Berkeley-AI-Risk/inference-only/formal/current-seeded-sampling/README.md

# Current scoped formal replay

This capsule is configured for the selected current image and retained source
scopes. Fresh scientific replay and its separate named completion registration
have completed with the scoped outcomes below.
`CURRENT-BINDING.json` records the source and image association at construction;
its replay and qualification flags remain false as construction provenance.

This lane preserves the original 35/57/63/94 component assertions, 196 connected
assertions with the same 37 private-output cuts, 15 Lean theorems, sensitivity
controls, model hashes, parameters, query constructors and runtime bounds.
Counts overlap. Verifying the 87 distributed files and selected image bytes
establishes provenance; it does not prove all 87 files, the mapped image or the
numerical backend. Production SHA compression arithmetic and private-bank/SHA
composition remain unproved.

## Closed current scientific results

The new primary run closed all 196 connected assertions. Its independent
secondary run passed the base and attempted all 196 conclusions, proving 194;
only CRC conclusions 38 and 73 remain unresolved. Both component solvers closed the 35/57/63/94 scopes.
The separate current page-bank run closed 42 assertions with both solvers,
real 32,768-bit RAM and arbitrary 258-bit SHA replies, plus ten directed
scenarios and five faulty controls. Fifteen abstract Lean theorems and the
original finite sensitivity controls also passed. These overlapping counts
are not a whole-machine total. No SHA compression arithmetic or private-bank
composition theorem follows.

The registered [CURRENT-REPLAY.json](CURRENT-REPLAY.json) has SHA-256
`c89177b13518209f0c8fb3ccde7db8c1d31dd39b875e1ba084650ed666806fcd`.
The completion and its status entry are separate from `CURRENT-BINDING.json`;
registration preserves that construction record and the source provider. It
records checked raw outcomes without rerunning solvers. The command examples
below reproduce the same-scope campaign, not a stronger theorem.

`recorded/RESULTS.json` and `recorded/PUBLIC-REPLAY.json` retain exact old0e6
bytes as historical model expectations. They are never current PASS records.
`historical/seeded-sampling/` preserves the exact original 31-file capsule source
census; runnable full historical context remains in the authenticated release
archive. The current replay does not require the old0e6 FS bytes.

Freeze the configured recipient's README, formal source inventory and package
manifest before the runs. Use a separate disposable copy of that exact clean
recipient, with new run directories. From its root:

    python3.12 -I -S -B formal/current-seeded-sampling/check_recorded.py
    python3.12 -I -S -B formal/current-seeded-sampling/test_replay.py
    python3.12 -I -S -B formal/current-seeded-sampling/replay.py --run formal/current-seeded-sampling/runs/NEW-combined --secondary --require-recorded-model
    python3.12 -I -S -B tools/check_current_seeded_page_bank.py --package . --work ../NEW-current-seeded-page-bank

The single combined replay includes the primary checks, both component solvers,
source/observer re-elaboration, Lean, negative controls and all 196 connected
secondary attempts with their existing bounded supplements. Do not add a separate
primary replay to this combined run. Original per-query timeouts, induction
depths and worker counts remain unchanged; there is no new overall campaign
wall timeout. `check_replay.py` independently validates the actual raw run.
Completion requires the secondary base check and all 196 attempts; only the
existing CRC conclusions 38 and 73 may remain unresolved. Unknowns remain
unresolved and are never counted as proofs.

The separate current-seeded page-bank wrapper runs its 42-property proof,
scenarios and audit; do not duplicate its child commands. It proves bank safety
with arbitrary 258-bit SHA replies. Production SHA is not elaborated in that
proof, and SHA arithmetic or private-bank/SHA composition is not established.
The original greedy page-bank replay remains unchanged. Keep the original clean
recipient and work-copy manifest unchanged through both runs and registration;
the page-bank evidence binds that exact input manifest.

The independently checked fresh outcomes are now registered in the clean
recipient: `CURRENT-REPLAY.json` records the same-scope results,
`CURRENT-STATUS.json` identifies that completion, and the package manifest's
separate `current_control_formal_replay` entry refers to it. These records do
not relabel historical PASS receipts or change the construction binding's false
flags. This command checks the registered completion without a solver replay:

    python3.12 -I -S -B formal/current-seeded-sampling/check_recorded.py --require-complete

These scoped replays do not establish whole-machine refinement, mapped-image
equivalence or hardware/browser qualification.
