Berkeley-AI-Risk/inference-only/demos/simplestories-v2-5m/formal/README.md

# SimpleStories RTL verification

The [formal-status guide](../FORMAL-STATUS.md) states the properties established
for the selected designs and their implementation boundaries.

The verification directories contain source-bound proof bundles and their
recorded queries, results and supporting sources. These recorded bundles retain
their original bytes, including path text in their source READMEs and receipts.
They do not supply additional runnable hardware designs.

Run the model-specific commands from `demos/simplestories-v2-5m/` in the
repository. For example, the registered seeded proof completion is checked with:

```sh
python3.12 -I -S -B formal/current-seeded-sampling/check_recorded.py --require-complete
```

The whole-repository integrity and common benchmark checks remain at the
repository root. New solver runs and hardware qualification are distinct from
replaying these recorded results.

The current [implementation-assurance checks](implementation-assurance/README.md) cover the boot/runtime handoff, fixed-length boot controller, QSPI reader, real FIFOs and transport, and the greedy public controllers. Their source-bound component results and remaining composition limits are stated together.

The [authentication/access package](authentication-access/README.md) verifies the
actual SHA engines, model checked-copy consumption, fixed private schedule and
operand/address paths, and separate protected K/V guard/cache and attention
capture/pin properties. The legitimate-record-to-consumption join remains open.
Recorded checks and fresh selected-query replay are separate commands.

The [protected-K/V CLEAR epoch package](kv-clear-epoch/README.md) proves the
native 64-bit epoch/reference relation and CLEAR sampling by unbounded induction,
including exhausted-counter fault behavior. Recorded validation and fresh
native/solver replay are separate modes. This closes one scalar dependency;
full tag/RAM/cache preservation and the joined attention consumer remain open.

The [working-memory/session package](session-isolation/README.md) adds native RAM
histories, current-writer ownership and connected model/K/V cancellation
barriers. It states the remaining device entry, numerical and token-publication
composition obligations; it does not claim complete device session isolation.

The [native component-value package](native-component-values/README.md) verifies
baseline RMSNorm invocation confinement and the production cache's component
value contract. The [composed model-read package](upstream-model-values/README.md)
discharges that cache contract's raw-reply premise through the actual custom
DDR transport, runtime wrappers, shared routing and model CDC. It includes a
readable theorem, explicit external boundaries and complete source/solver and
operating reproduction. The whole-device theorem remains open.

The [Q operand-provenance package](q-operand-provenance/README.md) connects the
baseline model words and current accepted activations to all 64 actual Q MAC
input pins, and current row metadata through tile storage to postscale
coefficient pins. Its [main SMT-LIB statement](q-operand-provenance/THEOREM.smt2)
and [readable theorem](q-operand-provenance/THEOREM.md) identify the precise scope.
The [complete Q operator package](q-operator/README.md) adds exact numerical Q
projection/normalization and actual Q write, exponent and completion behavior,
with checked common-trace composition. Its [readable theorem](q-operator/THEOREM.md)
states the interruption and implementation boundaries. Remaining consumers and
the whole-device theorem remain open.

The [baseline RMSNorm-to-Q segment](rms-q-segment/README.md) adds independent RMS
arithmetic, actual RMS workspace/Q capture, and retained query-RAM/readback
certificates to the complete Q result. Its [theorem and diagram](rms-q-segment/THEOREM.md)
state the stage-entry input boundary, constructive admission histories and
remaining whole-graph/implementation limits. The qualified source-bound package
has 554 new selected checks and clean portable reproduction.

The [recorded output-head row-12 replay](output-head-row12-recorded/README.md)
establishes that the 256 input words saved for output-head row 12 and the exponent
used by that row come from the same final normalization on the same STEP.
It assumes the machine follows the saved controller and connected hardware
design, with the same clocks, resets and fixed settings; the package states all
six assumptions. The exact frozen native profile is
`c07076ec5f5f4f27ca8208e502a0274b047552e5c356dc9bddaf03cd5b648b54`.
After provisioning its two pinned archives at `/proof` on Linux with CPython
3.12.12, run:

```sh
python3.12 -I -S -B /proof/replay.py
```

It checks 16 recorded native results and reconstructs 513 deductions. This is
recorded-result replay on that profile, not a proof of the public board image.

The [baseline selector WINNER proof](selector-winner/README.md) starts at an
actual accepted selector START and proves that a healthy WINNER is the least-ID
maximum of its 4,019 admitted rows, with exact row membership and output hold.
Row 0 seeds the incumbent, followed by 4,018 comparisons. Its one repository-root
command freshly recompiles the native theorem and a reached wrong-tie control.
The model-logit producer and parent STEP/start/WINNER/reply join remain open in
this replay.
