Berkeley-AI-Risk/inference-only/demos/simplestories-v2-5m/formal/seeded-sampling/README.md

# Seeded-sampling verification

Use the [RTL replay guide](../current-seeded-sampling/README.md) and the
[formal-status guide](../../FORMAL-STATUS.md) for the
supported source scopes, recorded results and limitations.
