Berkeley-AI-Risk/inference-only/ARCHITECTURE.md

# SimpleStories hardware

Read the [current simplestories hardware guide](demos/simplestories-v2-5m/HARDWARE.md).
