Berkeley-AI-Risk/inference-only/demos/simplestories-v2-5m/variants/home-authorization/HARDWARE.md

# Hardware and authorization boundary

The exact physical source is in [hardware/project](hardware/project), top `board1_home_auth_product_top`. The shared boot-root SHA engine handles model admission, LMS verification and nonce conditioning under private controller ownership. Update admission uses the existing 2-of-3 demonstration authority policy. Home permission uses a separate fixed public key. Neither threshold nor periodic authorization is part of the S-AWIC definition.

A request contains a domain tag, fixed device ID, fresh 256-bit nonce, admitted model commitment and fixed architecture geometry (128 bytes total). Home base returns that request plus a 1,292-byte LMS signature. The chip verifies the signature and exact device/nonce/model/geometry bindings before granting temporary permission. The host relays the messages and supplies no trusted permission or nonce signal.

The hardware period is 250,000,000 core cycles (nominally 10 seconds), with renewal 125,000,000 cycles before expiry and a 100,000,000-cycle response deadline. The deadline is anchored to challenge issue, rather than reply arrival. Valid renewal preserves the token context. Expiry or a fatal transport/signature/model fault closes runtime access, resets token inference and suppresses pending publication; a new session is required. A denied renewal can stop the session before the lease deadline.

Weight memory and model-authentication logic are distinct. Authentication admits the signed model and validates the weights. Current home permission enables inference and runtime memory access. Storing/admitting a package alone does not authorize running it. Replacement weights use the same [signed-update flash layout](../signed-update/tang/HARDWARE.md); the inference UART cannot rewrite them.

The inference clock is 25 MHz; board, DDR, application and trusted-reset logic use separate clock domains. The physical nonce candidate uses three neoTRNG inverter/latch rings, a 512-byte sample buffer, simple repeat/bias screens and SHA256 conditioning. Host bytes do not seed it. These checks do not establish a cryptographic entropy bound, robust freshness under physical attack, a trusted wall clock or a clone-resistant device identity.

## Nonce freshness

The [gate](hardware/project/home/home_boot_gate.sv) rejects a zero nonce and an immediate repeat within one hard-reset epoch. It remembers only the preceding nonce: a different nonce replaces that value, and the common core reset clears both `seen_nonce_q` and `previous_nonce_q`.

Forcing the same accepted 512-byte entropy sample through the [conditioner](hardware/project/home/nonce_frontend.sv) produces the same nonce. With the same device, admitted model and geometry, the complete request then repeats. An old valid signature can be accepted for that identical request after reset, or after a different nonce intervenes. The [digital unit comparison](VALIDATION.md#forced-sample-repetition) checks these cases with real LMS/SHA verification and a corrupted-signature control. It does not demonstrate physical sample repetition or a board bypass.

The repeat check and sample health screens do not supply persistent freshness state. Fresh unpredictable nonces remain an assumption needed for remote revocation; physical entropy qualification is outstanding.

## Timing qualification

The routed design reports a maximum of 25.002 MHz for the 25 MHz inference clock. Its whole-design summary reports 121 setup and 55 hold violating endpoints. The reset review traces one hold path through the entropy control logic and explains the remaining clock and DDR timing questions. Metastability MTBF, entropy qualification and physical tamper resistance remain open. [Startup reset and timing review](RESET-REVIEW.md)
