Berkeley-AI-Risk/inference-only/CURRENT-QUALIFICATION.md

# Seeded-sampling qualification

Read the [current seeded-sampling qualification guide](demos/simplestories-v2-5m/CURRENT-QUALIFICATION.md).
