Berkeley-AI-Risk/inference-only/ENCRYPTED-MEMORY.md

# K/V protection and encrypted external memory

`encrypted-memory` runs the same fixed SimpleStories-V2-5M approximation,
greedy decoding and three commands as the baseline and K/V-protected configurations.
It adds encryption for weights in external flash/DDR and for the external
attention cache (K/V). It retains before-use integrity checks and the model's
2,048-input-position limit. The inference clock is still 25 MHz.

The plaintext-memory versions check that the circuit uses allowed weights, but do
not hide external-memory contents. This version explores keeping weights
and intermediate cache contents confidential in external memory; a production
implementation would also need protected secret-key provisioning. The fixed-model
restriction still comes from the controller and immutable integrity checks,
not encryption. Published demonstration keys make this experiment reproducible
and recoverable without irreversible key programming.

**The supplied keys are public demonstration values, also embedded in the
RTL and FPGA configuration. This package does not keep its model or K/V
secret from someone who has those keys.** It demonstrates the implemented
encrypted-memory data path; it is not a production secret-provisioning scheme
or evidence of resistance to invasive attacks or side-channel analysis.
No irreversible key, OTP, fuse or security-lock programming is required.

## What changes, and what does not

| Configuration | External weights | External K/V | Before-use K/V integrity |
| --- | --- | --- | --- |
| Baseline | Plaintext; fixed-model digest check | Plaintext | No content check |
| K/V-protected | Plaintext; fixed-model digest check | Plaintext | Private expected SHA-256 digests |
| Encrypted-memory | AES-256-CTR ciphertext; fixed plaintext digests remain | AES-SIV ciphertext and tags | SIV check **and** private expected SHA-256 digests |

The plaintext model asset is unchanged. This third image
requires a **different flash image**; switching to it is not an SRAM-only
configuration change. The tokenizer and underlying integer model are unchanged.

The encrypted-memory circuit privately decrypts and verifies weights and cache data before the fixed model can use them. External memory carries ciphertext, while the host still sees only three token commands.

*The FPGA boundary is a circuit-ownership boundary, not a claim of physical
invulnerability. The two DDR regions share one physical memory. Keys in this
demonstration are public.*

### Weights

At startup, the circuit copies the fixed ciphertext image from flash into
DDR and verifies its full-image digest before allowing inference. During
inference, a four-bank private cache decrypts requested weight pages with
AES-256-CTR. SHA-256 checks the **same on-chip plaintext copy** against an
independent immutable digest; the arithmetic cannot use it until the full
page check succeeds. Decryption and hashing overlap, without another
whole-page buffer or an early permission to use unverified data.
AES and CTR follow [FIPS 197](https://csrc.nist.gov/pubs/fips/197/final)
and [SP 800-38A](https://csrc.nist.gov/pubs/sp/800/38/a/final).
The [design references](docs/REFERENCES.md#arithmetic-implementations-and-cryptographic-specifications)
also credit the directly adapted AES S-box circuit.

The private AES circuit retains all 14 AES-256 rounds and processes them in
five round-processing clocks per block (3 + 3 + 3 + 3 + 2 rounds). This does
not include request/response overhead. The four banks share two AES engines
and two SHA-256 engines, with private arbitration and explicit ownership of
each result. These are not reduced-round encryption or host-accessible
cryptographic accelerators. All 64 SHA-256 rounds are retained.

Four projection multiplier lanes time-share groups of up to 64 fixed output
rows, with 16 rows per lane and a separate accumulator for each row. The
per-row arithmetic order is unchanged. Packed fixed-metadata ROMs and private
block-RAM queues help fit the cache and checking circuits on this FPGA. These
are internal scheduling and storage choices, not additional user operations.

The fixed model image is 7,265,984 bytes. Each plaintext page is 4,096 bytes;
the last page contains 3,776 image bytes and 320 zero-padding bytes for the
digest. Those padding bytes are not additional ciphertext bytes in flash.
Small fixed coefficient/scale metadata also remain in on-chip ROM. Thus
“encrypted weights” does not mean every model-related constant is hidden.

The ciphertext digest and plaintext page digests serve different purposes.
Even knowing the published demonstration key does not provide a supported
way to change the permitted model: changing plaintext changes the immutable
page digest. This assumes the checking circuit and its trusted state remain
intact. There is no public key-upload, model-update or cryptography command.

### Attention cache

Internally produced K/V data are sealed before external writes. A read is
decrypted into private storage, its complete SIV tag is checked, and the
existing plaintext SHA-256 guard checks it against the current privately
recorded expected contents before attention receives it. A genuine old
record can have a valid SIV tag: the separate expected-digest mechanism is
still needed to reject stale contents, including after a repeated epoch.

The fixed record format uses AES-SIV as specified in
[RFC 5297](https://www.rfc-editor.org/rfc/rfc5297). It has separate 256-bit MAC
and counter-mode keys. Each K or V role has 130 plaintext bytes: 128 coordinate
bytes plus the two shared exponent bytes. Its external record is 160 bytes:
130 ciphertext bytes, a 16-byte tag, then 14 zero-padding bytes. Three
associated-data fields bind the domain, model identity and private
`epoch/layer/head/role/position/length` descriptor. This is a fixed inference
format, not a host-accessible encryption service. Two roles occupy ten
256-bit words per head, so the encrypted K/V region is larger than the
plaintext nine-word layout.

The SHA-256 guard groups 16 positions for verification. Its final group may
read the newest stored row even when attention obtains that row from the
private pending-row buffer. That read is expected; it does not bypass the
buffer or permit an unverified attention operand.

The guard pipelines its private RAM reads while assembling words for hashing
or returning already verified data. It reads the eight 32-bit chunks of a
256-bit word in nine clocks. This overlap does not release unverified data or
remove any digest check.

## Evidence and limits

The selected image measured **6.04 tokens/s** on the common one-token prompt
and two 128-output greedy trials, with all 256 IDs matching the fixed numerical
reference. The pooled 254-output rate uses validated-reply timestamps and
includes host control and inter-command gaps. Prompt processing and the first
output have separate recorded timings. See the
[common benchmark](docs/benchmarks/FPGA-SPEED-BENCHMARK.md).

The selected source/model/native/mapped records, ten-case CLI campaign and
seven-case browser campaign are described in
[greedy qualification](demos/simplestories-v2-5m/GREEDY-QUALIFICATION.md).
The campaigns include full-context operation, boundary rejection, CLEAR races,
Stop while a long STEP is pending and resumed generation. Full-array ciphertext
readback and plaintext restoration have separate guarded records.

The current image has 100 build inputs, including four separately acquired
vendor inputs. It completed native placement/routing, but its BUILD.json
retains `timing_qualified: false`. Functional qualification does not establish
complete vendor-DDR or external-I/O timing signoff.

Its attention source bridge rechecks 34 assertions through six byte-identical
isolated sources. It adds no assertions and does not prove the encrypted guard,
AES-SIV, numerical attention, concrete private-memory composition or the whole
machine. The AES component records apply only to the two byte-identical primitive
sources and retain their separate scope. [Formal status](demos/simplestories-v2-5m/FORMAL-STATUS.md) distinguishes
these results from universal arithmetic or cryptographic theorems.
The [capacity assessment](demos/simplestories-v2-5m/TRAINING-CAPACITY.md)
is explicitly bound to the plaintext baseline; encryption does not establish
a smaller residual training factor.

For a deployed confidential design, keys and configuration would need a
protected provisioning/storage path, with debug/configuration access and
physical/side-channel threats assessed separately. Authentication also
depends on intact private state. No such resistance is certified here.

## Reproduce and inspect the package

This variant ships its exact 96 redistributable inputs, the four pinned
vendor dependency identities, and the selected prebuilt image. No vendor
primitive simulation-library sources are bundled. The existing vendor
download/build instructions and license boundaries still apply.

From the root of a clean checkout or release archive:

The first command uses `--strict` to check all listed files and reject any
extras, including local Python environments and generated build files.
If you have already used this checkout, omit `--strict` to verify the listed
files while allowing those extras; do not delete your local files just to
run the check. See [release checks](demos/simplestories-v2-5m/REPRODUCE.md).

```sh
python3.12 -I -S -B tools/verify_release.py --strict
python3.12 -I -B tools/check_current_three_greedy_v15_v4.py --package . --stage current --index evidence/current-greedy/INDEX.json
python3.12 -I -S -B tools/check_encrypted_inherited_components_v1.py
python3.12 -I -S -B tools/encrypt_model_image.py --openssl /absolute/path/to/openssl
```

The final command independently reproduces every ciphertext byte with
OpenSSL and decrypts it back to the exact supplied plaintext model. It is
offline, uses only public test constants, and never accesses a board. Add
`--output /fresh/path/model.bin` to save the reproduced ciphertext; existing
files are refused. The unchanged [model reconstruction](demos/simplestories-v2-5m/REPRODUCE.md)
produces the plaintext starting point.

Source locations:

- `variants/encrypted-memory/hardware/`: exact build inputs, including the
  original project, ROM data and constraints.
- `host-app/hardware-inputs-encrypted-memory.json`: all 100 input hashes.
- `variants/encrypted-memory/PUBLIC-TEST-KEYS.json`: published demonstration keys and nonce.
- `prebuilt/encrypted-memory/BUILD.json`: source/image build association,
  with `timing_qualified: false`.
- `prebuilt/encrypted-memory/project/impl/pnr/shared_product.fs`: selected SRAM configuration.
- `assets/board1-encrypted-model2048.bin`: exact ciphertext flash payload.

For a local rebuild, follow [the existing vendor setup](VENDOR-SETUP.md#check-then-build)
with `--variant encrypted-memory`. The same pinned macOS GOWIN executable and
four separately obtained IP files are required. Preflight checks the exact
100 inputs; it does not run the vendor tool or access hardware. A fresh build
must be assessed on its own results, not assumed to reproduce the selected
placement or to improve the remaining timing violations.

## Install or restore

Use only the exact supported board, flash and programmer versions in
[PROGRAMMING.md](PROGRAMMING.md). Read that entire guide first, including
restoration. **These instructions erase flash.** Preserve two separately
read, equal, complete 16-MiB backups and their receipts before writing; keep
them outside the repository. Stop the app and other UART/JTAG users.
Do not proceed on any ID mismatch, tool error or protection warning.

Follow sections 1 and 2 of that guide unchanged. With its checked shell
variables, replace section 3's plaintext installation with:

```sh
"$FPGA_PROGRAMMER" --device GW5AST-138C --cable-index 4 --location "$FPGA_USB_LOCATION" --frequency 0.9MHz --operation_index 52
"$FPGA_PROGRAMMER" --device GW5AST-138C --cable-index 4 --location "$FPGA_USB_LOCATION" --frequency 0.9MHz --operation_index 56 --mcuFile "$FPGA_PACKAGE/assets/board1-encrypted-model2048.bin" --spiaddr 0x801000
```

The example cable index must be replaced if your checked scan reports a
different one. Require the exact success/target/operation checks in the
original guide, one command at a time. Then reload its read-only maintenance
image and capture a **fresh full-array read** as in section 4. Use a new
output filename and this ciphertext-specific file checker:

```sh
python3.12 -I -S -B tools/check_encrypted_flash.py --readback "$FPGA_RECOVERY/encrypted-readback.bin"
```

Require full-array hash
`779fc1a8a0158ce66e7dc52ac4662259f5618f01303d3299eb990b2f361d2ef1`.
Only `[0x801000, 0xEEEEC0)` contains the ciphertext image; all other bytes
must be `FF`. A programmer's own verification alone does not replace this
independent read. The checker verifies a file, not its physical provenance.

After a successful readback, use section 5's SRAM operation with
`--fsFile "$FPGA_PACKAGE/prebuilt/encrypted-memory/project/impl/pnr/shared_product.fs"`.
Keep power on, allow at least 120 seconds for boot, and run the host guide's
known-answer qualification with `prebuilt/encrypted-memory/BUILD.json`.
Use its explicit exploratory-timing acknowledgement. Requalify after every
power cycle/reload. The browser does not install, select or switch hardware.

The browser supports 2,048 prompt tokens, 128 generated tokens and 2,049
combined tokens, within 32,768 input characters. A full-context first STEP can
take many minutes. Stop drains an already active STEP before clearing the tape;
it cannot interrupt that hardware command. A timeout does not prove a command
was not accepted: investigate rather than repeating it blindly. See the
[host guide](host-app/README.md) for command deadlines and connection ownership.

To return to a plaintext-memory configuration, **restore the matching plaintext
flash image as well as its SRAM image**. Section 6 restores your own verified
full backup and independently compares every byte. If that backup predates
model installation, it restores the factory contents instead: use the
original model-install/readback workflow before loading its matching
inference image. Never use another person's flash backup. Keep all recovery
files private; do not use OTP, fuse, key-lock or unrelated flash-mode options.
