Berkeley-AI-Risk/inference-only/FORMAL-STATUS.md

# Scoped RTL verification

Read the [current scoped rtl verification guide](demos/simplestories-v2-5m/FORMAL-STATUS.md).
