Berkeley-AI-Risk/inference-only/KV-PROTECTION.md

# K/V integrity protection

Read the [current k/v integrity protection guide](demos/simplestories-v2-5m/KV-PROTECTION.md).
