Berkeley-AI-Risk/inference-only/REPRODUCE.md

# Reproduce SimpleStories assets and evidence

Read the [current reproduce simplestories assets and evidence guide](demos/simplestories-v2-5m/REPRODUCE.md).
