Berkeley-AI-Risk/inference-only/STOCHASTIC-GENERATION.md

# Seeded SimpleStories generation

Read the [current seeded simplestories generation guide](demos/simplestories-v2-5m/STOCHASTIC-GENERATION.md).
