Berkeley-AI-Risk/inference-only/variants/seeded-sampling/QUALIFICATION.md

# Seeded-sampling qualification

The supplied image is `d271626a7fb9ce1debdf7a9cd847125ec7eb4c907fa9d06af9d5f8146cecc725`.
[Current qualification](../../demos/simplestories-v2-5m/CURRENT-QUALIFICATION.md) identifies its model, seven-suite board campaign, context matrix, readback/registration and browser results.

[Formal status](../../demos/simplestories-v2-5m/FORMAL-STATUS.md) describes the scoped RTL results and unresolved secondary conclusions. [Seeded generation](../../demos/simplestories-v2-5m/STOCHASTIC-GENERATION.md) gives settings, loading and web-interface instructions. These records do not establish complete timing, whole-machine numerical refinement or physical-security certification.
