Berkeley-AI-Risk/inference-only/demos/simplestories-v2-5m/demos/simplestories-v2-5m/FORMAL-STATUS.md

# SimpleStories formal status

See the [formal-status guide](../../FORMAL-STATUS.md) for the current scope and results.
