Berkeley-AI-Risk/inference-only/demos/simplestories-v2-5m/formal/q-operator/F1-COMMON-TRACE-REVIEW.md

# Independent common-trace review

Reviewed 2026-11-05 by `fresh_q_main_audit`, a reviewer originally started
without conversation history. This follow-up was read-only: no edits, engines
or compilers were run by the reviewer.

The reviewer finds F1 addressed within the stated source/frontend boundary and
finds no concrete remaining soundness gap in this scoped construction.

The reviewed checker connects common-reset bases, the first-step empty-capture
bootstrap, the regular joint induction with a retained predecessor, raw
value/order/DONE, normalized writes/exponent/completion/CLEAR, and the first
fault/numeric-rejection consequences. Every endpoint premise is closed. The
seven strong old trace interfaces and all four model/memory boundaries remain.

The source lift requires full actual parent transitions, exact source bodies,
ports, parameters and getter sorts; no local native conclusion is strengthened
into a parent transition. Declared-constant substitutions refuse binders, and
one rigid watched-row/lane family is retained along the trace. The reviewer
found no unjustified numerical addition, ordinary-step invariant cycle, extra
reset, or use of pre-reset arithmetic invariants in the bootstrap.

The final saved review inspected `TRACE-CLOSURE.json`: its reset, bootstrap,
regular and endpoint applications have no unclosed premises; all six logical
controls reject. The original native-theory typecheck is correctly marked
`no_check_sat` and is not counted as an engine proof. The concrete stronger
nonzero compatibility query has a SAT receipt and makes no reachability claim.

This review addresses the common-trace argument. Full operator qualification,
portable reproduction and publication remain separate decisions.
