Berkeley-AI-Risk/inference-only/demos/simplestories-v2-5m/formal/q-operator/FINAL-PACKAGING-REVIEW.md

# Independent release review

A separate agent, originally given no conversation history, performed a read-only
review of the source-bound Q argument and its portable release. No engines,
compilers or edits were run by this reviewer.

The final review found no remaining soundness or packaging blocker. It checked
candidate r4's archive/evidence links, all 329 new and 449 operand canonical and
actual engine-query hashes and raw replies, all 17 fresh receipts, seven identical
native recompilations, and saved original-theory type evidence. The recorded-only
replay also passed, with zero fresh solver queries and complete trace closure.

The public replay must distinguish 326 UNSAT implications and three SAT controls
from the 17 selected fresh engine runs and the reconstructed existing dependency
receipts. Portable default execution validates saved simulation records; it does
not rerun simulations. Thirteen connected finite cases regenerate source, bench
and independent mathematical expected data during local qualification. The two
normalizer aggregate records validate native source, bench/log hashes and their
case/edge scope. The normalizer also has its separate symbolic proof.

The theorem's exclusions—whole device, timing/fault authorization, retained query
RAM and physical DSP/bitstream equivalence—remain explicit. The reviewer accepted
the common-reset, bootstrap, regular induction and all raw, normalized and
rejection endpoint applications. The detailed common-trace review is in
F1-COMMON-TRACE-REVIEW.md.
