Berkeley-AI-Risk/inference-only/demos/qwen3-1.7b/hardware/implementation/parallel-reset-chains.tsv

stem | stages | constant_one_reset_shift_structure | reasons | clock | clear_net
fixed_hbm_reset/axi_release | 3 | 1 |  | clk_out1_clk_mmcm_hbm | fixed_hbm_reset/axi_release[2]_i_1_n_0
fixed_hbm_reset/axi_reset_state_sync | 3 | 0 | stage0_not_FDCE,stage1_not_FDCE,stage2_not_FDCE
fixed_hbm_reset/axi_settle_sync | 3 | 0 | first_D_not_constant_one | clk_main_a0 | fixed_hbm_reset/axi_release[2]_i_1_n_0
fixed_hbm_reset/configuration_release | 3 | 1 |  | clk_main_a0 | fixed_hbm_reset/configuration_release[2]_i_1_n_0
fixed_hbm_reset/flr_memory_start | 3 | 1 |  | clk_out1_clk_mmcm_hbm | fixed_hbm_reset/flr_memory_start[2]_i_1_n_0
fixed_hbm_reset/flr_memory_sync | 3 | 0 | first_D_not_constant_one | clk_main_a0 | fixed_hbm_reset/flr_reset_done_i_2_n_0
fixed_hbm_reset/flr_reference_start | 3 | 1 |  | clk_hbm_ref | fixed_hbm_reset/flr_memory_start[2]_i_1_n_0
fixed_hbm_reset/flr_reference_sync | 3 | 0 | first_D_not_constant_one | clk_main_a0 | fixed_hbm_reset/flr_reset_done_i_2_n_0
fixed_hbm_reset/memory_done_sync | 3 | 0 | first_D_not_constant_one | clk_main_a0 | fixed_hbm_reset/controller_released_i_2_n_0
fixed_hbm_reset/memory_start | 3 | 1 |  | clk_out1_clk_mmcm_hbm | fixed_hbm_reset/reference_start[2]_i_1_n_0
fixed_hbm_reset/reference_done_sync | 3 | 0 | first_D_not_constant_one | clk_main_a0 | fixed_hbm_reset/controller_released_i_2_n_0
fixed_hbm_reset/reference_start | 3 | 1 |  | clk_hbm_ref | fixed_hbm_reset/reference_start[2]_i_1_n_0
fixed_machine/lifecycle/core_ack_sync | 3 | 0 | first_D_not_constant_one | clk_main_a0 | fixed_machine/lifecycle/flr_done_i_2_n_0
fixed_machine/lifecycle/core_reset_edges | 8 | 1 |  | clk_out1_clk_mmcm_a | fixed_machine/lifecycle/flr_shell_release[2]_i_1_n_0
fixed_machine/lifecycle/core_reset_sync | 3 | 0 | first_D_not_constant_one | clk_main_a0 | fixed_machine/lifecycle/failed_i_2_n_0
fixed_machine/lifecycle/flr_shell_release | 3 | 1 |  | clk_main_a0 | fixed_machine/lifecycle/flr_shell_release[2]_i_1_n_0
fixed_machine/lifecycle/hbm_memory_release | 3 | 1 |  | clk_out1_clk_mmcm_hbm | fixed_machine/lifecycle/hbm_memory_release[2]_i_1_n_0
fixed_machine/lifecycle/host_release | 3 | 1 |  | clk_main_a0 | fixed_machine/lifecycle/host_release[2]_i_1_n_0
fixed_machine/lifecycle/memory_ack_sync | 3 | 0 | first_D_not_constant_one | clk_main_a0 | fixed_machine/lifecycle/flr_done_i_2_n_0
fixed_machine/lifecycle/memory_release_sync | 3 | 0 | first_D_not_constant_one | clk_main_a0 | fixed_machine/lifecycle/failed_i_2_n_0
fixed_machine/lifecycle/memory_reset_edges | 8 | 1 |  | clk_out1_clk_mmcm_hbm | fixed_machine/lifecycle/flr_shell_release[2]_i_1_n_0
fixed_machine/lifecycle/memory_reset_sync | 3 | 0 | first_D_not_constant_one | clk_main_a0 | fixed_machine/lifecycle/failed_i_2_n_0
fixed_machine/lifecycle/monitor0_sync | 3 | 0 | first_D_not_constant_one | clk_main_a0 | fixed_machine/lifecycle/failed_i_2_n_0
fixed_machine/lifecycle/monitor1_sync | 3 | 0 | first_D_not_constant_one | clk_main_a0 | fixed_machine/lifecycle/failed_i_2_n_0
fixed_machine/lifecycle/reference_reset_sync | 3 | 0 | first_D_not_constant_one | clk_main_a0 | fixed_machine/lifecycle/failed_i_2_n_0
fixed_machine/machine/application/host_control/error_sync | 3 | 0 | first_D_not_constant_one | clk_main_a0 | fixed_machine/machine/application/host_control/ready_sync[2]_i_1_n_0
fixed_machine/machine/application/host_control/loading_sync | 3 | 0 | first_D_not_constant_one | clk_main_a0 | fixed_machine/machine/application/host_control/ready_sync[2]_i_1_n_0
fixed_machine/machine/application/host_control/ready_sync | 3 | 0 | first_D_not_constant_one | clk_main_a0 | fixed_machine/machine/application/host_control/ready_sync[2]_i_1_n_0
fixed_machine/machine/application/host_control/shell_reset_release | 3 | 1 |  | clk_main_a0 | fixed_machine/machine/application/host_control/shell_reset_release[2]_i_1_n_0
fixed_machine/machine/application/host_control/status_core_reset_release | 3 | 1 |  | clk_out1_clk_mmcm_a | fixed_machine/machine/application/host_control/shell_reset_release[2]_i_1_n_0
fixed_machine/machine/application/host_control/crossing/core_reset_release | 3 | 1 |  | clk_out1_clk_mmcm_a | fixed_machine/machine/application/host_control/crossing/core_reset_release[2]_i_1_n_0
fixed_machine/machine/application/host_control/crossing/commands/destination_reset_release | 3 | 1 |  | clk_out1_clk_mmcm_a | fixed_machine/machine/application/host_control/crossing/commands/source_reset_release[2]_i_1_n_0
fixed_machine/machine/application/host_control/crossing/commands/read_gray_source_1 | 3 | 0 | first_D_not_constant_one,stage0_early_fanout,stage1_early_fanout,stage1_not_direct_shift,stage2_not_direct_shift | clk_main_a0 | fixed_machine/machine/application/host_control/crossing/commands/write_gray[2]_i_2_n_0
fixed_machine/machine/application/host_control/crossing/commands/read_gray_source_2 | 3 | 0 | first_D_not_constant_one,stage0_early_fanout,stage1_early_fanout,stage1_not_direct_shift,stage2_not_direct_shift | clk_main_a0 | fixed_machine/machine/application/host_control/crossing/commands/write_gray[2]_i_2_n_0
fixed_machine/machine/application/host_control/crossing/commands/read_gray_source_3 | 3 | 0 | first_D_not_constant_one,stage0_early_fanout,stage1_early_fanout,stage1_not_direct_shift,stage2_not_direct_shift | clk_main_a0 | fixed_machine/machine/application/host_control/crossing/commands/write_gray[2]_i_2_n_0
fixed_machine/machine/application/host_control/crossing/commands/source_reset_release | 3 | 1 |  | clk_main_a0 | fixed_machine/machine/application/host_control/crossing/commands/source_reset_release[2]_i_1_n_0
fixed_machine/machine/application/host_control/crossing/commands/write_gray_destination_1 | 3 | 0 | first_D_not_constant_one,stage0_early_fanout,stage1_early_fanout,stage1_not_direct_shift,stage2_not_direct_shift | clk_out1_clk_mmcm_a | fixed_machine/machine/application/host_control/crossing/commands/write_gray_destination_1[2]_i_1_n_0
fixed_machine/machine/application/host_control/crossing/commands/write_gray_destination_2 | 3 | 0 | first_D_not_constant_one,stage0_early_fanout,stage1_early_fanout,stage1_not_direct_shift,stage2_not_direct_shift | clk_out1_clk_mmcm_a | fixed_machine/machine/application/host_control/crossing/commands/write_gray_destination_1[2]_i_1_n_0
fixed_machine/machine/application/host_control/crossing/commands/write_gray_destination_3 | 3 | 0 | first_D_not_constant_one,stage0_early_fanout,stage1_early_fanout,stage1_not_direct_shift,stage2_not_direct_shift | clk_out1_clk_mmcm_a | fixed_machine/machine/application/host_control/crossing/commands/write_gray_destination_1[2]_i_1_n_0
fixed_machine/machine/application/host_control/crossing/results/destination_reset_release | 3 | 1 |  | clk_main_a0 | fixed_machine/machine/application/host_control/crossing/results/source_reset_release[2]_i_1_n_0
fixed_machine/machine/application/host_control/crossing/results/read_gray_source_1 | 3 | 0 | first_D_not_constant_one,stage0_early_fanout,stage1_early_fanout,stage1_not_direct_shift,stage2_not_direct_shift | clk_out1_clk_mmcm_a | fixed_machine/machine/application/host_control/crossing/results/write_gray[2]_i_2_n_0
fixed_machine/machine/application/host_control/crossing/results/read_gray_source_2 | 3 | 0 | first_D_not_constant_one,stage0_early_fanout,stage1_early_fanout,stage1_not_direct_shift,stage2_not_direct_shift | clk_out1_clk_mmcm_a | fixed_machine/machine/application/host_control/crossing/results/write_gray[2]_i_2_n_0
fixed_machine/machine/application/host_control/crossing/results/read_gray_source_3 | 3 | 0 | first_D_not_constant_one,stage0_early_fanout,stage1_early_fanout,stage1_not_direct_shift,stage2_not_direct_shift | clk_out1_clk_mmcm_a | fixed_machine/machine/application/host_control/crossing/results/write_gray[2]_i_2_n_0
fixed_machine/machine/application/host_control/crossing/results/source_reset_release | 3 | 1 |  | clk_out1_clk_mmcm_a | fixed_machine/machine/application/host_control/crossing/results/source_reset_release[2]_i_1_n_0
fixed_machine/machine/application/host_control/crossing/results/write_gray_destination_1 | 3 | 0 | first_D_not_constant_one,stage0_early_fanout,stage1_early_fanout,stage1_not_direct_shift,stage2_not_direct_shift | clk_main_a0 | fixed_machine/machine/application/host_control/crossing/results/write_gray_destination_1[2]_i_1_n_0
fixed_machine/machine/application/host_control/crossing/results/write_gray_destination_2 | 3 | 0 | first_D_not_constant_one,stage0_early_fanout,stage1_early_fanout,stage1_not_direct_shift,stage2_not_direct_shift | clk_main_a0 | fixed_machine/machine/application/host_control/crossing/results/write_gray_destination_1[2]_i_1_n_0
fixed_machine/machine/application/host_control/crossing/results/write_gray_destination_3 | 3 | 0 | first_D_not_constant_one,stage0_early_fanout,stage1_early_fanout,stage1_not_direct_shift,stage2_not_direct_shift | clk_main_a0 | fixed_machine/machine/application/host_control/crossing/results/write_gray_destination_1[2]_i_1_n_0
fixed_machine/machine/application/inference/core_reset_release | 3 | 1 |  | clk_out1_clk_mmcm_a | fixed_machine/machine/application/inference/core_reset_release[2]_i_1_n_0
fixed_machine/machine/application/inference/kv_transport/read_crossing/core_reset_release | 3 | 1 |  | clk_out1_clk_mmcm_a | fixed_machine/machine/application/inference/kv_transport/read_crossing/core_reset_release[2]_i_1_n_0
fixed_machine/machine/application/inference/kv_transport/read_crossing/memory_error_core | 3 | 0 | first_D_not_constant_one | clk_out1_clk_mmcm_a | fixed_machine/machine/application/inference/kv_transport/read_crossing/memory_error_core[2]_i_1_n_0
fixed_machine/machine/application/inference/kv_transport/read_crossing/memory_reset_release | 3 | 1 |  | clk_out1_clk_mmcm_hbm | fixed_machine/machine/application/inference/kv_transport/read_crossing/core_reset_release[2]_i_1_n_0
fixed_machine/machine/application/inference/kv_transport/read_crossing/forward_stream/destination_reset_release | 3 | 1 |  | clk_out1_clk_mmcm_hbm | fixed_machine/machine/application/inference/kv_transport/read_crossing/forward_stream/source_reset_release[2]_i_1_n_0
fixed_machine/machine/application/inference/kv_transport/read_crossing/forward_stream/read_gray_source_1 | 7 | 0 | first_D_not_constant_one,stage0_early_fanout,stage1_early_fanout,stage1_not_direct_shift,stage2_early_fanout,stage2_not_direct_shift,stage3_early_fanout,stage3_not_direct_shift,stage4_early_fanout,stage4_not_direct_shift,stage5_early_fanout,stage5_not_direct_shift,stage6_not_direct_shift | clk_out1_clk_mmcm_a | fixed_machine/machine/application/inference/kv_transport/read_crossing/forward_stream/write_gray[6]_i_2_n_0
fixed_machine/machine/application/inference/kv_transport/read_crossing/forward_stream/read_gray_source_2 | 7 | 0 | first_D_not_constant_one,stage0_early_fanout,stage1_early_fanout,stage1_not_direct_shift,stage2_early_fanout,stage2_not_direct_shift,stage3_early_fanout,stage3_not_direct_shift,stage4_early_fanout,stage4_not_direct_shift,stage5_early_fanout,stage5_not_direct_shift,stage6_not_direct_shift | clk_out1_clk_mmcm_a | fixed_machine/machine/application/inference/kv_transport/read_crossing/forward_stream/write_gray[6]_i_2_n_0
fixed_machine/machine/application/inference/kv_transport/read_crossing/forward_stream/read_gray_source_3 | 7 | 0 | first_D_not_constant_one,stage0_early_fanout,stage1_early_fanout,stage1_not_direct_shift,stage2_early_fanout,stage2_not_direct_shift,stage3_early_fanout,stage3_not_direct_shift,stage4_early_fanout,stage4_not_direct_shift,stage5_early_fanout,stage5_not_direct_shift,stage6_not_direct_shift | clk_out1_clk_mmcm_a | fixed_machine/machine/application/inference/kv_transport/read_crossing/forward_stream/write_gray[6]_i_2_n_0
fixed_machine/machine/application/inference/kv_transport/read_crossing/forward_stream/source_reset_release | 3 | 1 |  | clk_out1_clk_mmcm_a | fixed_machine/machine/application/inference/kv_transport/read_crossing/forward_stream/source_reset_release[2]_i_1_n_0
fixed_machine/machine/application/inference/kv_transport/read_crossing/forward_stream/write_gray_destination_1 | 7 | 0 | first_D_not_constant_one,stage0_early_fanout,stage1_early_fanout,stage1_not_direct_shift,stage2_early_fanout,stage2_not_direct_shift,stage3_early_fanout,stage3_not_direct_shift,stage4_early_fanout,stage4_not_direct_shift,stage5_early_fanout,stage5_not_direct_shift,stage6_not_direct_shift | clk_out1_clk_mmcm_hbm | fixed_machine/machine/application/inference/kv_transport/read_crossing/forward_stream/read_binary_rep[5]_i_2_n_0
fixed_machine/machine/application/inference/kv_transport/read_crossing/forward_stream/write_gray_destination_2 | 7 | 0 | first_D_not_constant_one,stage0_early_fanout,stage1_early_fanout,stage1_not_direct_shift,stage2_early_fanout,stage2_not_direct_shift,stage3_early_fanout,stage3_not_direct_shift,stage4_early_fanout,stage4_not_direct_shift,stage5_early_fanout,stage5_not_direct_shift,stage6_not_direct_shift | clk_out1_clk_mmcm_hbm | fixed_machine/machine/application/inference/kv_transport/read_crossing/forward_stream/read_binary_rep[5]_i_2_n_0
fixed_machine/machine/application/inference/kv_transport/read_crossing/forward_stream/write_gray_destination_3 | 7 | 0 | first_D_not_constant_one,stage0_early_fanout,stage1_early_fanout,stage1_not_direct_shift,stage2_early_fanout,stage2_not_direct_shift,stage3_early_fanout,stage3_not_direct_shift,stage4_early_fanout,stage4_not_direct_shift,stage5_early_fanout,stage5_not_direct_shift,stage6_not_direct_shift | clk_out1_clk_mmcm_hbm | fixed_machine/machine/application/inference/kv_transport/read_crossing/forward_stream/read_binary_rep[5]_i_2_n_0
fixed_machine/machine/application/inference/kv_transport/read_crossing/return_stream/destination_reset_release | 3 | 1 |  | clk_out1_clk_mmcm_a | fixed_machine/machine/application/inference/kv_transport/read_crossing/return_stream/source_reset_release[2]_i_1_n_0
fixed_machine/machine/application/inference/kv_transport/read_crossing/return_stream/read_gray_source_1 | 7 | 0 | first_D_not_constant_one,stage0_early_fanout,stage1_early_fanout,stage1_not_direct_shift,stage2_early_fanout,stage2_not_direct_shift,stage3_early_fanout,stage3_not_direct_shift,stage4_early_fanout,stage4_not_direct_shift,stage5_early_fanout,stage5_not_direct_shift,stage6_not_direct_shift | clk_out1_clk_mmcm_hbm | fixed_machine/machine/application/inference/kv_transport/read_crossing/return_stream/write_gray[6]_i_2_n_0
fixed_machine/machine/application/inference/kv_transport/read_crossing/return_stream/read_gray_source_2 | 7 | 0 | first_D_not_constant_one,stage0_early_fanout,stage1_early_fanout,stage1_not_direct_shift,stage2_early_fanout,stage2_not_direct_shift,stage3_early_fanout,stage3_not_direct_shift,stage4_early_fanout,stage4_not_direct_shift,stage5_early_fanout,stage5_not_direct_shift,stage6_not_direct_shift | clk_out1_clk_mmcm_hbm | fixed_machine/machine/application/inference/kv_transport/read_crossing/return_stream/write_gray[6]_i_2_n_0
fixed_machine/machine/application/inference/kv_transport/read_crossing/return_stream/read_gray_source_3 | 7 | 0 | first_D_not_constant_one,stage0_early_fanout,stage1_early_fanout,stage1_not_direct_shift,stage2_early_fanout,stage2_not_direct_shift,stage3_early_fanout,stage3_not_direct_shift,stage4_early_fanout,stage4_not_direct_shift,stage5_early_fanout,stage5_not_direct_shift,stage6_not_direct_shift | clk_out1_clk_mmcm_hbm | fixed_machine/machine/application/inference/kv_transport/read_crossing/return_stream/write_gray[6]_i_2_n_0
fixed_machine/machine/application/inference/kv_transport/read_crossing/return_stream/source_reset_release | 3 | 1 |  | clk_out1_clk_mmcm_hbm | fixed_machine/machine/application/inference/kv_transport/read_crossing/return_stream/source_reset_release[2]_i_1_n_0
fixed_machine/machine/application/inference/kv_transport/read_crossing/return_stream/write_gray_destination_1 | 7 | 0 | first_D_not_constant_one,stage0_early_fanout,stage1_early_fanout,stage1_not_direct_shift,stage2_early_fanout,stage2_not_direct_shift,stage3_early_fanout,stage3_not_direct_shift,stage4_early_fanout,stage4_not_direct_shift,stage5_early_fanout,stage5_not_direct_shift,stage6_not_direct_shift | clk_out1_clk_mmcm_a | fixed_machine/machine/application/inference/kv_transport/read_crossing/return_stream/read_binary_rep[5]_i_2_n_0
fixed_machine/machine/application/inference/kv_transport/read_crossing/return_stream/write_gray_destination_2 | 7 | 0 | first_D_not_constant_one,stage0_early_fanout,stage1_early_fanout,stage1_not_direct_shift,stage2_early_fanout,stage2_not_direct_shift,stage3_early_fanout,stage3_not_direct_shift,stage4_early_fanout,stage4_not_direct_shift,stage5_early_fanout,stage5_not_direct_shift,stage6_not_direct_shift | clk_out1_clk_mmcm_a | fixed_machine/machine/application/inference/kv_transport/read_crossing/return_stream/read_binary_rep[5]_i_2_n_0
fixed_machine/machine/application/inference/kv_transport/read_crossing/return_stream/write_gray_destination_3 | 7 | 0 | first_D_not_constant_one,stage0_early_fanout,stage1_early_fanout,stage1_not_direct_shift,stage2_early_fanout,stage2_not_direct_shift,stage3_early_fanout,stage3_not_direct_shift,stage4_early_fanout,stage4_not_direct_shift,stage5_early_fanout,stage5_not_direct_shift,stage6_not_direct_shift | clk_out1_clk_mmcm_a | fixed_machine/machine/application/inference/kv_transport/read_crossing/return_stream/read_binary_rep[5]_i_2_n_0
fixed_machine/machine/application/inference/kv_transport/update_crossing/core_reset_release | 3 | 1 |  | clk_out1_clk_mmcm_a | fixed_machine/machine/application/inference/kv_transport/update_crossing/core_reset_release[2]_i_1_n_0
fixed_machine/machine/application/inference/kv_transport/update_crossing/memory_error_core | 3 | 0 | first_D_not_constant_one | clk_out1_clk_mmcm_a | fixed_machine/machine/application/inference/kv_transport/update_crossing/memory_error_core[2]_i_1_n_0
fixed_machine/machine/application/inference/kv_transport/update_crossing/memory_reset_release | 3 | 1 |  | clk_out1_clk_mmcm_hbm | fixed_machine/machine/application/inference/kv_transport/update_crossing/core_reset_release[2]_i_1_n_0
fixed_machine/machine/application/inference/kv_transport/update_crossing/forward_stream/destination_reset_release | 3 | 1 |  | clk_out1_clk_mmcm_hbm | fixed_machine/machine/application/inference/kv_transport/update_crossing/forward_stream/source_reset_release[2]_i_1_n_0
fixed_machine/machine/application/inference/kv_transport/update_crossing/forward_stream/read_gray_source_1 | 7 | 0 | first_D_not_constant_one,stage0_early_fanout,stage1_early_fanout,stage1_not_direct_shift,stage2_early_fanout,stage2_not_direct_shift,stage3_early_fanout,stage3_not_direct_shift,stage4_early_fanout,stage4_not_direct_shift,stage5_early_fanout,stage5_not_direct_shift,stage6_not_direct_shift | clk_out1_clk_mmcm_a | fixed_machine/machine/application/inference/kv_transport/update_crossing/forward_stream/write_gray[6]_i_2_n_0
fixed_machine/machine/application/inference/kv_transport/update_crossing/forward_stream/read_gray_source_2 | 7 | 0 | first_D_not_constant_one,stage0_early_fanout,stage1_early_fanout,stage1_not_direct_shift,stage2_early_fanout,stage2_not_direct_shift,stage3_early_fanout,stage3_not_direct_shift,stage4_early_fanout,stage4_not_direct_shift,stage5_early_fanout,stage5_not_direct_shift,stage6_not_direct_shift | clk_out1_clk_mmcm_a | fixed_machine/machine/application/inference/kv_transport/update_crossing/forward_stream/write_gray[6]_i_2_n_0
fixed_machine/machine/application/inference/kv_transport/update_crossing/forward_stream/read_gray_source_3 | 7 | 0 | first_D_not_constant_one,stage0_early_fanout,stage1_early_fanout,stage1_not_direct_shift,stage2_early_fanout,stage2_not_direct_shift,stage3_early_fanout,stage3_not_direct_shift,stage4_early_fanout,stage4_not_direct_shift,stage5_early_fanout,stage5_not_direct_shift,stage6_not_direct_shift | clk_out1_clk_mmcm_a | fixed_machine/machine/application/inference/kv_transport/update_crossing/forward_stream/write_gray[6]_i_2_n_0
fixed_machine/machine/application/inference/kv_transport/update_crossing/forward_stream/source_reset_release | 3 | 1 |  | clk_out1_clk_mmcm_a | fixed_machine/machine/application/inference/kv_transport/update_crossing/forward_stream/source_reset_release[2]_i_1_n_0
fixed_machine/machine/application/inference/kv_transport/update_crossing/forward_stream/write_gray_destination_1 | 7 | 0 | first_D_not_constant_one,stage0_early_fanout,stage1_early_fanout,stage1_not_direct_shift,stage2_early_fanout,stage2_not_direct_shift,stage3_early_fanout,stage3_not_direct_shift,stage4_early_fanout,stage4_not_direct_shift,stage5_early_fanout,stage5_not_direct_shift,stage6_not_direct_shift | clk_out1_clk_mmcm_hbm | fixed_machine/machine/application/inference/kv_transport/update_crossing/forward_stream/read_binary_rep[5]_i_2_n_0
fixed_machine/machine/application/inference/kv_transport/update_crossing/forward_stream/write_gray_destination_2 | 7 | 0 | first_D_not_constant_one,stage0_early_fanout,stage1_early_fanout,stage1_not_direct_shift,stage2_early_fanout,stage2_not_direct_shift,stage3_early_fanout,stage3_not_direct_shift,stage4_early_fanout,stage4_not_direct_shift,stage5_early_fanout,stage5_not_direct_shift,stage6_not_direct_shift | clk_out1_clk_mmcm_hbm | fixed_machine/machine/application/inference/kv_transport/update_crossing/forward_stream/read_binary_rep[5]_i_2_n_0
fixed_machine/machine/application/inference/kv_transport/update_crossing/forward_stream/write_gray_destination_3 | 7 | 0 | first_D_not_constant_one,stage0_early_fanout,stage1_early_fanout,stage1_not_direct_shift,stage2_early_fanout,stage2_not_direct_shift,stage3_early_fanout,stage3_not_direct_shift,stage4_early_fanout,stage4_not_direct_shift,stage5_early_fanout,stage5_not_direct_shift,stage6_not_direct_shift | clk_out1_clk_mmcm_hbm | fixed_machine/machine/application/inference/kv_transport/update_crossing/forward_stream/read_binary_rep[5]_i_2_n_0
fixed_machine/machine/application/inference/kv_transport/update_crossing/return_stream/destination_reset_release | 3 | 1 |  | clk_out1_clk_mmcm_a | fixed_machine/machine/application/inference/kv_transport/update_crossing/return_stream/source_reset_release[2]_i_1_n_0
fixed_machine/machine/application/inference/kv_transport/update_crossing/return_stream/read_gray_source_1 | 7 | 0 | first_D_not_constant_one,stage0_early_fanout,stage1_early_fanout,stage1_not_direct_shift,stage2_early_fanout,stage2_not_direct_shift,stage3_early_fanout,stage3_not_direct_shift,stage4_early_fanout,stage4_not_direct_shift,stage5_early_fanout,stage5_not_direct_shift,stage6_not_direct_shift | clk_out1_clk_mmcm_hbm | fixed_machine/machine/application/inference/kv_transport/update_crossing/return_stream/write_gray[6]_i_2_n_0
fixed_machine/machine/application/inference/kv_transport/update_crossing/return_stream/read_gray_source_2 | 7 | 0 | first_D_not_constant_one,stage0_early_fanout,stage1_early_fanout,stage1_not_direct_shift,stage2_early_fanout,stage2_not_direct_shift,stage3_early_fanout,stage3_not_direct_shift,stage4_early_fanout,stage4_not_direct_shift,stage5_early_fanout,stage5_not_direct_shift,stage6_not_direct_shift | clk_out1_clk_mmcm_hbm | fixed_machine/machine/application/inference/kv_transport/update_crossing/return_stream/write_gray[6]_i_2_n_0
fixed_machine/machine/application/inference/kv_transport/update_crossing/return_stream/read_gray_source_3 | 7 | 0 | first_D_not_constant_one,stage0_early_fanout,stage1_early_fanout,stage1_not_direct_shift,stage2_early_fanout,stage2_not_direct_shift,stage3_early_fanout,stage3_not_direct_shift,stage4_early_fanout,stage4_not_direct_shift,stage5_early_fanout,stage5_not_direct_shift,stage6_not_direct_shift | clk_out1_clk_mmcm_hbm | fixed_machine/machine/application/inference/kv_transport/update_crossing/return_stream/write_gray[6]_i_2_n_0
fixed_machine/machine/application/inference/kv_transport/update_crossing/return_stream/source_reset_release | 3 | 1 |  | clk_out1_clk_mmcm_hbm | fixed_machine/machine/application/inference/kv_transport/update_crossing/return_stream/source_reset_release[2]_i_1_n_0
fixed_machine/machine/application/inference/kv_transport/update_crossing/return_stream/write_gray_destination_1 | 7 | 0 | first_D_not_constant_one,stage0_early_fanout,stage1_early_fanout,stage1_not_direct_shift,stage2_early_fanout,stage2_not_direct_shift,stage3_early_fanout,stage3_not_direct_shift,stage4_early_fanout,stage4_not_direct_shift,stage5_early_fanout,stage5_not_direct_shift,stage6_not_direct_shift | clk_out1_clk_mmcm_a | fixed_machine/machine/application/inference/kv_transport/update_crossing/return_stream/read_binary_rep[5]_i_2_n_0
fixed_machine/machine/application/inference/kv_transport/update_crossing/return_stream/write_gray_destination_2 | 7 | 0 | first_D_not_constant_one,stage0_early_fanout,stage1_early_fanout,stage1_not_direct_shift,stage2_early_fanout,stage2_not_direct_shift,stage3_early_fanout,stage3_not_direct_shift,stage4_early_fanout,stage4_not_direct_shift,stage5_early_fanout,stage5_not_direct_shift,stage6_not_direct_shift | clk_out1_clk_mmcm_a | fixed_machine/machine/application/inference/kv_transport/update_crossing/return_stream/read_binary_rep[5]_i_2_n_0
fixed_machine/machine/application/inference/kv_transport/update_crossing/return_stream/write_gray_destination_3 | 7 | 0 | first_D_not_constant_one,stage0_early_fanout,stage1_early_fanout,stage1_not_direct_shift,stage2_early_fanout,stage2_not_direct_shift,stage3_early_fanout,stage3_not_direct_shift,stage4_early_fanout,stage4_not_direct_shift,stage5_early_fanout,stage5_not_direct_shift,stage6_not_direct_shift | clk_out1_clk_mmcm_a | fixed_machine/machine/application/inference/kv_transport/update_crossing/return_stream/read_binary_rep[5]_i_2_n_0
fixed_machine/machine/application/inference/model_transport/crossing/core_reset_release | 3 | 1 |  | clk_out1_clk_mmcm_a | fixed_machine/machine/application/inference/model_transport/crossing/core_reset_release[2]_i_1_n_0
fixed_machine/machine/application/inference/model_transport/crossing/memory_error_core | 3 | 0 | first_D_not_constant_one | clk_out1_clk_mmcm_a | fixed_machine/machine/application/inference/model_transport/crossing/memory_error_core[2]_i_1_n_0
fixed_machine/machine/application/inference/model_transport/crossing/memory_reset_release | 3 | 1 |  | clk_out1_clk_mmcm_hbm | fixed_machine/machine/application/inference/model_transport/crossing/core_reset_release[2]_i_1_n_0
fixed_machine/machine/application/inference/model_transport/crossing/requests/destination_reset_release | 3 | 1 |  | clk_out1_clk_mmcm_hbm | fixed_machine/machine/application/inference/model_transport/crossing/requests/source_reset_release[2]_i_1_n_0
fixed_machine/machine/application/inference/model_transport/crossing/requests/read_gray_source_1 | 4 | 0 | first_D_not_constant_one,stage0_early_fanout,stage1_early_fanout,stage1_not_direct_shift,stage2_early_fanout,stage2_not_direct_shift,stage3_not_direct_shift | clk_out1_clk_mmcm_a | fixed_machine/machine/application/inference/model_transport/crossing/requests/write_gray[3]_i_2_n_0
fixed_machine/machine/application/inference/model_transport/crossing/requests/read_gray_source_2 | 4 | 0 | first_D_not_constant_one,stage0_early_fanout,stage1_early_fanout,stage1_not_direct_shift,stage2_early_fanout,stage2_not_direct_shift,stage3_not_direct_shift | clk_out1_clk_mmcm_a | fixed_machine/machine/application/inference/model_transport/crossing/requests/write_gray[3]_i_2_n_0
fixed_machine/machine/application/inference/model_transport/crossing/requests/read_gray_source_3 | 4 | 0 | first_D_not_constant_one,stage0_early_fanout,stage1_early_fanout,stage1_not_direct_shift,stage2_early_fanout,stage2_not_direct_shift,stage3_not_direct_shift | clk_out1_clk_mmcm_a | fixed_machine/machine/application/inference/model_transport/crossing/requests/write_gray[3]_i_2_n_0
fixed_machine/machine/application/inference/model_transport/crossing/requests/source_reset_release | 3 | 1 |  | clk_out1_clk_mmcm_a | fixed_machine/machine/application/inference/model_transport/crossing/requests/source_reset_release[2]_i_1_n_0
fixed_machine/machine/application/inference/model_transport/crossing/requests/write_gray_destination_1 | 4 | 0 | first_D_not_constant_one,stage0_early_fanout,stage1_early_fanout,stage1_not_direct_shift,stage2_early_fanout,stage2_not_direct_shift,stage3_not_direct_shift | clk_out1_clk_mmcm_hbm | fixed_machine/machine/application/inference/model_transport/crossing/requests/write_gray_destination_1[3]_i_1_n_0
fixed_machine/machine/application/inference/model_transport/crossing/requests/write_gray_destination_2 | 4 | 0 | first_D_not_constant_one,stage0_early_fanout,stage1_early_fanout,stage1_not_direct_shift,stage2_early_fanout,stage2_not_direct_shift,stage3_not_direct_shift | clk_out1_clk_mmcm_hbm | fixed_machine/machine/application/inference/model_transport/crossing/requests/write_gray_destination_1[3]_i_1_n_0
fixed_machine/machine/application/inference/model_transport/crossing/requests/write_gray_destination_3 | 4 | 0 | first_D_not_constant_one,stage0_early_fanout,stage1_early_fanout,stage1_not_direct_shift,stage2_early_fanout,stage2_not_direct_shift,stage3_not_direct_shift | clk_out1_clk_mmcm_hbm | fixed_machine/machine/application/inference/model_transport/crossing/requests/write_gray_destination_1[3]_i_1_n_0
fixed_machine/machine/application/inference/model_transport/crossing/responses/destination_reset_release | 3 | 1 |  | clk_out1_clk_mmcm_a | fixed_machine/machine/application/inference/model_transport/crossing/responses/source_reset_release[2]_i_1_n_0
fixed_machine/machine/application/inference/model_transport/crossing/responses/read_gray_source_1 | 7 | 0 | first_D_not_constant_one,stage0_early_fanout,stage1_early_fanout,stage1_not_direct_shift,stage2_early_fanout,stage2_not_direct_shift,stage3_early_fanout,stage3_not_direct_shift,stage4_early_fanout,stage4_not_direct_shift,stage5_early_fanout,stage5_not_direct_shift,stage6_not_direct_shift | clk_out1_clk_mmcm_hbm | fixed_machine/machine/application/inference/model_transport/crossing/responses/write_gray[6]_i_2_n_0
fixed_machine/machine/application/inference/model_transport/crossing/responses/read_gray_source_2 | 7 | 0 | first_D_not_constant_one,stage0_early_fanout,stage1_early_fanout,stage1_not_direct_shift,stage2_early_fanout,stage2_not_direct_shift,stage3_early_fanout,stage3_not_direct_shift,stage4_early_fanout,stage4_not_direct_shift,stage5_early_fanout,stage5_not_direct_shift,stage6_not_direct_shift | clk_out1_clk_mmcm_hbm | fixed_machine/machine/application/inference/model_transport/crossing/responses/write_gray[6]_i_2_n_0
fixed_machine/machine/application/inference/model_transport/crossing/responses/read_gray_source_3 | 7 | 0 | first_D_not_constant_one,stage0_early_fanout,stage1_early_fanout,stage1_not_direct_shift,stage2_early_fanout,stage2_not_direct_shift,stage3_early_fanout,stage3_not_direct_shift,stage4_early_fanout,stage4_not_direct_shift,stage5_early_fanout,stage5_not_direct_shift,stage6_not_direct_shift | clk_out1_clk_mmcm_hbm | fixed_machine/machine/application/inference/model_transport/crossing/responses/write_gray[6]_i_2_n_0
fixed_machine/machine/application/inference/model_transport/crossing/responses/source_reset_release | 3 | 1 |  | clk_out1_clk_mmcm_hbm | fixed_machine/machine/application/inference/model_transport/crossing/responses/source_reset_release[2]_i_1_n_0
fixed_machine/machine/application/inference/model_transport/crossing/responses/write_gray_destination_1 | 7 | 0 | first_D_not_constant_one,stage0_early_fanout,stage1_early_fanout,stage1_not_direct_shift,stage2_early_fanout,stage2_not_direct_shift,stage3_early_fanout,stage3_not_direct_shift,stage4_early_fanout,stage4_not_direct_shift,stage5_early_fanout,stage5_not_direct_shift,stage6_not_direct_shift | clk_out1_clk_mmcm_a | fixed_machine/machine/application/inference/model_transport/crossing/responses/read_binary_rep[5]_i_2_n_0
fixed_machine/machine/application/inference/model_transport/crossing/responses/write_gray_destination_2 | 7 | 0 | first_D_not_constant_one,stage0_early_fanout,stage1_early_fanout,stage1_not_direct_shift,stage2_early_fanout,stage2_not_direct_shift,stage3_early_fanout,stage3_not_direct_shift,stage4_early_fanout,stage4_not_direct_shift,stage5_early_fanout,stage5_not_direct_shift,stage6_not_direct_shift | clk_out1_clk_mmcm_a | fixed_machine/machine/application/inference/model_transport/crossing/responses/read_binary_rep[5]_i_2_n_0
fixed_machine/machine/application/inference/model_transport/crossing/responses/write_gray_destination_3 | 7 | 0 | first_D_not_constant_one,stage0_early_fanout,stage1_early_fanout,stage1_not_direct_shift,stage2_early_fanout,stage2_not_direct_shift,stage3_early_fanout,stage3_not_direct_shift,stage4_early_fanout,stage4_not_direct_shift,stage5_early_fanout,stage5_not_direct_shift,stage6_not_direct_shift | clk_out1_clk_mmcm_a | fixed_machine/machine/application/inference/model_transport/crossing/responses/read_binary_rep[5]_i_2_n_0
fixed_machine/machine/startup/core_reset_release | 3 | 1 |  | clk_out1_clk_mmcm_a | fixed_machine/machine/startup/core_reset_release[2]_i_1_n_0
fixed_machine/machine/startup/error_to_shell | 3 | 0 | first_D_not_constant_one | clk_main_a0 | fixed_machine/machine/startup/ready_to_shell[2]_i_1_n_0
fixed_machine/machine/startup/ingress_error_to_core | 3 | 0 | first_D_not_constant_one | clk_out1_clk_mmcm_a | fixed_machine/machine/startup/ingress_error_to_core[2]_i_1_n_0
fixed_machine/machine/startup/ready_to_shell | 3 | 0 | first_D_not_constant_one | clk_main_a0 | fixed_machine/machine/startup/ready_to_shell[2]_i_1_n_0
fixed_machine/machine/startup/shell_reset_release | 3 | 1 |  | clk_main_a0 | fixed_machine/machine/startup/core_reset_release[2]_i_1_n_0
fixed_machine/machine/startup/boot/core_reset_release | 3 | 1 |  | clk_out1_clk_mmcm_a | fixed_machine/machine/startup/boot/core_reset_release[2]_i_1_n_0
fixed_machine/machine/startup/boot/crossing/core_reset_release | 3 | 1 |  | clk_out1_clk_mmcm_a | fixed_machine/machine/startup/boot/crossing/core_reset_release[2]_i_1_n_0
fixed_machine/machine/startup/boot/crossing/memory_error_core | 3 | 0 | first_D_not_constant_one | clk_out1_clk_mmcm_a | fixed_machine/machine/startup/boot/crossing/memory_error_core[2]_i_1_n_0
fixed_machine/machine/startup/boot/crossing/memory_reset_release | 3 | 1 |  | clk_out1_clk_mmcm_hbm | fixed_machine/machine/startup/boot/crossing/core_reset_release[2]_i_1_n_0
fixed_machine/machine/startup/boot/crossing/forward_stream/destination_reset_release | 3 | 1 |  | clk_out1_clk_mmcm_hbm | fixed_machine/machine/startup/boot/crossing/forward_stream/source_reset_release[2]_i_1_n_0
fixed_machine/machine/startup/boot/crossing/forward_stream/read_gray_source_1 | 7 | 0 | first_D_not_constant_one,stage0_early_fanout,stage1_early_fanout,stage1_not_direct_shift,stage2_early_fanout,stage2_not_direct_shift,stage3_early_fanout,stage3_not_direct_shift,stage4_early_fanout,stage4_not_direct_shift,stage5_early_fanout,stage5_not_direct_shift,stage6_not_direct_shift | clk_out1_clk_mmcm_a | fixed_machine/machine/startup/boot/crossing/forward_stream/write_gray[6]_i_2_n_0
fixed_machine/machine/startup/boot/crossing/forward_stream/read_gray_source_2 | 7 | 0 | first_D_not_constant_one,stage0_early_fanout,stage1_early_fanout,stage1_not_direct_shift,stage2_early_fanout,stage2_not_direct_shift,stage3_early_fanout,stage3_not_direct_shift,stage4_early_fanout,stage4_not_direct_shift,stage5_early_fanout,stage5_not_direct_shift,stage6_not_direct_shift | clk_out1_clk_mmcm_a | fixed_machine/machine/startup/boot/crossing/forward_stream/write_gray[6]_i_2_n_0
fixed_machine/machine/startup/boot/crossing/forward_stream/read_gray_source_3 | 7 | 0 | first_D_not_constant_one,stage0_early_fanout,stage1_early_fanout,stage1_not_direct_shift,stage2_early_fanout,stage2_not_direct_shift,stage3_early_fanout,stage3_not_direct_shift,stage4_early_fanout,stage4_not_direct_shift,stage5_early_fanout,stage5_not_direct_shift,stage6_not_direct_shift | clk_out1_clk_mmcm_a | fixed_machine/machine/startup/boot/crossing/forward_stream/write_gray[6]_i_2_n_0
fixed_machine/machine/startup/boot/crossing/forward_stream/source_reset_release | 3 | 1 |  | clk_out1_clk_mmcm_a | fixed_machine/machine/startup/boot/crossing/forward_stream/source_reset_release[2]_i_1_n_0
fixed_machine/machine/startup/boot/crossing/forward_stream/write_gray_destination_1 | 7 | 0 | first_D_not_constant_one,stage0_early_fanout,stage1_early_fanout,stage1_not_direct_shift,stage2_early_fanout,stage2_not_direct_shift,stage3_early_fanout,stage3_not_direct_shift,stage4_early_fanout,stage4_not_direct_shift,stage5_early_fanout,stage5_not_direct_shift,stage6_not_direct_shift | clk_out1_clk_mmcm_hbm | fixed_machine/machine/startup/boot/crossing/forward_stream/read_binary_rep[5]_i_2_n_0
fixed_machine/machine/startup/boot/crossing/forward_stream/write_gray_destination_2 | 7 | 0 | first_D_not_constant_one,stage0_early_fanout,stage1_early_fanout,stage1_not_direct_shift,stage2_early_fanout,stage2_not_direct_shift,stage3_early_fanout,stage3_not_direct_shift,stage4_early_fanout,stage4_not_direct_shift,stage5_early_fanout,stage5_not_direct_shift,stage6_not_direct_shift | clk_out1_clk_mmcm_hbm | fixed_machine/machine/startup/boot/crossing/forward_stream/read_binary_rep[5]_i_2_n_0
fixed_machine/machine/startup/boot/crossing/forward_stream/write_gray_destination_3 | 7 | 0 | first_D_not_constant_one,stage0_early_fanout,stage1_early_fanout,stage1_not_direct_shift,stage2_early_fanout,stage2_not_direct_shift,stage3_early_fanout,stage3_not_direct_shift,stage4_early_fanout,stage4_not_direct_shift,stage5_early_fanout,stage5_not_direct_shift,stage6_not_direct_shift | clk_out1_clk_mmcm_hbm | fixed_machine/machine/startup/boot/crossing/forward_stream/read_binary_rep[5]_i_2_n_0
fixed_machine/machine/startup/boot/crossing/return_stream/destination_reset_release | 3 | 1 |  | clk_out1_clk_mmcm_a | fixed_machine/machine/startup/boot/crossing/return_stream/source_reset_release[2]_i_1_n_0
fixed_machine/machine/startup/boot/crossing/return_stream/read_gray_source_1 | 7 | 0 | first_D_not_constant_one,stage0_early_fanout,stage1_early_fanout,stage1_not_direct_shift,stage2_early_fanout,stage2_not_direct_shift,stage3_early_fanout,stage3_not_direct_shift,stage4_early_fanout,stage4_not_direct_shift,stage5_early_fanout,stage5_not_direct_shift,stage6_not_direct_shift | clk_out1_clk_mmcm_hbm | fixed_machine/machine/startup/boot/crossing/return_stream/write_gray[6]_i_2_n_0
fixed_machine/machine/startup/boot/crossing/return_stream/read_gray_source_2 | 7 | 0 | first_D_not_constant_one,stage0_early_fanout,stage1_early_fanout,stage1_not_direct_shift,stage2_early_fanout,stage2_not_direct_shift,stage3_early_fanout,stage3_not_direct_shift,stage4_early_fanout,stage4_not_direct_shift,stage5_early_fanout,stage5_not_direct_shift,stage6_not_direct_shift | clk_out1_clk_mmcm_hbm | fixed_machine/machine/startup/boot/crossing/return_stream/write_gray[6]_i_2_n_0
fixed_machine/machine/startup/boot/crossing/return_stream/read_gray_source_3 | 7 | 0 | first_D_not_constant_one,stage0_early_fanout,stage1_early_fanout,stage1_not_direct_shift,stage2_early_fanout,stage2_not_direct_shift,stage3_early_fanout,stage3_not_direct_shift,stage4_early_fanout,stage4_not_direct_shift,stage5_early_fanout,stage5_not_direct_shift,stage6_not_direct_shift | clk_out1_clk_mmcm_hbm | fixed_machine/machine/startup/boot/crossing/return_stream/write_gray[6]_i_2_n_0
fixed_machine/machine/startup/boot/crossing/return_stream/source_reset_release | 3 | 1 |  | clk_out1_clk_mmcm_hbm | fixed_machine/machine/startup/boot/crossing/return_stream/source_reset_release[2]_i_1_n_0
fixed_machine/machine/startup/boot/crossing/return_stream/write_gray_destination_1 | 7 | 0 | first_D_not_constant_one,stage0_early_fanout,stage1_early_fanout,stage1_not_direct_shift,stage2_early_fanout,stage2_not_direct_shift,stage3_early_fanout,stage3_not_direct_shift,stage4_early_fanout,stage4_not_direct_shift,stage5_early_fanout,stage5_not_direct_shift,stage6_not_direct_shift | clk_out1_clk_mmcm_a | fixed_machine/machine/startup/boot/crossing/return_stream/read_binary_rep[5]_i_2_n_0
fixed_machine/machine/startup/boot/crossing/return_stream/write_gray_destination_2 | 7 | 0 | first_D_not_constant_one,stage0_early_fanout,stage1_early_fanout,stage1_not_direct_shift,stage2_early_fanout,stage2_not_direct_shift,stage3_early_fanout,stage3_not_direct_shift,stage4_early_fanout,stage4_not_direct_shift,stage5_early_fanout,stage5_not_direct_shift,stage6_not_direct_shift | clk_out1_clk_mmcm_a | fixed_machine/machine/startup/boot/crossing/return_stream/read_binary_rep[5]_i_2_n_0
fixed_machine/machine/startup/boot/crossing/return_stream/write_gray_destination_3 | 7 | 0 | first_D_not_constant_one,stage0_early_fanout,stage1_early_fanout,stage1_not_direct_shift,stage2_early_fanout,stage2_not_direct_shift,stage3_early_fanout,stage3_not_direct_shift,stage4_early_fanout,stage4_not_direct_shift,stage5_early_fanout,stage5_not_direct_shift,stage6_not_direct_shift | clk_out1_clk_mmcm_a | fixed_machine/machine/startup/boot/crossing/return_stream/read_binary_rep[5]_i_2_n_0
fixed_machine/machine/startup/ingress_crossing/destination_reset_release | 3 | 1 |  | clk_out1_clk_mmcm_a | fixed_machine/machine/startup/ingress_crossing/source_reset_release[2]_i_1_n_0
fixed_machine/machine/startup/ingress_crossing/read_gray_source_1 | 7 | 0 | first_D_not_constant_one,stage0_early_fanout,stage1_early_fanout,stage1_not_direct_shift,stage2_early_fanout,stage2_not_direct_shift,stage3_early_fanout,stage3_not_direct_shift,stage4_early_fanout,stage4_not_direct_shift,stage5_early_fanout,stage5_not_direct_shift,stage6_not_direct_shift | clk_main_a0 | fixed_machine/machine/startup/ingress_crossing/write_gray[6]_i_2_n_0
fixed_machine/machine/startup/ingress_crossing/read_gray_source_2 | 7 | 0 | first_D_not_constant_one,stage0_early_fanout,stage1_early_fanout,stage1_not_direct_shift,stage2_early_fanout,stage2_not_direct_shift,stage3_early_fanout,stage3_not_direct_shift,stage4_early_fanout,stage4_not_direct_shift,stage5_early_fanout,stage5_not_direct_shift,stage6_not_direct_shift | clk_main_a0 | fixed_machine/machine/startup/ingress_crossing/write_gray[6]_i_2_n_0
fixed_machine/machine/startup/ingress_crossing/read_gray_source_3 | 7 | 0 | first_D_not_constant_one,stage0_early_fanout,stage1_early_fanout,stage1_not_direct_shift,stage2_early_fanout,stage2_not_direct_shift,stage3_early_fanout,stage3_not_direct_shift,stage4_early_fanout,stage4_not_direct_shift,stage5_early_fanout,stage5_not_direct_shift,stage6_not_direct_shift | clk_main_a0 | fixed_machine/machine/startup/ingress_crossing/write_gray[6]_i_2_n_0
fixed_machine/machine/startup/ingress_crossing/source_reset_release | 3 | 1 |  | clk_main_a0 | fixed_machine/machine/startup/ingress_crossing/source_reset_release[2]_i_1_n_0
fixed_machine/machine/startup/ingress_crossing/write_gray_destination_1 | 7 | 0 | first_D_not_constant_one,stage0_early_fanout,stage1_early_fanout,stage1_not_direct_shift,stage2_early_fanout,stage2_not_direct_shift,stage3_early_fanout,stage3_not_direct_shift,stage4_early_fanout,stage4_not_direct_shift,stage5_early_fanout,stage5_not_direct_shift,stage6_not_direct_shift | clk_out1_clk_mmcm_a | fixed_machine/machine/startup/ingress_crossing/read_binary_rep[5]_i_2_n_0
fixed_machine/machine/startup/ingress_crossing/write_gray_destination_2 | 7 | 0 | first_D_not_constant_one,stage0_early_fanout,stage1_early_fanout,stage1_not_direct_shift,stage2_early_fanout,stage2_not_direct_shift,stage3_early_fanout,stage3_not_direct_shift,stage4_early_fanout,stage4_not_direct_shift,stage5_early_fanout,stage5_not_direct_shift,stage6_not_direct_shift | clk_out1_clk_mmcm_a | fixed_machine/machine/startup/ingress_crossing/read_binary_rep[5]_i_2_n_0
fixed_machine/machine/startup/ingress_crossing/write_gray_destination_3 | 7 | 0 | first_D_not_constant_one,stage0_early_fanout,stage1_early_fanout,stage1_not_direct_shift,stage2_early_fanout,stage2_not_direct_shift,stage3_early_fanout,stage3_not_direct_shift,stage4_early_fanout,stage4_not_direct_shift,stage5_early_fanout,stage5_not_direct_shift,stage6_not_direct_shift | clk_out1_clk_mmcm_a | fixed_machine/machine/startup/ingress_crossing/read_binary_rep[5]_i_2_n_0
