Berkeley-AI-Risk/inference-only/demos/qwen3-8b/README.md

# Qwen3-8B on AWS F2

[Installation](INSTALL.md) · [Hardware and source build](HARDWARE.md) · [Recorded evidence](measurements.json)

[Validation](VALIDATION.md) · [Reproduction](REPRODUCE.md) · [Formal scope](FORMAL-STATUS.md)

A fixed numerical version of **Qwen3-8B runs on one physical AWS F2 FPGA at
about 1.1 sustained cached tokens/s** under the common one-token benchmark.
The FPGA performs inference; the host loads the fixed model and exchanges
token commands. Work on a faster implementation is ongoing. No projected
speedup is included in the measurements below.

**Package status: runnable prototype; speed optimization in progress.** The
tested AWS FPGA image is publicly loadable. The package includes its exact
hardware sources, host client, fixed-model preparation tools, numerical
reference and implementation reports. Follow [INSTALL.md](INSTALL.md) to run
it on an F2 instance in your own AWS account. This package uses a token-ID
command-line client; an 8B browser interface is not yet included.

## What is fixed

The source model is `Qwen/Qwen3-8B`, checkpoint revision
`b968826d9c46dd6066d109eabc6255188de91218`: 36 transformer layers, hidden width
4,096, 32 query heads, eight K/V heads and head dimension 128. Embedding and
output matrices are not tied. The numerical implementation uses signed 8-bit
projection weights with per-row FP32 scales, BF16 embeddings, specified
integer/FP32/BF16 arithmetic and rounding, and greedy token selection.
It is not bit-for-bit identical to the upstream floating-point model.

The inference circuit runs at 100 MHz and its HBM interface at 125 MHz.
Weights and K/V are stored in HBM. Hardware owns the inference schedule and
intermediate addresses. Startup checks the complete fixed model image;
runtime page authentication checks weights before using their private on-chip
copies. Authentication is not bypassed to obtain these measurements.
The [checked-copy path](HARDWARE.md#organization) is supported by source
inspection, not a formal proof that every actual operand admission and use
has the intended authenticated provenance.

The accepted model image is 8,828,026,880 bytes, with SHA-256:

```text
a1e8a91912dfa79fb602601e256a4a07da64c57dda146529c08886532d42f833
```

There is no secret authentication key or manufacturer model-update command.
This version does not authenticate K/V or encrypt weights.
Modification of K/V and observation of later writes under physical possession
have not been assessed for this 8B implementation. A restricted host command
interface is not evidence that this external-memory path is harmless.

## Inference-only scope

The application operations are `APPEND(token)`, `STEP` and `CLEAR`.
The application does not submit matrix operands, operator programs, tensor
addresses or replacement model weights. A restricted startup loader, status
registers and the source-level management display below are separate
engineering facilities, not additional inference operations.

The assessment assumes a frozen FPGA configuration or an eventual fixed ASIC.
It does not call the AWS host or reprogrammable management platform
inference-only. External-memory access, diagnostic/test interfaces and physical
tampering need their own assessment. No whole-machine formal refinement proof,
physical-tampering certification or measured residual training fraction is
claimed for this 8B implementation.

<!-- BEGIN GENERATED QWEN MANAGEMENT DISPLAY -->
### Management display

The [packaged top-level RTL](hardware/design/cl_qwen.sv) drives
`cl_sh_status_vled` from this 16-bit management display, sampled on
`clk_main_a0` with synchronous reset to zero:

| Bits | Source |
| --- | --- |
| `15:12` | `lifecycle_error_code` |
| `11:8` | `clock_error_code` |
| `7:6` | `2'b0` |
| `5` | `clock_failed` |
| `4` | `pcis_guard_error` |
| `3` | `hbm_ready` |
| `2` | `clock_ready` |
| `1` | `lifecycle_failed` |
| `0` | `online` |

This expression contains lifecycle, clock, HBM and error status, not
attention-control state or arithmetic results. It is observable status
beyond returned tokens. This is a source-wiring statement: correspondence
of this display to the published routed checkpoint remains unverified.
It is not a complete test/debug or physical-access assessment.
<!-- END GENERATED QWEN MANAGEMENT DISPLAY -->

## Measured performance

The [common FPGA benchmark](../../docs/benchmarks/FPGA-SPEED-BENCHMARK.md) uses
one input token `[9707]`, 128 greedy feedback-dependent outputs and two complete
trials, each preceded by CLEAR. All **256 outputs match the independent CPU
reference for the released fixed numerical model**, including outputs after EOS.

The pooled cached rate is **1.12178 tokens/s**: 254 outputs divided by
**226.426331573 seconds** across the two first-to-last reply intervals. Reply
timestamps are taken after validated returns to the generation loop, including
host work and gaps between replies. First-STEP request/reply times are
**0.885921 s** and **0.885698 s**; prompt upload is separate.

The [capture](evidence/common-speed-2026-10-26/capture.json),
[raw replies and source bindings](evidence/common-speed-2026-10-26/source-review.json)
and [CPU reference record](evidence/common-speed-2026-10-26/reference.json)
identify the image, model, host binary and source. The CPU reference is a
preserved independent 128-output run, reconciled with the released model and
numerical source; it is not a new reference execution. Its completion record
is retained, with the absence of an outer process-exit record stated explicitly.
The configured recipe uses a 100 MHz core, 125 MHz memory AXI and 250 MHz shell.
The runtime clock probe is unsupported, so these are configuration identities
rather than independent frequency measurements.

### Additional validation workloads

| Prompt tokens | Generated tokens | Time to first token | Cached tokens/s |
| ---: | ---: | ---: | ---: |
| 1 | 128 | 0.89 s | 1.1 |
| 23, chat-formatted | 53 | 18.84 s | 1.1 |
| 512 | 16 | 428.16 s | 1.1 |

Cached speed uses the intervals after the first returned token, including
host command and inter-reply overhead. The 16-output case contains only 15
cached intervals; it is not a sustained long-context benchmark. First-token
latency includes prompt APPENDs and the first STEP, but excludes configuration,
model upload, the preceding CLEAR and tokenization. Upload and authentication
of the complete model is a separate startup operation, taking about eight to
nine minutes in the recorded runs.

The [measurement record](measurements.json) includes all prompt IDs, expected
outputs and captured timing rows. Recompute the results without an FPGA:

```sh
python3.12 tools/check_measurements.py
```

The hardware tests contain 212 matching output checks: 197 outputs in the main
cases and 15 smoke/replay checks. These include repeated prefixes, not 212
independent prompts. The longest tested tape has 528 tokens. The circuit's
32,768-token tape capacity is not a hardware-qualified full-context claim.
These tests are not a broad language-quality benchmark.

The [installation rehearsal](evidence/installation.json) separately records
22 matching outputs from a freshly compiled client and a complete model
upload, including the built-in self-test and CLEAR/replay. It used the image
owner's account with the vendor SDK already installed. Public load permission
was checked through AWS; a second-account installation was not tested.

## Prepare the fixed model

The model is reconstructed locally rather than stored as an 8.8 GB Git file.
From this directory, with enough space for the upstream checkpoint, exported
image and dependencies (at least 35 GB is advisable):

```sh
python3.12 -m venv .venv-model
.venv-model/bin/python -m pip install -r model/requirements.txt
.venv-model/bin/python tools/prepare_model.py \
  --source local/upstream --download --output local/model --threads 8
```

Omit `--download` when the pinned upstream files are already present. The
exporter verifies them and rejects a result whose hash differs from the
fixed model accepted by the measured FPGA. This is an offline preparation
tool, not a programmable model loader on the chip.

To check the included software reference, run:

```sh
.venv-model/bin/python reference/run_reference.py --model local/model --threads 8
```

This regenerates a three-token continuation and repeats it after CLEAR. The
[recorded reference check](evidence/reference.json) identifies its sources;
it is a CPU numerical check. To inspect all packaged source/report and
installation bindings without AWS or a model download, run:

```sh
python3.12 tools/check_package.py
```
## Protected K/V component simulation

The opt-in [protected K/V component](variants/protected-kv-simulation/README.md)
contains source-bound Linux simulation records and a portable replay harness.
At position zero, it checks the first attention grouped-query pair in each of
36 layers, including separate K and V corruption cases, plain consumption
controls and transport-boundary refusals. An independent Python checker
reconstructs the roots and checks the consumed BF16 values.

This is a separate, frozen component source selection. The deployed F2 image
uses plain K/V; its image, model and speed measurements are unchanged. The
component does not run a complete model or establish physical HBM, CDC/reset,
timing or board qualification. See [validation](VALIDATION.md#protected-kv-component-simulation)
and [recorded replay](REPRODUCE.md#protected-kv-component-simulation).

## Analysis

The [shared residual-training assessment](../../TRAINING-CAPACITY.md#model-assessments)
groups the model assessments and [methodology](../../docs/analysis/RESIDUAL-TRAINING-METHODOLOGY.md).
The [conditional arithmetic accounting](TRAINING-CAPACITY.md) provides a reproducible
inventory and workload calculator. An 8B H100 reference, achieved useful access
and a certified residual-training factor remain unestablished.
