Berkeley-AI-Risk/inference-only/demos/qwen3-1.7b/README.md

# Qwen3-1.7B on AWS F2

[Project overview](../../README.md) · [SimpleStories-V2-5M on Tang Mega](../simplestories-v2-5m/README.md)

[Validation](VALIDATION.md) · [Reproduction](REPRODUCE.md) · [Formal scope](FORMAL-STATUS.md)

**A fixed numerical version of Qwen3-1.7B runs on one physical AWS F2 FPGA
at about 9.0 sustained cached tokens/s under the common one-token benchmark.**
The FPGA performs inference; the host uploads the fixed model, sends token
commands and records the replies. This is a billion-parameter demonstration
of the same authenticated-weight, fixed-inference approach as Tang Mega.

**Run it yourself:** the [installation guide](INSTALL.md) uses the tested,
publicly loadable AWS FPGA image. This package includes the frozen hardware
source, model reconstruction tools, numerical reference, host client, browser
app and implementation reports. You supply an AWS F2 rental; no FPGA source
rebuild is needed to use the prebuilt image.

## The fixed model and circuit

The model is **Qwen/Qwen3-1.7B**, pinned at checkpoint revision
`70d244cc86ccca08cf5af4e1e306ecf908b1ad5e`. It has 1,720,574,976 unique
parameters, 28 transformer layers, hidden size 2,048, 16 query heads,
eight K/V heads and head dimension 128. Input embeddings and the output
weight matrix are tied.

The implemented numerical model uses quantized weights and fixed arithmetic
and rounding rules, with deterministic greedy token selection. It is not a
claim of bit-for-bit agreement with the upstream floating-point implementation.
Hardware outputs below were compared with the project's matching numerical
reference, not a generic Qwen GPU run.

The tested inference core runs at **100 MHz**. Weights and the attention
cache are stored in HBM; private on-chip buffers serve the arithmetic.
A fixed hardware schedule runs all 28 layers. The host does not supply
operator programs, matrix dimensions or intermediate tensor addresses.

Startup accepts the fixed 2,354,380,800-byte model image. The host checks its
size and hash, and hardware independently checks the received image.
Runtime hardware also authenticates weight pages before consuming the checked
on-chip copies, so acceptance does not depend solely on a startup check.
The fixed model-image SHA-256 is:

```text
90d82ed9b90c58607f924190be0c15f18b70d849c536a2ccbddd259858979cd1
```

There is no secret authentication key or manufacturer model-update command.
The published FPGA circuit **does not authenticate K/V or encrypt weights**.
A separate [protected K/V simulation target](variants/protected-kv-simulation/README.md)
adds authenticated retained K/V and self-contained operand/fault controls. Its
recorded model cost and simulation limits are documented with that target; the
published board build and the measurements here use plain K/V storage.
With physical access to external memory, modification of K/V and observation
of later writes remain unresolved under the physical-possession assessment;
the restricted application interface does not close that path.

## Interface and inference-only scope

The inference operations are `APPEND(token)`, `STEP` and `CLEAR`.
An ordinary generation request clears the tape, appends the prompt and performs
the requested number of STEPs. No application command submits arbitrary
matrix operands, reads intermediate tensors or replaces the accepted weights.

The platform has other facilities that must not be confused with those three
inference operations:

- A restricted startup upload path loads the fixed model; it is not a
  general-purpose HBM read/write interface.
- Status registers report readiness, received-byte count and errors.
- The packaged top-level source exposes a 16-bit lifecycle/clock/HBM
  management display, detailed below. Its correspondence to the published
  routed image has not been independently checked.
- AWS manages FPGA configuration, clocks and resets. The general-purpose
  cloud host and AWS management plane are not claimed to be inference-only.

We assess the configured inference circuit under the **frozen-configuration
or eventual-ASIC assumption**, not the whole reprogrammable cloud platform.
A production design would need its own evaluation of external-memory,
diagnostic, test/debug and physical-tampering paths. Unaudited physical
access to HBM is not ruled out by a restricted host command interface.

The [shared conceptual overview](../../README.md#in-what-sense-is-it-inference-only)
and [Tang Mega assessment](../simplestories-v2-5m/INFERENCE-ONLY.md) explain the distinction
between an architectural demonstration and a certified residual training
fraction. Tang Mega's scoped proofs and capacity estimates **do not transfer
automatically to Qwen**. No whole-machine refinement proof, physical-attack
resistance certification or measured training-capacity bound is claimed here.

Qwen-specific [formal work](FORMAL-STATUS.md) has qualified named authentication,
reader, response-queue and physical storage scopes. Actual fixed-core operand
use, whole-machine refinement and image equivalence remain open.

<!-- BEGIN GENERATED QWEN MANAGEMENT DISPLAY -->
### Management display

The [packaged top-level RTL](hardware/design/cl_qwen.sv) drives
`cl_sh_status_vled` from this 16-bit management display, sampled on
`clk_main_a0` with synchronous reset to zero:

| Bits | Source |
| --- | --- |
| `15:12` | `lifecycle_error_code` |
| `11:8` | `clock_error_code` |
| `7:6` | `2'b0` |
| `5` | `clock_failed` |
| `4` | `pcis_guard_error` |
| `3` | `hbm_ready` |
| `2` | `clock_ready` |
| `1` | `lifecycle_failed` |
| `0` | `online` |

This expression contains lifecycle, clock, HBM and error status, not
attention-control state or arithmetic results. It is observable status
beyond returned tokens. This is a source-wiring statement: correspondence
of this display to the published routed checkpoint remains unverified.
It is not a complete test/debug or physical-access assessment.
<!-- END GENERATED QWEN MANAGEMENT DISPLAY -->

## Analysis

The [Qwen residual training analysis](TRAINING-CAPACITY.md) supplies the
arithmetic inventory, conditional ratios, workload distinctions and H100
measurement plan. The [shared methodology](../../docs/analysis/RESIDUAL-TRAINING-METHODOLOGY.md)
sets out the evidence needed for a reliable factor assessment.

## Measured generation speed

The [common FPGA benchmark](../../docs/benchmarks/FPGA-SPEED-BENCHMARK.md) uses
one input token `[9707]`, 128 greedy feedback-dependent outputs and two complete
trials, each preceded by CLEAR. All **256 outputs match the independent CPU
reference for the released fixed numerical model**, including outputs after EOS.

The pooled cached rate is **9.00995 tokens/s**: 254 outputs divided by
**28.191061176 seconds** across the two first-to-last reply intervals. Each
reply is timestamped immediately after its validated return to the generation
loop, so the rate includes host work and gaps between replies. First-STEP
request/reply times are **0.108921 s** and **0.108772 s**; prompt upload is separate.

The [capture](evidence/common-speed-2026-10-26/capture.json),
[raw replies and source bindings](evidence/common-speed-2026-10-26/source-review.json)
and [CPU reference record](evidence/common-speed-2026-10-26/reference.json)
identify the published FPGA image, model, host binary, source and SDK revision.
The configured recipe uses a 100 MHz core, 125 MHz memory AXI and 250 MHz shell.
The runtime clock probe is unsupported on this image, so these are configuration
identities rather than independent frequency measurements.

### Additional validation workloads

The following are two runs of the same three 128-output workloads on the
same loaded image. Each cached rate uses the **127 intervals after the first
returned token**, not the first STEP. The first-token column is from the
second run. Generation rates are rounded to one decimal place; the
[measurement record](measurements.json) retains the full timing data.

| Workload | Prompt tokens | Run 1, cached tokens/s | Run 2, cached tokens/s | Time to first token |
| --- | ---: | ---: | ---: | ---: |
| Story continuation | 4 | 9.0 | 9.0 | 0.389 s |
| Geography completion | 5 | 9.0 | 9.0 | 0.483 s |
| Chat-formatted greeting | 15 | 9.0 | 9.0 | 1.420 s |

The story prompt is “Once upon a time”; the geography prompt is “The capital
of France is”. The greeting uses “Say hello.” with the pinned single-user,
non-thinking chat template. All prompt and expected output token IDs are
included in [the measurement record](measurements.json).

Longer prompts were tested separately, with **16 outputs per case**:

| Prompt tokens | Generated tokens | Time to first token | Cached tokens/s |
| ---: | ---: | ---: | ---: |
| 64 | 16 | 6.058 s | 9.0 |
| 256 | 16 | 24.960 s | 8.5 |
| 512 | 16 | 51.964 s | 8.0 |

The 16-output cases contain only 15 cached intervals each. They characterize
these longer-prompt workloads, not a sustained 128-output run at those
contexts. Growing context increases attention work, so neither 9 tokens/s
nor the short-prompt latency should be assumed for arbitrary prompts.

Timing is observed by the host. Time to first token includes prompt APPENDs
and the first STEP, but excludes FPGA configuration, model upload, the preceding
CLEAR and text tokenization. Cached speed is
`(outputs - 1) / (last reply time - first reply time)`, using the client's
generation clock. It includes command/communication and intervening output
overhead, not just arithmetic cycles. Model loading is a separate startup cost.

## Validation and evidence boundaries

Five completed hardware campaigns contain **852 matching output-token
comparisons**: 3 in the initial smoke test, 15 in the expanded smoke suite,
390 in each repeated sustained suite, and 54 in the longer-prompt suite.
This count includes repeated workloads and CLEAR/replay checks; it is not
852 independent prompts. Every campaign ended with a successful CLEAR.

The longest measured prompt here has **512 tokens followed by 16 outputs**.
The design's 32,768-token tape budget is not a hardware-qualified context
claim: full-context numerical execution has not been demonstrated by these
tests. Output agreement on selected cases is also not a model-quality
benchmark or a proof of correctness for every prompt.

The routed implementation's saved report shows setup slack +0.011 ns,
hold slack +0.007 ns and no failing timing endpoints or routing errors under
its declared constraints. That does not resolve every CDC/reset assumption,
establish production signoff or certify the AWS platform against physical
attacks. The [hardware guide](HARDWARE.md) links the complete implementation
reports, source identities, build instructions and retained warnings.

[measurements.json](measurements.json) preserves the original token/timing
stdout for all 21 tested cases, expected token IDs and hashes binding the
records to the tested image package, model and client. Private account,
instance and image identifiers, local paths and management logs are excluded.
Hashes of those omitted envelopes identify provenance; they do not make
omitted records publicly inspectable. The public deployment identifier is
documented separately in [deployment.json](deployment.json).

To verify the packaged replies and recompute the tables, run from the
repository root:

```sh
python3 -I -S -B tools/check_qwen_measurements.py
python3 -I -S -B tools/check_qwen_package.py
python3 -I -S -B -m unittest discover -s tools -p 'test_qwen_measurements.py' -v
```

These commands need Python 3.11 or later and only the standard library. They do not rent
hardware, contact AWS or run inference. They check the saved replies against
the packaged expected IDs. The separately runnable
[numerical reference](reference/README.md) regenerates those IDs from the
accepted model image; its CPU and full distinct-prompt checks are also included.

## Availability and reproduction

**Do not use the Tang Mega programming instructions or bitstreams for this
experiment.** Use the separate [installation guide](INSTALL.md),
[browser instructions](BROWSER.md), [source-build guide](HARDWARE.md),
[numerical reference](reference/README.md) and [dependency notices](NOTICES.md).
The [detailed hardware diagram](HARDWARE.md#detailed-hardware-diagram) shows the
controllers, memory paths and arithmetic units alongside the SimpleStories design.
The [installation receipt](evidence/installation.json) records a fresh slot
reload, upload of the model rebuilt from this package, the three-token self-test
and a separate 390-token check using the recipient-built host client. These
checks used the image owner's existing F2 environment; they are not a second
account's installation test or a fresh operating-system setup.

The run sequence is: provision an appropriate F2 environment, load the matching
FPGA configuration, upload the checked model, pass a known-answer test, then
generate tokens. The tools do not silently provision paid resources or
substitute a host model. AWS access and any rental remain the operator's
responsibility. A source rebuild is a separate engineering workflow from
running the tested prebuilt image.

Further optimization targets faster generation without weakening consumed-weight
authentication or adding general arithmetic commands. **Ten tokens/s remains
a target, not a measured result.** The [protected K/V target](variants/protected-kv-simulation/README.md) exercises
K/V integrity in RTL simulation. The measured F2 image uses plain K/V.
Board validation of protected K/V and implementation of weight encryption
remain future work for Qwen3-1.7B.
