Berkeley-AI-Risk/inference-only/docs/ARCHITECTURE.md

# Architecture and evidence

The hardware accepts token commands and runs a fixed language-model datapath.
It owns layer sequencing, tensor addresses, intermediate state and token
publication. Authenticated-weight designs (AWICs) check model weights against a
hardware approval policy; hardwired-weight designs (HWICs) encode the weights
in the circuit.

SimpleStories runs on Tang Mega, and the two Qwen models run on AWS F2. The
HWIC work is RTL and physical-design research. This guide starts with their
common architecture, then maps each configuration to its implementation,
evidence and reproduction instructions.

## Computation and trust boundaries

The application supplies tokens to APPEND, requests a token with STEP, and
invalidates logical context with CLEAR. Hardware owns the model schedule,
tensor addresses, intermediate operands and publication of results. Each
demonstrated FPGA design operates on one logical tape; prompt evaluation
processes positions through the fixed model.

```mermaid
flowchart LR
    H["Token commands and allowed settings"] --> T["Tape and command controller"]
    T --> S["Fixed model schedule"]
    S --> D["Numerical datapath"]
    D --> O["Owned token publication"]
    O --> T
    A["AWIC commitment or signed admission"] --> V["Verify model pages"]
    M["External model memory"] --> V
    V --> B["Retained checked copies"]
    B --> D
    R["HWIC fixed weights alternative"] --> D
    D --> K["Owned K/V and workspace"]
    K --> D
    P["Optional current home permission"] -. gates operation .-> S
    P -. gates publication .-> O
```

The diagram shows how commands, weights and working state meet in the
datapath. The [evidence map](#evidence-and-open-joins) identifies which of these
connections have proofs and which still need to be composed.

The public surface also includes configuration-specific provisioning and
observations. Seeded sampling accepts settings only on an empty, idle tape.
Plain Tang S-AWIC reads a signed admission package from its private flash boot
path, installed through a separate programming workflow. Periodic
reauthorization adds UART challenge/grant traffic. Qwen includes a
restricted startup loader, status registers and a management display.
These surfaces belong in the security contract alongside token commands.

CLEAR revokes logical state authority and coordinates cancellation or draining
of accepted work. It is not RAM zeroization, a hard reset, or permission to
forget an outstanding memory transaction. External memory trust is
configuration-specific: the unprotected K/V variants do not establish correct
inference under arbitrary hostile K/V changes.

| Platform | Arithmetic contract | Clock and memory organization |
| --- | --- | --- |
| SimpleStories on Tang Mega | Fixed W10/A16/KV16 BFP-v5 operators; greedy selection or the specified seeded sampler | 25 MHz core, 100 MHz DDR application, 400 MHz memory PLL and 12.5 MHz trusted domain; boot/admission clocking is configuration-specific; external model and K/V regions |
| Qwen on AWS F2 | Fixed int8-weight, integer/FP32/BF16 operations and rounding; model-specific geometry | 100 MHz core, 125 MHz memory interface and 250 MHz host domain; HBM plus private verified-page storage |
| HWIC research | Named checkpoint preserves its selected fixed numerical contract | RTL memory services and block implementation studies; no qualified whole-chip memory, clock or token rate |

The [SimpleStories hardware guide](../demos/simplestories-v2-5m/HARDWARE.md)
and [Qwen hardware guide](../demos/qwen3-1.7b/HARDWARE.md) contain detailed
datapath diagrams and implementation boundaries. Their numerical references
specify the implemented function; agreement with that function is distinct
from measuring model-quality loss relative to the original floating-point model.

On Tang, the trusted divider supplies reset and flash-side transport. The
signed-update admission/readback hashing and LMS verifier, and the home
permission logic and timers, run in the 25 MHz core domain. The selected top
connections and constraints determine each variant's actual clock boundaries.

## Configurations

**F-AWIC** fixes the accepted model commitment in hardware. **S-AWIC** admits
compatible weights under a fixed signature policy. **HWIC** fixes the weights
in the circuit. The FPGA implementations are assessed under a frozen
configuration assumption: their bitstream or AWS FPGA image, fixed constants
and trusted on-chip state form part of the root of trust.

| Configuration | Model admission | Mutable inference memory | Implementation and evidence |
| --- | --- | --- | --- |
| SimpleStories baseline | Fixed weight commitment | External DDR K/V without integrity protection | [Hardware](../demos/simplestories-v2-5m/HARDWARE.md), [greedy qualification](../demos/simplestories-v2-5m/GREEDY-QUALIFICATION.md) |
| SimpleStories K/V protected | Fixed weight commitment | Typed K/V with trusted tags and CLEAR epoch | [K/V design](../demos/simplestories-v2-5m/KV-PROTECTION.md), [greedy qualification](../demos/simplestories-v2-5m/GREEDY-QUALIFICATION.md) |
| SimpleStories encrypted memory | Fixed plaintext commitment after decryption | K/V integrity and encrypted weight/K/V transport | [Encryption design](../demos/simplestories-v2-5m/ENCRYPTED-MEMORY.md), [greedy qualification](../demos/simplestories-v2-5m/GREEDY-QUALIFICATION.md); supplied keys are public demonstration keys |
| SimpleStories seeded sampling | Fixed weight commitment; bounded temperature and public seed settings | External DDR K/V without integrity protection | [Numerical and protocol contract](../demos/simplestories-v2-5m/STOCHASTIC-GENERATION.md), [selected qualification](../demos/simplestories-v2-5m/CURRENT-QUALIFICATION.md) |
| SimpleStories signed updates | Signed model commitment and boot-to-runtime page binding | External DDR K/V without integrity protection | [S-AWIC hardware](../demos/simplestories-v2-5m/variants/signed-update/tang/HARDWARE.md), [validation](../demos/simplestories-v2-5m/variants/signed-update/tang/VALIDATION.md) |
| SimpleStories periodic reauthorization | Signed updates plus current model-specific permission | External DDR K/V without integrity protection | [Permission mechanism](../demos/simplestories-v2-5m/variants/home-authorization/HARDWARE.md), [validation](../demos/simplestories-v2-5m/variants/home-authorization/VALIDATION.md), [routed timing review](../demos/simplestories-v2-5m/variants/home-authorization/RESET-REVIEW.md) |
| Qwen3-1.7B | Fixed weight commitment; private authenticated HBM page copies | External HBM K/V without integrity protection | [Hardware and source identity](../demos/qwen3-1.7b/HARDWARE.md), [validation](../demos/qwen3-1.7b/VALIDATION.md), [formal scope](../demos/qwen3-1.7b/FORMAL-STATUS.md) |
| Qwen3-8B | Fixed weight commitment; private checked HBM page copies | External HBM K/V without integrity protection | [Hardware and source identity](../demos/qwen3-8b/HARDWARE.md), [validation](../demos/qwen3-8b/VALIDATION.md), [formal scope](../demos/qwen3-8b/FORMAL-STATUS.md) |
| TLM26 MoE | Fixed architecture and private SHA-256 page-digest ROM; boot-only sequential DDR weight loading | Dynamic K/V without an integrity claim | [Hardware and timing](../demos/tlm26-moe/README.md#tang-build-and-provisioning), [validation](../demos/tlm26-moe/VALIDATION.md), [formal scope](../demos/tlm26-moe/FORMAL-STATUS.md) |
| SimpleStories HWIC research | Fixed ROM baseline and separately identified spatial implementations | Private dynamic K/V requiring a physical memory implementation | [Runnable RTL checkpoint](../research/hwic/simplestories-2026-10-27/README.md), [integrated regression](../research/hwic/PROGRESS-2026-11-04.md), [memory and performance assessment](../research/hwic/PROGRESS-2026-11-05-FEASIBILITY.md) |

The separate [Qwen3-1.7B protected K/V simulation](../demos/qwen3-1.7b/variants/protected-kv-simulation/README.md)
compares the plain and authenticated stores at the attention input and checks how
each handles a corrupted K or V value. The measured F2 image uses the plain store.

The separate [Qwen3-8B protected K/V component](../demos/qwen3-8b/variants/protected-kv-simulation/README.md)
checks the first attention grouped-query pair at position zero across all 36
layer identities, with separate K/V corruption controls and transport bounds.
It has recorded same-clock simulation evidence; the measured 8B F2 image uses
plain K/V. Full-model and physical implementation qualification remain open.

The [combined SimpleStories target](../demos/simplestories-v2-5m/variants/combined-security-simulation/README.md) supplies full-datapath RTL simulation evidence, with an [eleven-case validation record](../demos/simplestories-v2-5m/variants/combined-security-simulation/VALIDATION.json).

The [Qwen3-8B board measurements](../demos/qwen3-8b/measurements.json) provide a measured baseline for the [proposed reusable-die architecture](PROPOSED-REUSABLE-AWIC.md), whose Llama 8B and 405B deployments are proposals.

The runnable HWIC ROM checkpoint and the later spatial regression are different
RTL selections. Matching test-corpus counts do not transfer qualification
between them.

The six Tang configurations are distinct built images. Signed model admission
and permission to continue running are separate mechanisms. In the
reauthorization design, withholding renewal or losing access to home base
expires permission; offline rollback prevention independent of home policy is
not supplied. Its public test keys and entropy qualification limits are stated
in the [variant guide](../demos/simplestories-v2-5m/variants/home-authorization/README.md).
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
