Berkeley-AI-Risk/inference-only/demos/qwen3-1.7b/HARDWARE.md

# Qwen3-1.7B hardware and source build

[Qwen guide](README.md) · [Run the prebuilt design](INSTALL.md) · [Licenses](NOTICES.md)

Use [INSTALL.md](INSTALL.md) to run the measured image without compiling it.
This guide explains the circuit, the source/build selection and the rebuild
procedure. A rebuilt image needs its own implementation and board validation.

## Circuit organization

The custom SystemVerilog circuit implements a fixed 28-layer Qwen3-1.7B
schedule. It uses signed 8-bit weights, per-vector signed 16-bit projection
inputs, integer dot-product accumulation, and specified FP32/BF16 operations
and tables elsewhere. The parallel projection datapath processes 32 rows of
eight weights per accepted beat. Attention remains an internal operation;
the host cannot supply its tensor addresses, shapes or operands.

The design uses AWS F2's UltraScale+ VU47P FPGA and HBM. The measured image
uses AWS clock recipes A0/B0/C2/H1: **100 MHz inference**, **125 MHz memory**,
and the **250 MHz host clock**. Weights and K/V are in HBM, not host DRAM or
DDR4. Four private weight-verification workers authenticate pages before
the inference engine can consume their checked on-chip copies. The mapped
payload storage occupies 128 UltraRAM blocks across 16 private banks.

The startup path accepts only the selected model image. The C++ host serializes
APPEND, STEP and CLEAR, with an exclusive slot lock; it performs tokenization
and presentation, not inference. Host-side end-marker stopping changes the
number of STEPs issued, not the circuit's greedy numerical rule.
The [interface assessment](README.md#interface-and-inference-only-scope)
also discloses status registers and the source-level
[management display](README.md#management-display). A routed-image check of
that display remains open; the top-level source does not expose the previously
described attention-state readout through this output.
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
