Berkeley-AI-Risk/inference-only/demos/qwen3-8b/HARDWARE.md

# Qwen3-8B hardware and source build

Use [INSTALL.md](INSTALL.md) to run the measured image without compiling it.
This guide explains the circuit, the source/build selection and the rebuild
procedure. A rebuilt image needs its own implementation and board validation;
new vendor-tool runs need not produce byte-identical output.

## Organization
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
