Berkeley-AI-Risk/inference-only/demos/qwen3-1.7b/media/qwen-demo.png

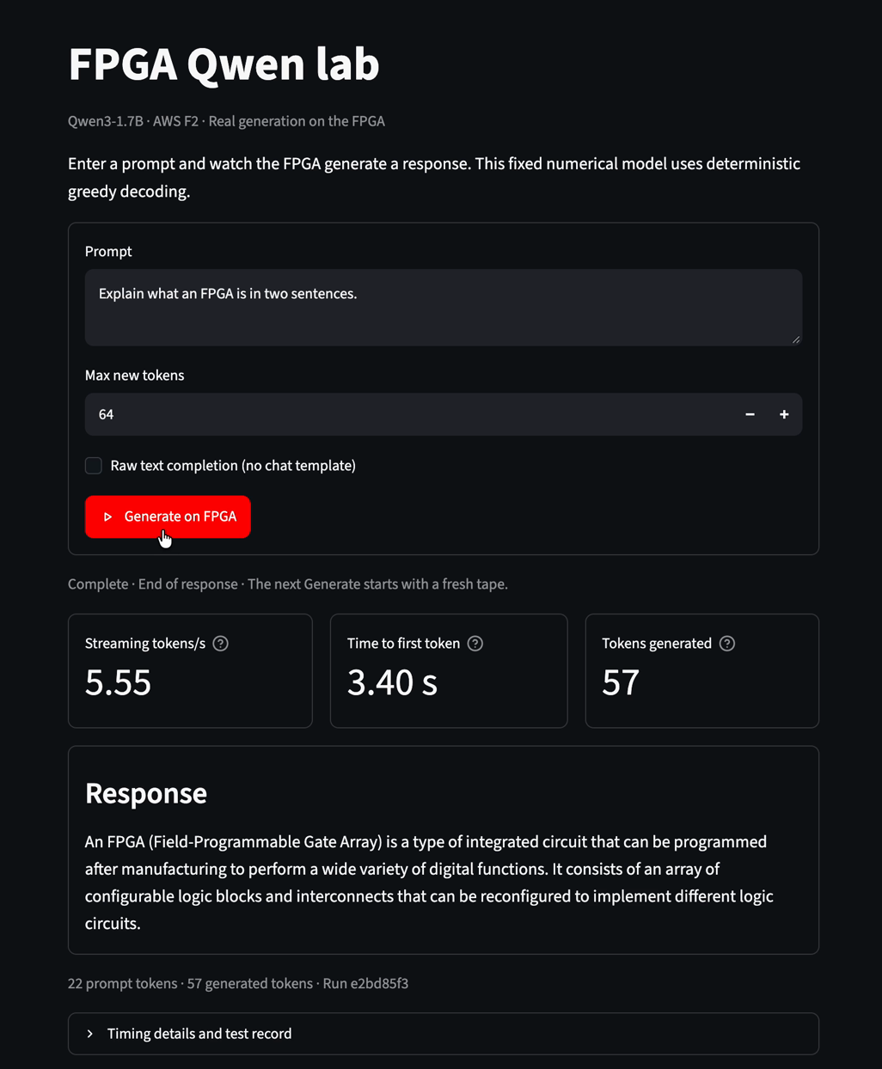
demos/qwen3-1.7b/media/qwen-demo.png
