Berkeley-AI-Risk/inference-only/demos/simplestories-v2-5m/media/simplestories-demo.png

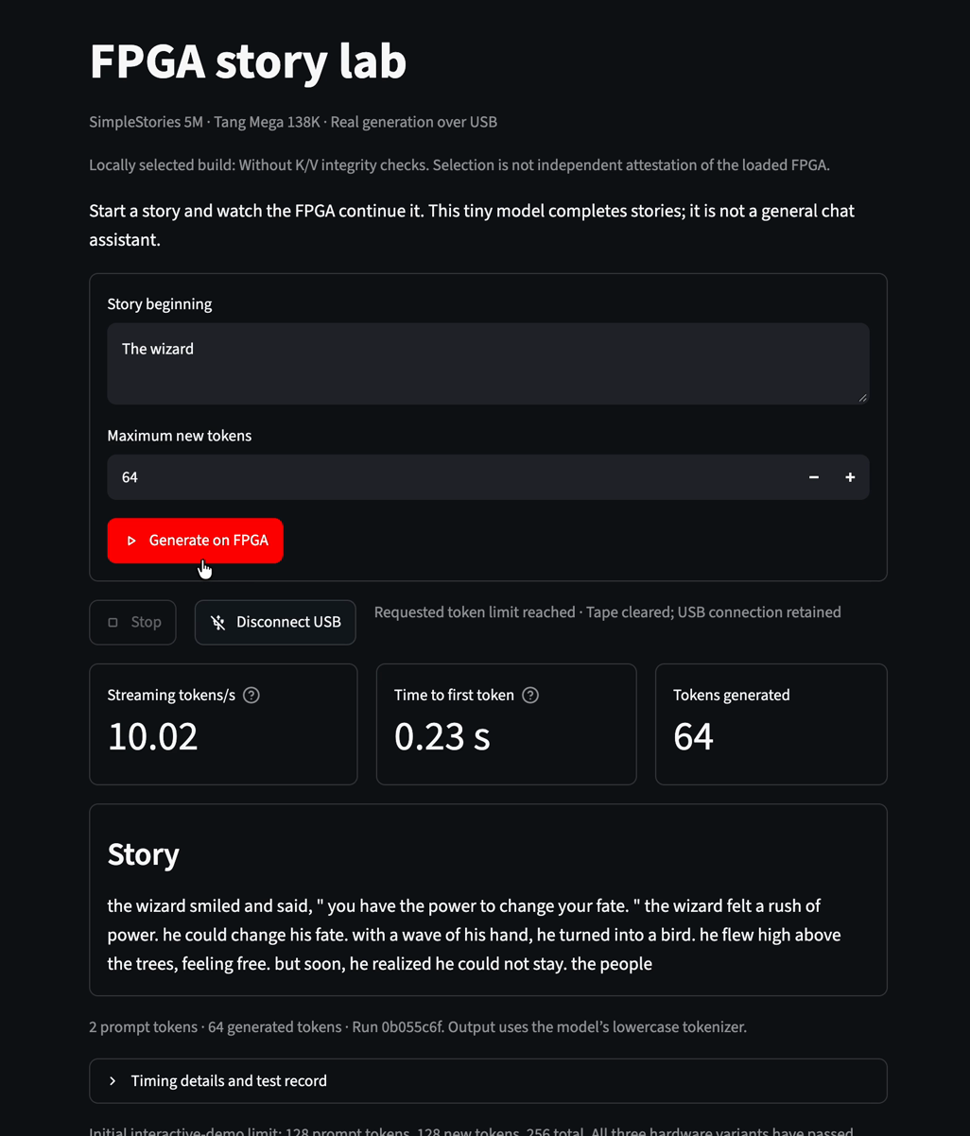
demos/simplestories-v2-5m/media/simplestories-demo.png
