Berkeley-AI-Risk/inference-only/diagrams/qwen-hardware-architecture.png

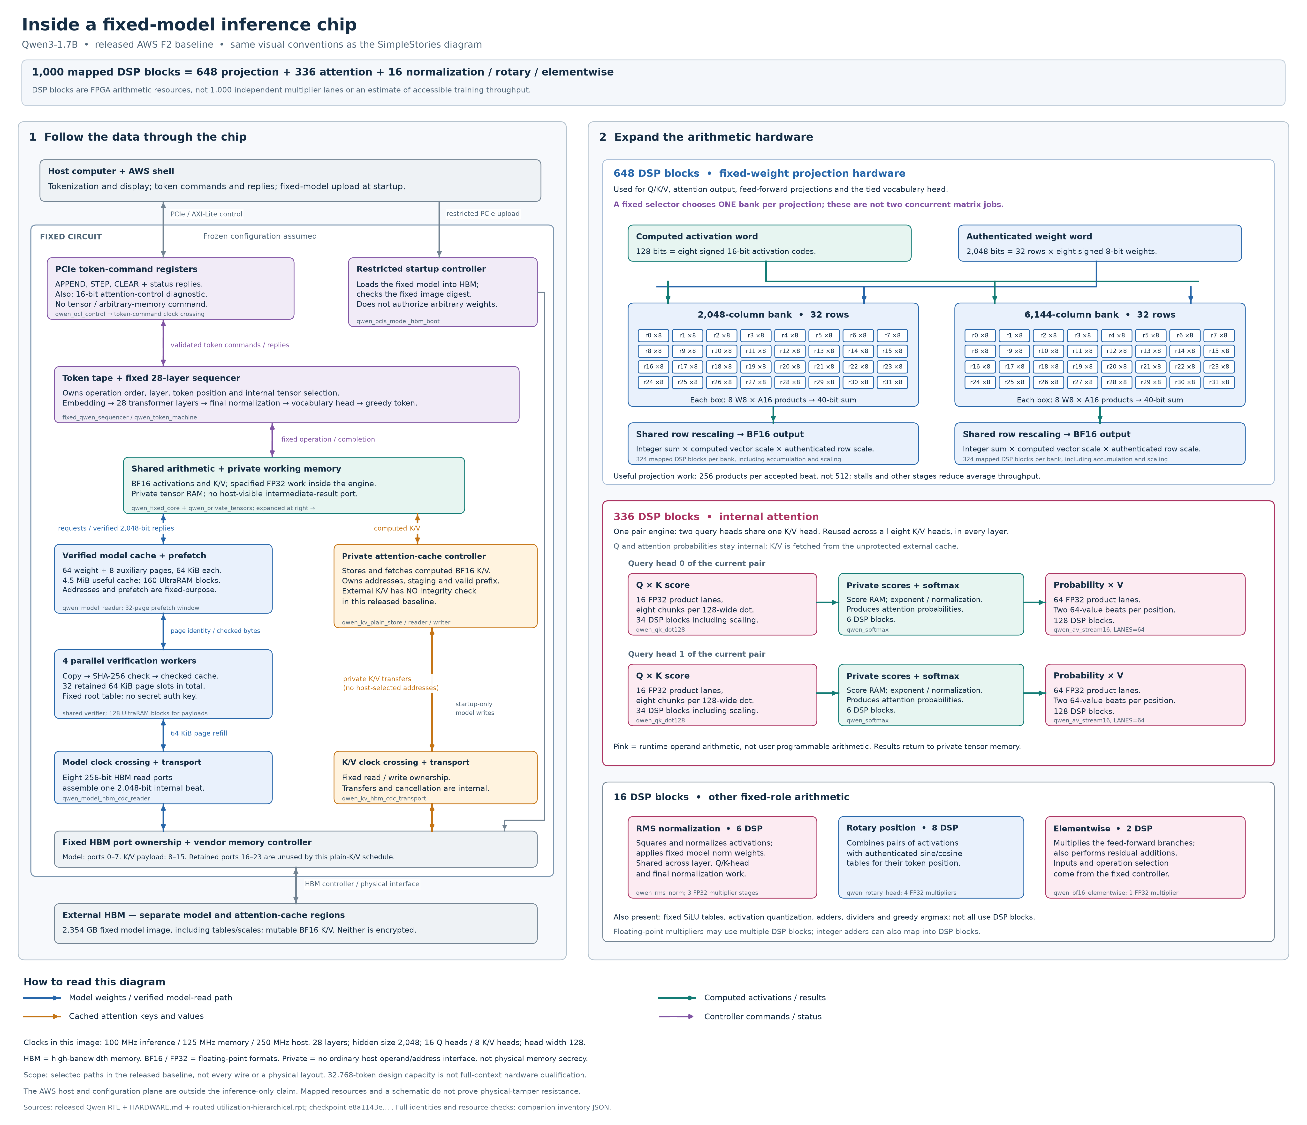
diagrams/qwen-hardware-architecture.png
