Berkeley-AI-Risk/inference-only/diagrams/simplestories-hardware-architecture.png

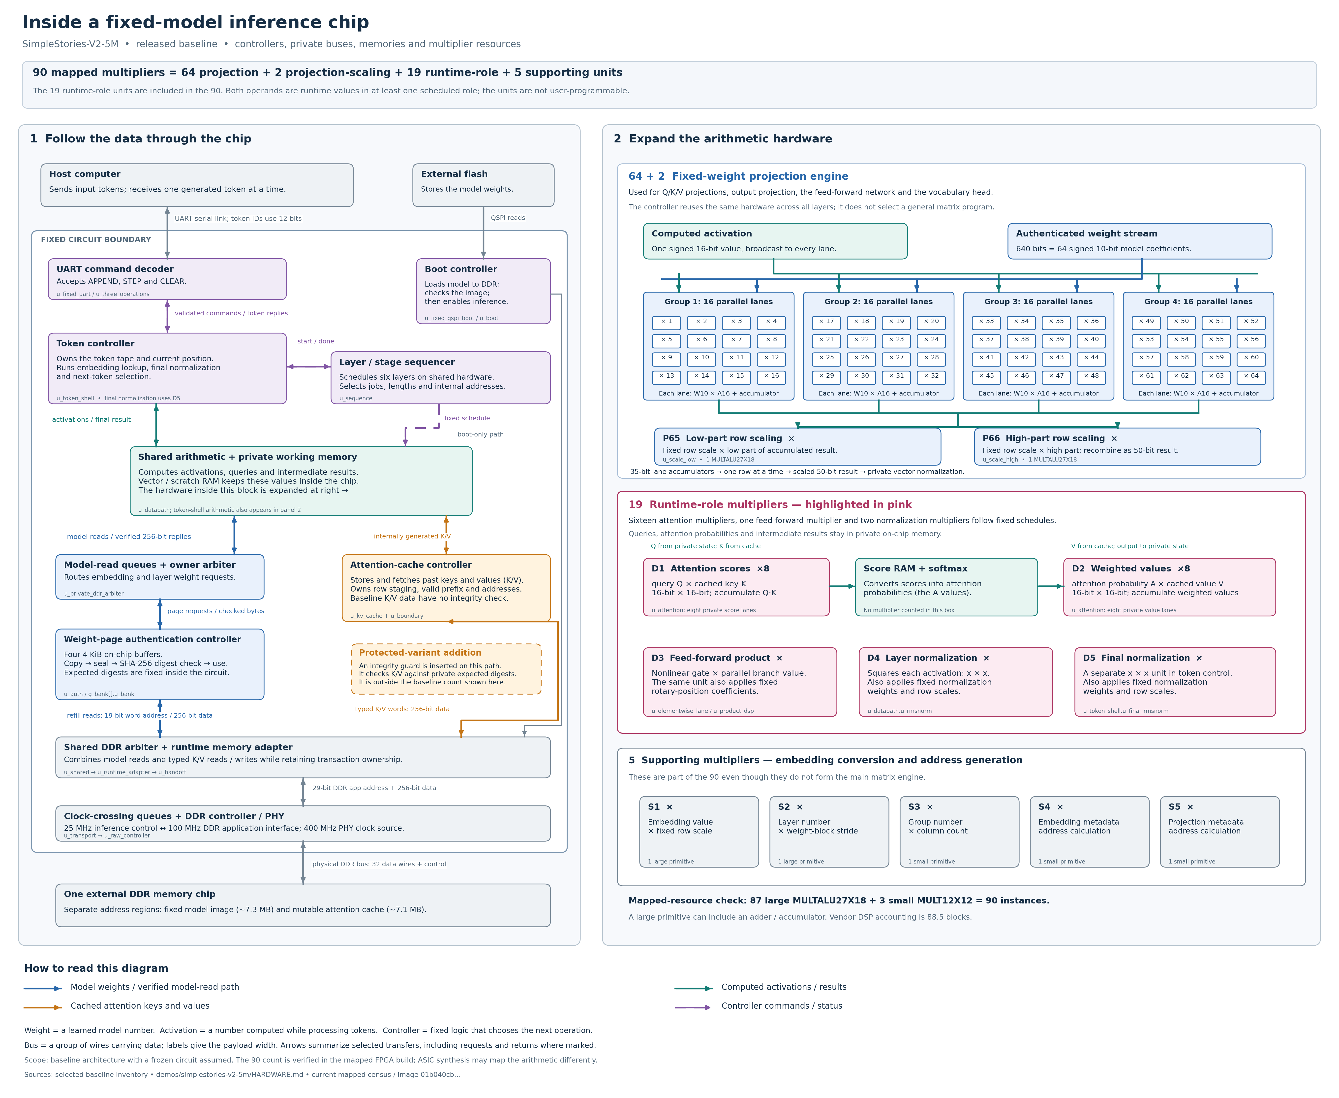
diagrams/simplestories-hardware-architecture.png
