Berkeley-AI-Risk/inference-only/docs/figures/awic-dark.png

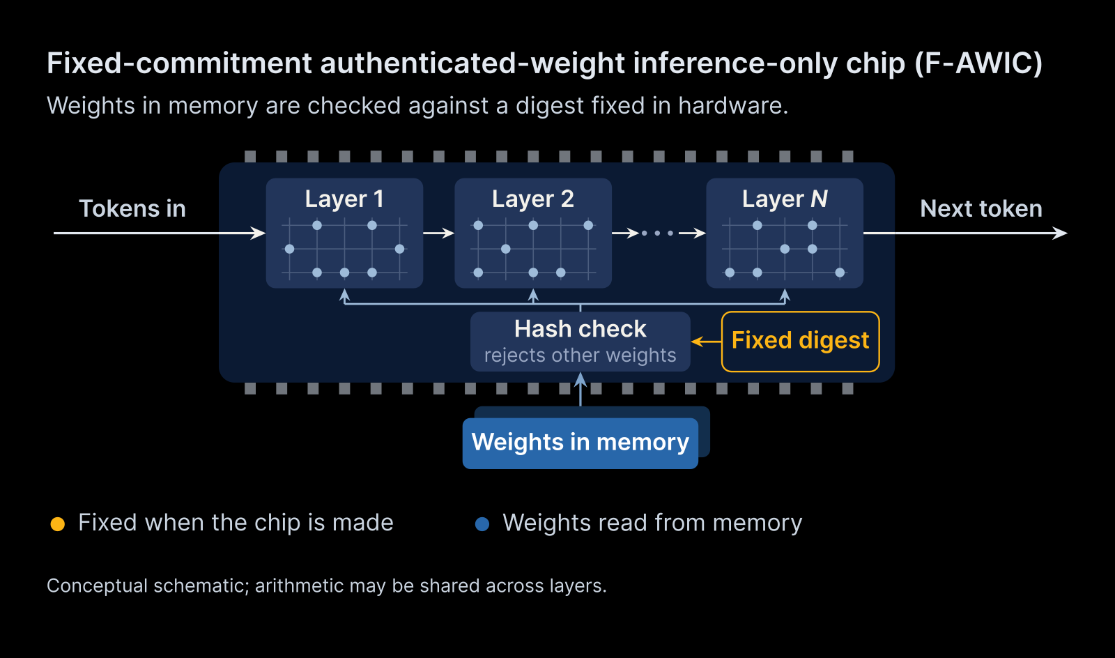
docs/figures/awic-dark.png
