Berkeley-AI-Risk/inference-only/docs/figures/awic.png

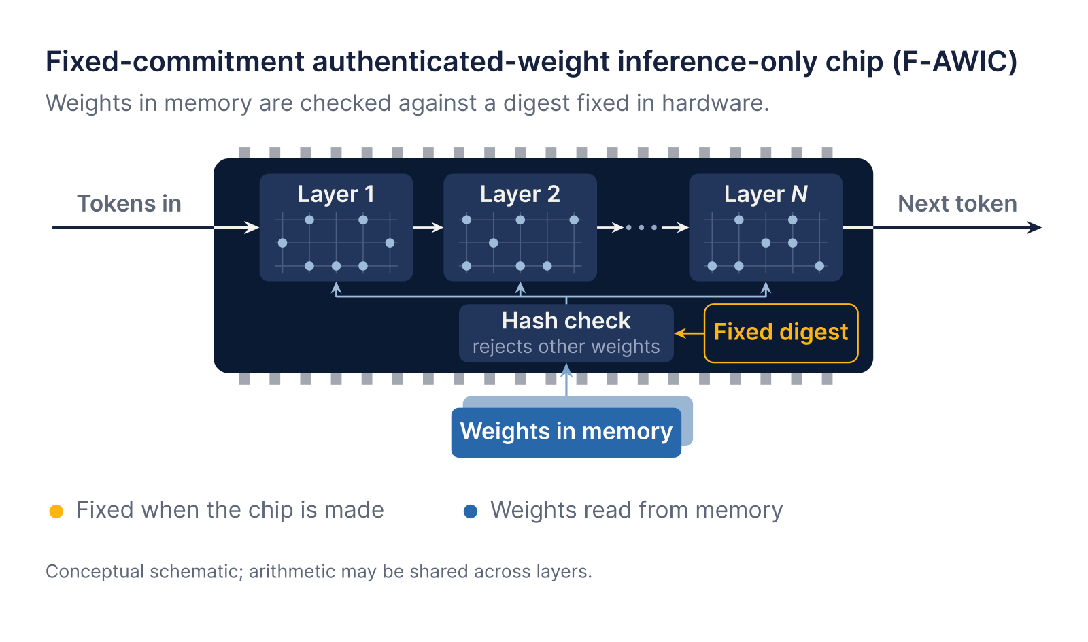
docs/figures/awic.png
