Berkeley-AI-Risk/inference-only/docs/figures/hwic-awic-dark.png

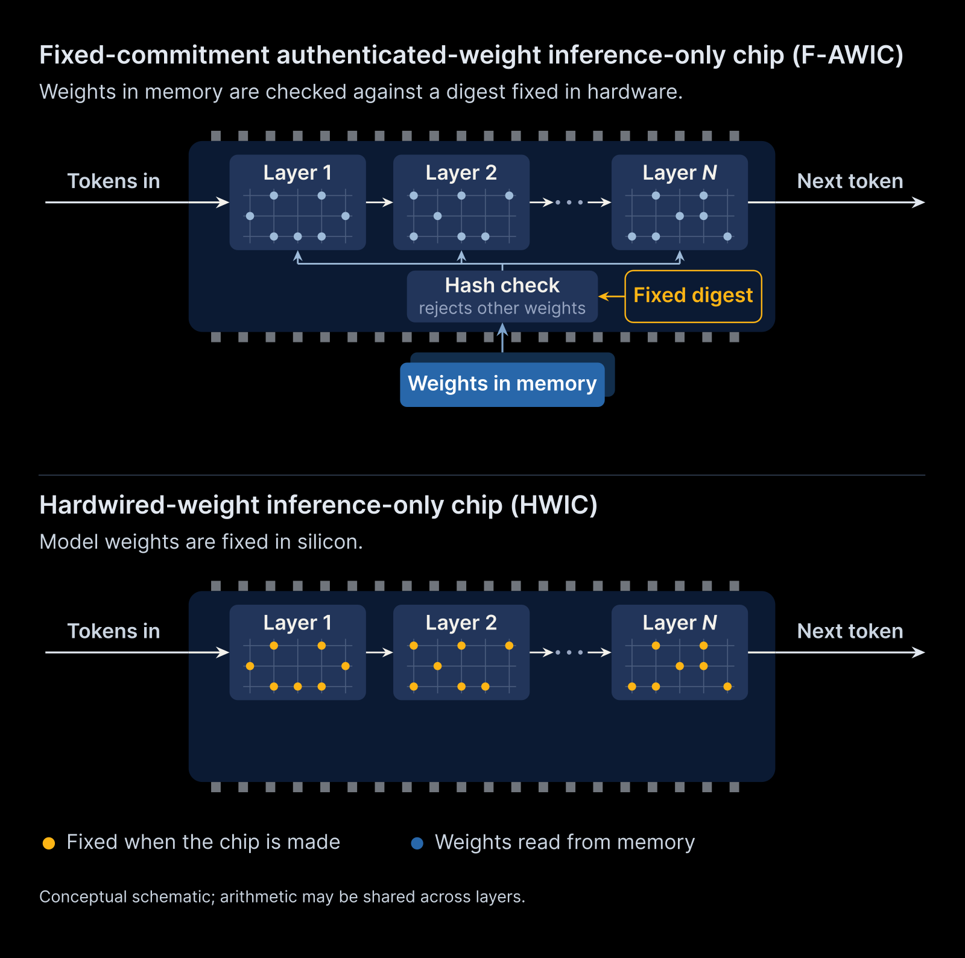
docs/figures/hwic-awic-dark.png
