Berkeley-AI-Risk/inference-only/docs/figures/hwic-awic.png

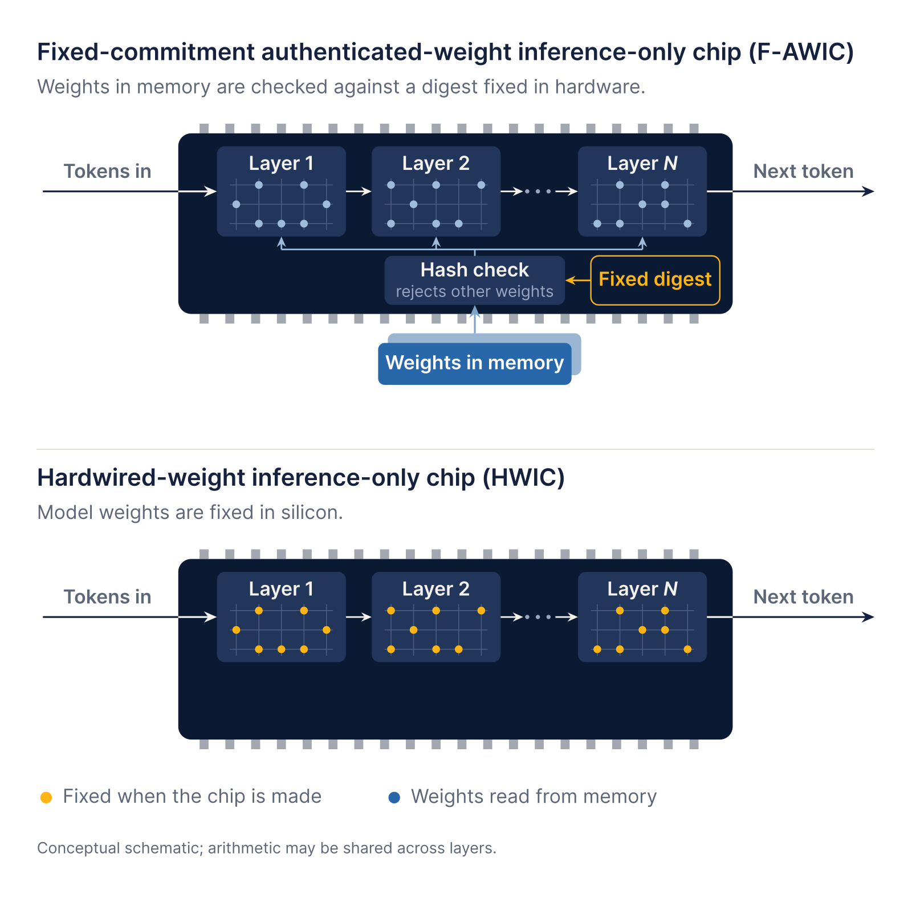
docs/figures/hwic-awic.png
