Berkeley-AI-Risk/inference-only/docs/figures/hwic-dark.png

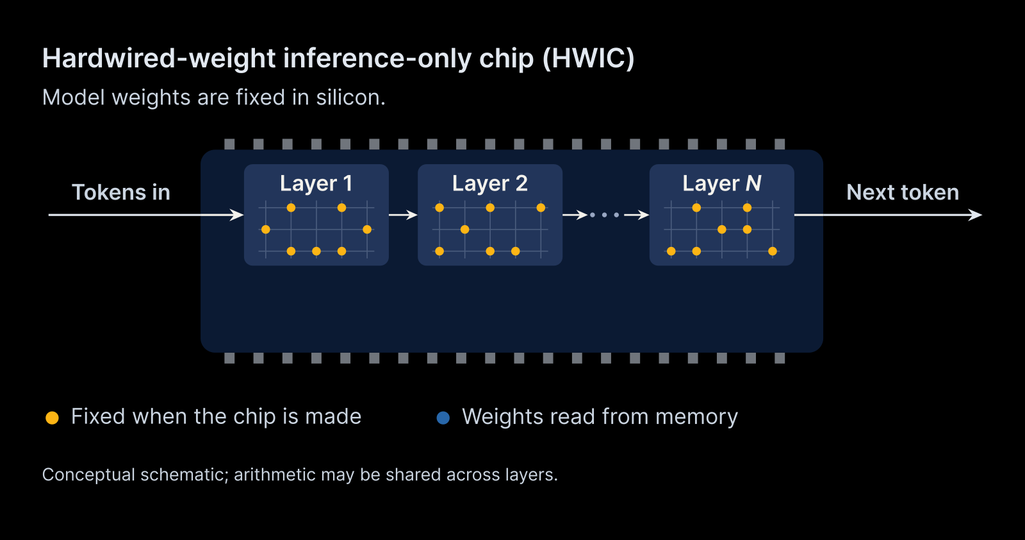
docs/figures/hwic-dark.png
