Berkeley-AI-Risk/inference-only/docs/figures/hwic.png

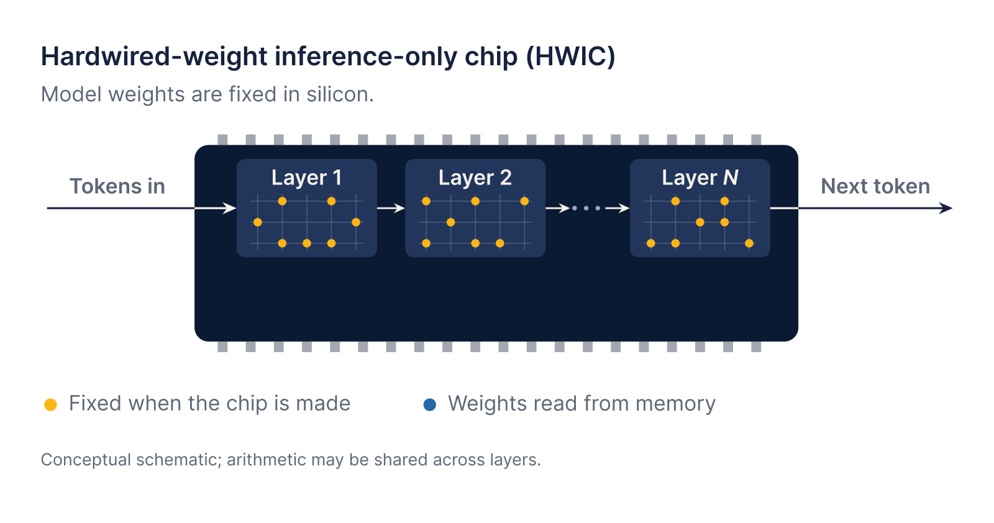
docs/figures/hwic.png
