Berkeley-AI-Risk/inference-only/docs/figures/inference-only-chips-dark.png

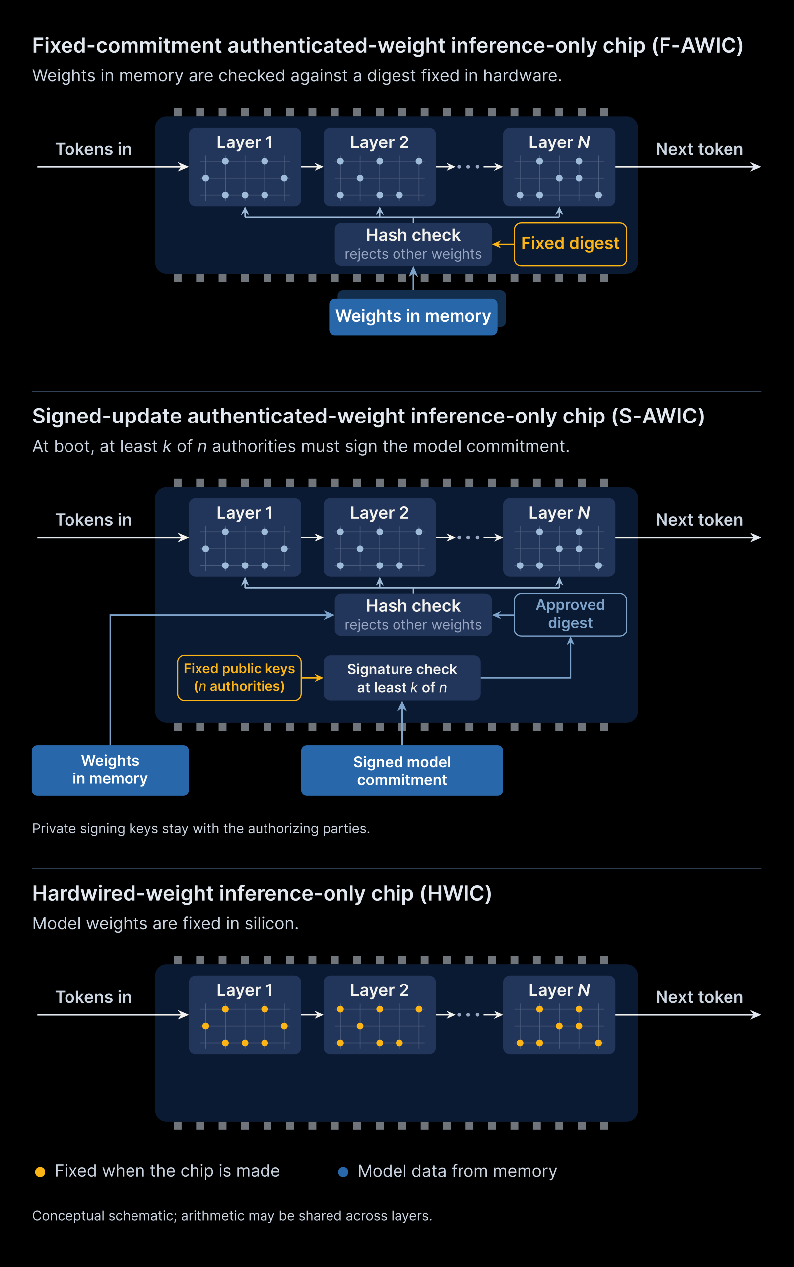
docs/figures/inference-only-chips-dark.png
