Berkeley-AI-Risk/inference-only/docs/figures/inference-only-chips.png

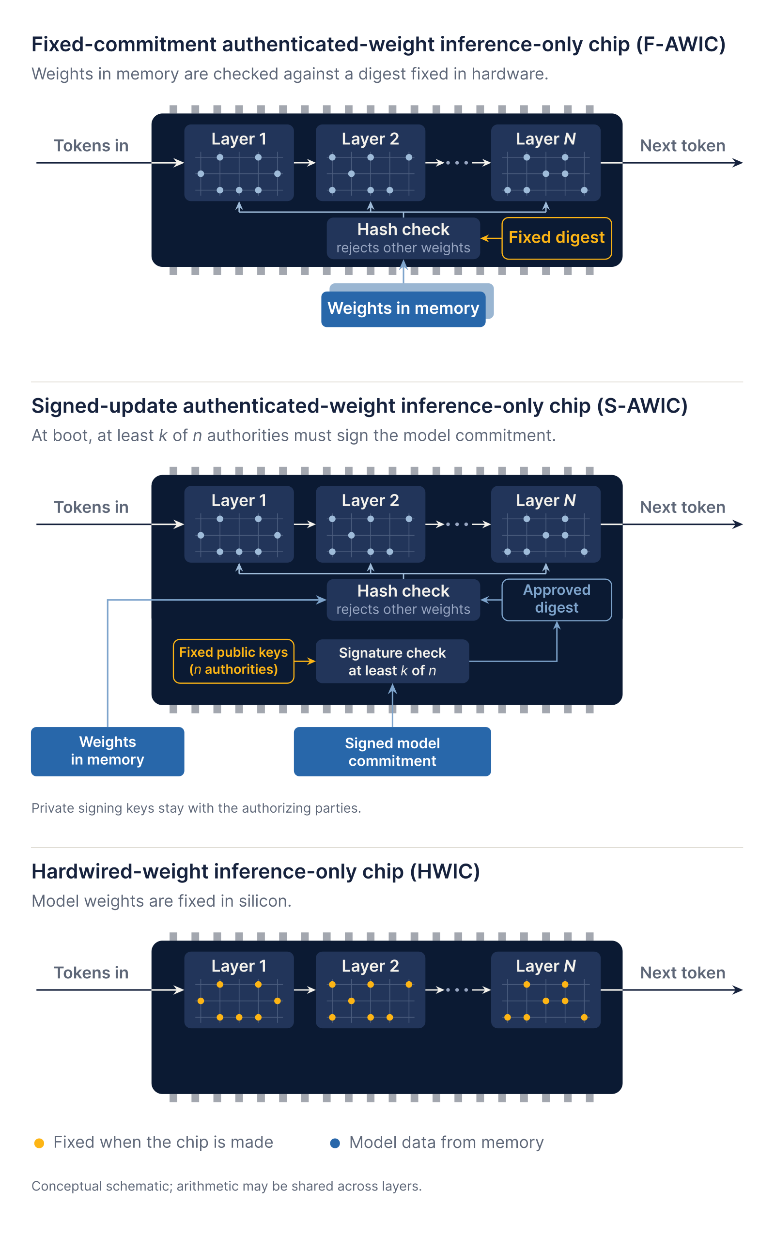
docs/figures/inference-only-chips.png
