Berkeley-AI-Risk/inference-only/docs/figures/s-awic-dark.png

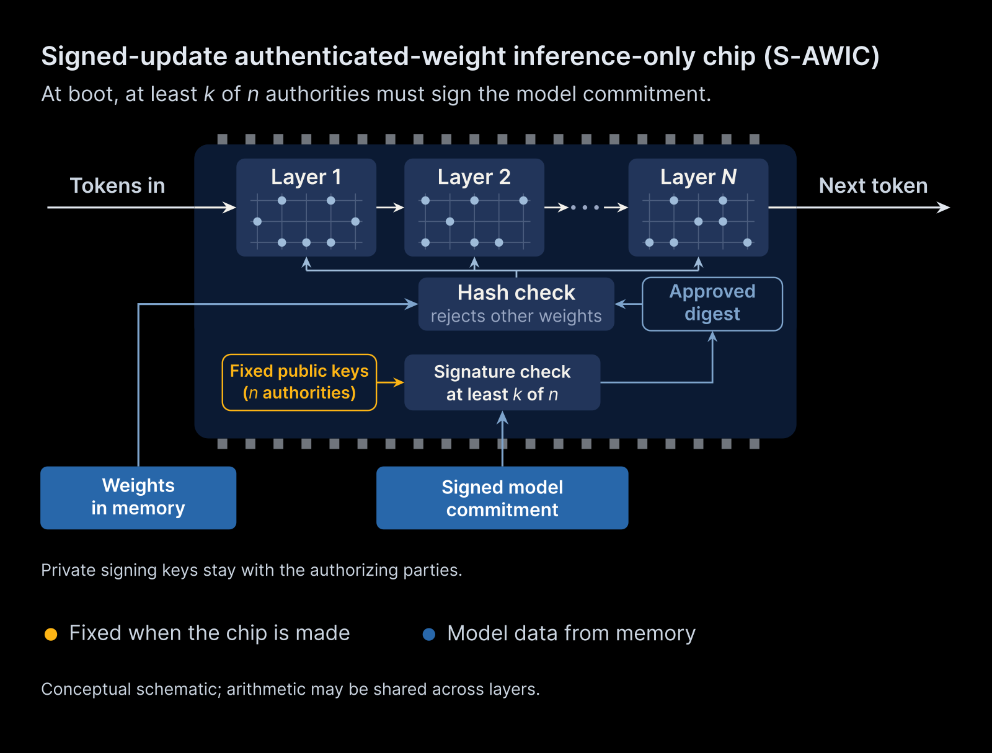
docs/figures/s-awic-dark.png
