Berkeley-AI-Risk/inference-only/docs/figures/s-awic.png

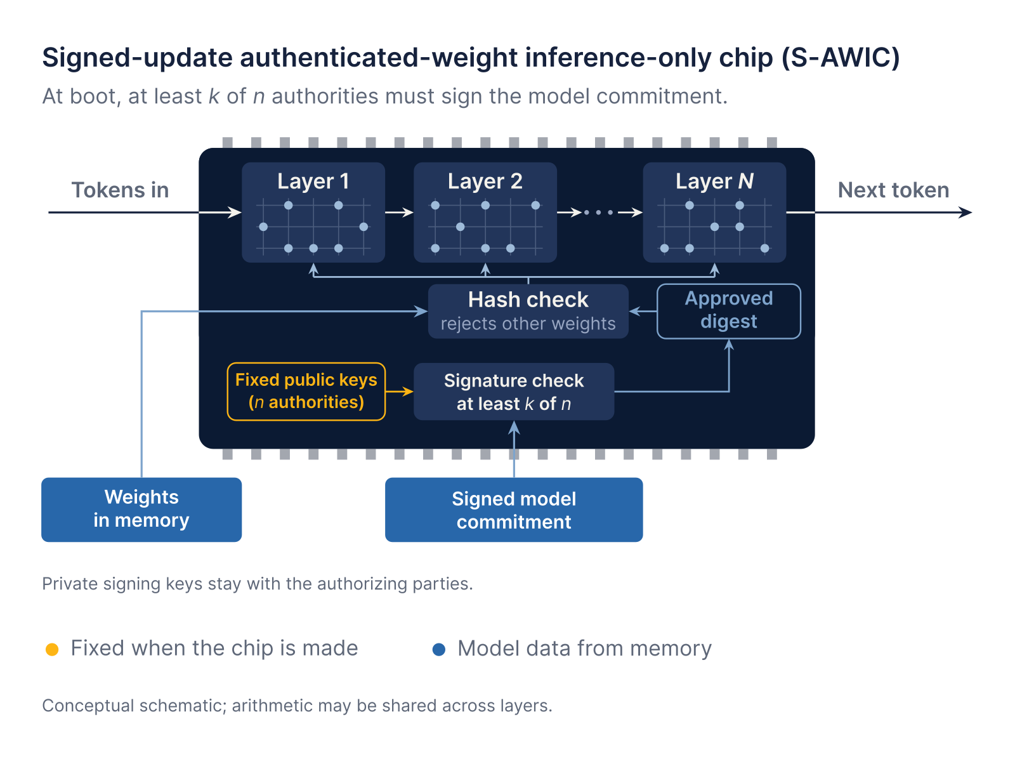
docs/figures/s-awic.png
