Berkeley-AI-Risk/inference-only/demos/simplestories-v2-5m/variants/signed-update/tang/evidence/native-build/swic_product.rpt.html

- PnR Messages
- PnR Details
- Resource
  - Resource Usage Summary
  - I/O Bank Usage Summary
  - Clock Resource Usage Summary
  - Global Clock Signals
  - Pinout by Port Name
  - All Package Pins

# PnR Messages

Report Title | PnR Report
Design File | LOCAL_BUILD/swic-tang-native-z6b9e5us/project/impl/gwsynthesis/swic_product.vg
Physical Constraints File | LOCAL_BUILD/swic-tang-native-z6b9e5us/project/constraints/board1_fixed_product.cst
Timing Constraints File | LOCAL_BUILD/swic-tang-native-z6b9e5us/project/constraints/product.sdc
Tool Version | V1.9.11.03 Education
Part Number | GW5AST-LV138PG484AC1/I0
Device | GW5AST-138
Device Version | C
Created Time | Tue Nov 3 19:47:00 2026
Legal Announcement | Copyright (C)2014-2025 Gowin Semiconductor Corporation. All rights reserved.

# PnR Details

Place & Route Process

Running placement: Placement Phase 0: CPU time = 0h 1m 33s, Elapsed time = 0h 1m 44s Placement Phase 1: CPU time = 0h 0m 40s, Elapsed time = 0h 0m 41s Placement Phase 2: CPU time = 0h 11m 31s, Elapsed time = 0h 11m 59s Placement Phase 3: CPU time = 0h 8m 20s, Elapsed time = 0h 9m 34s Total Placement: CPU time = 0h 22m 3s, Elapsed time = 0h 23m 59s Running routing: Routing Phase 0: CPU time = 0h 0m 1s, Elapsed time = 0h 0m 1s Routing Phase 1: CPU time = 0h 14m 19s, Elapsed time = 0h 15m 56s Routing Phase 2: CPU time = 0h 0m 3s, Elapsed time = 0h 0m 3s Routing Phase 3: CPU time = 0h 0m 0s, Elapsed time = 0h 0m 0s Total Routing: CPU time = 0h 14m 23s, Elapsed time = 0h 16m 0s Generate output files: CPU time = 0h 0m 27s, Elapsed time = 0h 0m 29s
Total Time and Memory Usage | CPU time = 0h 36m 53s, Elapsed time = 0h 40m 28s, Peak memory usage = 2870MB

# Resource

## Resource Usage Summary:

Resource | Usage | Utilization
Logic | 98848/138240 | 72%
--LUT,ALU,ROM16 | 92050(78600 LUT, 13450 ALU, 0 ROM16) | -
--SSRAM(RAM16) | 1133 | -
Register | 55877/139095 | 41%
--Logic Register as Latch | 0/138240 | 0%
--Logic Register as FF | 55877/138240 | 41%
--I/O Register as Latch | 0/855 | 0%
--I/O Register as FF | 0/855 | 0%
CLS | 59415/69120 | 86%
I/O Port | 81/297 | 28%
I/O Buf | 76 | -
--Input Buf | 3 | -
--Output Buf | 36 | -
--Inout Buf | 37 | -
IOLOGIC | 32 IDES8_MEM 25 OSER8 40 OSER8_MEM 32 IODELAY | 35%
BSRAM | 219 SDPB 19 SDPX9B 8 pROM | 73%
DSP | 4 MULT12X12 89 MULTALU27X18 | 31%

## I/O Bank Usage Summary:

I/O Bank | Usage | Utilization
bank 2 | 0/50 | 0%
bank 3 | 0/50 | 0%
bank 4 | 6/50 | 12%
bank 5 | 2/35 | 6%
bank 6 | 44/50 | 88%
bank 7 | 28/50 | 56%
bank 10 | 1/12 | 9%

## Clock Resource Usage Summary:

Clock Resource | Usage | Utilization
PRIMARY | 8/8 | 100%
LW | 8/8 | 100%
GCLK_PIN | 8/24 | 34%
CLKDIV | 3/24 | 13%
DDRDLL | 1/4 | 25%
DQS | 4/23 | 18%
PLL | 1/12 | 9%

## Global Clock Signals:

Signal | Global Clock | Location
clk_50mhz_d | PRIMARY | PTR0 PBR0
trusted_clk | PRIMARY | PTR1 PBR0
core_clk | PRIMARY | PTR0 PTR1 PTR2 PTR3 PBR0 PBR1 PBR2 PBR3
app_clk | PRIMARY | PTR0 PBR0
u_signed_boot/u_admission/u_lms/n3559_7 | PRIMARY | PTR1 PTR2
u_uart_core/clear | PRIMARY | PTR1 PTR2 PTR3 PBR2 PBR3
u_uart_core/machine_release_q[1] | PRIMARY | PTR1 PTR2 PTR3 PBR1 PBR2 PBR3
u_uart_core/u_machine/u_machine_0/u_six_layers/u_datapath/u_projection/u_shared_engine/u_engine/issue_count_q[0] | PRIMARY | PTR3
core_release_q[2] | LW | -
app_release_q[2] | LW | -
core_release_q_301[2] | LW | -
u_raw_controller/u_ddr3/gw3_top/controller_ddr_reset | LW | -
u_uart_core/u_machine/app_runtime_release_q[2] | LW | -
u_uart_core/u_machine/u_machine_0/n1227_5 | LW | -
u_uart_core/u_machine/u_boundary/core_release_q_0[2] | LW | -
u_uart_core/u_machine/u_boundary/app_boundary_i/issue_q[2] | LW | -
u_raw_controller/pll_clkout1_50mhz | HCLK | BANK7_HCLK0 BANK7_HCLK1
u_raw_controller/memory_clk_400mhz | HCLK | BANK6_HCLK0 BANK7_HCLK3

## Pinout by Port Name:

Port Name | Diff Pair | Loc./Bank | Constraint | Dir. | Site | CFG | IO Type | Drive | Pull Mode | PCI Clamp | Hysteresis | Open Drain | Vref | Single Resistor | Diff Resistor | BankVccio | Pull Strength | Ctle
clk_50mhz | - | V22/4 | Y | in | IOB104[B] | EMCCLK | LVCMOS33 | OFF | NONE | OFF | ON | OFF | OFF | OFF | OFF | 3.3 | MEDIUM | NONE
reset_button | - | F4/7 | Y | in | IOL1[A] | - | LVCMOS15 | OFF | DOWN | OFF | ON | OFF | OFF | OFF | OFF | 1.5 | MEDIUM | NONE
uart_rx | - | V14/5 | Y | in | IOB66[B] | MGCLKC_7/BPLL0_C_FB0/BPLL1_C_FB0 | LVCMOS33 | OFF | UP | OFF | ON | OFF | OFF | OFF | OFF | 3.3 | MEDIUM | NONE
uart_tx | - | U15/5 | Y | out | IOB68[A] | SGCLKT_7/BPLL0_T_FB1/BPLL1_T_FB1 | LVCMOS33 | 8 | UP | OFF | OFF | OFF | OFF | OFF | OFF | 3.3 | MEDIUM | NONE
flash_csn | - | T19/4 | Y | out | IOB102[A] | MCS_N | LVCMOS33 | 8 | UP | OFF | OFF | OFF | OFF | OFF | OFF | 3.3 | MEDIUM | NONE
flash_sclk | - | L12/10 | Y | out | IOB175[B] | CCLK | LVCMOS33 | 8 | NONE | OFF | OFF | OFF | OFF | OFF | OFF | 3.3 | MEDIUM | NONE
ddr_addr[0] | - | M1/7 | Y | out | IOL35[A] | - | SSTL15 | 8 | NONE | OFF | OFF | OFF | OFF | OFF | OFF | 1.5 | MEDIUM | NONE
ddr_addr[1] | - | K2/7 | Y | out | IOL22[A] | - | SSTL15 | 8 | NONE | OFF | OFF | OFF | OFF | OFF | OFF | 1.5 | MEDIUM | NONE
ddr_addr[2] | - | G2/7 | Y | out | IOL17[B] | - | SSTL15 | 8 | NONE | OFF | OFF | OFF | OFF | OFF | OFF | 1.5 | MEDIUM | NONE
ddr_addr[3] | - | J4/7 | Y | out | IOL29[B] | MGCLKC_10/LPLL0_C_FB1/LPLL1_C_FB1 | SSTL15 | 8 | NONE | OFF | OFF | OFF | OFF | OFF | OFF | 1.5 | MEDIUM | NONE
ddr_addr[4] | - | J2/7 | Y | out | IOL22[B] | - | SSTL15 | 8 | NONE | OFF | OFF | OFF | OFF | OFF | OFF | 1.5 | MEDIUM | NONE
ddr_addr[5] | - | H2/7 | Y | out | IOL17[A] | - | SSTL15 | 8 | NONE | OFF | OFF | OFF | OFF | OFF | OFF | 1.5 | MEDIUM | NONE
ddr_addr[6] | - | G3/7 | Y | out | IOL26[B] | SGCLKC_11/LPLL0_C_IN0/LPLL1_C_IN0 | SSTL15 | 8 | NONE | OFF | OFF | OFF | OFF | OFF | OFF | 1.5 | MEDIUM | NONE
ddr_addr[7] | - | J1/7 | Y | out | IOL15[B] | - | SSTL15 | 8 | NONE | OFF | OFF | OFF | OFF | OFF | OFF | 1.5 | MEDIUM | NONE
ddr_addr[8] | - | J5/7 | Y | out | IOL20[A] | - | SSTL15 | 8 | NONE | OFF | OFF | OFF | OFF | OFF | OFF | 1.5 | MEDIUM | NONE
ddr_addr[9] | - | H5/7 | Y | out | IOL20[B] | - | SSTL15 | 8 | NONE | OFF | OFF | OFF | OFF | OFF | OFF | 1.5 | MEDIUM | NONE
ddr_addr[10] | - | L1/7 | Y | out | IOL35[B] | - | SSTL15 | 8 | NONE | OFF | OFF | OFF | OFF | OFF | OFF | 1.5 | MEDIUM | NONE
ddr_addr[11] | - | H3/7 | Y | out | IOL26[A] | SGCLKT_11/LPLL0_T_IN0/LPLL1_T_IN0 | SSTL15 | 8 | NONE | OFF | OFF | OFF | OFF | OFF | OFF | 1.5 | MEDIUM | NONE
ddr_addr[12] | - | K4/7 | Y | out | IOL29[A] | MGCLKT_10/LPLL0_T_FB1/LPLL1_T_FB1 | SSTL15 | 8 | NONE | OFF | OFF | OFF | OFF | OFF | OFF | 1.5 | MEDIUM | NONE
ddr_addr[13] | - | K1/7 | Y | out | IOL15[A] | - | SSTL15 | 8 | NONE | OFF | OFF | OFF | OFF | OFF | OFF | 1.5 | MEDIUM | NONE
ddr_addr[14] | - | D1/7 | Y | out | IOL4[B] | - | SSTL15 | 8 | NONE | OFF | OFF | OFF | OFF | OFF | OFF | 1.5 | MEDIUM | NONE
ddr_bank[0] | - | P5/7 | Y | out | IOL49[A] | - | SSTL15 | 8 | NONE | OFF | OFF | OFF | OFF | OFF | OFF | 1.5 | MEDIUM | NONE
ddr_bank[1] | - | P2/7 | Y | out | IOL47[A] | - | SSTL15 | 8 | NONE | OFF | OFF | OFF | OFF | OFF | OFF | 1.5 | MEDIUM | NONE
ddr_bank[2] | - | M6/7 | Y | out | IOL51[A] | - | SSTL15 | 8 | NONE | OFF | OFF | OFF | OFF | OFF | OFF | 1.5 | MEDIUM | NONE
ddr_cs | - | P4/7 | Y | out | IOL49[B] | - | SSTL15 | 8 | NONE | OFF | OFF | OFF | OFF | OFF | OFF | 1.5 | MEDIUM | NONE
ddr_ras | - | L5/7 | Y | out | IOL40[A] | - | SSTL15 | 8 | NONE | OFF | OFF | OFF | OFF | OFF | OFF | 1.5 | MEDIUM | NONE
ddr_cas | - | L4/7 | Y | out | IOL40[B] | - | SSTL15 | 8 | NONE | OFF | OFF | OFF | OFF | OFF | OFF | 1.5 | MEDIUM | NONE
ddr_we | - | M5/7 | Y | out | IOL51[B] | - | SSTL15 | 8 | NONE | OFF | OFF | OFF | OFF | OFF | OFF | 1.5 | MEDIUM | NONE
ddr_ck | ddr_ck_n | L3,K3/7 | Y | out | IOL31 | SGCLKT_10/LPLL0_T_FB0/LPLL1_T_FB0 | SSTL15D | 8 | NONE | OFF | OFF | OFF | OFF | OFF | OFF | 1.5 | MEDIUM | NONE
ddr_cke | - | K6/7 | Y | out | IOL38[A] | - | SSTL15 | 8 | NONE | OFF | OFF | OFF | OFF | OFF | OFF | 1.5 | MEDIUM | NONE
ddr_odt | - | M2/7 | Y | out | IOL33[B] | CLKTEST_L0 | SSTL15 | 8 | NONE | OFF | OFF | OFF | OFF | OFF | OFF | 1.5 | MEDIUM | NONE
ddr_reset_n | - | L6/7 | Y | out | IOL55[A] | - | SSTL15 | 8 | NONE | OFF | OFF | OFF | OFF | OFF | OFF | 1.5 | MEDIUM | NONE
ddr_dm[0] | - | AA4/6 | Y | out | IOL78[B] | SGCLKC_8/LPLL2_C_IN0/LPLL3_C_IN0 | SSTL15 | 8 | NONE | OFF | OFF | OFF | OFF | OFF | OFF | 1.5 | MEDIUM | NONE
ddr_dm[1] | - | V7/6 | Y | out | IOL107[A] | MCKTEST | SSTL15 | 8 | NONE | OFF | OFF | OFF | OFF | OFF | OFF | 1.5 | MEDIUM | NONE
ddr_dm[2] | - | T6/6 | Y | out | IOL89[B] | - | SSTL15 | 8 | NONE | OFF | OFF | OFF | OFF | OFF | OFF | 1.5 | MEDIUM | NONE
ddr_dm[3] | - | W1/6 | Y | out | IOL67[A] | - | SSTL15 | 8 | NONE | OFF | OFF | OFF | OFF | OFF | OFF | 1.5 | MEDIUM | NONE
flash_dq[0] | - | P22/4 | Y | io | IOB93[A] | D00/MOSI | LVCMOS33 | 8 | UP | OFF | OFF | OFF | OFF | OFF | OFF | 3.3 | MEDIUM | NONE
flash_dq[1] | - | R22/4 | Y | io | IOB93[B] | D01/DIN | LVCMOS33 | 8 | UP | OFF | OFF | OFF | OFF | OFF | OFF | 3.3 | MEDIUM | NONE
flash_dq[2] | - | P21/4 | Y | io | IOB95[A] | D02 | LVCMOS33 | 8 | UP | OFF | OFF | OFF | OFF | OFF | OFF | 3.3 | MEDIUM | NONE
flash_dq[3] | - | R21/4 | Y | io | IOB95[B] | D03 | LVCMOS33 | 8 | UP | OFF | OFF | OFF | OFF | OFF | OFF | 3.3 | MEDIUM | NONE
ddr_dq[0] | - | Y4/6 | Y | io | IOL78[A] | SGCLKT_8/LPLL2_T_IN0/LPLL3_T_IN0 | SSTL15 | 8 | NONE | OFF | NONE | OFF | INTERNAL | OFF | OFF | 1.5 | MEDIUM | OFF
ddr_dq[1] | - | AB3/6 | Y | io | IOL74[A] | - | SSTL15 | 8 | NONE | OFF | NONE | OFF | INTERNAL | OFF | OFF | 1.5 | MEDIUM | OFF
ddr_dq[2] | - | AA5/6 | Y | io | IOL76[A] | - | SSTL15 | 8 | NONE | OFF | NONE | OFF | INTERNAL | OFF | OFF | 1.5 | MEDIUM | OFF
ddr_dq[3] | - | V4/6 | Y | io | IOL80[A] | MGCLKT_8/LPLL2_T_IN1/LPLL3_T_IN1 | SSTL15 | 8 | NONE | OFF | NONE | OFF | INTERNAL | OFF | OFF | 1.5 | MEDIUM | OFF
ddr_dq[4] | - | AA1/6 | Y | io | IOL71[A] | - | SSTL15 | 8 | NONE | OFF | NONE | OFF | INTERNAL | OFF | OFF | 1.5 | MEDIUM | OFF
ddr_dq[5] | - | AB2/6 | Y | io | IOL74[B] | - | SSTL15 | 8 | NONE | OFF | NONE | OFF | INTERNAL | OFF | OFF | 1.5 | MEDIUM | OFF
ddr_dq[6] | - | AB5/6 | Y | io | IOL76[B] | - | SSTL15 | 8 | NONE | OFF | NONE | OFF | INTERNAL | OFF | OFF | 1.5 | MEDIUM | OFF
ddr_dq[7] | - | AB1/6 | Y | io | IOL71[B] | - | SSTL15 | 8 | NONE | OFF | NONE | OFF | INTERNAL | OFF | OFF | 1.5 | MEDIUM | OFF
ddr_dq[8] | - | AA8/6 | Y | io | IOL101[A] | - | SSTL15 | 8 | NONE | OFF | NONE | OFF | INTERNAL | OFF | OFF | 1.5 | MEDIUM | OFF
ddr_dq[9] | - | Y8/6 | Y | io | IOL103[A] | - | SSTL15 | 8 | NONE | OFF | NONE | OFF | INTERNAL | OFF | OFF | 1.5 | MEDIUM | OFF
ddr_dq[10] | - | AB7/6 | Y | io | IOL98[A] | - | SSTL15 | 8 | NONE | OFF | NONE | OFF | INTERNAL | OFF | OFF | 1.5 | MEDIUM | OFF
ddr_dq[11] | - | Y7/6 | Y | io | IOL103[B] | - | SSTL15 | 8 | NONE | OFF | NONE | OFF | INTERNAL | OFF | OFF | 1.5 | MEDIUM | OFF
ddr_dq[12] | - | AB8/6 | Y | io | IOL101[B] | - | SSTL15 | 8 | NONE | OFF | NONE | OFF | INTERNAL | OFF | OFF | 1.5 | MEDIUM | OFF
ddr_dq[13] | - | W9/6 | Y | io | IOL105[A] | - | SSTL15 | 8 | NONE | OFF | NONE | OFF | INTERNAL | OFF | OFF | 1.5 | MEDIUM | OFF
ddr_dq[14] | - | AB6/6 | Y | io | IOL98[B] | - | SSTL15 | 8 | NONE | OFF | NONE | OFF | INTERNAL | OFF | OFF | 1.5 | MEDIUM | OFF
ddr_dq[15] | - | Y9/6 | Y | io | IOL105[B] | - | SSTL15 | 8 | NONE | OFF | NONE | OFF | INTERNAL | OFF | OFF | 1.5 | MEDIUM | OFF
ddr_dq[16] | - | U5/6 | Y | io | IOL85[B] | SGCLKC_9/LPLL2_C_FB0/LPLL3_C_FB0 | SSTL15 | 8 | NONE | OFF | NONE | OFF | INTERNAL | OFF | OFF | 1.5 | MEDIUM | OFF
ddr_dq[17] | - | R6/6 | Y | io | IOL89[A] | - | SSTL15 | 8 | NONE | OFF | NONE | OFF | INTERNAL | OFF | OFF | 1.5 | MEDIUM | OFF
ddr_dq[18] | - | U6/6 | Y | io | IOL87[A] | - | SSTL15 | 8 | NONE | OFF | NONE | OFF | INTERNAL | OFF | OFF | 1.5 | MEDIUM | OFF
ddr_dq[19] | - | R4/6 | Y | io | IOL83[A] | MGCLKT_9/LPLL2_T_FB1/LPLL3_T_FB1 | SSTL15 | 8 | NONE | OFF | NONE | OFF | INTERNAL | OFF | OFF | 1.5 | MEDIUM | OFF
ddr_dq[20] | - | Y6/6 | Y | io | IOL92[A] | - | SSTL15 | 8 | NONE | OFF | NONE | OFF | INTERNAL | OFF | OFF | 1.5 | MEDIUM | OFF
ddr_dq[21] | - | T4/6 | Y | io | IOL83[B] | MGCLKC_9/LPLL2_C_FB1/LPLL3_C_FB1 | SSTL15 | 8 | NONE | OFF | NONE | OFF | INTERNAL | OFF | OFF | 1.5 | MEDIUM | OFF
ddr_dq[22] | - | V5/6 | Y | io | IOL87[B] | - | SSTL15 | 8 | NONE | OFF | NONE | OFF | INTERNAL | OFF | OFF | 1.5 | MEDIUM | OFF
ddr_dq[23] | - | T5/6 | Y | io | IOL85[A] | SGCLKT_9/LPLL2_T_FB0/LPLL3_T_FB0 | SSTL15 | 8 | NONE | OFF | NONE | OFF | INTERNAL | OFF | OFF | 1.5 | MEDIUM | OFF
ddr_dq[24] | - | W2/6 | Y | io | IOL62[A] | - | SSTL15 | 8 | NONE | OFF | NONE | OFF | INTERNAL | OFF | OFF | 1.5 | MEDIUM | OFF
ddr_dq[25] | - | Y1/6 | Y | io | IOL67[B] | - | SSTL15 | 8 | NONE | OFF | NONE | OFF | INTERNAL | OFF | OFF | 1.5 | MEDIUM | OFF
ddr_dq[26] | - | T1/6 | Y | io | IOL56[A] | - | SSTL15 | 8 | NONE | OFF | NONE | OFF | INTERNAL | OFF | OFF | 1.5 | MEDIUM | OFF
ddr_dq[27] | - | U3/6 | Y | io | IOL60[A] | - | SSTL15 | 8 | NONE | OFF | NONE | OFF | INTERNAL | OFF | OFF | 1.5 | MEDIUM | OFF
ddr_dq[28] | - | U2/6 | Y | io | IOL58[A] | - | SSTL15 | 8 | NONE | OFF | NONE | OFF | INTERNAL | OFF | OFF | 1.5 | MEDIUM | OFF
ddr_dq[29] | - | V2/6 | Y | io | IOL58[B] | - | SSTL15 | 8 | NONE | OFF | NONE | OFF | INTERNAL | OFF | OFF | 1.5 | MEDIUM | OFF
ddr_dq[30] | - | U1/6 | Y | io | IOL56[B] | - | SSTL15 | 8 | NONE | OFF | NONE | OFF | INTERNAL | OFF | OFF | 1.5 | MEDIUM | OFF
ddr_dq[31] | - | Y2/6 | Y | io | IOL62[B] | - | SSTL15 | 8 | NONE | OFF | NONE | OFF | INTERNAL | OFF | OFF | 1.5 | MEDIUM | OFF
ddr_dqs[0] | ddr_dqs_n[0] | Y3,AA3/6 | Y | io | IOL69 | - | SSTL15D | 8 | NONE | OFF | NONE | OFF | OFF | OFF | OFF | 1.5 | MEDIUM | OFF
ddr_dqs[1] | ddr_dqs_n[1] | V9,V8/6 | Y | io | IOL96 | - | SSTL15D | 8 | NONE | OFF | NONE | OFF | OFF | OFF | OFF | 1.5 | MEDIUM | OFF
ddr_dqs[2] | ddr_dqs_n[2] | W6,W5/6 | Y | io | IOL94 | - | SSTL15D | 8 | NONE | OFF | NONE | OFF | OFF | OFF | OFF | 1.5 | MEDIUM | OFF
ddr_dqs[3] | ddr_dqs_n[3] | R3,R2/6 | Y | io | IOL65 | - | SSTL15D | 8 | NONE | OFF | NONE | OFF | OFF | OFF | OFF | 1.5 | MEDIUM | OFF

## All Package Pins:

Loc./Bank | Signal | Dir. | Site | CFG | IO Type | Drive | Pull Mode | PCI Clamp | Hysteresis | Open Drain | Vref | Single Resistor | Diff Resistor | Bank Vccio | Pull Strength | Ctle
AB11/5 | - | in | IOB51[A] | - | LVCMOS33 | 8 | UP | OFF | ON | OFF | OFF | OFF | OFF | 3.3 | MEDIUM | NONE
AB12/5 | - | in | IOB51[B] | - | LVCMOS33 | 8 | UP | OFF | ON | OFF | OFF | OFF | OFF | 3.3 | MEDIUM | NONE
AA9/5 | - | in | IOB53[A] | - | LVCMOS33 | 8 | UP | OFF | ON | OFF | OFF | OFF | OFF | 3.3 | MEDIUM | NONE
AB10/5 | - | in | IOB53[B] | - | LVCMOS33 | 8 | UP | OFF | ON | OFF | OFF | OFF | OFF | 3.3 | MEDIUM | NONE
AA10/5 | - | in | IOB56[A] | - | LVCMOS33 | 8 | UP | OFF | ON | OFF | OFF | OFF | OFF | 3.3 | MEDIUM | NONE
AA11/5 | - | in | IOB56[B] | - | LVCMOS33 | 8 | UP | OFF | ON | OFF | OFF | OFF | OFF | 3.3 | MEDIUM | NONE
V10/5 | - | in | IOB58[A] | - | LVCMOS33 | 8 | UP | OFF | ON | OFF | OFF | OFF | OFF | 3.3 | MEDIUM | NONE
W10/5 | - | in | IOB58[B] | - | LVCMOS33 | 8 | UP | OFF | ON | OFF | OFF | OFF | OFF | 3.3 | MEDIUM | NONE
Y11/5 | - | in | IOB60[A] | SGCLKT_6/BPLL0_T_IN0/BPLL1_T_IN0 | LVCMOS33 | 8 | UP | OFF | ON | OFF | OFF | OFF | OFF | 3.3 | MEDIUM | NONE
Y12/5 | - | in | IOB60[B] | SGCLKC_6/BPLL0_C_IN0/BPLL1_C_IN0 | LVCMOS33 | 8 | UP | OFF | ON | OFF | OFF | OFF | OFF | 3.3 | MEDIUM | NONE
W11/5 | - | in | IOB62[A] | MGCLKT_6/BPLL0_T_IN1/BPLL1_T_IN1 | LVCMOS33 | 8 | UP | OFF | ON | OFF | OFF | OFF | OFF | 3.3 | MEDIUM | NONE
W12/5 | - | in | IOB62[B] | MGCLKC_6/BPLL0_C_IN1/BPLL1_C_IN1 | LVCMOS33 | 8 | UP | OFF | ON | OFF | OFF | OFF | OFF | 3.3 | MEDIUM | NONE
V13/5 | - | in | IOB66[A] | MGCLKT_7/BPLL0_T_FB0/BPLL1_T_FB0 | LVCMOS33 | 8 | UP | OFF | ON | OFF | OFF | OFF | OFF | 3.3 | MEDIUM | NONE
V14/5 | uart_rx | in | IOB66[B] | MGCLKC_7/BPLL0_C_FB0/BPLL1_C_FB0 | LVCMOS33 | OFF | UP | OFF | ON | OFF | OFF | OFF | OFF | 3.3 | MEDIUM | NONE
U15/5 | uart_tx | out | IOB68[A] | SGCLKT_7/BPLL0_T_FB1/BPLL1_T_FB1 | LVCMOS33 | 8 | UP | OFF | OFF | OFF | OFF | OFF | OFF | 3.3 | MEDIUM | NONE
V15/5 | - | in | IOB68[B] | SGCLKC_7/BPLL0_C_FB1/BPLL1_C_FB1 | LVCMOS33 | 8 | UP | OFF | ON | OFF | OFF | OFF | OFF | 3.3 | MEDIUM | NONE
T14/5 | - | in | IOB70[A] | - | LVCMOS33 | 8 | UP | OFF | ON | OFF | OFF | OFF | OFF | 3.3 | MEDIUM | NONE
T15/5 | - | in | IOB70[B] | - | LVCMOS33 | 8 | UP | OFF | ON | OFF | OFF | OFF | OFF | 3.3 | MEDIUM | NONE
W15/5 | - | in | IOB72[A] | - | LVCMOS33 | 8 | UP | OFF | ON | OFF | OFF | OFF | OFF | 3.3 | MEDIUM | NONE
W16/5 | - | in | IOB72[B] | - | LVCMOS33 | 8 | UP | OFF | ON | OFF | OFF | OFF | OFF | 3.3 | MEDIUM | NONE
T16/5 | - | in | IOB76[A] | - | LVCMOS33 | 8 | UP | OFF | ON | OFF | OFF | OFF | OFF | 3.3 | MEDIUM | NONE
U16/5 | - | in | IOB76[B] | - | LVCMOS33 | 8 | UP | OFF | ON | OFF | OFF | OFF | OFF | 3.3 | MEDIUM | NONE
Y16/5 | - | in | IOB78[A] | - | LVCMOS33 | 8 | UP | OFF | ON | OFF | OFF | OFF | OFF | 3.3 | MEDIUM | NONE
AA16/5 | - | in | IOB78[B] | - | LVCMOS33 | 8 | UP | OFF | ON | OFF | OFF | OFF | OFF | 3.3 | MEDIUM | NONE
AB16/5 | - | in | IOB80[A] | - | LVCMOS33 | 8 | UP | OFF | ON | OFF | OFF | OFF | OFF | 3.3 | MEDIUM | NONE
AB17/5 | - | in | IOB80[B] | - | LVCMOS33 | 8 | UP | OFF | ON | OFF | OFF | OFF | OFF | 3.3 | MEDIUM | NONE
AA15/5 | - | in | IOB83[A] | - | LVCMOS33 | 8 | UP | OFF | ON | OFF | OFF | OFF | OFF | 3.3 | MEDIUM | NONE
AB15/5 | - | in | IOB83[B] | - | LVCMOS33 | 8 | UP | OFF | ON | OFF | OFF | OFF | OFF | 3.3 | MEDIUM | NONE
W14/5 | - | in | IOB85[A] | - | LVCMOS33 | 8 | UP | OFF | ON | OFF | OFF | OFF | OFF | 3.3 | MEDIUM | NONE
Y14/5 | - | in | IOB85[B] | - | LVCMOS33 | 8 | UP | OFF | ON | OFF | OFF | OFF | OFF | 3.3 | MEDIUM | NONE
Y13/5 | - | in | IOB87[A] | - | LVCMOS33 | 8 | UP | OFF | ON | OFF | OFF | OFF | OFF | 3.3 | MEDIUM | NONE
AA14/5 | - | in | IOB87[B] | - | LVCMOS33 | 8 | UP | OFF | ON | OFF | OFF | OFF | OFF | 3.3 | MEDIUM | NONE
AA13/5 | - | in | IOB89[A] | - | LVCMOS33 | 8 | UP | OFF | ON | OFF | OFF | OFF | OFF | 3.3 | MEDIUM | NONE
AB13/5 | - | in | IOB89[B] | - | LVCMOS33 | 8 | UP | OFF | ON | OFF | OFF | OFF | OFF | 3.3 | MEDIUM | NONE
Y17/5 | - | in | IOB91[A] | - | LVCMOS33 | 8 | UP | OFF | ON | OFF | OFF | OFF | OFF | 3.3 | MEDIUM | NONE
P20/4 | - | in | IOB92[A] | - | LVCMOS33 | 8 | UP | OFF | ON | OFF | OFF | OFF | OFF | 3.3 | MEDIUM | NONE
P22/4 | flash_dq[0] | out | IOB93[A] | D00/MOSI | LVCMOS33 | 8 | UP | OFF | OFF | OFF | OFF | OFF | OFF | 3.3 | MEDIUM | NONE
R22/4 | flash_dq[1] | io | IOB93[B] | D01/DIN | LVCMOS33 | 8 | UP | OFF | OFF | OFF | OFF | OFF | OFF | 3.3 | MEDIUM | NONE
P21/4 | flash_dq[2] | out | IOB95[A] | D02 | LVCMOS33 | 8 | UP | OFF | OFF | OFF | OFF | OFF | OFF | 3.3 | MEDIUM | NONE
R21/4 | flash_dq[3] | out | IOB95[B] | D03 | LVCMOS33 | 8 | UP | OFF | OFF | OFF | OFF | OFF | OFF | 3.3 | MEDIUM | NONE
T21/4 | - | in | IOB97[A] | D04 | LVCMOS33 | 8 | UP | OFF | ON | OFF | OFF | OFF | OFF | 3.3 | MEDIUM | NONE
U21/4 | - | in | IOB97[B] | D05/SI | LVCMOS33 | 8 | UP | OFF | ON | OFF | OFF | OFF | OFF | 3.3 | MEDIUM | NONE
P19/4 | - | in | IOB99[A] | D06/SSPI_CLK | LVCMOS33 | 8 | UP | OFF | ON | OFF | OFF | OFF | OFF | 3.3 | MEDIUM | NONE
R19/4 | - | in | IOB99[B] | D07/SSPI_WPN | LVCMOS33 | 8 | UP | OFF | ON | OFF | OFF | OFF | OFF | 3.3 | MEDIUM | NONE
T19/4 | flash_csn | out | IOB102[A] | MCS_N | LVCMOS33 | 8 | UP | OFF | OFF | OFF | OFF | OFF | OFF | 3.3 | MEDIUM | NONE
T20/4 | - | in | IOB102[B] | D08/SO | LVCMOS33 | 8 | UP | OFF | ON | OFF | OFF | OFF | OFF | 3.3 | MEDIUM | NONE
U22/4 | - | in | IOB104[A] | PUDC_B | LVCMOS33 | 8 | DOWN | OFF | ON | OFF | OFF | OFF | OFF | 3.3 | MEDIUM | NONE
V22/4 | clk_50mhz | in | IOB104[B] | EMCCLK | LVCMOS33 | OFF | NONE | OFF | ON | OFF | OFF | OFF | OFF | 3.3 | MEDIUM | NONE
V17/4 | - | in | IOB106[A] | CSI_B | LVCMOS33 | 8 | UP | OFF | ON | OFF | OFF | OFF | OFF | 3.3 | MEDIUM | NONE
W17/4 | - | in | IOB106[B] | D31 | LVCMOS33 | 8 | NONE | OFF | ON | OFF | OFF | OFF | OFF | 3.3 | MEDIUM | NONE
AA18/4 | - | in | IOB108[A] | D30 | LVCMOS33 | 8 | NONE | OFF | ON | OFF | OFF | OFF | OFF | 3.3 | MEDIUM | NONE
AB18/4 | - | in | IOB108[B] | D29 | LVCMOS33 | 8 | NONE | OFF | ON | OFF | OFF | OFF | OFF | 3.3 | MEDIUM | NONE
AA19/4 | - | in | IOB110[A] | RDWR | LVCMOS33 | 8 | DOWN | OFF | ON | OFF | OFF | OFF | OFF | 3.3 | MEDIUM | NONE
AB20/4 | - | out | IOB110[B] | DOUT_CSO_B | LVCMOS33 | 8 | UP | OFF | OFF | OFF | OFF | OFF | OFF | 3.3 | MEDIUM | NONE
U17/4 | - | in | IOB112[A] | D28 | LVCMOS33 | 8 | NONE | OFF | ON | OFF | OFF | OFF | OFF | 3.3 | MEDIUM | NONE
U18/4 | - | in | IOB112[B] | D27 | LVCMOS33 | 8 | NONE | OFF | ON | OFF | OFF | OFF | OFF | 3.3 | MEDIUM | NONE
V18/4 | - | in | IOB114[A] | SGCLKT_4/BPLL2_T_FB1/BPLL3_T_FB1 | LVCMOS33 | 8 | UP | OFF | ON | OFF | OFF | OFF | OFF | 3.3 | MEDIUM | NONE
V19/4 | - | in | IOB114[B] | SGCLKC_4/BPLL2_C_FB1/BPLL3_C_FB1 | LVCMOS33 | 8 | UP | OFF | ON | OFF | OFF | OFF | OFF | 3.3 | MEDIUM | NONE
Y18/4 | - | in | IOB116[A] | MGCLKT_4/BPLL2_T_FB0/BPLL3_T_FB0 | LVCMOS33 | 8 | UP | OFF | ON | OFF | OFF | OFF | OFF | 3.3 | MEDIUM | NONE
Y19/4 | - | in | IOB116[B] | MGCLKC_4/BPLL2_C_FB0/BPLL3_C_FB0 | LVCMOS33 | 8 | UP | OFF | ON | OFF | OFF | OFF | OFF | 3.3 | MEDIUM | NONE
U20/4 | - | in | IOB120[A] | SGCLKT_5/BPLL2_T_IN0/BPLL3_T_IN0 | LVCMOS33 | 8 | UP | OFF | ON | OFF | OFF | OFF | OFF | 3.3 | MEDIUM | NONE
V20/4 | - | in | IOB120[B] | SGCLKC_5/BPLL2_C_IN0/BPLL3_C_IN0 | LVCMOS33 | 8 | UP | OFF | ON | OFF | OFF | OFF | OFF | 3.3 | MEDIUM | NONE
W19/4 | - | in | IOB122[A] | MGCLKT_5/BPLL2_T_IN1/BPLL3_T_IN1 | LVCMOS33 | 8 | UP | OFF | ON | OFF | OFF | OFF | OFF | 3.3 | MEDIUM | NONE
W20/4 | - | in | IOB122[B] | MGCLKC_5/BPLL2_C_IN1/BPLL3_C_IN1 | LVCMOS33 | 8 | UP | OFF | ON | OFF | OFF | OFF | OFF | 3.3 | MEDIUM | NONE
W21/4 | - | in | IOB124[A] | D09 | LVCMOS33 | 8 | NONE | OFF | ON | OFF | OFF | OFF | OFF | 3.3 | MEDIUM | NONE
W22/4 | - | in | IOB124[B] | D10 | LVCMOS33 | 8 | NONE | OFF | ON | OFF | OFF | OFF | OFF | 3.3 | MEDIUM | NONE
AA20/4 | - | in | IOB126[A] | D11 | LVCMOS33 | 8 | NONE | OFF | ON | OFF | OFF | OFF | OFF | 3.3 | MEDIUM | NONE
AA21/4 | - | in | IOB126[B] | D12 | LVCMOS33 | 8 | NONE | OFF | ON | OFF | OFF | OFF | OFF | 3.3 | MEDIUM | NONE
AB21/4 | - | in | IOB129[A] | D14 | LVCMOS33 | 8 | NONE | OFF | ON | OFF | OFF | OFF | OFF | 3.3 | MEDIUM | NONE
AB22/4 | - | in | IOB129[B] | D15 | LVCMOS33 | 8 | NONE | OFF | ON | OFF | OFF | OFF | OFF | 3.3 | MEDIUM | NONE
Y21/4 | - | in | IOB131[A] | SSPI_CS_N | LVCMOS33 | 8 | UP | OFF | ON | OFF | OFF | OFF | OFF | 3.3 | MEDIUM | NONE
Y22/4 | - | in | IOB131[B] | D13 | LVCMOS33 | 8 | NONE | OFF | ON | OFF | OFF | OFF | OFF | 3.3 | MEDIUM | NONE
P14/4 | - | in | IOB133[A] | D26 | LVCMOS33 | 8 | NONE | OFF | ON | OFF | OFF | OFF | OFF | 3.3 | MEDIUM | NONE
R14/4 | - | in | IOB133[B] | D25 | LVCMOS33 | 8 | NONE | OFF | ON | OFF | OFF | OFF | OFF | 3.3 | MEDIUM | NONE
N17/4 | - | in | IOB135[A] | CLKHOLD_N | LVCMOS33 | 8 | UP | OFF | ON | OFF | OFF | OFF | OFF | 3.3 | MEDIUM | NONE
P17/4 | - | in | IOB135[B] | D22 | LVCMOS33 | 8 | NONE | OFF | ON | OFF | OFF | OFF | OFF | 3.3 | MEDIUM | NONE
R18/4 | - | in | IOB138[A] | D24 | LVCMOS33 | 8 | NONE | OFF | ON | OFF | OFF | OFF | OFF | 3.3 | MEDIUM | NONE
T18/4 | - | in | IOB138[B] | D23 | LVCMOS33 | 8 | NONE | OFF | ON | OFF | OFF | OFF | OFF | 3.3 | MEDIUM | NONE
P15/4 | - | in | IOB140[A] | D21 | LVCMOS33 | 8 | NONE | OFF | ON | OFF | OFF | OFF | OFF | 3.3 | MEDIUM | NONE
R16/4 | - | in | IOB140[B] | D20 | LVCMOS33 | 8 | NONE | OFF | ON | OFF | OFF | OFF | OFF | 3.3 | MEDIUM | NONE
N13/4 | - | in | IOB142[A] | D19 | LVCMOS33 | 8 | NONE | OFF | ON | OFF | OFF | OFF | OFF | 3.3 | MEDIUM | NONE
N14/4 | - | in | IOB142[B] | D18 | LVCMOS33 | 8 | NONE | OFF | ON | OFF | OFF | OFF | OFF | 3.3 | MEDIUM | NONE
P16/4 | - | in | IOB144[A] | D17 | LVCMOS33 | 8 | NONE | OFF | ON | OFF | OFF | OFF | OFF | 3.3 | MEDIUM | NONE
R17/4 | - | in | IOB144[B] | D16 | LVCMOS33 | 8 | NONE | OFF | ON | OFF | OFF | OFF | OFF | 3.3 | MEDIUM | NONE
N15/4 | - | in | IOB146[A] | - | LVCMOS33 | 8 | UP | OFF | ON | OFF | OFF | OFF | OFF | 3.3 | MEDIUM | NONE
U13/10 | - | out | IOB169[A] | TDO | LVCMOS33 | 8 | UP | OFF | OFF | OFF | OFF | OFF | OFF | 3.3 | MEDIUM | NONE
T13/10 | - | in | IOB169[B] | TMS | LVCMOS33 | 8 | UP | OFF | ON | OFF | OFF | OFF | OFF | 3.3 | MEDIUM | NONE
U12/10 | - | in | IOB171[A] | READY | LVCMOS33 | 8 | UP | OFF | ON | OFF | OFF | OFF | OFF | 3.3 | MEDIUM | NONE
G11/10 | - | in | IOB171[B] | DONE | LVCMOS33 | 8 | UP | OFF | ON | OFF | OFF | OFF | OFF | 3.3 | MEDIUM | NONE
V12/10 | - | in | IOB173[A] | TCK | LVCMOS33 | 8 | UP | OFF | ON | OFF | OFF | OFF | OFF | 3.3 | MEDIUM | NONE
R13/10 | - | in | IOB173[B] | TDI | LVCMOS33 | 8 | UP | OFF | ON | OFF | OFF | OFF | OFF | 3.3 | MEDIUM | NONE
U11/10 | - | in | IOB175[A] | MODE0 | LVCMOS33 | 8 | UP | OFF | ON | OFF | OFF | OFF | OFF | 3.3 | MEDIUM | NONE
L12/10 | flash_sclk | out | IOB175[B] | CCLK | LVCMOS33 | 8 | NONE | OFF | OFF | OFF | OFF | OFF | OFF | 3.3 | MEDIUM | NONE
U10/10 | - | in | IOB177[A] | MODE1 | LVCMOS33 | 8 | UP | OFF | ON | OFF | OFF | OFF | OFF | 3.3 | MEDIUM | NONE
U9/10 | - | in | IOB177[B] | MODE2 | LVCMOS33 | 8 | UP | OFF | ON | OFF | OFF | OFF | OFF | 3.3 | MEDIUM | NONE
U8/10 | - | in | IOB179[A] | CFGBVS | LVCMOS33 | 8 | UP | OFF | ON | OFF | OFF | OFF | OFF | 3.3 | MEDIUM | NONE
N12/10 | - | in | IOB179[B] | RECONFIG_N | LVCMOS33 | 8 | UP | OFF | ON | OFF | OFF | OFF | OFF | 3.3 | MEDIUM | NONE
F4/7 | reset_button | in | IOL1[A] | - | LVCMOS15 | OFF | DOWN | OFF | ON | OFF | OFF | OFF | OFF | 1.5 | MEDIUM | NONE
B1/7 | - | in | IOL2[A] | ADCINCK0 | LVCMOS15 | 8 | UP | OFF | ON | OFF | OFF | OFF | OFF | 1.5 | MEDIUM | NONE
A1/7 | - | in | IOL2[B] | - | LVCMOS15 | 8 | UP | OFF | ON | OFF | OFF | OFF | OFF | 1.5 | MEDIUM | NONE
E1/7 | - | in | IOL4[A] | - | LVCMOS15 | 8 | UP | OFF | ON | OFF | OFF | OFF | OFF | 1.5 | MEDIUM | NONE
D1/7 | ddr_addr[14] | out | IOL4[B] | - | SSTL15 | 8 | NONE | OFF | OFF | OFF | OFF | OFF | OFF | 1.5 | MEDIUM | NONE
C2/7 | - | in | IOL6[A] | - | LVCMOS15 | 8 | UP | OFF | ON | OFF | OFF | OFF | OFF | 1.5 | MEDIUM | NONE
B2/7 | - | in | IOL6[B] | - | LVCMOS15 | 8 | UP | OFF | ON | OFF | OFF | OFF | OFF | 1.5 | MEDIUM | NONE
E2/7 | - | in | IOL8[A] | - | LVCMOS15 | 8 | UP | OFF | ON | OFF | OFF | OFF | OFF | 1.5 | MEDIUM | NONE
D2/7 | - | in | IOL8[B] | - | LVCMOS15 | 8 | UP | OFF | ON | OFF | OFF | OFF | OFF | 1.5 | MEDIUM | NONE
G1/7 | - | in | IOL11[A] | - | LVCMOS15 | 8 | UP | OFF | ON | OFF | OFF | OFF | OFF | 1.5 | MEDIUM | NONE
F1/7 | - | in | IOL11[B] | - | LVCMOS15 | 8 | UP | OFF | ON | OFF | OFF | OFF | OFF | 1.5 | MEDIUM | NONE
F3/7 | - | in | IOL13[A] | - | LVCMOS15 | 8 | UP | OFF | ON | OFF | OFF | OFF | OFF | 1.5 | MEDIUM | NONE
E3/7 | - | in | IOL13[B] | - | LVCMOS15 | 8 | UP | OFF | ON | OFF | OFF | OFF | OFF | 1.5 | MEDIUM | NONE
K1/7 | ddr_addr[13] | out | IOL15[A] | - | SSTL15 | 8 | NONE | OFF | OFF | OFF | OFF | OFF | OFF | 1.5 | MEDIUM | NONE
J1/7 | ddr_addr[7] | out | IOL15[B] | - | SSTL15 | 8 | NONE | OFF | OFF | OFF | OFF | OFF | OFF | 1.5 | MEDIUM | NONE
H2/7 | ddr_addr[5] | out | IOL17[A] | - | SSTL15 | 8 | NONE | OFF | OFF | OFF | OFF | OFF | OFF | 1.5 | MEDIUM | NONE
G2/7 | ddr_addr[2] | out | IOL17[B] | - | SSTL15 | 8 | NONE | OFF | OFF | OFF | OFF | OFF | OFF | 1.5 | MEDIUM | NONE
J5/7 | ddr_addr[8] | out | IOL20[A] | - | SSTL15 | 8 | NONE | OFF | OFF | OFF | OFF | OFF | OFF | 1.5 | MEDIUM | NONE
H5/7 | ddr_addr[9] | out | IOL20[B] | - | SSTL15 | 8 | NONE | OFF | OFF | OFF | OFF | OFF | OFF | 1.5 | MEDIUM | NONE
K2/7 | ddr_addr[1] | out | IOL22[A] | - | SSTL15 | 8 | NONE | OFF | OFF | OFF | OFF | OFF | OFF | 1.5 | MEDIUM | NONE
J2/7 | ddr_addr[4] | out | IOL22[B] | - | SSTL15 | 8 | NONE | OFF | OFF | OFF | OFF | OFF | OFF | 1.5 | MEDIUM | NONE
H4/7 | - | in | IOL24[A] | MGCLKT_11/LPLL0_T_IN1/LPLL1_T_IN1 | LVCMOS15 | 8 | UP | OFF | ON | OFF | OFF | OFF | OFF | 1.5 | MEDIUM | NONE
G4/7 | - | in | IOL24[B] | MGCLKC_11/LPLL0_C_IN1/LPLL1_C_IN1 | LVCMOS15 | 8 | UP | OFF | ON | OFF | OFF | OFF | OFF | 1.5 | MEDIUM | NONE
H3/7 | ddr_addr[11] | out | IOL26[A] | SGCLKT_11/LPLL0_T_IN0/LPLL1_T_IN0 | SSTL15 | 8 | NONE | OFF | OFF | OFF | OFF | OFF | OFF | 1.5 | MEDIUM | NONE
G3/7 | ddr_addr[6] | out | IOL26[B] | SGCLKC_11/LPLL0_C_IN0/LPLL1_C_IN0 | SSTL15 | 8 | NONE | OFF | OFF | OFF | OFF | OFF | OFF | 1.5 | MEDIUM | NONE
K4/7 | ddr_addr[12] | out | IOL29[A] | MGCLKT_10/LPLL0_T_FB1/LPLL1_T_FB1 | SSTL15 | 8 | NONE | OFF | OFF | OFF | OFF | OFF | OFF | 1.5 | MEDIUM | NONE
J4/7 | ddr_addr[3] | out | IOL29[B] | MGCLKC_10/LPLL0_C_FB1/LPLL1_C_FB1 | SSTL15 | 8 | NONE | OFF | OFF | OFF | OFF | OFF | OFF | 1.5 | MEDIUM | NONE
L3/7 | ddr_ck | out | IOL31[A] | SGCLKT_10/LPLL0_T_FB0/LPLL1_T_FB0 | SSTL15D | 8 | NONE | OFF | OFF | OFF | OFF | OFF | OFF | 1.5 | MEDIUM | NONE
K3/7 | ddr_ck_n | out | IOL31[B] | SGCLKC_10/LPLL0_C_FB0/LPLL1_C_FB0 | SSTL15D | 8 | NONE | OFF | OFF | OFF | OFF | OFF | OFF | 1.5 | MEDIUM | NONE
M3/7 | - | in | IOL33[A] | FBTEST_L0 | LVCMOS15 | 8 | UP | OFF | ON | OFF | OFF | OFF | OFF | 1.5 | MEDIUM | NONE
M2/7 | ddr_odt | out | IOL33[B] | CLKTEST_L0 | SSTL15 | 8 | NONE | OFF | OFF | OFF | OFF | OFF | OFF | 1.5 | MEDIUM | NONE
M1/7 | ddr_addr[0] | out | IOL35[A] | - | SSTL15 | 8 | NONE | OFF | OFF | OFF | OFF | OFF | OFF | 1.5 | MEDIUM | NONE
L1/7 | ddr_addr[10] | out | IOL35[B] | - | SSTL15 | 8 | NONE | OFF | OFF | OFF | OFF | OFF | OFF | 1.5 | MEDIUM | NONE
K6/7 | ddr_cke | out | IOL38[A] | - | SSTL15 | 8 | NONE | OFF | OFF | OFF | OFF | OFF | OFF | 1.5 | MEDIUM | NONE
J6/7 | - | in | IOL38[B] | - | LVCMOS15 | 8 | UP | OFF | ON | OFF | OFF | OFF | OFF | 1.5 | MEDIUM | NONE
L5/7 | ddr_ras | out | IOL40[A] | - | SSTL15 | 8 | NONE | OFF | OFF | OFF | OFF | OFF | OFF | 1.5 | MEDIUM | NONE
L4/7 | ddr_cas | out | IOL40[B] | - | SSTL15 | 8 | NONE | OFF | OFF | OFF | OFF | OFF | OFF | 1.5 | MEDIUM | NONE
N4/7 | - | in | IOL42[A] | - | LVCMOS15 | 8 | UP | OFF | ON | OFF | OFF | OFF | OFF | 1.5 | MEDIUM | NONE
N3/7 | - | in | IOL42[B] | - | LVCMOS15 | 8 | UP | OFF | ON | OFF | OFF | OFF | OFF | 1.5 | MEDIUM | NONE
R1/7 | - | in | IOL44[A] | - | LVCMOS15 | 8 | UP | OFF | ON | OFF | OFF | OFF | OFF | 1.5 | MEDIUM | NONE
P1/7 | - | in | IOL44[B] | - | LVCMOS15 | 8 | UP | OFF | ON | OFF | OFF | OFF | OFF | 1.5 | MEDIUM | NONE
P2/7 | ddr_bank[1] | out | IOL47[A] | - | SSTL15 | 8 | NONE | OFF | OFF | OFF | OFF | OFF | OFF | 1.5 | MEDIUM | NONE
N2/7 | - | in | IOL47[B] | - | LVCMOS15 | 8 | UP | OFF | ON | OFF | OFF | OFF | OFF | 1.5 | MEDIUM | NONE
P5/7 | ddr_bank[0] | out | IOL49[A] | - | SSTL15 | 8 | NONE | OFF | OFF | OFF | OFF | OFF | OFF | 1.5 | MEDIUM | NONE
P4/7 | ddr_cs | out | IOL49[B] | - | SSTL15 | 8 | NONE | OFF | OFF | OFF | OFF | OFF | OFF | 1.5 | MEDIUM | NONE
M6/7 | ddr_bank[2] | out | IOL51[A] | - | SSTL15 | 8 | NONE | OFF | OFF | OFF | OFF | OFF | OFF | 1.5 | MEDIUM | NONE
M5/7 | ddr_we | out | IOL51[B] | - | SSTL15 | 8 | NONE | OFF | OFF | OFF | OFF | OFF | OFF | 1.5 | MEDIUM | NONE
P6/7 | - | in | IOL53[A] | - | LVCMOS15 | 8 | UP | OFF | ON | OFF | OFF | OFF | OFF | 1.5 | MEDIUM | NONE
N5/7 | - | in | IOL53[B] | - | LVCMOS15 | 8 | UP | OFF | ON | OFF | OFF | OFF | OFF | 1.5 | MEDIUM | NONE
L6/7 | ddr_reset_n | out | IOL55[A] | - | SSTL15 | 8 | NONE | OFF | OFF | OFF | OFF | OFF | OFF | 1.5 | MEDIUM | NONE
T1/6 | ddr_dq[26] | io | IOL56[A] | - | SSTL15 | 8 | NONE | OFF | NONE | OFF | INTERNAL | OFF | OFF | 1.5 | MEDIUM | OFF
U1/6 | ddr_dq[30] | io | IOL56[B] | - | SSTL15 | 8 | NONE | OFF | NONE | OFF | INTERNAL | OFF | OFF | 1.5 | MEDIUM | OFF
U2/6 | ddr_dq[28] | io | IOL58[A] | - | SSTL15 | 8 | NONE | OFF | NONE | OFF | INTERNAL | OFF | OFF | 1.5 | MEDIUM | OFF
V2/6 | ddr_dq[29] | io | IOL58[B] | - | SSTL15 | 8 | NONE | OFF | NONE | OFF | INTERNAL | OFF | OFF | 1.5 | MEDIUM | OFF
U3/6 | ddr_dq[27] | io | IOL60[A] | - | SSTL15 | 8 | NONE | OFF | NONE | OFF | INTERNAL | OFF | OFF | 1.5 | MEDIUM | OFF
V3/6 | - | in | IOL60[B] | - | LVCMOS15 | 8 | UP | OFF | ON | OFF | OFF | OFF | OFF | 1.5 | MEDIUM | NONE
W2/6 | ddr_dq[24] | io | IOL62[A] | - | SSTL15 | 8 | NONE | OFF | NONE | OFF | INTERNAL | OFF | OFF | 1.5 | MEDIUM | OFF
Y2/6 | ddr_dq[31] | io | IOL62[B] | - | SSTL15 | 8 | NONE | OFF | NONE | OFF | INTERNAL | OFF | OFF | 1.5 | MEDIUM | OFF
R3/6 | ddr_dqs[3] | io | IOL65[A] | - | SSTL15D | 8 | NONE | OFF | NONE | OFF | OFF | OFF | OFF | 1.5 | MEDIUM | OFF
R2/6 | ddr_dqs_n[3] | io | IOL65[B] | - | SSTL15D | 8 | NONE | OFF | NONE | OFF | OFF | OFF | OFF | 1.5 | MEDIUM | OFF
W1/6 | ddr_dm[3] | out | IOL67[A] | - | SSTL15 | 8 | NONE | OFF | OFF | OFF | OFF | OFF | OFF | 1.5 | MEDIUM | NONE
Y1/6 | ddr_dq[25] | io | IOL67[B] | - | SSTL15 | 8 | NONE | OFF | NONE | OFF | INTERNAL | OFF | OFF | 1.5 | MEDIUM | OFF
Y3/6 | ddr_dqs[0] | io | IOL69[A] | - | SSTL15D | 8 | NONE | OFF | NONE | OFF | OFF | OFF | OFF | 1.5 | MEDIUM | OFF
AA3/6 | ddr_dqs_n[0] | io | IOL69[B] | - | SSTL15D | 8 | NONE | OFF | NONE | OFF | OFF | OFF | OFF | 1.5 | MEDIUM | OFF
AA1/6 | ddr_dq[4] | io | IOL71[A] | - | SSTL15 | 8 | NONE | OFF | NONE | OFF | INTERNAL | OFF | OFF | 1.5 | MEDIUM | OFF
AB1/6 | ddr_dq[7] | io | IOL71[B] | - | SSTL15 | 8 | NONE | OFF | NONE | OFF | INTERNAL | OFF | OFF | 1.5 | MEDIUM | OFF
T3/6 | - | in | IOL73[A] | - | LVCMOS15 | 8 | UP | OFF | ON | OFF | OFF | OFF | OFF | 1.5 | MEDIUM | NONE
AB3/6 | ddr_dq[1] | io | IOL74[A] | - | SSTL15 | 8 | NONE | OFF | NONE | OFF | INTERNAL | OFF | OFF | 1.5 | MEDIUM | OFF
AB2/6 | ddr_dq[5] | io | IOL74[B] | - | SSTL15 | 8 | NONE | OFF | NONE | OFF | INTERNAL | OFF | OFF | 1.5 | MEDIUM | OFF
AA5/6 | ddr_dq[2] | io | IOL76[A] | - | SSTL15 | 8 | NONE | OFF | NONE | OFF | INTERNAL | OFF | OFF | 1.5 | MEDIUM | OFF
AB5/6 | ddr_dq[6] | io | IOL76[B] | - | SSTL15 | 8 | NONE | OFF | NONE | OFF | INTERNAL | OFF | OFF | 1.5 | MEDIUM | OFF
Y4/6 | ddr_dq[0] | io | IOL78[A] | SGCLKT_8/LPLL2_T_IN0/LPLL3_T_IN0 | SSTL15 | 8 | NONE | OFF | NONE | OFF | INTERNAL | OFF | OFF | 1.5 | MEDIUM | OFF
AA4/6 | ddr_dm[0] | out | IOL78[B] | SGCLKC_8/LPLL2_C_IN0/LPLL3_C_IN0 | SSTL15 | 8 | NONE | OFF | OFF | OFF | OFF | OFF | OFF | 1.5 | MEDIUM | NONE
V4/6 | ddr_dq[3] | io | IOL80[A] | MGCLKT_8/LPLL2_T_IN1/LPLL3_T_IN1 | SSTL15 | 8 | NONE | OFF | NONE | OFF | INTERNAL | OFF | OFF | 1.5 | MEDIUM | OFF
W4/6 | - | in | IOL80[B] | MGCLKC_8/LPLL2_C_IN1/LPLL3_C_IN1 | LVCMOS15 | 8 | UP | OFF | ON | OFF | OFF | OFF | OFF | 1.5 | MEDIUM | NONE
R4/6 | ddr_dq[19] | io | IOL83[A] | MGCLKT_9/LPLL2_T_FB1/LPLL3_T_FB1 | SSTL15 | 8 | NONE | OFF | NONE | OFF | INTERNAL | OFF | OFF | 1.5 | MEDIUM | OFF
T4/6 | ddr_dq[21] | io | IOL83[B] | MGCLKC_9/LPLL2_C_FB1/LPLL3_C_FB1 | SSTL15 | 8 | NONE | OFF | NONE | OFF | INTERNAL | OFF | OFF | 1.5 | MEDIUM | OFF
T5/6 | ddr_dq[23] | io | IOL85[A] | SGCLKT_9/LPLL2_T_FB0/LPLL3_T_FB0 | SSTL15 | 8 | NONE | OFF | NONE | OFF | INTERNAL | OFF | OFF | 1.5 | MEDIUM | OFF
U5/6 | ddr_dq[16] | io | IOL85[B] | SGCLKC_9/LPLL2_C_FB0/LPLL3_C_FB0 | SSTL15 | 8 | NONE | OFF | NONE | OFF | INTERNAL | OFF | OFF | 1.5 | MEDIUM | OFF
U6/6 | ddr_dq[18] | io | IOL87[A] | - | SSTL15 | 8 | NONE | OFF | NONE | OFF | INTERNAL | OFF | OFF | 1.5 | MEDIUM | OFF
V5/6 | ddr_dq[22] | io | IOL87[B] | - | SSTL15 | 8 | NONE | OFF | NONE | OFF | INTERNAL | OFF | OFF | 1.5 | MEDIUM | OFF
R6/6 | ddr_dq[17] | io | IOL89[A] | - | SSTL15 | 8 | NONE | OFF | NONE | OFF | INTERNAL | OFF | OFF | 1.5 | MEDIUM | OFF
T6/6 | ddr_dm[2] | out | IOL89[B] | - | SSTL15 | 8 | NONE | OFF | OFF | OFF | OFF | OFF | OFF | 1.5 | MEDIUM | NONE
Y6/6 | ddr_dq[20] | io | IOL92[A] | - | SSTL15 | 8 | NONE | OFF | NONE | OFF | INTERNAL | OFF | OFF | 1.5 | MEDIUM | OFF
AA6/6 | - | in | IOL92[B] | - | LVCMOS15 | 8 | UP | OFF | ON | OFF | OFF | OFF | OFF | 1.5 | MEDIUM | NONE
W6/6 | ddr_dqs[2] | io | IOL94[A] | - | SSTL15D | 8 | NONE | OFF | NONE | OFF | OFF | OFF | OFF | 1.5 | MEDIUM | OFF
W5/6 | ddr_dqs_n[2] | io | IOL94[B] | - | SSTL15D | 8 | NONE | OFF | NONE | OFF | OFF | OFF | OFF | 1.5 | MEDIUM | OFF
V9/6 | ddr_dqs[1] | io | IOL96[A] | - | SSTL15D | 8 | NONE | OFF | NONE | OFF | OFF | OFF | OFF | 1.5 | MEDIUM | OFF
V8/6 | ddr_dqs_n[1] | io | IOL96[B] | - | SSTL15D | 8 | NONE | OFF | NONE | OFF | OFF | OFF | OFF | 1.5 | MEDIUM | OFF
AB7/6 | ddr_dq[10] | io | IOL98[A] | - | SSTL15 | 8 | NONE | OFF | NONE | OFF | INTERNAL | OFF | OFF | 1.5 | MEDIUM | OFF
AB6/6 | ddr_dq[14] | io | IOL98[B] | - | SSTL15 | 8 | NONE | OFF | NONE | OFF | INTERNAL | OFF | OFF | 1.5 | MEDIUM | OFF
AA8/6 | ddr_dq[8] | io | IOL101[A] | - | SSTL15 | 8 | NONE | OFF | NONE | OFF | INTERNAL | OFF | OFF | 1.5 | MEDIUM | OFF
AB8/6 | ddr_dq[12] | io | IOL101[B] | - | SSTL15 | 8 | NONE | OFF | NONE | OFF | INTERNAL | OFF | OFF | 1.5 | MEDIUM | OFF
Y8/6 | ddr_dq[9] | io | IOL103[A] | - | SSTL15 | 8 | NONE | OFF | NONE | OFF | INTERNAL | OFF | OFF | 1.5 | MEDIUM | OFF
Y7/6 | ddr_dq[11] | io | IOL103[B] | - | SSTL15 | 8 | NONE | OFF | NONE | OFF | INTERNAL | OFF | OFF | 1.5 | MEDIUM | OFF
W9/6 | ddr_dq[13] | io | IOL105[A] | - | SSTL15 | 8 | NONE | OFF | NONE | OFF | INTERNAL | OFF | OFF | 1.5 | MEDIUM | OFF
Y9/6 | ddr_dq[15] | io | IOL105[B] | - | SSTL15 | 8 | NONE | OFF | NONE | OFF | INTERNAL | OFF | OFF | 1.5 | MEDIUM | OFF
V7/6 | ddr_dm[1] | out | IOL107[A] | MCKTEST | SSTL15 | 8 | NONE | OFF | OFF | OFF | OFF | OFF | OFF | 1.5 | MEDIUM | NONE
W7/6 | - | in | IOL107[B] | - | LVCMOS15 | 8 | UP | OFF | ON | OFF | OFF | OFF | OFF | 1.5 | MEDIUM | NONE
U7/6 | - | in | IOL109[A] | - | LVCMOS15 | 8 | UP | OFF | ON | OFF | OFF | OFF | OFF | 1.5 | MEDIUM | NONE
F15/2 | - | in | IOR1[A] | - | LVCMOS33 | 8 | UP | OFF | ON | OFF | OFF | OFF | OFF | 3.3 | MEDIUM | NONE
E13/2 | - | in | IOR2[A] | - | LVCMOS33 | 8 | UP | OFF | ON | OFF | OFF | OFF | OFF | 3.3 | MEDIUM | NONE
E14/2 | - | in | IOR2[B] | - | LVCMOS33 | 8 | UP | OFF | ON | OFF | OFF | OFF | OFF | 3.3 | MEDIUM | NONE
D14/2 | - | in | IOR4[A] | - | LVCMOS33 | 8 | UP | OFF | ON | OFF | OFF | OFF | OFF | 3.3 | MEDIUM | NONE
D15/2 | - | in | IOR4[B] | - | LVCMOS33 | 8 | UP | OFF | ON | OFF | OFF | OFF | OFF | 3.3 | MEDIUM | NONE
E16/2 | - | in | IOR6[A] | - | LVCMOS33 | 8 | UP | OFF | ON | OFF | OFF | OFF | OFF | 3.3 | MEDIUM | NONE
D16/2 | - | in | IOR6[B] | - | LVCMOS33 | 8 | UP | OFF | ON | OFF | OFF | OFF | OFF | 3.3 | MEDIUM | NONE
C14/2 | - | in | IOR8[A] | - | LVCMOS33 | 8 | UP | OFF | ON | OFF | OFF | OFF | OFF | 3.3 | MEDIUM | NONE
C15/2 | - | in | IOR8[B] | - | LVCMOS33 | 8 | UP | OFF | ON | OFF | OFF | OFF | OFF | 3.3 | MEDIUM | NONE
F13/2 | - | in | IOR11[A] | - | LVCMOS33 | 8 | UP | OFF | ON | OFF | OFF | OFF | OFF | 3.3 | MEDIUM | NONE
F14/2 | - | in | IOR11[B] | - | LVCMOS33 | 8 | UP | OFF | ON | OFF | OFF | OFF | OFF | 3.3 | MEDIUM | NONE
F16/2 | - | in | IOR13[A] | - | LVCMOS33 | 8 | UP | OFF | ON | OFF | OFF | OFF | OFF | 3.3 | MEDIUM | NONE
E17/2 | - | in | IOR13[B] | - | LVCMOS33 | 8 | UP | OFF | ON | OFF | OFF | OFF | OFF | 3.3 | MEDIUM | NONE
A13/2 | - | in | IOR15[A] | - | LVCMOS33 | 8 | UP | OFF | ON | OFF | OFF | OFF | OFF | 3.3 | MEDIUM | NONE
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
K19/3 | - | in | IOR83[B] | MGCLKC_2/RPLL2_C_IN1/RPLL3_C_IN1 | LVCMOS33 | 8 | UP | OFF | ON | OFF | OFF | OFF | OFF | 3.3 | MEDIUM | NONE
L19/3 | - | in | IOR85[A] | SGCLKT_2/RPLL2_T_IN0/RPLL3_T_IN0 | LVCMOS33 | 8 | UP | OFF | ON | OFF | OFF | OFF | OFF | 3.3 | MEDIUM | NONE
L20/3 | - | in | IOR85[B] | SGCLKC_2/RPLL2_C_IN0/RPLL3_C_IN0 | LVCMOS33 | 8 | UP | OFF | ON | OFF | OFF | OFF | OFF | 3.3 | MEDIUM | NONE
M18/3 | - | in | IOR87[A] | - | LVCMOS33 | 8 | UP | OFF | ON | OFF | OFF | OFF | OFF | 3.3 | MEDIUM | NONE
L18/3 | - | in | IOR87[B] | - | LVCMOS33 | 8 | UP | OFF | ON | OFF | OFF | OFF | OFF | 3.3 | MEDIUM | NONE
N22/3 | - | in | IOR89[A] | - | LVCMOS33 | 8 | UP | OFF | ON | OFF | OFF | OFF | OFF | 3.3 | MEDIUM | NONE
M22/3 | - | in | IOR89[B] | - | LVCMOS33 | 8 | UP | OFF | ON | OFF | OFF | OFF | OFF | 3.3 | MEDIUM | NONE
N18/3 | - | in | IOR92[A] | - | LVCMOS33 | 8 | UP | OFF | ON | OFF | OFF | OFF | OFF | 3.3 | MEDIUM | NONE
N19/3 | - | in | IOR92[B] | - | LVCMOS33 | 8 | UP | OFF | ON | OFF | OFF | OFF | OFF | 3.3 | MEDIUM | NONE
N20/3 | - | in | IOR94[A] | - | LVCMOS33 | 8 | UP | OFF | ON | OFF | OFF | OFF | OFF | 3.3 | MEDIUM | NONE
M20/3 | - | in | IOR94[B] | - | LVCMOS33 | 8 | UP | OFF | ON | OFF | OFF | OFF | OFF | 3.3 | MEDIUM | NONE
H17/3 | - | in | IOR96[A] | - | LVCMOS33 | 8 | UP | OFF | ON | OFF | OFF | OFF | OFF | 3.3 | MEDIUM | NONE
H18/3 | - | in | IOR96[B] | - | LVCMOS33 | 8 | UP | OFF | ON | OFF | OFF | OFF | OFF | 3.3 | MEDIUM | NONE
H13/3 | - | in | IOR98[A] | - | LVCMOS33 | 8 | UP | OFF | ON | OFF | OFF | OFF | OFF | 3.3 | MEDIUM | NONE
G13/3 | - | in | IOR98[B] | - | LVCMOS33 | 8 | UP | OFF | ON | OFF | OFF | OFF | OFF | 3.3 | MEDIUM | NONE
J15/3 | - | in | IOR101[A] | - | LVCMOS33 | 8 | UP | OFF | ON | OFF | OFF | OFF | OFF | 3.3 | MEDIUM | NONE
H15/3 | - | in | IOR101[B] | - | LVCMOS33 | 8 | UP | OFF | ON | OFF | OFF | OFF | OFF | 3.3 | MEDIUM | NONE
J14/3 | - | in | IOR103[A] | - | LVCMOS33 | 8 | UP | OFF | ON | OFF | OFF | OFF | OFF | 3.3 | MEDIUM | NONE
H14/3 | - | in | IOR103[B] | - | LVCMOS33 | 8 | UP | OFF | ON | OFF | OFF | OFF | OFF | 3.3 | MEDIUM | NONE
G15/3 | - | in | IOR105[A] | - | LVCMOS33 | 8 | UP | OFF | ON | OFF | OFF | OFF | OFF | 3.3 | MEDIUM | NONE
G16/3 | - | in | IOR105[B] | - | LVCMOS33 | 8 | UP | OFF | ON | OFF | OFF | OFF | OFF | 3.3 | MEDIUM | NONE
G17/3 | - | in | IOR107[A] | ADCINCK1 | LVCMOS33 | 8 | UP | OFF | ON | OFF | OFF | OFF | OFF | 3.3 | MEDIUM | NONE
G18/3 | - | in | IOR107[B] | - | LVCMOS33 | 8 | UP | OFF | ON | OFF | OFF | OFF | OFF | 3.3 | MEDIUM | NONE
J16/3 | - | in | IOR109[A] | - | LVCMOS33 | 8 | UP | OFF | ON | OFF | OFF | OFF | OFF | 3.3 | MEDIUM | NONE
N9/ADC | - | in | ADCTN | - | - | - | - | - | - | - | - | - | - | - | - | -
N10/ADC | - | in | ADCTP | - | - | - | - | - | - | - | - | - | - | - | - | -
M9/ADC | - | in | ADCVN | - | - | - | - | - | - | - | - | - | - | - | - | -
L10/ADC | - | in | ADCVP | - | - | - | - | - | - | - | - | - | - | - | - | -
A8/Q0 | - | in | Q0_LN0_RXM_I | - | - | - | - | - | - | - | - | - | - | - | - | -
B8/Q0 | - | in | Q0_LN0_RXP_I | - | - | - | - | - | - | - | - | - | - | - | - | -
A4/Q0 | - | out | Q0_LN0_TXM_O | - | - | - | - | - | - | - | - | - | - | - | - | -
B4/Q0 | - | out | Q0_LN0_TXP_O | - | - | - | - | - | - | - | - | - | - | - | - | -
C9/Q0 | - | in | Q0_LN1_RXM_I | - | - | - | - | - | - | - | - | - | - | - | - | -
D9/Q0 | - | in | Q0_LN1_RXP_I | - | - | - | - | - | - | - | - | - | - | - | - | -
C7/Q0 | - | out | Q0_LN1_TXM_O | - | - | - | - | - | - | - | - | - | - | - | - | -
D7/Q0 | - | out | Q0_LN1_TXP_O | - | - | - | - | - | - | - | - | - | - | - | - | -
A10/Q0 | - | in | Q0_LN2_RXM_I | - | - | - | - | - | - | - | - | - | - | - | - | -
B10/Q0 | - | in | Q0_LN2_RXP_I | - | - | - | - | - | - | - | - | - | - | - | - | -
A6/Q0 | - | out | Q0_LN2_TXM_O | - | - | - | - | - | - | - | - | - | - | - | - | -
B6/Q0 | - | out | Q0_LN2_TXP_O | - | - | - | - | - | - | - | - | - | - | - | - | -
C11/Q0 | - | in | Q0_LN3_RXM_I | - | - | - | - | - | - | - | - | - | - | - | - | -
D11/Q0 | - | in | Q0_LN3_RXP_I | - | - | - | - | - | - | - | - | - | - | - | - | -
C5/Q0 | - | out | Q0_LN3_TXM_O | - | - | - | - | - | - | - | - | - | - | - | - | -
D5/Q0 | - | out | Q0_LN3_TXP_O | - | - | - | - | - | - | - | - | - | - | - | - | -
E6/Q0 | - | in | Q0_REFCLKM_0 | - | - | - | - | - | - | - | - | - | - | - | - | -
E10/Q0 | - | in | Q0_REFCLKM_1 | - | - | - | - | - | - | - | - | - | - | - | - | -
F6/Q0 | - | in | Q0_REFCLKP_0 | - | - | - | - | - | - | - | - | - | - | - | - | -
F10/Q0 | - | in | Q0_REFCLKP_1 | - | - | - | - | - | - | - | - | - | - | - | - | -
