Berkeley-AI-Risk/inference-only/demos/simplestories-v2-5m/variants/signed-update/tang/evidence/native-build/swic_product_syn.rpt.html

- Synthesis Messages
- Synthesis Details
- Resource
  - Resource Usage Summary
  - Resource Utilization Summary
- Timing
  - Clock Summary
  - Max Frequency Summary
  - Detail Timing Paths Informations

# Synthesis Messages

Report Title | GowinSynthesis Report

Design File

LOCAL_BUILD/swic-tang-native-z6b9e5us/project/defines.v
LOCAL_BUILD/swic-tang-native-z6b9e5us/project/official/ddr3_memory_interface.v
LOCAL_BUILD/swic-tang-native-z6b9e5us/project/official/gowin_pll.v
LOCAL_BUILD/swic-tang-native-z6b9e5us/project/official/gowin_pll_mod.v
LOCAL_BUILD/swic-tang-native-z6b9e5us/project/official/pll_init.v
LOCAL_BUILD/swic-tang-native-z6b9e5us/project/fpga/token_only_model0_board0/rtl/physical/board0_exact_isqrt_u45_iterative.sv
LOCAL_BUILD/swic-tang-native-z6b9e5us/project/fpga/token_only_model0_board0/rtl/physical/board0_exact_rne_div_signed64_iterative.sv
LOCAL_BUILD/swic-tang-native-z6b9e5us/project/fpga/token_only_model0_ddr_board1/asymmetric_unified_dsp2/rtl/board1_asymmetric_private_issue_guard.sv
LOCAL_BUILD/swic-tang-native-z6b9e5us/project/fpga/token_only_model0_ddr_board1/asymmetric_unified_dsp2/rtl/board1_asymmetric_unified_dsp64.sv
LOCAL_BUILD/swic-tang-native-z6b9e5us/project/fpga/token_only_model0_ddr_board1/ddr_phy_open0/rtl/board1_private_ddr256_to_w640.sv
LOCAL_BUILD/swic-tang-native-z6b9e5us/project/fpga/token_only_model0_ddr_board1/fixed_attention0/rtl/board1_fixed_attention_exp_lut_sync.sv
LOCAL_BUILD/swic-tang-native-z6b9e5us/project/fpga/token_only_model0_ddr_board1/fixed_attention0/rtl/board1_fixed_attention_rne_div_signed64.sv
LOCAL_BUILD/swic-tang-native-z6b9e5us/project/fpga/token_only_model0_ddr_board1/fixed_attention_compact1/rtl/board1_fixed_attention_rne_shift_iterative.sv
LOCAL_BUILD/swic-tang-native-z6b9e5us/project/fpga/token_only_model0_ddr_board1/fixed_elementwise0/rtl/board1_fixed_elementwise_dsp_lane.sv
LOCAL_BUILD/swic-tang-native-z6b9e5us/project/fpga/token_only_model0_ddr_board1/fixed_elementwise_product_compact1/rtl/board1_fixed_elementwise_product_dsp.sv
LOCAL_BUILD/swic-tang-native-z6b9e5us/project/fpga/token_only_model0_ddr_board1/fixed_elementwise_product_compact1/rtl/board1_fixed_elementwise_product_compact_lane.sv
LOCAL_BUILD/swic-tang-native-z6b9e5us/project/fpga/token_only_model0_ddr_board1/fixed_token_machine1/rtl/board1_fixed_elementwise_lane_core.sv
LOCAL_BUILD/swic-tang-native-z6b9e5us/project/fpga/token_only_model0_ddr_board1/fixed_group_ddr_stream1/rtl/board1_fixed_group_ddr_stream.sv
LOCAL_BUILD/swic-tang-native-z6b9e5us/project/fpga/token_only_model0_ddr_board1/fixed_group_projection_scale_integration0/rtl/board1_fixed_group_projection_scale_job.sv
LOCAL_BUILD/swic-tang-native-z6b9e5us/project/fpga/token_only_model0_ddr_board1/fixed_head_argmax0/rtl/board1_fixed_head_argmax.sv
LOCAL_BUILD/swic-tang-native-z6b9e5us/project/fpga/token_only_model0_ddr_board1/fixed_head_argmax0/rtl/board1_fixed_head_logit_greater.sv
LOCAL_BUILD/swic-tang-native-z6b9e5us/project/fpga/token_only_model0_ddr_board1/fixed_metadata_stream0/rtl/board1_fixed_projection_metadata_reader.sv
LOCAL_BUILD/swic-tang-native-z6b9e5us/project/fpga/token_only_model0_ddr_board1/fixed_semantic_layer0/rtl/board1_fixed_semantic_scratch_ram.sv
LOCAL_BUILD/swic-tang-native-z6b9e5us/project/fpga/token_only_model0_ddr_board1/fixed_semantic_layer0/rtl/board1_fixed_semantic_vector128_ram.sv
LOCAL_BUILD/swic-tang-native-z6b9e5us/project/fpga/token_only_model0_ddr_board1/fixed_semantic_layer0/rtl/board1_fixed_semantic_vector256_ram.sv
LOCAL_BUILD/swic-tang-native-z6b9e5us/project/fpga/token_only_model0_ddr_board1/fixed_semantic_layer0/rtl/board1_fixed_semantic_rope_raw_ram.sv
LOCAL_BUILD/swic-tang-native-z6b9e5us/project/fpga/token_only_model0_ddr_board1/fixed_token_shell0/rtl/board1_fixed_embedding_lookup.sv
LOCAL_BUILD/swic-tang-native-z6b9e5us/project/normalizer_pipeline.sv
LOCAL_BUILD/swic-tang-native-z6b9e5us/project/fpga/token_only_model0_ddr_board1/fixed_vector_normalize0/rtl/board1_fixed_vector_rne_shift_iterative.sv
LOCAL_BUILD/swic-tang-native-z6b9e5us/project/fpga/token_only_model0_ddr_board1/fixed_vector_rmsnorm0/rtl/board1_fixed_rmsnorm_arithmetic.sv
LOCAL_BUILD/swic-tang-native-z6b9e5us/project/fpga/token_only_model0_ddr_board1/fixed_vector_rmsnorm0/rtl/board1_fixed_rmsnorm_rom.sv
LOCAL_BUILD/swic-tang-native-z6b9e5us/project/fpga/token_only_model0_ddr_board1/fixed_vector_rmsnorm0/rtl/board1_fixed_vector_rmsnorm_service.sv
LOCAL_BUILD/swic-tang-native-z6b9e5us/project/fpga/token_only_model0_ddr_board1/shared_projection_scale0/rtl/board1_shared_projection_scale_engine.sv
LOCAL_BUILD/swic-tang-native-z6b9e5us/project/cluster-adapter.sv
LOCAL_BUILD/swic-tang-native-z6b9e5us/project/fpga/token_only_model0_ddr_board1/unified_dsp0/rtl/board1_unified_projection_head_mul_exact.sv
LOCAL_BUILD/swic-tang-native-z6b9e5us/project/fpga/token_only_model0_ddr_board1/unified_dynamic_dsp1/rtl/board1_unified_projection_head_dynamic_mul_exact.sv
LOCAL_BUILD/swic-tang-native-z6b9e5us/project/fpga/token_only_model0_ddr_board1/fixed_token_machine0/rtl/board1_fixed_private_ddr_arbiter.sv
LOCAL_BUILD/swic-tang-native-z6b9e5us/project/fifo.sv
LOCAL_BUILD/swic-tang-native-z6b9e5us/project/mapper_portable.sv
LOCAL_BUILD/swic-tang-native-z6b9e5us/project/fpga/token_only_model0_ddr_board1/context2048_typed_ddr_boundary0/rtl/board1_context2048_typed_ddr_app_boundary.sv
LOCAL_BUILD/swic-tang-native-z6b9e5us/project/fpga/token_only_model0_ddr_board1/context2048_typed_ddr_boundary0/rtl/board1_context2048_typed_ddr_boundary.sv
LOCAL_BUILD/swic-tang-native-z6b9e5us/project/fpga/token_only_model0_ddr_board1/context2048_token_machine0/rtl/board1_context2048_attention_memories.sv
LOCAL_BUILD/swic-tang-native-z6b9e5us/project/fpga/token_only_model0_ddr_board1/context2048_token_machine0/rtl/board1_context2048_attention.sv
LOCAL_BUILD/swic-tang-native-z6b9e5us/project/fpga/token_only_model0_ddr_board1/context2048_gowin_portability0/rtl/board1_context2048_atomic_kv_typed_clear_consistent.sv
LOCAL_BUILD/swic-tang-native-z6b9e5us/project/fpga/token_only_model0_ddr_board1/context2048_token_machine0/rtl/board1_context2048_semantic_lookup.sv
LOCAL_BUILD/swic-tang-native-z6b9e5us/project/fpga/token_only_model0_ddr_board1/context2048_token_machine0/rtl/board1_context2048_semantic_sequence.sv
LOCAL_BUILD/swic-tang-native-z6b9e5us/project/fpga/token_only_model0_ddr_board1/context2048_token_machine0/rtl/board1_context2048_semantic_datapath.sv
LOCAL_BUILD/swic-tang-native-z6b9e5us/project/fpga/token_only_model0_ddr_board1/context2048_token_machine0/rtl/board1_context2048_semantic_layer.sv
LOCAL_BUILD/swic-tang-native-z6b9e5us/project/fpga/token_only_model0_ddr_board1/context2048_token_machine2/rtl/board1_context2048_token_shell.sv
LOCAL_BUILD/swic-tang-native-z6b9e5us/project/fpga/token_only_model0_ddr_board1/context2048_token_machine2/rtl/board1_context2048_token_machine_core.sv
LOCAL_BUILD/swic-tang-native-z6b9e5us/project/shared_token_probe.sv
LOCAL_BUILD/swic-tang-native-z6b9e5us/project/sha.sv
LOCAL_BUILD/swic-tang-native-z6b9e5us/project/bank.sv
LOCAL_BUILD/swic-tang-native-z6b9e5us/project/service.sv
LOCAL_BUILD/swic-tang-native-z6b9e5us/project/cluster-mul.sv
LOCAL_BUILD/swic-tang-native-z6b9e5us/project/cluster-tile.sv
LOCAL_BUILD/swic-tang-native-z6b9e5us/project/cluster-engine.sv
LOCAL_BUILD/swic-tang-native-z6b9e5us/project/candidate.sv
LOCAL_BUILD/swic-tang-native-z6b9e5us/project/arbiter.sv
LOCAL_BUILD/swic-tang-native-z6b9e5us/project/cdc.sv
LOCAL_BUILD/swic-tang-native-z6b9e5us/project/adapter.sv
LOCAL_BUILD/swic-tang-native-z6b9e5us/project/fpga/token_only_model0_ddr_board1/product8_timing_successor2/rtl/board1_context2048_private_ddr_lock_bridge.sv
LOCAL_BUILD/swic-tang-native-z6b9e5us/project/fpga/token_only_model0_ddr_board1/ddr_preboard_closure0/rtl/board1_ddr_request_fifo2.sv
LOCAL_BUILD/swic-tang-native-z6b9e5us/project/fpga/token_only_model0_ddr_board1/product_top4/rtl/board1_context2048_ddr_preboard_locked_boundary.sv
LOCAL_BUILD/swic-tang-native-z6b9e5us/project/fpga/token_only_model0_ddr_board1/product_top4/rtl/board1_context2048_semantic_image_auth_compact.sv
LOCAL_BUILD/swic-tang-native-z6b9e5us/project/fpga/token_only_model0_ddr_board1/product8_timing_successor2/rtl/board1_context2048_ddr_locked_auth_watchdog_cdc.sv
LOCAL_BUILD/swic-tang-native-z6b9e5us/project/handoff.sv
LOCAL_BUILD/swic-tang-native-z6b9e5us/project/booted_memory.sv
LOCAL_BUILD/swic-tang-native-z6b9e5us/project/fpga/token_only_model0_ddr_board1/product_top4/rtl/board1_context2048_qspi_read03_master.sv
LOCAL_BUILD/swic-tang-native-z6b9e5us/project/fpga/token_only_model0_ddr_board1/product8_timing_successor2/rtl/board1_qspi_async_word_fifo4.sv
LOCAL_BUILD/swic-tang-native-z6b9e5us/project/fpga/token_only_model0_ddr_board1/product8_timing_successor2/rtl/board1_context2048_qspi_image_stream.sv
LOCAL_BUILD/swic-tang-native-z6b9e5us/project/fpga/token_only_model0_mac_uart0/rtl/fixed_uart_rx.sv
LOCAL_BUILD/swic-tang-native-z6b9e5us/project/fpga/token_only_model0_mac_uart0/rtl/fixed_uart_tx.sv
LOCAL_BUILD/swic-tang-native-z6b9e5us/project/fpga/token_only_model0_mac_uart0/rtl/token_only_model0_uart_bridge.sv
LOCAL_BUILD/swic-tang-native-z6b9e5us/project/fpga/token_only_model0_ddr_board1/product_top0/rtl/board1_fixed_command_adapter.sv
LOCAL_BUILD/swic-tang-native-z6b9e5us/project/fpga/token_only_model0_ddr_board1/product_top0/rtl/board1_fixed_endpoint_fault_cdc.sv
LOCAL_BUILD/swic-tang-native-z6b9e5us/project/fpga/token_only_model0_ddr_board1/product8_timing_successor1/rtl/board1_gowin_ddr3_raw_controller_shell.sv
LOCAL_BUILD/swic-tang-native-z6b9e5us/project/reset.sv
LOCAL_BUILD/swic-tang-native-z6b9e5us/project/uart_core.sv
LOCAL_BUILD/swic-tang-native-z6b9e5us/project/thin_transport.sv
LOCAL_BUILD/swic-tang-native-z6b9e5us/project/top.sv
LOCAL_BUILD/swic-tang-native-z6b9e5us/project/swic/su_sha256.sv
LOCAL_BUILD/swic-tang-native-z6b9e5us/project/swic/su_lms_verify.sv
LOCAL_BUILD/swic-tang-native-z6b9e5us/project/swic/swic_boot_admission.sv
LOCAL_BUILD/swic-tang-native-z6b9e5us/project/swic/su_image_check.sv
LOCAL_BUILD/swic-tang-native-z6b9e5us/project/swic/swic_read03_master.sv
LOCAL_BUILD/swic-tang-native-z6b9e5us/project/swic/swic_qspi_boot_source.sv
LOCAL_BUILD/swic-tang-native-z6b9e5us/project/swic/swic_boot_ingress.sv
LOCAL_BUILD/swic-tang-native-z6b9e5us/project/swic/swic_norm_store.sv
LOCAL_BUILD/swic-tang-native-z6b9e5us/project/swic/swic_ddr_boot.sv
GowinSynthesis Constraints File | ---
Tool Version | V1.9.11.03 Education
Part Number | GW5AST-LV138PG484AC1/I0
Device | GW5AST-138
Device Version | C
Created Time | Tue Nov 3 19:05:30 2026
Legal Announcement | Copyright (C)2014-2025 Gowin Semiconductor Corporation. ALL rights reserved.

# Synthesis Details

Top Level Module | board1_fixed_swic_product_top

Synthesis Process

Running parser:
CPU time = 0h 0m 4s, Elapsed time = 0h 0m 4s, Peak memory usage = 932.109MB
Running netlist conversion:
CPU time = 0h 0m 0s, Elapsed time = 0h 0m 0s, Peak memory usage = 0MB
Running device independent optimization:
Optimizing Phase 0: CPU time = 0h 0m 7s, Elapsed time = 0h 0m 7s, Peak memory usage = 935.375MB
Optimizing Phase 1: CPU time = 0h 0m 7s, Elapsed time = 0h 0m 7s, Peak memory usage = 936.109MB
Optimizing Phase 2: CPU time = 0h 0m 35s, Elapsed time = 0h 0m 35s, Peak memory usage = 937.141MB
Running inference:
Inferring Phase 0: CPU time = 0h 0m 36s, Elapsed time = 0h 0m 36s, Peak memory usage = 937.141MB
Inferring Phase 1: CPU time = 0h 1m 53s, Elapsed time = 0h 1m 53s, Peak memory usage = 1901.672MB
Inferring Phase 2: CPU time = 0h 0m 0.425s, Elapsed time = 0h 0m 0.426s, Peak memory usage = 1901.719MB
Inferring Phase 3: CPU time = 0h 0m 0.352s, Elapsed time = 0h 0m 0.353s, Peak memory usage = 1901.766MB
Running technical mapping:
Tech-Mapping Phase 0: CPU time = 0h 0m 15s, Elapsed time = 0h 0m 15s, Peak memory usage = 1906.203MB
Tech-Mapping Phase 1: CPU time = 0h 0m 5s, Elapsed time = 0h 0m 5s, Peak memory usage = 1906.203MB
Tech-Mapping Phase 2: CPU time = 0h 0m 4s, Elapsed time = 0h 0m 4s, Peak memory usage = 1906.203MB
Tech-Mapping Phase 3: CPU time = 0h 0m 44s, Elapsed time = 0h 0m 45s, Peak memory usage = 2176.750MB
Tech-Mapping Phase 4: CPU time = 0h 0m 8s, Elapsed time = 0h 0m 8s, Peak memory usage = 2178.141MB
Generate output files:
CPU time = 0h 0m 13s, Elapsed time = 0h 0m 13s, Peak memory usage = 3137.219MB
Total Time and Memory Usage | CPU time = 0h 4m 51s, Elapsed time = 0h 4m 52s, Peak memory usage = 3137.219MB

# Resource

## Resource Usage Summary

Resource | Usage
I/O Port | 81
I/O Buf | 76
IBUF | 3
OBUF | 28
TBUF | 7
IOBUF | 33
ELVDS_OBUF | 1
ELVDS_IOBUF | 4
Register | 55877
DFFSE | 12
DFFRE | 19753
DFFPE | 735
DFFCE | 35377
LUT | 78424
LUT2 | 8771
LUT3 | 34500
LUT4 | 35153
ALU | 12847
ALU | 12847
SSRAM | 1133
RAM16S4 | 32
RAM16SDP1 | 6
RAM16SDP4 | 1095
INV | 199
INV | 199
IOLOGIC | 129
IDES8_MEM | 32
OSER8 | 25
OSER8_MEM | 40
IODELAY | 32
DSP
MULTALU27X18 | 89
MULT12X12 | 4
BSRAM | 246
SDPB | 219
SDPX9B | 19
pROM | 8
CLOCK | 9
PLL | 1
CLKDIV | 3
DQS | 4
DDRDLL | 1

## Resource Utilization Summary

Resource | Usage | Utilization
Logic | 98268(78623 LUT, 12847 ALU, 1133 RAM16) / 138240 | 72%
Register | 55877 / 139095 | 41%
--Register as Latch | 0 / 139095 | 0%
--Register as FF | 55877 / 139095 | 41%
BSRAM | 246 / 340 | 73%

# Timing

## Clock Summary:

NO. | Clock Name | Type | Period | Frequency(MHz) | Rise | Fall | Source | Master | Object
1 | clk_50mhz | Base | 20.000 | 50.000 | 0.000 | 10.000 | | | clk_50mhz_ibuf/I
2 | u_raw_controller/u_board_ddr_pll/u_pll/PLL_inst/CLKOUT1.default_gen_clk | Generated | 20.000 | 50.000 | 0.000 | 10.000 | clk_50mhz_ibuf/I | clk_50mhz | u_raw_controller/u_board_ddr_pll/u_pll/PLL_inst/CLKOUT1
3 | u_raw_controller/u_board_ddr_pll/u_pll/PLL_inst/CLKOUT2.default_gen_clk | Generated | 2.500 | 400.000 | 0.000 | 1.250 | clk_50mhz_ibuf/I | clk_50mhz | u_raw_controller/u_board_ddr_pll/u_pll/PLL_inst/CLKOUT2
4 | u_raw_controller/u_trusted_clkdiv/CLKOUT.default_gen_clk | Generated | 80.000 | 12.500 | 0.000 | 40.000 | u_raw_controller/u_board_ddr_pll/u_pll/PLL_inst/CLKOUT1 | u_raw_controller/u_board_ddr_pll/u_pll/PLL_inst/CLKOUT1.default_gen_clk | u_raw_controller/u_trusted_clkdiv/CLKOUT
5 | u_raw_controller/u_core_clkdiv/CLKOUT.default_gen_clk | Generated | 40.000 | 25.000 | 0.000 | 20.000 | u_raw_controller/u_board_ddr_pll/u_pll/PLL_inst/CLKOUT1 | u_raw_controller/u_board_ddr_pll/u_pll/PLL_inst/CLKOUT1.default_gen_clk | u_raw_controller/u_core_clkdiv/CLKOUT
6 | u_raw_controller/u_ddr3/gw3_top/u_ddr_phy_top/fclkdiv/CLKOUT.default_gen_clk | Generated | 10.000 | 100.000 | 0.000 | 5.000 | u_raw_controller/u_board_ddr_pll/u_pll/PLL_inst/CLKOUT2 | u_raw_controller/u_board_ddr_pll/u_pll/PLL_inst/CLKOUT2.default_gen_clk | u_raw_controller/u_ddr3/gw3_top/u_ddr_phy_top/fclkdiv/CLKOUT

## Max Frequency Summary:

NO. | Clock Name | Constraint | Actual Fmax | Logic Level | Entity
1 | clk_50mhz | 50.000(MHz) | 207.308(MHz) | 5 | TOP
2 | u_raw_controller/u_board_ddr_pll/u_pll/PLL_inst/CLKOUT2.default_gen_clk | 400.000(MHz) | 1115.449(MHz) | 1 | TOP
3 | u_raw_controller/u_trusted_clkdiv/CLKOUT.default_gen_clk | 12.500(MHz) | 68.823(MHz) | 15 | TOP
4 | u_raw_controller/u_core_clkdiv/CLKOUT.default_gen_clk | 25.000(MHz) | 25.426(MHz) | 39 | TOP
5 | u_raw_controller/u_ddr3/gw3_top/u_ddr_phy_top/fclkdiv/CLKOUT.default_gen_clk | 100.000(MHz) | 161.225(MHz) | 3 | TOP

## Detail Timing Paths Information

### Path 1

Path Summary:

Slack | -1.163
Data Arrival Time | 2.579
Data Required Time | 1.416
From | u_raw_controller/u_ddr3/gw3_top/u_ddr_phy_top/u_ddr_init/read_rclksel_conf_3_s0
To | u_raw_controller/u_ddr3/gw3_top/u_ddr_phy_top/u_ddr_phy_wds/data_lane_gen[3].u_ddr_phy_data_lane/u_ddr_phy_data_io/u_dqs
Launch Clk | u_raw_controller/u_ddr3/gw3_top/u_ddr_phy_top/fclkdiv/CLKOUT.default_gen_clk[F]
Latch Clk | u_raw_controller/u_board_ddr_pll/u_pll/PLL_inst/CLKOUT2.default_gen_clk[R]

Data Arrival Path:

AT | DELAY | TYPE | RF | FANOUT | NODE
0.000 | 0.000 | | | | u_raw_controller/u_ddr3/gw3_top/u_ddr_phy_top/fclkdiv/CLKOUT.default_gen_clk
0.381 | 0.381 | tCL | RR | 6194 | u_raw_controller/u_ddr3/gw3_top/u_ddr_phy_top/fclkdiv/CLKOUT
0.793 | 0.413 | tNET | RR | 1 | u_raw_controller/u_ddr3/gw3_top/u_ddr_phy_top/u_ddr_init/read_rclksel_conf_3_s0/CLK
1.176 | 0.382 | tC2Q | RR | 10 | u_raw_controller/u_ddr3/gw3_top/u_ddr_phy_top/u_ddr_init/read_rclksel_conf_3_s0/Q
1.588 | 0.413 | tNET | RR | 1 | u_raw_controller/u_ddr3/gw3_top/u_ddr_phy_top/u_ddr_init/hold_Z_3_s/I0
2.167 | 0.579 | tINS | RR | 1 | u_raw_controller/u_ddr3/gw3_top/u_ddr_phy_top/u_ddr_init/hold_Z_3_s/F
2.579 | 0.413 | tNET | RR | 1 | u_raw_controller/u_ddr3/gw3_top/u_ddr_phy_top/u_ddr_phy_wds/data_lane_gen[3].u_ddr_phy_data_lane/u_ddr_phy_data_io/u_dqs/HOLD

Data Required Path:

AT | DELAY | TYPE | RF | FANOUT | NODE
1.250 | 0.000 | | | | u_raw_controller/u_board_ddr_pll/u_pll/PLL_inst/CLKOUT2.default_gen_clk
1.550 | 0.300 | tCL | FF | 103 | u_raw_controller/u_board_ddr_pll/u_pll/PLL_inst/CLKOUT2
1.935 | 0.385 | tNET | FF | 1 | u_raw_controller/u_ddr3/gw3_top/u_ddr_phy_top/u_ddr_phy_wds/data_lane_gen[3].u_ddr_phy_data_lane/u_ddr_phy_data_io/u_dqs/FCLK
1.900 | -0.035 | tUnc | | | u_raw_controller/u_ddr3/gw3_top/u_ddr_phy_top/u_ddr_phy_wds/data_lane_gen[3].u_ddr_phy_data_lane/u_ddr_phy_data_io/u_dqs
1.416 | -0.484 | tSu | | 1 | u_raw_controller/u_ddr3/gw3_top/u_ddr_phy_top/u_ddr_phy_wds/data_lane_gen[3].u_ddr_phy_data_lane/u_ddr_phy_data_io/u_dqs

Path Statistics:

Clock Skew: | -0.108
Setup Relationship: | 1.250
Logic Level: | 2
Arrival Clock Path Delay: | cell: 0.000, 0.000%; route: 0.413, 100.000%
Arrival Data Path Delay: | cell: 0.579, 32.400%; route: 0.825, 46.186%; tC2Q: 0.382, 21.414%
Required Clock Path Delay: | cell: 0.000, 0.000%; route: 0.413, 100.000%

### Path 2

Path Summary:

Slack | -1.163
Data Arrival Time | 2.579
Data Required Time | 1.416
From | u_raw_controller/u_ddr3/gw3_top/u_ddr_phy_top/u_ddr_init/read_rclksel_conf_2_s0
To | u_raw_controller/u_ddr3/gw3_top/u_ddr_phy_top/u_ddr_phy_wds/data_lane_gen[2].u_ddr_phy_data_lane/u_ddr_phy_data_io/u_dqs
Launch Clk | u_raw_controller/u_ddr3/gw3_top/u_ddr_phy_top/fclkdiv/CLKOUT.default_gen_clk[F]
Latch Clk | u_raw_controller/u_board_ddr_pll/u_pll/PLL_inst/CLKOUT2.default_gen_clk[R]

Data Arrival Path:

AT | DELAY | TYPE | RF | FANOUT | NODE
0.000 | 0.000 | | | | u_raw_controller/u_ddr3/gw3_top/u_ddr_phy_top/fclkdiv/CLKOUT.default_gen_clk
0.381 | 0.381 | tCL | RR | 6194 | u_raw_controller/u_ddr3/gw3_top/u_ddr_phy_top/fclkdiv/CLKOUT
0.793 | 0.413 | tNET | RR | 1 | u_raw_controller/u_ddr3/gw3_top/u_ddr_phy_top/u_ddr_init/read_rclksel_conf_2_s0/CLK
1.176 | 0.382 | tC2Q | RR | 10 | u_raw_controller/u_ddr3/gw3_top/u_ddr_phy_top/u_ddr_init/read_rclksel_conf_2_s0/Q
1.588 | 0.413 | tNET | RR | 1 | u_raw_controller/u_ddr3/gw3_top/u_ddr_phy_top/u_ddr_init/hold_Z_2_s/I0
2.167 | 0.579 | tINS | RR | 1 | u_raw_controller/u_ddr3/gw3_top/u_ddr_phy_top/u_ddr_init/hold_Z_2_s/F
2.579 | 0.413 | tNET | RR | 1 | u_raw_controller/u_ddr3/gw3_top/u_ddr_phy_top/u_ddr_phy_wds/data_lane_gen[2].u_ddr_phy_data_lane/u_ddr_phy_data_io/u_dqs/HOLD

Data Required Path:

AT | DELAY | TYPE | RF | FANOUT | NODE
1.250 | 0.000 | | | | u_raw_controller/u_board_ddr_pll/u_pll/PLL_inst/CLKOUT2.default_gen_clk
1.550 | 0.300 | tCL | FF | 103 | u_raw_controller/u_board_ddr_pll/u_pll/PLL_inst/CLKOUT2
1.935 | 0.385 | tNET | FF | 1 | u_raw_controller/u_ddr3/gw3_top/u_ddr_phy_top/u_ddr_phy_wds/data_lane_gen[2].u_ddr_phy_data_lane/u_ddr_phy_data_io/u_dqs/FCLK
1.900 | -0.035 | tUnc | | | u_raw_controller/u_ddr3/gw3_top/u_ddr_phy_top/u_ddr_phy_wds/data_lane_gen[2].u_ddr_phy_data_lane/u_ddr_phy_data_io/u_dqs
1.416 | -0.484 | tSu | | 1 | u_raw_controller/u_ddr3/gw3_top/u_ddr_phy_top/u_ddr_phy_wds/data_lane_gen[2].u_ddr_phy_data_lane/u_ddr_phy_data_io/u_dqs

Path Statistics:

Clock Skew: | -0.108
Setup Relationship: | 1.250
Logic Level: | 2
Arrival Clock Path Delay: | cell: 0.000, 0.000%; route: 0.413, 100.000%
Arrival Data Path Delay: | cell: 0.579, 32.400%; route: 0.825, 46.186%; tC2Q: 0.382, 21.414%
Required Clock Path Delay: | cell: 0.000, 0.000%; route: 0.413, 100.000%

### Path 3

Path Summary:

Slack | -1.163
Data Arrival Time | 2.579
Data Required Time | 1.416
From | u_raw_controller/u_ddr3/gw3_top/u_ddr_phy_top/u_ddr_init/read_rclksel_conf_1_s0
To | u_raw_controller/u_ddr3/gw3_top/u_ddr_phy_top/u_ddr_phy_wds/data_lane_gen[1].u_ddr_phy_data_lane/u_ddr_phy_data_io/u_dqs
Launch Clk | u_raw_controller/u_ddr3/gw3_top/u_ddr_phy_top/fclkdiv/CLKOUT.default_gen_clk[F]
Latch Clk | u_raw_controller/u_board_ddr_pll/u_pll/PLL_inst/CLKOUT2.default_gen_clk[R]

Data Arrival Path:

AT | DELAY | TYPE | RF | FANOUT | NODE
0.000 | 0.000 | | | | u_raw_controller/u_ddr3/gw3_top/u_ddr_phy_top/fclkdiv/CLKOUT.default_gen_clk
0.381 | 0.381 | tCL | RR | 6194 | u_raw_controller/u_ddr3/gw3_top/u_ddr_phy_top/fclkdiv/CLKOUT
0.793 | 0.413 | tNET | RR | 1 | u_raw_controller/u_ddr3/gw3_top/u_ddr_phy_top/u_ddr_init/read_rclksel_conf_1_s0/CLK
1.176 | 0.382 | tC2Q | RR | 10 | u_raw_controller/u_ddr3/gw3_top/u_ddr_phy_top/u_ddr_init/read_rclksel_conf_1_s0/Q
1.588 | 0.413 | tNET | RR | 1 | u_raw_controller/u_ddr3/gw3_top/u_ddr_phy_top/u_ddr_init/hold_Z_1_s/I0
2.167 | 0.579 | tINS | RR | 1 | u_raw_controller/u_ddr3/gw3_top/u_ddr_phy_top/u_ddr_init/hold_Z_1_s/F
2.579 | 0.413 | tNET | RR | 1 | u_raw_controller/u_ddr3/gw3_top/u_ddr_phy_top/u_ddr_phy_wds/data_lane_gen[1].u_ddr_phy_data_lane/u_ddr_phy_data_io/u_dqs/HOLD

Data Required Path:

AT | DELAY | TYPE | RF | FANOUT | NODE
1.250 | 0.000 | | | | u_raw_controller/u_board_ddr_pll/u_pll/PLL_inst/CLKOUT2.default_gen_clk
1.550 | 0.300 | tCL | FF | 103 | u_raw_controller/u_board_ddr_pll/u_pll/PLL_inst/CLKOUT2
1.935 | 0.385 | tNET | FF | 1 | u_raw_controller/u_ddr3/gw3_top/u_ddr_phy_top/u_ddr_phy_wds/data_lane_gen[1].u_ddr_phy_data_lane/u_ddr_phy_data_io/u_dqs/FCLK
1.900 | -0.035 | tUnc | | | u_raw_controller/u_ddr3/gw3_top/u_ddr_phy_top/u_ddr_phy_wds/data_lane_gen[1].u_ddr_phy_data_lane/u_ddr_phy_data_io/u_dqs
1.416 | -0.484 | tSu | | 1 | u_raw_controller/u_ddr3/gw3_top/u_ddr_phy_top/u_ddr_phy_wds/data_lane_gen[1].u_ddr_phy_data_lane/u_ddr_phy_data_io/u_dqs

Path Statistics:

Clock Skew: | -0.108
Setup Relationship: | 1.250
Logic Level: | 2
Arrival Clock Path Delay: | cell: 0.000, 0.000%; route: 0.413, 100.000%
Arrival Data Path Delay: | cell: 0.579, 32.400%; route: 0.825, 46.186%; tC2Q: 0.382, 21.414%
Required Clock Path Delay: | cell: 0.000, 0.000%; route: 0.413, 100.000%

### Path 4

Path Summary:

Slack | -1.163
Data Arrival Time | 2.579
Data Required Time | 1.416
From | u_raw_controller/u_ddr3/gw3_top/u_ddr_phy_top/u_ddr_init/read_rclksel_conf_0_s0
To | u_raw_controller/u_ddr3/gw3_top/u_ddr_phy_top/u_ddr_phy_wds/data_lane_gen[0].u_ddr_phy_data_lane/u_ddr_phy_data_io/u_dqs
Launch Clk | u_raw_controller/u_ddr3/gw3_top/u_ddr_phy_top/fclkdiv/CLKOUT.default_gen_clk[F]
Latch Clk | u_raw_controller/u_board_ddr_pll/u_pll/PLL_inst/CLKOUT2.default_gen_clk[R]

Data Arrival Path:

AT | DELAY | TYPE | RF | FANOUT | NODE
0.000 | 0.000 | | | | u_raw_controller/u_ddr3/gw3_top/u_ddr_phy_top/fclkdiv/CLKOUT.default_gen_clk
0.381 | 0.381 | tCL | RR | 6194 | u_raw_controller/u_ddr3/gw3_top/u_ddr_phy_top/fclkdiv/CLKOUT
0.793 | 0.413 | tNET | RR | 1 | u_raw_controller/u_ddr3/gw3_top/u_ddr_phy_top/u_ddr_init/read_rclksel_conf_0_s0/CLK
1.176 | 0.382 | tC2Q | RR | 10 | u_raw_controller/u_ddr3/gw3_top/u_ddr_phy_top/u_ddr_init/read_rclksel_conf_0_s0/Q
1.588 | 0.413 | tNET | RR | 1 | u_raw_controller/u_ddr3/gw3_top/u_ddr_phy_top/u_ddr_init/hold_Z_0_s/I0
2.167 | 0.579 | tINS | RR | 1 | u_raw_controller/u_ddr3/gw3_top/u_ddr_phy_top/u_ddr_init/hold_Z_0_s/F
2.579 | 0.413 | tNET | RR | 1 | u_raw_controller/u_ddr3/gw3_top/u_ddr_phy_top/u_ddr_phy_wds/data_lane_gen[0].u_ddr_phy_data_lane/u_ddr_phy_data_io/u_dqs/HOLD

Data Required Path:

AT | DELAY | TYPE | RF | FANOUT | NODE
1.250 | 0.000 | | | | u_raw_controller/u_board_ddr_pll/u_pll/PLL_inst/CLKOUT2.default_gen_clk
1.550 | 0.300 | tCL | FF | 103 | u_raw_controller/u_board_ddr_pll/u_pll/PLL_inst/CLKOUT2
1.935 | 0.385 | tNET | FF | 1 | u_raw_controller/u_ddr3/gw3_top/u_ddr_phy_top/u_ddr_phy_wds/data_lane_gen[0].u_ddr_phy_data_lane/u_ddr_phy_data_io/u_dqs/FCLK
1.900 | -0.035 | tUnc | | | u_raw_controller/u_ddr3/gw3_top/u_ddr_phy_top/u_ddr_phy_wds/data_lane_gen[0].u_ddr_phy_data_lane/u_ddr_phy_data_io/u_dqs
1.416 | -0.484 | tSu | | 1 | u_raw_controller/u_ddr3/gw3_top/u_ddr_phy_top/u_ddr_phy_wds/data_lane_gen[0].u_ddr_phy_data_lane/u_ddr_phy_data_io/u_dqs

Path Statistics:

Clock Skew: | -0.108
Setup Relationship: | 1.250
Logic Level: | 2
Arrival Clock Path Delay: | cell: 0.000, 0.000%; route: 0.413, 100.000%
Arrival Data Path Delay: | cell: 0.579, 32.400%; route: 0.825, 46.186%; tC2Q: 0.382, 21.414%
Required Clock Path Delay: | cell: 0.000, 0.000%; route: 0.413, 100.000%

### Path 5

Path Summary:

Slack | 0.670
Data Arrival Time | 39.751
Data Required Time | 40.421
From | u_uart_core/u_machine/u_machine/u_six_layers/u_datapath/u_attention/u_workspace_bram/bank0_mem_bank0_mem_0_0_s
To | u_uart_core/u_machine/u_machine/u_six_layers/u_datapath/u_attention/u_norm_stage/first_fit_o_7_s0
Launch Clk | u_raw_controller/u_core_clkdiv/CLKOUT.default_gen_clk[R]
Latch Clk | u_raw_controller/u_core_clkdiv/CLKOUT.default_gen_clk[R]

Data Arrival Path:

AT | DELAY | TYPE | RF | FANOUT | NODE
0.000 | 0.000 | | | | u_raw_controller/u_core_clkdiv/CLKOUT.default_gen_clk
0.381 | 0.381 | tCL | RR | 51169 | u_raw_controller/u_core_clkdiv/CLKOUT
0.793 | 0.413 | tNET | RR | 2 | u_uart_core/u_machine/u_machine/u_six_layers/u_datapath/u_attention/u_workspace_bram/bank0_mem_bank0_mem_0_0_s/CLKB
2.803 | 2.010 | tC2Q | RR | 14 | u_uart_core/u_machine/u_machine/u_six_layers/u_datapath/u_attention/u_workspace_bram/bank0_mem_bank0_mem_0_0_s/DO[1]
3.216 | 0.413 | tNET | RR | 1 | u_uart_core/u_machine/u_machine/u_six_layers/u_datapath/u_attention/u_shift/n3182_s5/I0
3.794 | 0.579 | tINS | RR | 7 | u_uart_core/u_machine/u_machine/u_six_layers/u_datapath/u_attention/u_shift/n3182_s5/F
4.207 | 0.413 | tNET | RR | 1 | u_uart_core/u_machine/u_machine/u_six_layers/u_datapath/u_attention/u_norm_stage/n527_s58/I0
4.786 | 0.579 | tINS | RR | 1 | u_uart_core/u_machine/u_machine/u_six_layers/u_datapath/u_attention/u_norm_stage/n527_s58/F
5.198 | 0.413 | tNET | RR | 1 | u_uart_core/u_machine/u_machine/u_six_layers/u_datapath/u_attention/u_norm_stage/n527_s52/I0
5.777 | 0.579 | tINS | RR | 1 | u_uart_core/u_machine/u_machine/u_six_layers/u_datapath/u_attention/u_norm_stage/n527_s52/F
6.189 | 0.413 | tNET | RR | 1 | u_uart_core/u_machine/u_machine/u_six_layers/u_datapath/u_attention/u_norm_stage/n527_s50/I2
6.697 | 0.507 | tINS | RR | 2 | u_uart_core/u_machine/u_machine/u_six_layers/u_datapath/u_attention/u_norm_stage/n527_s50/F
7.109 | 0.413 | tNET | RR | 1 | u_uart_core/u_machine/u_machine/u_six_layers/u_datapath/u_attention/u_norm_stage/n527_s48/I0
7.688 | 0.579 | tINS | RR | 1 | u_uart_core/u_machine/u_machine/u_six_layers/u_datapath/u_attention/u_norm_stage/n527_s48/F
8.101 | 0.413 | tNET | RR | 1 | u_uart_core/u_machine/u_machine/u_six_layers/u_datapath/u_attention/u_norm_stage/n527_s47/I0
8.679 | 0.579 | tINS | RR | 2 | u_uart_core/u_machine/u_machine/u_six_layers/u_datapath/u_attention/u_norm_stage/n527_s47/F
9.092 | 0.413 | tNET | RR | 1 | u_uart_core/u_machine/u_machine/u_six_layers/u_datapath/u_attention/u_norm_stage/n527_s45/I0
9.671 | 0.579 | tINS | RR | 1 | u_uart_core/u_machine/u_machine/u_six_layers/u_datapath/u_attention/u_norm_stage/n527_s45/F
10.083 | 0.413 | tNET | RR | 1 | u_uart_core/u_machine/u_machine/u_six_layers/u_datapath/u_attention/u_norm_stage/n527_s44/I0
10.662 | 0.579 | tINS | RR | 2 | u_uart_core/u_machine/u_machine/u_six_layers/u_datapath/u_attention/u_norm_stage/n527_s44/F
11.074 | 0.413 | tNET | RR | 1 | u_uart_core/u_machine/u_machine/u_six_layers/u_datapath/u_attention/u_norm_stage/n527_s42/I0
11.653 | 0.579 | tINS | RR | 1 | u_uart_core/u_machine/u_machine/u_six_layers/u_datapath/u_attention/u_norm_stage/n527_s42/F
12.066 | 0.413 | tNET | RR | 1 | u_uart_core/u_machine/u_machine/u_six_layers/u_datapath/u_attention/u_norm_stage/n527_s57/I0
12.644 | 0.579 | tINS | RR | 1 | u_uart_core/u_machine/u_machine/u_six_layers/u_datapath/u_attention/u_norm_stage/n527_s57/F
13.057 | 0.413 | tNET | RR | 1 | u_uart_core/u_machine/u_machine/u_six_layers/u_datapath/u_attention/u_norm_stage/n527_s38/I0
13.636 | 0.579 | tINS | RR | 1 | u_uart_core/u_machine/u_machine/u_six_layers/u_datapath/u_attention/u_norm_stage/n527_s38/F
14.048 | 0.413 | tNET | RR | 1 | u_uart_core/u_machine/u_machine/u_six_layers/u_datapath/u_attention/u_norm_stage/n527_s36/I1
14.616 | 0.567 | tINS | RR | 2 | u_uart_core/u_machine/u_machine/u_six_layers/u_datapath/u_attention/u_norm_stage/n527_s36/F
15.028 | 0.413 | tNET | RR | 1 | u_uart_core/u_machine/u_machine/u_six_layers/u_datapath/u_attention/u_norm_stage/n527_s34/I0
15.607 | 0.579 | tINS | RR | 1 | u_uart_core/u_machine/u_machine/u_six_layers/u_datapath/u_attention/u_norm_stage/n527_s34/F
16.019 | 0.413 | tNET | RR | 1 | u_uart_core/u_machine/u_machine/u_six_layers/u_datapath/u_attention/u_norm_stage/n527_s32/I0
16.598 | 0.579 | tINS | RR | 2 | u_uart_core/u_machine/u_machine/u_six_layers/u_datapath/u_attention/u_norm_stage/n527_s32/F
17.011 | 0.413 | tNET | RR | 1 | u_uart_core/u_machine/u_machine/u_six_layers/u_datapath/u_attention/u_norm_stage/n527_s30/I0
17.589 | 0.579 | tINS | RR | 1 | u_uart_core/u_machine/u_machine/u_six_layers/u_datapath/u_attention/u_norm_stage/n527_s30/F
18.002 | 0.413 | tNET | RR | 1 | u_uart_core/u_machine/u_machine/u_six_layers/u_datapath/u_attention/u_norm_stage/n527_s29/I1
18.569 | 0.567 | tINS | RR | 2 | u_uart_core/u_machine/u_machine/u_six_layers/u_datapath/u_attention/u_norm_stage/n527_s29/F
18.982 | 0.413 | tNET | RR | 1 | u_uart_core/u_machine/u_machine/u_six_layers/u_datapath/u_attention/u_norm_stage/n527_s27/I0
19.561 | 0.579 | tINS | RR | 1 | u_uart_core/u_machine/u_machine/u_six_layers/u_datapath/u_attention/u_norm_stage/n527_s27/F
19.973 | 0.413 | tNET | RR | 1 | u_uart_core/u_machine/u_machine/u_six_layers/u_datapath/u_attention/u_norm_stage/n527_s25/I0
20.552 | 0.579 | tINS | RR | 3 | u_uart_core/u_machine/u_machine/u_six_layers/u_datapath/u_attention/u_norm_stage/n527_s25/F
20.964 | 0.413 | tNET | RR | 1 | u_uart_core/u_machine/u_machine/u_six_layers/u_datapath/u_attention/u_norm_stage/n527_s26/I1
21.532 | 0.567 | tINS | RR | 1 | u_uart_core/u_machine/u_machine/u_six_layers/u_datapath/u_attention/u_norm_stage/n527_s26/F
21.944 | 0.413 | tNET | RR | 1 | u_uart_core/u_machine/u_machine/u_six_layers/u_datapath/u_attention/u_norm_stage/n527_s24/I2
22.452 | 0.507 | tINS | RR | 1 | u_uart_core/u_machine/u_machine/u_six_layers/u_datapath/u_attention/u_norm_stage/n527_s24/F
22.864 | 0.413 | tNET | RR | 1 | u_uart_core/u_machine/u_machine/u_six_layers/u_datapath/u_attention/u_norm_stage/n527_s22/I2
23.372 | 0.507 | tINS | RR | 2 | u_uart_core/u_machine/u_machine/u_six_layers/u_datapath/u_attention/u_norm_stage/n527_s22/F
23.784 | 0.413 | tNET | RR | 1 | u_uart_core/u_machine/u_machine/u_six_layers/u_datapath/u_attention/u_norm_stage/n527_s21/I0
24.363 | 0.579 | tINS | RR | 2 | u_uart_core/u_machine/u_machine/u_six_layers/u_datapath/u_attention/u_norm_stage/n527_s21/F
24.776 | 0.413 | tNET | RR | 1 | u_uart_core/u_machine/u_machine/u_six_layers/u_datapath/u_attention/u_norm_stage/n527_s17/I2
25.283 | 0.507 | tINS | RR | 1 | u_uart_core/u_machine/u_machine/u_six_layers/u_datapath/u_attention/u_norm_stage/n527_s17/F
25.696 | 0.413 | tNET | RR | 1 | u_uart_core/u_machine/u_machine/u_six_layers/u_datapath/u_attention/u_norm_stage/n527_s15/I0
26.274 | 0.579 | tINS | RR | 1 | u_uart_core/u_machine/u_machine/u_six_layers/u_datapath/u_attention/u_norm_stage/n527_s15/F
26.687 | 0.413 | tNET | RR | 1 | u_uart_core/u_machine/u_machine/u_six_layers/u_datapath/u_attention/u_norm_stage/n527_s14/I1
27.254 | 0.567 | tINS | RR | 2 | u_uart_core/u_machine/u_machine/u_six_layers/u_datapath/u_attention/u_norm_stage/n527_s14/F
27.667 | 0.413 | tNET | RR | 1 | u_uart_core/u_machine/u_machine/u_six_layers/u_datapath/u_attention/u_norm_stage/n527_s12/I0
28.246 | 0.579 | tINS | RR | 1 | u_uart_core/u_machine/u_machine/u_six_layers/u_datapath/u_attention/u_norm_stage/n527_s12/F
28.658 | 0.413 | tNET | RR | 1 | u_uart_core/u_machine/u_machine/u_six_layers/u_datapath/u_attention/u_norm_stage/n527_s10/I0
29.237 | 0.579 | tINS | RR | 3 | u_uart_core/u_machine/u_machine/u_six_layers/u_datapath/u_attention/u_norm_stage/n527_s10/F
29.649 | 0.413 | tNET | RR | 1 | u_uart_core/u_machine/u_machine/u_six_layers/u_datapath/u_attention/u_norm_stage/n527_s11/I1
30.217 | 0.567 | tINS | RR | 1 | u_uart_core/u_machine/u_machine/u_six_layers/u_datapath/u_attention/u_norm_stage/n527_s11/F
30.629 | 0.413 | tNET | RR | 1 | u_uart_core/u_machine/u_machine/u_six_layers/u_datapath/u_attention/u_norm_stage/n527_s9/I2
31.137 | 0.507 | tINS | RR | 1 | u_uart_core/u_machine/u_machine/u_six_layers/u_datapath/u_attention/u_norm_stage/n527_s9/F
31.549 | 0.413 | tNET | RR | 1 | u_uart_core/u_machine/u_machine/u_six_layers/u_datapath/u_attention/u_norm_stage/n527_s6/I2
32.057 | 0.507 | tINS | RR | 2 | u_uart_core/u_machine/u_machine/u_six_layers/u_datapath/u_attention/u_norm_stage/n527_s6/F
32.469 | 0.413 | tNET | RR | 1 | u_uart_core/u_machine/u_machine/u_six_layers/u_datapath/u_attention/u_norm_stage/n527_s3/I0
33.048 | 0.579 | tINS | RR | 1 | u_uart_core/u_machine/u_machine/u_six_layers/u_datapath/u_attention/u_norm_stage/n527_s3/F
33.461 | 0.413 | tNET | RR | 1 | u_uart_core/u_machine/u_machine/u_six_layers/u_datapath/u_attention/u_norm_stage/n527_s2/I0
34.039 | 0.579 | tINS | RR | 1 | u_uart_core/u_machine/u_machine/u_six_layers/u_datapath/u_attention/u_norm_stage/n527_s2/F
34.452 | 0.413 | tNET | RR | 2 | u_uart_core/u_machine/u_machine/u_six_layers/u_datapath/u_attention/u_norm_stage/n593_s/I1
35.052 | 0.600 | tINS | RF | 1 | u_uart_core/u_machine/u_machine/u_six_layers/u_datapath/u_attention/u_norm_stage/n593_s/COUT
35.052 | 0.000 | tNET | FF | 2 | u_uart_core/u_machine/u_machine/u_six_layers/u_datapath/u_attention/u_norm_stage/n592_s/CIN
35.102 | 0.050 | tINS | FR | 1 | u_uart_core/u_machine/u_machine/u_six_layers/u_datapath/u_attention/u_norm_stage/n592_s/COUT
35.102 | 0.000 | tNET | RR | 2 | u_uart_core/u_machine/u_machine/u_six_layers/u_datapath/u_attention/u_norm_stage/n591_s/CIN
35.152 | 0.050 | tINS | RR | 1 | u_uart_core/u_machine/u_machine/u_six_layers/u_datapath/u_attention/u_norm_stage/n591_s/COUT
35.152 | 0.000 | tNET | RR | 2 | u_uart_core/u_machine/u_machine/u_six_layers/u_datapath/u_attention/u_norm_stage/n590_s/CIN
35.396 | 0.244 | tINS | RR | 2 | u_uart_core/u_machine/u_machine/u_six_layers/u_datapath/u_attention/u_norm_stage/n590_s/SUM
35.808 | 0.413 | tNET | RR | 1 | u_uart_core/u_machine/u_machine/u_six_layers/u_datapath/u_attention/u_norm_stage/n599_s3/I0
36.387 | 0.579 | tINS | RR | 4 | u_uart_core/u_machine/u_machine/u_six_layers/u_datapath/u_attention/u_norm_stage/n599_s3/F
36.799 | 0.413 | tNET | RR | 1 | u_uart_core/u_machine/u_machine/u_six_layers/u_datapath/u_attention/u_norm_stage/n598_s4/I1
37.367 | 0.567 | tINS | RR | 2 | u_uart_core/u_machine/u_machine/u_six_layers/u_datapath/u_attention/u_norm_stage/n598_s4/F
37.779 | 0.413 | tNET | RR | 1 | u_uart_core/u_machine/u_machine/u_six_layers/u_datapath/u_attention/u_norm_stage/n613_s3/I0
38.358 | 0.579 | tINS | RR | 1 | u_uart_core/u_machine/u_machine/u_six_layers/u_datapath/u_attention/u_norm_stage/n613_s3/F
38.771 | 0.413 | tNET | RR | 1 | u_uart_core/u_machine/u_machine/u_six_layers/u_datapath/u_attention/u_norm_stage/n613_s1/I1
39.338 | 0.567 | tINS | RR | 8 | u_uart_core/u_machine/u_machine/u_six_layers/u_datapath/u_attention/u_norm_stage/n613_s1/F
39.751 | 0.413 | tNET | RR | 1 | u_uart_core/u_machine/u_machine/u_six_layers/u_datapath/u_attention/u_norm_stage/first_fit_o_7_s0/SET

Data Required Path:

AT | DELAY | TYPE | RF | FANOUT | NODE
40.000 | 0.000 | | | | u_raw_controller/u_core_clkdiv/CLKOUT.default_gen_clk
40.381 | 0.381 | tCL | RR | 51169 | u_raw_controller/u_core_clkdiv/CLKOUT
40.793 | 0.413 | tNET | RR | 1 | u_uart_core/u_machine/u_machine/u_six_layers/u_datapath/u_attention/u_norm_stage/first_fit_o_7_s0/CLK
40.421 | -0.373 | tSu | | 1 | u_uart_core/u_machine/u_machine/u_six_layers/u_datapath/u_attention/u_norm_stage/first_fit_o_7_s0

Path Statistics:

Clock Skew: | 0.000
Setup Relationship: | 40.000
Logic Level: | 39
Arrival Clock Path Delay: | cell: 0.000, 0.000%; route: 0.413, 100.000%
Arrival Data Path Delay: | cell: 21.272, 54.605%; route: 15.675, 40.236%; tC2Q: 2.010, 5.159%
Required Clock Path Delay: | cell: 0.000, 0.000%; route: 0.413, 100.000%
