Berkeley-AI-Risk/inference-only/VALIDATION.md

# SimpleStories validation and limits

Read the [current simplestories validation and limits guide](demos/simplestories-v2-5m/VALIDATION.md).
