Berkeley-AI-Risk/inference-only/H100-BENCHMARK.md

# Single-H100 reference inference benchmark

Read [Single-H100 reference inference benchmark](docs/benchmarks/H100-BENCHMARK.md#historical-simplestories-campaign).

[Results](docs/benchmarks/H100-BENCHMARK.md#results)

[What the timing counts](docs/benchmarks/H100-BENCHMARK.md#what-the-timing-counts)

[Numerical acceptance](docs/benchmarks/H100-BENCHMARK.md#numerical-acceptance)

[Environment and reproducibility](docs/benchmarks/H100-BENCHMARK.md#environment-and-reproducibility)

[Performance headroom](docs/benchmarks/H100-BENCHMARK.md#performance-headroom)
