Berkeley-AI-Risk/inference-only/demos/qwen3-8b/VALIDATION.md

# Qwen3-8B: validation and limits

[Guide](README.md) · [Reproduction](REPRODUCE.md) · [Formal scope](FORMAL-STATUS.md)

This page identifies the evidence for the released, authenticated-weight
Qwen3-8B implementation. Its numerical function uses the fixed quantization,
arithmetic and rounding rules described in the [guide](README.md); the comparison
reference implements those rules rather than upstream floating-point Qwen.
The released circuit does not authenticate K/V or encrypt weights.

## Evidence

| Boundary | Records | What they establish |
| --- | --- | --- |
| Common generation workload | [Capture](evidence/common-speed-2026-10-26/capture.json), [source bindings](evidence/common-speed-2026-10-26/source-review.json), [reference record](evidence/common-speed-2026-10-26/reference.json) | Two one-input-token, 128-output greedy trials, with all 256 output IDs matching the fixed-model reference. |
| Additional hardware workloads | [Measurements](measurements.json), [workloads and limits](README.md#additional-validation-workloads) | Finite token comparisons, CLEAR/replay checks and workload-specific host timings. |
| Numerical reference | [Runnable reference](reference/run_reference.py), [recorded checks](evidence/reference.json) | Independent software checks for the stated fixed numerical model and selected cases. |
| Source and implementation | [Source inputs](SOURCE-INPUTS.json), [implementation reports](evidence/implementation/REPORTS.json), [hardware guide](HARDWARE.md) | Identities of the measured build and preserved timing, routing and implementation evidence under its declared constraints. |
| Installation | [Deployment](deployment.json), [rehearsal](evidence/installation.json), [installation guide](INSTALL.md) | Recorded public-image availability and a finite installation/replay test in the image owner's existing SDK environment. |

The [common benchmark](../../docs/benchmarks/FPGA-SPEED-BENCHMARK.md) defines
reply timing and recomputes the selected rates. Additional workloads have their
own prompt lengths and output counts; their timings describe those cases.

## Limits

The longest hardware-tested tape described in the guide has 512 prompt tokens
followed by 16 outputs. The 32,768-token tape capacity is not a hardware-qualified
full-context claim. The installation rehearsal is not a second-account or fresh
operating-system test. Recorded public-image permission can change.

Finite output agreement and implementation reports do not establish all-prompt
numerical correctness, whole-machine formal refinement or resistance to physical
modification. Source hashes identify recorded files; they do not independently
attest the FPGA currently loaded in another machine. The
[formal-status page](FORMAL-STATUS.md) states the verification boundary.

[REPRODUCE.md](REPRODUCE.md) separates offline record checks, fresh numerical
reference execution, hardware tests and source rebuilding.

## Protected K/V component simulation

The separate [opt-in component package](variants/protected-kv-simulation/README.md)
supplies recorded Linux plain/protected/bounds runs, exact source inputs and an
independent scalar/SHA checker. Its honest case covers 36 ordered layer
commits and 9,216 consumed BF16 values at position zero through the first
attention grouped-query pair. Separate layer-35 K and V changes are refused
before affected use; plain controls consume the changed operands. The
transport case checks the final legal digest beat and nine typed refusals.

First-position protected writes total 2,377,728 bytes versus 147,456 plain
bytes (16.125 times). This is whole-page publication traffic for that fixture,
not whole-model overhead or a hardware throughput measurement.

The [recorded evidence](variants/protected-kv-simulation/capsule/EVIDENCE.md) is finite
component simulation, not a formal proof or a protected F2 image. All-head and
complete-model integration, later positions and partial-page updates,
CDC/reset, vendor HBM and physical implementation remain outside this result.
The deployed F2 image uses plain K/V.

## Local software and component checks

The [recorded CPU campaign](evidence/software-campaign-2026-11-05/README.md) matches
197 token IDs across three prompts with the complete fixed numerical engine.
The [dot-product/scale](tests/rtl/README.md) and [RMSNorm](tests/rtl/RMSNORM.md)
harnesses add finite component arithmetic and local protocol regressions. These
checks do not establish whole-core RTL equivalence, CDC closure, FPGA timing or
a hardware speed measurement.
