Berkeley-AI-Risk/inference-only/variants/kv-protected/hardware/project/fpga/token_only_model0_ddr_board1/context2048_token_machine0/rtl/board1_context2048_attention.sv

`timescale 1ns/1ps
`default_nettype none

// Private fixed-geometry causal GQA engine for the selected model.
//
// Geometry is fixed: 4 query heads, 2 KV heads, head dimension64, context
// limit2048. Four head-banked workspaces share each K/V row across its Q pair.
// Eight exact coordinate lanes accelerate QK/PV; private prefix
// summaries replace exponent-only V scans. This mutable experimental variant
// is not the qualified image and requires new numerical/control/board tests.
// The cache seam below is an integration-private, derived-address client; it
// is not a public memory or matrix interface and must remain below the fixed
// model controller.
module board1_context2048_attention #(
    parameter EXP_FILE = "model_rtl_evidence/attention_sublayer/exp_neg_q30.memh",
    parameter integer MAX_COMPUTE_CYCLES = 40_000_000
) (
    input  wire                    clk,
    input  wire                    rst_n,
    input  wire                    clear_i,
    input  wire                    model_lock_i,
    input  wire                    upstream_fault_i,

    input  wire                    start_valid_i,
    output logic                   start_ready_o,
    input  wire [10:0]             fixed_position_i,
    input  wire [2:0]              fixed_layer_i,
    // Accepted private KV staging/commit observations; no transport changes.
    input wire summary_stage_begin_i, summary_stage_value_valid_i,
    input wire [6:0] summary_stage_coordinate_i,
    input wire signed [15:0] summary_stage_value_i,
    input wire signed [7:0] summary_stage_exponent_i,
    input wire summary_pending_complete_i, summary_commit_i,
    input  wire signed [7:0]       query_exponent_i,

    // Four accepted beats, in hardwired query-head order 0,1,2,3.
    input  wire                    query_valid_i,
    output logic                   query_ready_o,
    input  wire [1023:0]           query_vector_i,
    input  wire                    query_last_i,

    // Private fixed-cache client. Exactly one request may be outstanding.
    // The role comes only from the frozen attention schedule, not the host.
    output logic                   private_cache_request_valid_o,
    output logic [1:0]             private_cache_request_kind_o,
    input  wire                    private_cache_request_ready_i,
    output logic [10:0]            private_cache_request_position_o,
    output logic                   private_cache_request_kv_head_o,
    input  wire                    private_cache_response_valid_i,
    output logic                   private_cache_response_ready_o,
    input  wire [1023:0]           private_cache_response_key_vector_i,
    input  wire signed [7:0]       private_cache_response_key_exponent_i,
    input  wire [1023:0]           private_cache_response_value_vector_i,
    input  wire signed [7:0]       private_cache_response_value_exponent_i,
    input  wire                    private_cache_response_fault_i,

    // Four output beats, again in immutable query-head order.
    output logic                   result_valid_o,
    input  wire                    result_ready_i,
    output logic [1023:0]          result_vector_o,
    output logic signed [7:0]      result_exponent_o,
    output logic                   result_last_o,
    output logic                   done_valid_o,
    input  wire                    done_ready_i,
    output logic                   busy_o,
    output logic                   range_fault_o
);
    localparam signed [63:0] I16_MAXIMUM = 64'sd32767;
    localparam signed [63:0] I16_MINIMUM = -64'sd32767;
    // RNE probability rounding can make the 2,048-entry probability sum at
    // most 32767 + 2048/2.  Thus each post-/32767 head output is bounded by
    // +/-33791 and needs 17 signed bits until the final mixed normalization.
    localparam signed [63:0] HEAD_OUTPUT_MAXIMUM = 64'sd33791;
    localparam signed [63:0] HEAD_OUTPUT_MINIMUM = -64'sd33791;
    localparam signed [38:0] SCORE_MAXIMUM_39 = (39'sd1 <<< 36) - 1'b1;
    localparam signed [38:0] SCORE_MINIMUM_39 = -((39'sd1 <<< 36) - 1'b1);

    function automatic signed [7:0] i16_first_fit_exponent(
        input signed [15:0] mantissa,
        input signed [7:0] source_exponent
    );
        logic [15:0] magnitude;
        integer bit_length;
        integer bit_index;
        integer required;
        begin
            if (mantissa == 0) begin
                i16_first_fit_exponent = -8'sd32;
            end else begin
                magnitude = mantissa[15] ? $unsigned(-mantissa) :
                                           $unsigned(mantissa);
                bit_length = 0;
                for (bit_index = 0; bit_index < 15; bit_index = bit_index + 1)
                    if (magnitude[bit_index]) bit_length = bit_index + 1;
                required = $signed(source_exponent) + bit_length - 15;
                if (required < -32)
                    i16_first_fit_exponent = -8'sd32;
                else if (required > 31)
                    i16_first_fit_exponent = 8'sd31;
                else
                    i16_first_fit_exponent = required[7:0];
            end
        end
    endfunction

    function automatic signed [7:0] i64_first_fit_exponent(
        input signed [63:0] value,
        input signed [7:0] source_exponent
    );
        logic [63:0] magnitude;
        integer bit_length;
        integer bit_index;
        integer wide_required;
        begin
            if (value == 0) begin
                i64_first_fit_exponent = -8'sd32;
            end else begin
                magnitude = value[63] ? $unsigned(-value) : $unsigned(value);
                bit_length = 0;
                for (bit_index = 0; bit_index < 64; bit_index = bit_index + 1)
                    if (magnitude[bit_index]) bit_length = bit_index + 1;
                wide_required = $signed(source_exponent) + bit_length - 15;
                if (wide_required < -32)
                    i64_first_fit_exponent = -8'sd32;
                else if (wide_required > 31)
                    i64_first_fit_exponent = 8'sd31;
                else
                    i64_first_fit_exponent = wide_required[7:0];
            end
        end
    endfunction

    typedef enum logic [5:0] {
        ST_IDLE                = 6'd0,
        ST_QUERY_LOAD          = 6'd1,
        ST_VALUE_EXP_REQUEST   = 6'd2,
        ST_VALUE_EXP_WAIT      = 6'd3,
        ST_SCORE_REQUEST       = 6'd4,
        ST_SCORE_WAIT          = 6'd5,
        ST_SCORE_NORM_FIND     = 6'd6,
        ST_SCORE_NORM_WRITE    = 6'd7,
        ST_SCORE_MAX           = 6'd8,
        ST_EXP                 = 6'd9,
        ST_PROBABILITY_REQUEST = 6'd10,
        ST_PROBABILITY_WAIT    = 6'd11,
        ST_VALUE_ZERO          = 6'd12,
        ST_VALUE_REQUEST       = 6'd13,
        ST_VALUE_WAIT          = 6'd14,
        ST_VALUE_DIV_REQUEST   = 6'd15,
        ST_VALUE_DIV_WAIT      = 6'd16,
        ST_NEXT_HEAD           = 6'd17,
        ST_OUTPUT_NORM_FIND    = 6'd18,
        ST_OUTPUT_NORM_WRITE   = 6'd19,
        ST_RESULT              = 6'd20,
        ST_DONE                = 6'd21,
        ST_EXP_WAIT            = 6'd22,
        ST_VALUE_ALIGN         = 6'd23,
        ST_VALUE_ACCUMULATE    = 6'd24,
        ST_VALUE_EXP_SCAN      = 6'd25,
        ST_SCORE_ACCUMULATE    = 6'd26,
        ST_CLEAR_DRAIN         = 6'd27,
        ST_SHIFT_WAIT          = 6'd28,
        ST_EXP_LUT_REQUEST     = 6'd29,
        ST_NORM_SELECT         = 6'd30,
        ST_FAULT               = 6'd31,
        ST_QUERY_STORE         = 6'd32,
        ST_SCORE_QUERY_USE     = 6'd33,
        ST_RESULT_READ         = 6'd34,
        ST_RESULT_CAPTURE      = 6'd35,
        ST_WORKSPACE_READ      = 6'd36,
        ST_OUTPUT_READ         = 6'd37,
        ST_ALIGN8_WAIT         = 6'd38,
        ST_EXP8_WAIT           = 6'd39,
        ST_NORM_CAPTURE        = 6'd40,
        ST_ACCUMULATOR_READ    = 6'd41
    } state_t;

    localparam logic [2:0] SHIFT_CLIENT_VALUE_ALIGN       = 3'd0;
    localparam logic [2:0] SHIFT_CLIENT_SCORE_NORM_FIND   = 3'd1;
    localparam logic [2:0] SHIFT_CLIENT_SCORE_NORM_WRITE  = 3'd2;
    localparam logic [2:0] SHIFT_CLIENT_OUTPUT_NORM_FIND  = 3'd3;
    localparam logic [2:0] SHIFT_CLIENT_OUTPUT_NORM_WRITE = 3'd4;
    localparam logic [2:0] SHIFT_CLIENT_EXP               = 3'd5;

    state_t state_q;
    logic [10:0] position_q;
    logic signed [7:0] query_exponent_q;
    logic [1:0] query_beat_q;
    logic [1:0] attention_head_q;
    logic [10:0] scan_position_q;
    // Shared traversal coordinate: 0..2,047 for attention workspace and
    // 0..255 for the fixed four-head output store.
    logic [10:0] element_q;
    logic [5:0] coordinate_q;
    logic [1:0] result_beat_q;
    logic [31:0] compute_cycles_q;

    // These transient work registers deliberately have no reset or CLEAR data
    // assignment.  Narrow simulation-only validity state below proves that a
    // complete deterministic write precedes every architecturally live read.
    logic [1023:0] query_buffer_q;
    // Four independent 45-bit workspaces occupy three synchronous 8192x18
    // banks addressed by {query_head, context_position}.  Every consumer first enters ST_WORKSPACE_READ and only consumes
    // the registered words on the following cycle.  All three banks are
    // overwritten together at a later edge, so no result depends on a block
    // RAM read-during-write mode.
    logic [17:0] workspace_bank0_read_data;
    logic [17:0] workspace_bank1_read_data;
    logic [17:0] workspace_bank2_read_data;
    state_t workspace_read_return_q;
    // One synchronous read port per eight-lane bank. Only the current tagged
    // group is exposed; no production aliases read every stored row.
    wire [303:0] accumulator_read_group;
    wire [4:0] accumulator_read_tag;
    wire accumulator_read_valid, accumulator_memory_fault;
    logic accumulator_read_enable;
    logic [4:0] accumulator_read_address;
    wire [4:0] accumulator_current_address={attention_head_q,coordinate_q[5:3]};
    wire accumulator_write_enable;
    wire [303:0] accumulator_write_group;
    logic [31:0] accumulator_initialized_groups_q;
    wire accumulator_consume=(state_q==ST_VALUE_ACCUMULATE) ||
        (state_q==ST_VALUE_DIV_REQUEST) || (state_q==ST_VALUE_DIV_WAIT);
    wire accumulator_initialization_fault=
        ((state_q==ST_VALUE_ZERO) && accumulator_initialized_groups_q[accumulator_current_address]) ||
        ((state_q==ST_VALUE_REQUEST) && !(&accumulator_initialized_groups_q));
    wire accumulator_tag_fault=accumulator_consume &&
        (!accumulator_read_valid || accumulator_read_tag!=accumulator_current_address ||
         !(&accumulator_initialized_groups_q[attention_head_q*8 +:8]));
    wire signed [37:0] accumulator_selected_lane=$signed(
        accumulator_read_group[coordinate_q[2:0]*38 +:38]);
    logic [127:0] aligned_value_groups_q [0:7];
    wire [127:0] aligned_value_selected_group =
        aligned_value_groups_q[coordinate_q[5:3]];
    wire signed [15:0] aligned_value_at_coordinate =
        $signed(aligned_value_selected_group[coordinate_q[2:0]*16 +: 16]);
    localparam logic [1:0] CAPTURE_NONE  = 2'd0;
    localparam logic [1:0] CAPTURE_KEY   = 2'd1;
    localparam logic [1:0] CAPTURE_VALUE = 2'd2;
    logic [1023:0] captured_cache_vector_q;
    logic [1:0] captured_cache_kind_q;
    logic signed [7:0] captured_value_exponent_q;
    logic signed [7:0] value_group_exponent_q [0:1];
    logic [1023:0] result_buffer_q;
    logic signed [7:0] value_align_candidate_by_kv_q [0:1];
    wire signed [7:0] value_align_candidate_q=value_align_candidate_by_kv_q[attention_head_q[1]];
    logic value_align_any_by_kv_q [0:1];
    wire value_align_any_nonzero_q=value_align_any_by_kv_q[attention_head_q[1]];
    logic signed [7:0] value_align_exponent_q;
    logic signed [7:0] score_exponent_q;
    logic signed [15:0] score_max_q;
    // 2,048 nonnegative Q30 terms require 42 bits (maximum 2^41).
    logic [41:0] softmax_denominator_q;
    logic signed [7:0] normalize_candidate_q;
    logic normalize_all_fit_q;
    logic normalize_any_nonzero_q;
    logic normalize_output_q;
    logic signed [7:0] result_exponent_q;
    logic signed [37:0] score_accumulator_q;
    logic signed [7:0] pending_score_exponent_q;
    logic [12:0] exp_index_q;
    logic [2:0] shift_client_q;
    wire [127:0] query_bram_read_group;
    wire signed [15:0] query_bram_read_data=$signed(query_bram_read_group[15:0]);
    logic signed [17:0] output_bram_read_data;
    state_t output_read_return_q;
    logic query_bram_read_enable;
    logic query_bram_write_enable;
    logic [4:0] query_bram_read_address;
    logic [7:0] query_bram_write_address;
    logic signed [15:0] query_bram_write_data;
    logic output_bram_read_enable;
    logic output_bram_write_enable;
    logic [7:0] output_bram_read_address;
    logic [7:0] output_bram_write_address;
    logic signed [17:0] output_bram_write_data;
    logic output_bram_write_raw;
    // Only needed after a fault, because normal wait/drain states themselves
    // encode the one-outstanding invariant.
    logic fault_cache_outstanding_q;
    logic simulation_x_fault;
    logic exp_range_fault;
    wire summary_read_valid, summary_fault;
    wire signed [7:0] summary_exponent0, summary_exponent1;

`ifndef SYNTHESIS
    logic [303:0] accumulator_shadow_q [0:31];
    localparam logic [2:0] WORKSPACE_INVALID = 3'd0;
    localparam logic [2:0] WORKSPACE_RAW     = 3'd1;
    localparam logic [2:0] WORKSPACE_SCORE   = 3'd2;
    localparam logic [2:0] WORKSPACE_EXP     = 3'd3;
    localparam logic [2:0] WORKSPACE_PROB    = 3'd4;
    logic [2:0] workspace_phase_q [0:8191];
    logic signed [36:0] workspace_raw_score_shadow_q [0:8191];
    logic signed [7:0] workspace_raw_exponent_shadow_q [0:8191];
    logic signed [15:0] workspace_score_shadow_q [0:8191];
    logic [30:0] workspace_exp_shadow_q [0:8191];
    logic [15:0] workspace_probability_shadow_q [0:8191];
    localparam logic [1:0] OUTPUT_INVALID = 2'd0;
    localparam logic [1:0] OUTPUT_RAW     = 2'd1;
    localparam logic [1:0] OUTPUT_NORMAL = 2'd2;
    logic [1:0] output_phase_q [0:255];
    logic signed [16:0] output_raw_shadow_q [0:255];
    logic signed [15:0] output_normal_shadow_q [0:255];
    logic workspace_read_valid_q;
    logic [12:0] workspace_read_address_q;
    logic output_read_valid_q;
    logic [7:0] output_read_address_q;
    logic overwrite_query_full_q;
    logic overwrite_key_full_q;
    logic overwrite_value_full_q;
    logic [3:0] overwrite_accumulator_heads_q;
    wire overwrite_accumulators_full_q=overwrite_accumulator_heads_q[attention_head_q];
    logic [63:0] overwrite_result_lanes_q;
`endif

    wire cache_request_state = (state_q == ST_VALUE_EXP_REQUEST) ||
                               (state_q == ST_SCORE_REQUEST) ||
                               (state_q == ST_VALUE_REQUEST);
    wire cache_wait_state = (state_q == ST_VALUE_EXP_WAIT) ||
                            (state_q == ST_SCORE_WAIT) ||
                            (state_q == ST_VALUE_WAIT);
    wire cache_drain_state = (state_q == ST_CLEAR_DRAIN);
    wire capture_kind_fault =
        (((state_q == ST_SCORE_ACCUMULATE) ||
          (state_q == ST_SCORE_QUERY_USE)) &&
         (captured_cache_kind_q != CAPTURE_KEY)) ||
        (((state_q == ST_VALUE_EXP_SCAN) ||
          (state_q == ST_VALUE_ALIGN) ||
          (state_q == ST_ALIGN8_WAIT) ||
          (state_q == ST_EXP8_WAIT)) &&
         (captured_cache_kind_q != CAPTURE_VALUE));
`ifndef SYNTHESIS
    // Case equality is deliberate here: an ambiguous response cannot count as
    // a consumed response in four-state verification.
    wire cache_response_known_handshake =
        (private_cache_response_valid_i === 1'b1) &&
        (private_cache_response_ready_o === 1'b1);
`else
    wire cache_response_known_handshake =
        private_cache_response_valid_i && private_cache_response_ready_o;
`endif
    wire interface_live = rst_n && !clear_i && model_lock_i &&
                          !upstream_fault_i && !range_fault_o &&
                          !simulation_x_fault && !exp_range_fault &&
                          !capture_kind_fault && !summary_fault &&
                          !accumulator_memory_fault && !accumulator_tag_fault &&
                          !accumulator_initialization_fault &&
                          (compute_cycles_q < MAX_COMPUTE_CYCLES);

    wire workspace_bram_read_enable = interface_live &&
                                      (state_q == ST_WORKSPACE_READ);
    wire [12:0] workspace_bram_read_address = {attention_head_q,
        ((workspace_read_return_q == ST_VALUE_ACCUMULATE) ? scan_position_q : element_q)};
    wire signed [36:0] workspace_raw_score_at_element = $signed(
        {workspace_bank2_read_data[0], workspace_bank1_read_data,
         workspace_bank0_read_data});
    wire signed [7:0] workspace_raw_exponent_at_element = $signed(
        workspace_bank2_read_data[8:1]);
    wire signed [15:0] workspace_score_at_element = $signed(
        workspace_bank0_read_data[15:0]);
    wire [30:0] workspace_exp_at_element =
        {workspace_bank1_read_data[12:0], workspace_bank0_read_data};
    wire signed [15:0] workspace_probability_at_scan = $signed(
        workspace_bank0_read_data[15:0]);

    logic workspace_bram_write_enable;
    logic [12:0] workspace_bram_write_address;
    logic [17:0] workspace_bank0_write_data;
    logic [17:0] workspace_bank1_write_data;
    logic [17:0] workspace_bank2_write_data;

    always_comb begin
        start_ready_o = interface_live && (state_q == ST_IDLE);
        query_ready_o = interface_live && (state_q == ST_QUERY_LOAD);
        private_cache_request_valid_o = cache_request_state &&
                                        interface_live;
        private_cache_request_kind_o = (state_q == ST_SCORE_REQUEST)
            ? 2'b01 : 2'b10;
        private_cache_request_position_o = scan_position_q;
        private_cache_request_kv_head_o = attention_head_q[1];
        private_cache_response_ready_o = cache_wait_state || cache_drain_state;
        result_valid_o = interface_live && (state_q == ST_RESULT);
        result_vector_o = (state_q == ST_RESULT) ? result_buffer_q : 1024'd0;
        result_exponent_o = (state_q == ST_RESULT) ? result_exponent_q : 8'sd0;
        result_last_o = (state_q == ST_RESULT) && (result_beat_q == 2'd3);
        done_valid_o = interface_live && (state_q == ST_DONE);
        busy_o = (state_q != ST_IDLE) && (state_q != ST_FAULT);
    end

    // Eight adjacent coordinates per beat. Products are individually widened
    // before a balanced reduction; all 64 legal 16-bit products fit signed37,
    // so grouping cannot change the original exact integer dot or rounding.
    wire score_prefetch=(state_q==ST_SCORE_ACCUMULATE) ||
        ((state_q==ST_SCORE_QUERY_USE) && coordinate_q!=6'd56);
    wire [5:0] score_prefetch_coordinate=(state_q==ST_SCORE_QUERY_USE) ?
        coordinate_q+6'd8 : coordinate_q;
    logic [127:0] score_key_group_q;
    always_ff @(posedge clk) if(rst_n && score_prefetch)
        score_key_group_q<=captured_cache_vector_q[score_prefetch_coordinate[5:3]*128 +:128];
    wire signed [15:0] score_key_coordinate_q=$signed(score_key_group_q[15:0]);
    wire signed [31:0] score_products [0:7];
    wire signed [31:0] value_products [0:7];
    wire signed [38:0] score_wide [0:7];
    wire signed [38:0] score_pairs [0:3];
    wire signed [38:0] score_quads [0:1];
    wire signed [38:0] score_group_sum=score_quads[0]+score_quads[1];
    wire signed [38:0] value_accumulator_next_group [0:7];
    wire signed [31:0] score_lane_product=score_products[0];
    wire signed [31:0] selected_lane_product=value_products[0];
    genvar mac;
    generate for(mac=0;mac<8;mac=mac+1)begin:g_mac8
        board1_unified_projection_head_dynamic_mul_exact u_score_lane (
            .mode_i(2'd3),.activation_i($signed(query_bram_read_group[mac*16 +:16])),
            .dynamic_operand_i($signed(score_key_group_q[mac*16 +:16])),
            .direct_weight_i(10'sd0),.coarse_weight0_i(4'sd0),.coarse_weight1_i(4'sd0),
            .residual_weight0_i(6'd0),.residual_weight1_i(6'd0),
            .product0_o(score_products[mac]),.product1_o());
        board1_unified_projection_head_dynamic_mul_exact u_value_lane (
            .mode_i(2'd3),.activation_i(workspace_probability_at_scan),
            .dynamic_operand_i($signed(aligned_value_selected_group[mac*16 +:16])),
            .direct_weight_i(10'sd0),.coarse_weight0_i(4'sd0),.coarse_weight1_i(4'sd0),
            .residual_weight0_i(6'd0),.residual_weight1_i(6'd0),
            .product0_o(value_products[mac]),.product1_o());
        assign score_wide[mac]={{7{score_products[mac][31]}},score_products[mac]};
        assign value_accumulator_next_group[mac]=
            {accumulator_read_group[mac*38+37],accumulator_read_group[mac*38 +:38]}+
            {{7{value_products[mac][31]}},value_products[mac]};
        assign accumulator_write_group[mac*38 +:38]=(state_q==ST_VALUE_ZERO) ?
            38'd0 : value_accumulator_next_group[mac][37:0];
    end
    for(mac=0;mac<4;mac=mac+1)begin:g_score_pairs
        assign score_pairs[mac]=score_wide[2*mac]+score_wide[2*mac+1];
    end
    for(mac=0;mac<2;mac=mac+1)begin:g_score_quads
        assign score_quads[mac]=score_pairs[2*mac]+score_pairs[2*mac+1];
    end endgenerate

    assign accumulator_write_enable=interface_live &&
        ((state_q==ST_VALUE_ZERO) || (state_q==ST_VALUE_ACCUMULATE));
    always_comb begin
        accumulator_read_enable=1'b0;
        accumulator_read_address=accumulator_current_address;
        if(interface_live)begin
            if(state_q==ST_WORKSPACE_READ && workspace_read_return_q==ST_VALUE_ACCUMULATE)begin
                accumulator_read_enable=1'b1;
                accumulator_read_address={attention_head_q,3'd0};
            end else if(state_q==ST_VALUE_ACCUMULATE && coordinate_q!=6'd56)begin
                accumulator_read_enable=1'b1;
                accumulator_read_address={attention_head_q,coordinate_q[5:3]+3'd1};
            end else if(state_q==ST_ACCUMULATOR_READ)accumulator_read_enable=1'b1;
        end
    end
    always_ff @(posedge clk or negedge rst_n)begin
        if(!rst_n)accumulator_initialized_groups_q<=0;
        else if(clear_i || upstream_fault_i || range_fault_o || !model_lock_i ||
                ((state_q==ST_IDLE) && start_valid_i && start_ready_o))
            accumulator_initialized_groups_q<=0;
        else if(accumulator_write_enable && state_q==ST_VALUE_ZERO)
            accumulator_initialized_groups_q[accumulator_current_address]<=1'b1;
    end
    board1_context2048_attention_accumulator8 u_accumulator_bram (
        .clk(clk),.rst_n(rst_n),
        .clear_i(clear_i || !model_lock_i || upstream_fault_i || range_fault_o),
        .read_enable_i(accumulator_read_enable),.read_address_i(accumulator_read_address),
        .read_data_o(accumulator_read_group),.read_valid_o(accumulator_read_valid),
        .read_tag_o(accumulator_read_tag),.fault_o(accumulator_memory_fault),
        .write_enable_i(accumulator_write_enable),.write_address_i(accumulator_current_address),
        .write_data_i(accumulator_write_group));

    genvar generated_lane;

    // Response legality remains a fail-closed one-cycle acceptance gate.  The
    // expensive value first-fit scan, score reduction, and value accumulation
    // are deliberately serialized after acceptance.  This trades private
    // cycles for two private arithmetic roles without changing any observable
    // handshake or numerical result.
    wire [63:0] response_vector_legal_bits;
    generate
        for (generated_lane = 0; generated_lane < 64;
             generated_lane = generated_lane + 1) begin : g_leaf_checks
            wire signed [15:0] leaf_key = $signed(
                private_cache_response_key_vector_i[
                    generated_lane*16 +: 16]);
            wire signed [15:0] leaf_value = $signed(
                private_cache_response_value_vector_i[
                    generated_lane*16 +: 16]);
            assign response_vector_legal_bits[generated_lane] =
                (leaf_key != -16'sd32768) &&
                (leaf_value != -16'sd32768);
        end
    endgenerate
    wire response_vectors_legal_comb = &response_vector_legal_bits;

    wire [63:0] query_vector_legal_bits;
    generate
        for (generated_lane = 0; generated_lane < 64;
             generated_lane = generated_lane + 1) begin : g_query_checks
            wire signed [15:0] query_leaf = $signed(
                query_vector_i[generated_lane*16 +: 16]);
            assign query_vector_legal_bits[generated_lane] =
                (query_leaf != -16'sd32768);
        end
    endgenerate
    wire query_vector_legal_comb = &query_vector_legal_bits;

    // Highest set bit of OR(magnitudes) is the largest lane bit length.
    // The registered group summary replaces the scalar 64:1 mux path.
    wire [15:0] align8_response_magnitude_or;
    wire signed [15:0] captured_value_coordinate =
        $signed({1'b0, align8_response_magnitude_or[14:0]});
    wire signed [7:0] captured_value_fit_comb =
        i16_first_fit_exponent(captured_value_coordinate,
                               captured_value_exponent_q);
    wire signed [7:0] value_align_candidate_next_comb =
        (captured_value_fit_comb > value_align_candidate_q)
        ? captured_value_fit_comb : value_align_candidate_q;
    wire value_align_any_next_comb = value_align_any_nonzero_q ||
                                     (captured_value_coordinate != 0);
    wire signed [7:0] value_align_final_exponent_comb =
        value_align_any_next_comb ? value_align_candidate_next_comb : 8'sd0;
    wire signed [38:0] score_accumulator_next_comb =
        {{1{score_accumulator_q[37]}}, score_accumulator_q} +
        score_group_sum;
    wire signed [38:0] value_accumulator_next_comb=value_accumulator_next_group[0];
    wire signed [8:0] raw_score_exponent_comb =
        $signed(query_exponent_q) +
        $signed(private_cache_response_key_exponent_i) - 9'sd3;

    logic signed [63:0] normalize_source_value_comb;
    logic signed [7:0] normalize_source_exponent_comb;
    integer normalize_shift_comb;
    always_comb begin
        if (!normalize_output_q) begin
            normalize_source_value_comb =
                {{27{workspace_raw_score_at_element[36]}},
                 workspace_raw_score_at_element};
            normalize_source_exponent_comb =
                workspace_raw_exponent_at_element;
        end else begin
            normalize_source_value_comb =
                {{47{output_bram_read_data[16]}},
                 output_bram_read_data[16:0]};
            normalize_source_exponent_comb =
                value_group_exponent_q[element_q[7]];
        end
        normalize_shift_comb = $signed(normalize_candidate_q) -
                               $signed(normalize_source_exponent_comb);
    end
    // The extra private stage separates BSRAM/exponent calculation
    // from running maximum/control. No arithmetic function is changed.
    wire signed [7:0] normalize_first_fit_comb;
    wire normalize_source_nonzero_comb;
    board1_attention_norm_candidate_stage u_norm_stage (
        .clk(clk), .reset_n(rst_n), .capture_i(state_q == ST_NORM_CAPTURE),
        .value_i(normalize_source_value_comb),
        .source_exponent_i(normalize_source_exponent_comb),
        .first_fit_o(normalize_first_fit_comb),
        .nonzero_o(normalize_source_nonzero_comb)
    );
    wire normalize_last_comb = normalize_output_q
        ? (element_q == 11'd255)
        : (element_q == position_q);
    wire signed [7:0] normalize_candidate_next_comb =
        (normalize_first_fit_comb > normalize_candidate_q)
        ? normalize_first_fit_comb : normalize_candidate_q;

    logic signed [16:0] score_difference_comb;
    integer softmax_shift_comb;
    logic [30:0] exp_value_comb;
    logic exp_response_valid;
    logic exp_response_fault;
    logic [42:0] denominator_next_comb;
    always_comb begin
        score_difference_comb =
            workspace_score_at_element - $signed(score_max_q);
        softmax_shift_comb = -($signed(score_exponent_q) + 8);
        denominator_next_comb = {1'b0, softmax_denominator_q} +
                                {{12{1'b0}}, exp_value_comb};
    end

    // One iterative RNE shifter services five mutually exclusive private FSM
    // clients.  Its registered request/response boundary removes the former
    // long memory-to-barrel-to-memory path.
    logic shift_request_valid;
    logic shift_request_ready;
    logic signed [63:0] shift_request_value_comb;
    logic signed [8:0] shift_request_amount_comb;
    logic [2:0] shift_request_client_comb;
    logic shift_response_valid;
    logic shift_response_ready;
    logic signed [63:0] shift_response_result;
    logic shift_response_fault;
    always_comb begin
        shift_request_valid = 1'b0;
        shift_request_value_comb = normalize_source_value_comb;
        shift_request_amount_comb = normalize_shift_comb;
        shift_request_client_comb = SHIFT_CLIENT_SCORE_NORM_FIND;
        if (state_q == ST_EXP) begin
            shift_request_valid = interface_live;
            shift_request_value_comb =
                {{47{score_difference_comb[16]}}, score_difference_comb};
            shift_request_amount_comb = softmax_shift_comb;
            shift_request_client_comb = SHIFT_CLIENT_EXP;
        end else if (state_q == ST_SCORE_NORM_FIND) begin
            shift_request_valid = interface_live;
            shift_request_client_comb = SHIFT_CLIENT_SCORE_NORM_FIND;
        end else if (state_q == ST_SCORE_NORM_WRITE) begin
            shift_request_valid = interface_live;
            shift_request_client_comb = SHIFT_CLIENT_SCORE_NORM_WRITE;
        end else if (state_q == ST_OUTPUT_NORM_FIND) begin
            shift_request_valid = interface_live;
            shift_request_client_comb = SHIFT_CLIENT_OUTPUT_NORM_FIND;
        end else if (state_q == ST_OUTPUT_NORM_WRITE) begin
            shift_request_valid = interface_live;
            shift_request_client_comb = SHIFT_CLIENT_OUTPUT_NORM_WRITE;
        end
        shift_response_ready = (state_q == ST_SHIFT_WAIT);
    end
    wire shift_response_sample_fit = !shift_response_fault &&
        (shift_response_result >= I16_MINIMUM) &&
        (shift_response_result <= I16_MAXIMUM) &&
        (shift_response_result != -64'sd32768);

    logic div_request_valid;
    logic div_request_ready;
    logic signed [63:0] div_request_numerator;
    logic [63:0] div_request_denominator;
    logic div_response_valid;
    logic signed [63:0] div_response_result;
    logic div_response_fault;
    logic div_response_ready;

    always_comb begin
        query_bram_read_enable = interface_live && score_prefetch;
        query_bram_read_address = {attention_head_q, score_prefetch_coordinate[5:3]};
        query_bram_write_enable = interface_live &&
                                  (state_q == ST_QUERY_STORE);
        query_bram_write_address = {query_beat_q, coordinate_q};
        query_bram_write_data = $signed(
            query_buffer_q[coordinate_q*16 +: 16]);

        output_bram_read_enable = interface_live &&
            ((state_q == ST_OUTPUT_READ) || (state_q == ST_RESULT_READ));
        output_bram_read_address = (state_q == ST_OUTPUT_READ)
            ? element_q[7:0] : {result_beat_q, coordinate_q};
        output_bram_write_raw = interface_live &&
            (state_q == ST_VALUE_DIV_WAIT) && div_response_valid &&
            div_response_ready && !div_response_fault &&
            (div_response_result >= HEAD_OUTPUT_MINIMUM) &&
            (div_response_result <= HEAD_OUTPUT_MAXIMUM);
        output_bram_write_enable = output_bram_write_raw ||
            (interface_live && (state_q == ST_SHIFT_WAIT) &&
             shift_response_valid && shift_response_ready &&
             shift_response_sample_fit &&
             (shift_client_q == SHIFT_CLIENT_OUTPUT_NORM_WRITE));
        output_bram_write_address = output_bram_write_raw
            ? {attention_head_q, coordinate_q} : element_q[7:0];
        output_bram_write_data = output_bram_write_raw
            ? {{1{div_response_result[16]}}, div_response_result[16:0]}
            : {{2{shift_response_result[15]}},
               shift_response_result[15:0]};
    end

    board1_attention_value_fit_prefix u_value_prefix (
        .clk(clk),.rst_n(rst_n),.clear_i(clear_i),.model_lock_i(model_lock_i),
        .upstream_fault_i(upstream_fault_i || range_fault_o),
        .stage_begin_i(summary_stage_begin_i),.stage_value_valid_i(summary_stage_value_valid_i),
        .layer_i(fixed_layer_i),.position_i(fixed_position_i),
        .coordinate_i(summary_stage_coordinate_i),.value_i(summary_stage_value_i),
        .exponent_i(summary_stage_exponent_i),.pending_complete_i(summary_pending_complete_i),
        .read_i(start_valid_i && start_ready_o),.commit_i(summary_commit_i),
        .read_valid_o(summary_read_valid),.exponent0_o(summary_exponent0),
        .exponent1_o(summary_exponent1),.fault_o(summary_fault));

    board1_context2048_attention_query8 u_query_bram (
        .clk(clk), .read_enable_i(query_bram_read_enable),
        .read_address_i(query_bram_read_address),
        .read_data_o(query_bram_read_group),
        .write_enable_i(query_bram_write_enable),
        .write_address_i(query_bram_write_address),
        .write_data_i(query_bram_write_data)
    );

    board1_context2048_attention_vector256x18 u_output_bram (
        .clk(clk), .read_enable_i(output_bram_read_enable),
        .read_address_i(output_bram_read_address),
        .read_data_o(output_bram_read_data),
        .write_enable_i(output_bram_write_enable),
        .write_address_i(output_bram_write_address),
        .write_data_i(output_bram_write_data)
    );

    board1_context2048_attention_workspace3x18 u_workspace_bram (
        .clk(clk),
        .read_enable_i(workspace_bram_read_enable),
        .read_address_i(workspace_bram_read_address),
        .bank0_read_data_o(workspace_bank0_read_data),
        .bank1_read_data_o(workspace_bank1_read_data),
        .bank2_read_data_o(workspace_bank2_read_data),
        .write_enable_i(workspace_bram_write_enable),
        .write_address_i(workspace_bram_write_address),
        .bank0_write_data_i(workspace_bank0_write_data),
        .bank1_write_data_i(workspace_bank1_write_data),
        .bank2_write_data_i(workspace_bank2_write_data)
    );

    // Eight adjacent coordinates, with no new model/cache/host interface.
    wire align8_request_ready, align8_response_valid, align8_response_fault;
    wire [127:0] align8_response_vector;
    wire signed [8:0] align8_shift = $signed(value_align_exponent_q) -
                                    $signed(captured_value_exponent_q);
    board1_fixed_attention_align8 u_align8 (
        .clk(clk), .rst_n(rst_n), .clear_i(clear_i || (state_q == ST_FAULT)),
        .request_valid_i(interface_live && ((state_q == ST_VALUE_ALIGN) ||
                                             (state_q == ST_VALUE_EXP_SCAN))),
        .request_ready_o(align8_request_ready),
        .request_vector_i(captured_cache_vector_q[coordinate_q[5:3]*128 +: 128]),
        .request_shift_i((state_q == ST_VALUE_EXP_SCAN) ? 9'sd0 : align8_shift),
        .response_valid_o(align8_response_valid),
        .response_ready_i((state_q == ST_ALIGN8_WAIT) || (state_q == ST_EXP8_WAIT)),
        .response_vector_o(align8_response_vector),
        .response_magnitude_or_o(align8_response_magnitude_or),
        .response_fault_o(align8_response_fault)
    );

    board1_fixed_attention_rne_shift_iterative u_shift (
        .clk(clk), .rst_n(rst_n),
        .clear_i(clear_i || (state_q == ST_FAULT)),
        .request_valid_i(shift_request_valid),
        .request_ready_o(shift_request_ready),
        .request_value_i(shift_request_value_comb),
        .request_shift_i(shift_request_amount_comb),
        .response_valid_o(shift_response_valid),
        .response_ready_i(shift_response_ready),
        .response_result_o(shift_response_result),
        .response_fault_o(shift_response_fault)
    );

    board1_fixed_attention_exp_lut_sync #(.FILE(EXP_FILE)) u_exp_lut (
        .clk(clk), .rst_n(rst_n), .clear_i(clear_i),
        .request_valid_i(state_q == ST_EXP_LUT_REQUEST),
        .index_i(exp_index_q),
        .response_valid_o(exp_response_valid),
        .value_o(exp_value_comb),
        .response_fault_o(exp_response_fault),
        .range_fault_o(exp_range_fault)
    );

    wire [45:0] probability_exp_extended =
        {{15{1'b0}}, workspace_exp_at_element};
    wire [45:0] probability_numerator_comb =
        (probability_exp_extended << 15) - probability_exp_extended;
    always_comb begin
        div_request_valid = (state_q == ST_PROBABILITY_REQUEST) ||
                            (state_q == ST_VALUE_DIV_REQUEST);
        if (state_q == ST_PROBABILITY_REQUEST) begin
            div_request_numerator = $signed({18'd0,
                                             probability_numerator_comb});
            div_request_denominator = {22'd0, softmax_denominator_q};
        end else begin
            div_request_numerator =
                {{26{accumulator_selected_lane[37]}},accumulator_selected_lane};
            div_request_denominator = 64'd32767;
        end
        div_response_ready = (state_q == ST_PROBABILITY_WAIT) ||
                             (state_q == ST_VALUE_DIV_WAIT);
    end
    board1_fixed_attention_rne_div_signed64 u_divider (
        .clk(clk), .rst_n(rst_n),
        .cancel_i(clear_i || (state_q == ST_FAULT)),
        .request_valid_i(div_request_valid),
        .request_ready_o(div_request_ready),
        .request_numerator_i(div_request_numerator),
        .request_denominator_i(div_request_denominator),
        .response_valid_o(div_response_valid),
        .response_ready_i(div_response_ready),
        .response_result_o(div_response_result),
        .response_fault_o(div_response_fault)
    );

    always_comb begin
        workspace_bram_write_enable = 1'b0;
        workspace_bram_write_address = {attention_head_q, element_q};
        workspace_bank0_write_data = 18'd0;
        workspace_bank1_write_data = 18'd0;
        workspace_bank2_write_data = 18'd0;

        case (state_q)
            ST_SCORE_QUERY_USE: begin
                if (interface_live && (coordinate_q == 6'd56) &&
                    (score_accumulator_next_comb >= SCORE_MINIMUM_39) &&
                    (score_accumulator_next_comb <= SCORE_MAXIMUM_39)) begin
                    workspace_bram_write_enable = 1'b1;
                    workspace_bram_write_address = {attention_head_q, scan_position_q};
                    workspace_bank0_write_data =
                        score_accumulator_next_comb[17:0];
                    workspace_bank1_write_data =
                        score_accumulator_next_comb[35:18];
                    workspace_bank2_write_data =
                        {9'd0, pending_score_exponent_q,
                         score_accumulator_next_comb[36]};
                end
            end

            ST_SHIFT_WAIT: begin
                if (interface_live && shift_response_valid &&
                    shift_response_ready && shift_response_sample_fit &&
                    (shift_client_q == SHIFT_CLIENT_SCORE_NORM_WRITE)) begin
                    workspace_bram_write_enable = 1'b1;
                    workspace_bank0_write_data =
                        {2'd0, shift_response_result[15:0]};
                end
            end

            ST_EXP_WAIT: begin
                if (interface_live && exp_response_valid &&
                    !exp_response_fault && (denominator_next_comb != 0) &&
                    !denominator_next_comb[42]) begin
                    workspace_bram_write_enable = 1'b1;
                    workspace_bank0_write_data = exp_value_comb[17:0];
                    workspace_bank1_write_data =
                        {5'd0, exp_value_comb[30:18]};
                end
            end

            ST_PROBABILITY_WAIT: begin
                if (interface_live && div_response_valid &&
                    div_response_ready && !div_response_fault &&
                    (div_response_result >= 0) &&
                    (div_response_result <= 64'sd32767)) begin
                    workspace_bram_write_enable = 1'b1;
                    workspace_bank0_write_data =
                        {2'd0, div_response_result[15:0]};
                end
            end

            default: begin
            end
        endcase
    end

`ifndef SYNTHESIS
    always_comb begin
        simulation_x_fault = ((clear_i !== 1'b0) && (clear_i !== 1'b1)) ||
            ((model_lock_i !== 1'b0) && (model_lock_i !== 1'b1)) ||
            ((upstream_fault_i !== 1'b0) &&
             (upstream_fault_i !== 1'b1)) ||
            ((start_valid_i !== 1'b0) && (start_valid_i !== 1'b1));
        if (state_q == ST_QUERY_LOAD)
            simulation_x_fault = simulation_x_fault ||
                ((query_valid_i !== 1'b0) && (query_valid_i !== 1'b1)) ||
                ((query_last_i !== 1'b0) && (query_last_i !== 1'b1)) ||
                (query_valid_i && (^query_vector_i === 1'bx));
        if ((state_q == ST_IDLE) && (start_valid_i === 1'b1))
            simulation_x_fault = simulation_x_fault ||
                (^fixed_position_i === 1'bx) ||
                (^query_exponent_i === 1'bx);
        if (cache_request_state)
            simulation_x_fault = simulation_x_fault ||
                ((private_cache_request_ready_i !== 1'b0) &&
                 (private_cache_request_ready_i !== 1'b1));
        if (cache_wait_state || cache_drain_state)
            simulation_x_fault = simulation_x_fault ||
                ((private_cache_response_valid_i !== 1'b0) &&
                 (private_cache_response_valid_i !== 1'b1));
        if (cache_wait_state)
            simulation_x_fault = simulation_x_fault ||
                ((private_cache_response_fault_i !== 1'b0) &&
                 (private_cache_response_fault_i !== 1'b1)) ||
                (private_cache_response_valid_i &&
                 ((^private_cache_response_key_vector_i === 1'bx) ||
                  (^private_cache_response_key_exponent_i === 1'bx) ||
                  (^private_cache_response_value_vector_i === 1'bx) ||
                  (^private_cache_response_value_exponent_i === 1'bx)));
        if (state_q == ST_RESULT)
            simulation_x_fault = simulation_x_fault ||
                ((result_ready_i !== 1'b0) && (result_ready_i !== 1'b1));
        if (state_q == ST_DONE)
            simulation_x_fault = simulation_x_fault ||
                ((done_ready_i !== 1'b0) && (done_ready_i !== 1'b1));
    end
`else
    always_comb simulation_x_fault = 1'b0;
`endif

    // Private staging only: this latch does not authorize a response.
    // Capture on the existing response transfer edge without putting the
    // global fault/legality chain on all 1,024 clock enables. The unchanged
    // controller below alone validates kind/exponent/data and advances to a
    // consumer. A rejected or CLEAR-cancelled payload may be copied here,
    // but cannot become live; the next accepted response overwrites it.
    // Keep the upstream private K/V response masking and every validation,
    // ownership, drain, model-lock and publication check unchanged.
    always_ff @(posedge clk) begin
        if (rst_n && cache_wait_state && cache_response_known_handshake) begin
            if (state_q == ST_SCORE_WAIT)
                captured_cache_vector_q <= private_cache_response_key_vector_i;
            else
                captured_cache_vector_q <= private_cache_response_value_vector_i;
        end
    end

    always_ff @(posedge clk) begin
        if (!rst_n) begin
        end else if (clear_i) begin
        end else if (simulation_x_fault || upstream_fault_i || exp_range_fault ||
                     capture_kind_fault || summary_fault || accumulator_memory_fault ||
                     accumulator_tag_fault || accumulator_initialization_fault ||
                     ((state_q != ST_IDLE) && !model_lock_i) ||
                     ((state_q != ST_IDLE) &&
                      (compute_cycles_q >= MAX_COMPUTE_CYCLES))) begin
        end else if (state_q == ST_ALIGN8_WAIT) begin
            if (align8_response_valid) begin
                if (align8_response_fault) begin
                end else begin
                            aligned_value_groups_q[coordinate_q[5:3]] <=
                                align8_response_vector;
                end
            end
        end
    end

    // Private traversal data, never a transaction/publication permission.
    // Healthy consumption edges retain the original coordinate sequence.
    // An abort may change this counter on its last edge, while the unchanged
    // FSM/fault/write/request masks revoke work. Reset/CLEAR and each next
    // phase's entry establish zero before the coordinate becomes live again.
    always_ff @(posedge clk or negedge rst_n) begin
        if (!rst_n) coordinate_q <= 6'd0;
        else if (clear_i) coordinate_q <= 6'd0;
        else begin
            case (state_q)
                ST_IDLE, ST_QUERY_LOAD, ST_VALUE_EXP_WAIT, ST_SCORE_WAIT,
                ST_VALUE_WAIT, ST_PROBABILITY_WAIT, ST_SHIFT_WAIT,
                ST_NEXT_HEAD, ST_RESULT, ST_CLEAR_DRAIN:
                    coordinate_q <= 6'd0;
                ST_QUERY_STORE, ST_RESULT_CAPTURE:
                    coordinate_q <= (coordinate_q == 6'd63) ? 6'd0 : coordinate_q + 1'b1;
                ST_SCORE_QUERY_USE, ST_VALUE_ZERO, ST_VALUE_ACCUMULATE:
                    coordinate_q <= (coordinate_q == 6'd56) ? 6'd0 : coordinate_q + 6'd8;
                ST_EXP8_WAIT, ST_ALIGN8_WAIT:
                    if (align8_response_valid)
                        coordinate_q <= (coordinate_q == 6'd56) ? 6'd0 : coordinate_q + 6'd8;
                ST_VALUE_DIV_WAIT:
                    if (div_response_valid && coordinate_q != 6'd63)
                        coordinate_q <= coordinate_q + 1'b1;
                default: begin end
            endcase
        end
    end

    always_ff @(posedge clk or negedge rst_n) begin
        if (!rst_n) begin
            state_q <= ST_IDLE;
            position_q <= 11'd0;
            query_exponent_q <= 8'sd0;
            query_beat_q <= 2'd0;
            attention_head_q <= 2'd0;
            scan_position_q <= 11'd0;
            element_q <= 11'd0;
            result_beat_q <= 2'd0;
            compute_cycles_q <= 32'd0;
            value_align_candidate_by_kv_q[0]<=-8'sd32; value_align_candidate_by_kv_q[1]<=-8'sd32;
            value_align_any_by_kv_q[0]<=1'b0; value_align_any_by_kv_q[1]<=1'b0;
            value_align_exponent_q <= 8'sd0;
            score_exponent_q <= 8'sd0;
            score_max_q <= 16'sd0;
            softmax_denominator_q <= 42'd0;
            normalize_candidate_q <= -8'sd32;
            normalize_all_fit_q <= 1'b1;
            normalize_any_nonzero_q <= 1'b0;
            normalize_output_q <= 1'b0;
            result_exponent_q <= 8'sd0;
            pending_score_exponent_q <= 8'sd0;
            exp_index_q <= 13'd0;
            shift_client_q <= SHIFT_CLIENT_VALUE_ALIGN;
            score_accumulator_q <= 38'sd0;
            fault_cache_outstanding_q <= 1'b0;
            workspace_read_return_q <= ST_FAULT;
            output_read_return_q <= ST_FAULT;
            captured_cache_kind_q <= CAPTURE_NONE;
            captured_value_exponent_q <= 8'sd0;
            value_group_exponent_q[0] <= 8'sd0;
            value_group_exponent_q[1] <= 8'sd0;
            range_fault_o <= 1'b0;
        end else if (clear_i) begin
            if ((cache_wait_state || cache_drain_state ||
                 ((state_q == ST_FAULT) && fault_cache_outstanding_q)) &&
                !cache_response_known_handshake) begin
                state_q <= ST_CLEAR_DRAIN;
            end else begin
                state_q <= ST_IDLE;
            end
            fault_cache_outstanding_q <= 1'b0;
            position_q <= 11'd0;
            query_exponent_q <= 8'sd0;
            query_beat_q <= 2'd0;
            attention_head_q <= 2'd0;
            scan_position_q <= 11'd0;
            element_q <= 11'd0;
            result_beat_q <= 2'd0;
            compute_cycles_q <= 32'd0;
            value_align_candidate_by_kv_q[0]<=-8'sd32; value_align_candidate_by_kv_q[1]<=-8'sd32;
            value_align_any_by_kv_q[0]<=1'b0; value_align_any_by_kv_q[1]<=1'b0;
            value_align_exponent_q <= 8'sd0;
            score_exponent_q <= 8'sd0;
            score_max_q <= 16'sd0;
            softmax_denominator_q <= 42'd0;
            normalize_candidate_q <= -8'sd32;
            normalize_all_fit_q <= 1'b1;
            normalize_any_nonzero_q <= 1'b0;
            normalize_output_q <= 1'b0;
            result_exponent_q <= 8'sd0;
            pending_score_exponent_q <= 8'sd0;
            exp_index_q <= 13'd0;
            shift_client_q <= SHIFT_CLIENT_VALUE_ALIGN;
            score_accumulator_q <= 38'sd0;
            workspace_read_return_q <= ST_FAULT;
            output_read_return_q <= ST_FAULT;
            captured_cache_kind_q <= CAPTURE_NONE;
            captured_value_exponent_q <= 8'sd0;
            value_group_exponent_q[0] <= 8'sd0;
            value_group_exponent_q[1] <= 8'sd0;
            range_fault_o <= 1'b0;
        end else if (simulation_x_fault || upstream_fault_i || exp_range_fault ||
                     capture_kind_fault || summary_fault || accumulator_memory_fault ||
                     accumulator_tag_fault || accumulator_initialization_fault ||
                     ((state_q != ST_IDLE) && !model_lock_i) ||
                     ((state_q != ST_IDLE) &&
                      (compute_cycles_q >= MAX_COMPUTE_CYCLES))) begin
            state_q <= ST_FAULT;
            range_fault_o <= 1'b1;
            if ((state_q != ST_FAULT) &&
                (cache_wait_state || cache_drain_state) &&
                !cache_response_known_handshake)
                fault_cache_outstanding_q <= 1'b1;
        end else begin
            if (state_q == ST_IDLE)
                compute_cycles_q <= 32'd0;
            else if (state_q != ST_FAULT)
                compute_cycles_q <= compute_cycles_q + 1'b1;

            case (state_q)
                ST_IDLE: begin
                    range_fault_o <= 1'b0;
                    if (start_valid_i && start_ready_o) begin
                        if (!summary_read_valid || (query_exponent_i < -8'sd32) ||
                            (query_exponent_i > 8'sd31)) begin
                            state_q <= ST_FAULT;
                            range_fault_o <= 1'b1;
                        end else begin
                            position_q <= fixed_position_i;
                            value_group_exponent_q[0]<=summary_exponent0;
                            value_group_exponent_q[1]<=summary_exponent1;
                            query_exponent_q <= query_exponent_i;
                            query_beat_q <= 2'd0;
                            state_q <= ST_QUERY_LOAD;
                        end
                    end
                end

                ST_QUERY_LOAD: begin
                    if (query_valid_i && query_ready_o) begin
                        if (!query_vector_legal_comb ||
                            (query_last_i != (query_beat_q == 2'd3))) begin
                            state_q <= ST_FAULT;
                            range_fault_o <= 1'b1;
                        end else begin
                            query_buffer_q <= query_vector_i;
                            state_q <= ST_QUERY_STORE;
                        end
                    end
                end

                ST_QUERY_STORE: begin
                    if (coordinate_q == 6'd63) begin
                        if (query_beat_q == 2'd3) begin
                                attention_head_q <= 2'd0;
                                scan_position_q <= 11'd0;
                                value_align_candidate_by_kv_q[0]<=-8'sd32; value_align_candidate_by_kv_q[1]<=-8'sd32;
                                value_align_any_by_kv_q[0]<=1'b0; value_align_any_by_kv_q[1]<=1'b0;
                                value_align_exponent_q<=value_group_exponent_q[0];
                                state_q <= ST_SCORE_REQUEST;
                        end else begin
                            query_beat_q <= query_beat_q + 1'b1;
                            state_q <= ST_QUERY_LOAD;
                        end
                    end else begin
                    end
                end

                ST_VALUE_EXP_REQUEST: begin
                    if (private_cache_request_valid_o &&
                        private_cache_request_ready_i) begin
                        captured_cache_kind_q <= CAPTURE_NONE;
                        state_q <= ST_VALUE_EXP_WAIT;
                    end
                end

                ST_VALUE_EXP_WAIT: begin
                    if (private_cache_response_valid_i &&
                        private_cache_response_ready_o) begin
                        if (private_cache_response_fault_i ||
                            !response_vectors_legal_comb ||
                            (private_cache_response_value_exponent_i < -8'sd32) ||
                            (private_cache_response_value_exponent_i > 8'sd31)) begin
                            state_q <= ST_FAULT;
                            range_fault_o <= 1'b1;
                        end else begin
                            captured_cache_kind_q <= CAPTURE_VALUE;
                            captured_value_exponent_q <=
                                private_cache_response_value_exponent_i;
                            state_q <= ST_VALUE_EXP_SCAN;
                        end
                    end
                end

                ST_VALUE_EXP_SCAN: begin
                    if (interface_live && align8_request_ready)
                        state_q <= ST_EXP8_WAIT;
                end

                ST_EXP8_WAIT: begin
                    if (align8_response_valid) begin
                        if (align8_response_fault || align8_response_magnitude_or[15]) begin
                            state_q <= ST_FAULT;
                            range_fault_o <= 1'b1;
                        end else begin
                            if (captured_value_coordinate != 0) begin
                                value_align_any_by_kv_q[attention_head_q[1]]<= 1'b1;
                                if (captured_value_fit_comb >
                                    value_align_candidate_q)
                                    value_align_candidate_by_kv_q[attention_head_q[1]]<=
                                        captured_value_fit_comb;
                            end
                            if (coordinate_q == 6'd56) begin
                                if (scan_position_q == position_q) begin
                                    value_align_exponent_q <=
                                        value_align_final_exponent_comb;
                                    value_group_exponent_q[attention_head_q[1]] <=
                                        value_align_final_exponent_comb;
                                    scan_position_q <= 11'd0;
                                    state_q <= ST_SCORE_REQUEST;
                                end else begin
                                    scan_position_q <= scan_position_q + 1'b1;
                                    state_q <= ST_VALUE_EXP_REQUEST;
                                end
                            end else begin
                                state_q <= ST_VALUE_EXP_SCAN;
                            end
                        end
                    end
                end

                ST_SCORE_REQUEST: begin
                    if (private_cache_request_valid_o &&
                        private_cache_request_ready_i) begin
                        captured_cache_kind_q <= CAPTURE_NONE;
                        state_q <= ST_SCORE_WAIT;
                    end
                end

                ST_SCORE_WAIT: begin
                    if (private_cache_response_valid_i &&
                        private_cache_response_ready_o) begin
                        if (private_cache_response_fault_i ||
                            !response_vectors_legal_comb ||
                            (private_cache_response_key_exponent_i < -8'sd32) ||
                            (private_cache_response_key_exponent_i > 8'sd31)) begin
                            state_q <= ST_FAULT;
                            range_fault_o <= 1'b1;
                        end else begin
                            captured_cache_kind_q <= CAPTURE_KEY;
                            pending_score_exponent_q <=
                                raw_score_exponent_comb[7:0];
                            score_accumulator_q <= 38'sd0;
                            state_q <= ST_SCORE_ACCUMULATE;
                        end
                    end
                end

                ST_SCORE_ACCUMULATE: begin
                    score_accumulator_q <= 38'sd0;
                    state_q <= ST_SCORE_QUERY_USE;
                end

                ST_SCORE_QUERY_USE: begin
                    if (coordinate_q != 6'd56) begin
                        score_accumulator_q <=
                            score_accumulator_next_comb[37:0];
                        state_q <= ST_SCORE_QUERY_USE;
                    end else if ((score_accumulator_next_comb <
                                  SCORE_MINIMUM_39) ||
                                 (score_accumulator_next_comb >
                                  SCORE_MAXIMUM_39)) begin
                        state_q <= ST_FAULT;
                        range_fault_o <= 1'b1;
                    end else begin
                        if (!attention_head_q[0]) begin
                            // Reuse the accepted K row with the sibling Q.
                            attention_head_q <= attention_head_q + 1'b1;
                            state_q <= ST_SCORE_ACCUMULATE;
                        end else if (scan_position_q != position_q) begin
                            // Keep one authenticated head/role page hot while
                            // both sibling queries walk positions in order.
                            attention_head_q <= attention_head_q - 2'd1;
                            scan_position_q <= scan_position_q + 1'b1;
                            state_q <= ST_SCORE_REQUEST;
                        end else if (attention_head_q == 2'd1) begin
                            attention_head_q <= 2'd2;
                            scan_position_q <= 11'd0;
                            state_q <= ST_SCORE_REQUEST;
                        end else begin
                            // All raw scores exist before the first softmax.
                            attention_head_q <= 2'd0;
                            element_q <= 11'd0;
                            normalize_candidate_q <= -8'sd32;
                            normalize_all_fit_q <= 1'b1;
                            normalize_any_nonzero_q <= 1'b0;
                            normalize_output_q <= 1'b0;
                            workspace_read_return_q <= ST_NORM_CAPTURE;
                            state_q <= ST_WORKSPACE_READ;
                        end
                    end
                end

                ST_NORM_CAPTURE: begin
                    state_q <= ST_NORM_SELECT;
                end

                ST_NORM_SELECT: begin
                    if (normalize_source_nonzero_comb) begin
                        normalize_any_nonzero_q <= 1'b1;
                        if (normalize_first_fit_comb >
                            normalize_candidate_q)
                            normalize_candidate_q <=
                                normalize_first_fit_comb;
                    end
                    if (normalize_last_comb) begin
                        element_q <= 11'd0;
                        normalize_all_fit_q <= 1'b1;
                        if (!normalize_any_nonzero_q &&
                            !normalize_source_nonzero_comb) begin
                            normalize_candidate_q <= 8'sd0;
                            if (normalize_output_q) begin
                                output_read_return_q <=
                                    ST_OUTPUT_NORM_WRITE;
                                state_q <= ST_OUTPUT_READ;
                            end else begin
                                workspace_read_return_q <=
                                    ST_SCORE_NORM_WRITE;
                                state_q <= ST_WORKSPACE_READ;
                            end
                        end else begin
                            normalize_candidate_q <=
                                normalize_candidate_next_comb;
                            if (normalize_output_q) begin
                                output_read_return_q <= ST_OUTPUT_NORM_FIND;
                                state_q <= ST_OUTPUT_READ;
                            end else begin
                                workspace_read_return_q <= ST_SCORE_NORM_FIND;
                                state_q <= ST_WORKSPACE_READ;
                            end
                        end
                    end else begin
                        element_q <= element_q + 1'b1;
                        if (normalize_output_q) begin
                            output_read_return_q <= ST_NORM_CAPTURE;
                            state_q <= ST_OUTPUT_READ;
                        end else begin
                            workspace_read_return_q <= ST_NORM_CAPTURE;
                            state_q <= ST_WORKSPACE_READ;
                        end
                    end
                end

                ST_WORKSPACE_READ: begin
                    state_q <= workspace_read_return_q;
                end

                ST_OUTPUT_READ: begin
                    state_q <= output_read_return_q;
                end

                ST_SCORE_NORM_FIND,
                ST_SCORE_NORM_WRITE,
                ST_OUTPUT_NORM_FIND,
                ST_OUTPUT_NORM_WRITE,
                ST_EXP: begin
                    if (shift_request_valid && shift_request_ready) begin
                        shift_client_q <= shift_request_client_comb;
                        state_q <= ST_SHIFT_WAIT;
                    end
                end

                ST_SHIFT_WAIT: begin
                    if (shift_response_valid && shift_response_ready) begin
                        if (shift_response_fault) begin
                            state_q <= ST_FAULT;
                            range_fault_o <= 1'b1;
                        end else begin
                          case (shift_client_q)
                            SHIFT_CLIENT_SCORE_NORM_FIND: begin
                                if (!shift_response_sample_fit)
                                    normalize_all_fit_q <= 1'b0;
                                if (element_q == position_q) begin
                                    if (normalize_all_fit_q &&
                                        shift_response_sample_fit) begin
                                        element_q <= 11'd0;
                                        workspace_read_return_q <=
                                            ST_SCORE_NORM_WRITE;
                                        state_q <= ST_WORKSPACE_READ;
                                    end else if (normalize_candidate_q ==
                                                 8'sd31) begin
                                        state_q <= ST_FAULT;
                                        range_fault_o <= 1'b1;
                                    end else begin
                                        normalize_candidate_q <=
                                            normalize_candidate_q + 8'sd1;
                                        normalize_all_fit_q <= 1'b1;
                                        normalize_any_nonzero_q <= 1'b0;
                                        element_q <= 11'd0;
                                        workspace_read_return_q <=
                                            ST_SCORE_NORM_FIND;
                                        state_q <= ST_WORKSPACE_READ;
                                    end
                                end else begin
                                    element_q <= element_q + 1'b1;
                                    workspace_read_return_q <=
                                        ST_SCORE_NORM_FIND;
                                    state_q <= ST_WORKSPACE_READ;
                                end
                            end

                            SHIFT_CLIENT_SCORE_NORM_WRITE: begin
                                if (!shift_response_sample_fit) begin
                                    state_q <= ST_FAULT;
                                    range_fault_o <= 1'b1;
                                end else begin
                                    if (element_q == position_q) begin
                                        score_exponent_q <=
                                            normalize_candidate_q;
                                        element_q <= 11'd0;
                                        score_max_q <= 16'sd0;
                                        workspace_read_return_q <= ST_SCORE_MAX;
                                        state_q <= ST_WORKSPACE_READ;
                                    end else begin
                                        element_q <= element_q + 1'b1;
                                        workspace_read_return_q <=
                                            ST_SCORE_NORM_WRITE;
                                        state_q <= ST_WORKSPACE_READ;
                                    end
                                end
                            end

                            SHIFT_CLIENT_OUTPUT_NORM_FIND: begin
                                if (!shift_response_sample_fit)
                                    normalize_all_fit_q <= 1'b0;
                                if (element_q == 11'd255) begin
                                    if (normalize_all_fit_q &&
                                        shift_response_sample_fit) begin
                                        element_q <= 11'd0;
                                        output_read_return_q <=
                                            ST_OUTPUT_NORM_WRITE;
                                        state_q <= ST_OUTPUT_READ;
                                    end else if (normalize_candidate_q ==
                                                 8'sd31) begin
                                        state_q <= ST_FAULT;
                                        range_fault_o <= 1'b1;
                                    end else begin
                                        normalize_candidate_q <=
                                            normalize_candidate_q + 1'b1;
                                        normalize_all_fit_q <= 1'b1;
                                        normalize_any_nonzero_q <= 1'b0;
                                        element_q <= 11'd0;
                                        output_read_return_q <=
                                            ST_OUTPUT_NORM_FIND;
                                        state_q <= ST_OUTPUT_READ;
                                    end
                                end else begin
                                    element_q <= element_q + 1'b1;
                                    output_read_return_q <=
                                        ST_OUTPUT_NORM_FIND;
                                    state_q <= ST_OUTPUT_READ;
                                end
                            end

                            SHIFT_CLIENT_OUTPUT_NORM_WRITE: begin
                                if (!shift_response_sample_fit) begin
                                    state_q <= ST_FAULT;
                                    range_fault_o <= 1'b1;
                                end else begin
                                    if (element_q == 11'd255) begin
                                        result_exponent_q <=
                                            normalize_candidate_q;
                                        result_beat_q <= 2'd0;
                                        state_q <= ST_RESULT_READ;
                                    end else begin
                                        element_q <= element_q + 1'b1;
                                        output_read_return_q <=
                                            ST_OUTPUT_NORM_WRITE;
                                        state_q <= ST_OUTPUT_READ;
                                    end
                                end
                            end

                            SHIFT_CLIENT_EXP: begin
                                if (shift_response_result > 0) begin
                                    state_q <= ST_FAULT;
                                    range_fault_o <= 1'b1;
                                end else begin
                                    exp_index_q <=
                                        (shift_response_result < -64'sd4096)
                                        ? 13'd4096
                                        : $unsigned(-$signed(
                                            shift_response_result[12:0]));
                                    state_q <= ST_EXP_LUT_REQUEST;
                                end
                            end

                            default: begin
                                state_q <= ST_FAULT;
                                range_fault_o <= 1'b1;
                            end
                          endcase
                        end
                    end
                end

                ST_SCORE_MAX: begin
                    if ((element_q == 0) ||
                        (workspace_score_at_element >
                         $signed(score_max_q)))
                        score_max_q <= workspace_score_at_element;
                    if (element_q == position_q) begin
                        element_q <= 11'd0;
                        softmax_denominator_q <= 42'd0;
                        workspace_read_return_q <= ST_EXP;
                        state_q <= ST_WORKSPACE_READ;
                    end else begin
                        element_q <= element_q + 1'b1;
                        workspace_read_return_q <= ST_SCORE_MAX;
                        state_q <= ST_WORKSPACE_READ;
                    end
                end

                ST_EXP_LUT_REQUEST:
                    state_q <= ST_EXP_WAIT;

                ST_EXP_WAIT: begin
                    if (exp_response_valid) begin
                        if (exp_response_fault ||
                            (denominator_next_comb == 0) ||
                            denominator_next_comb[42]) begin
                            state_q <= ST_FAULT;
                            range_fault_o <= 1'b1;
                        end else begin
                        softmax_denominator_q <= denominator_next_comb[41:0];
                        if (element_q == position_q) begin
                            element_q <= 11'd0;
                            workspace_read_return_q <=
                                ST_PROBABILITY_REQUEST;
                            state_q <= ST_WORKSPACE_READ;
                        end else begin
                            element_q <= element_q + 1'b1;
                            workspace_read_return_q <= ST_EXP;
                            state_q <= ST_WORKSPACE_READ;
                        end
                        end
                    end
                end

                ST_PROBABILITY_REQUEST:
                    if (div_request_valid && div_request_ready)
                        state_q <= ST_PROBABILITY_WAIT;

                ST_PROBABILITY_WAIT: begin
                    if (div_response_valid && div_response_ready) begin
                        if (div_response_fault || (div_response_result < 0) ||
                            (div_response_result > 64'sd32767)) begin
                            state_q <= ST_FAULT;
                            range_fault_o <= 1'b1;
                        end else begin
                            if (element_q == position_q) begin
                                element_q <= 11'd0;
                                if (attention_head_q != 2'd3) begin
                                    attention_head_q <= attention_head_q + 1'b1;
                                    normalize_candidate_q <= -8'sd32;
                                    normalize_all_fit_q <= 1'b1;
                                    normalize_any_nonzero_q <= 1'b0;
                                    normalize_output_q <= 1'b0;
                                    workspace_read_return_q <= ST_NORM_CAPTURE;
                                    state_q <= ST_WORKSPACE_READ;
                                end else begin
                                    // Every head's denominator/probability pass
                                    // completes before any V row is requested.
                                    attention_head_q <= 2'd0;
                                    scan_position_q <= 11'd0;
                                    state_q <= ST_VALUE_ZERO;
                                end
                            end else begin
                                element_q <= element_q + 1'b1;
                                workspace_read_return_q <=
                                    ST_PROBABILITY_REQUEST;
                                state_q <= ST_WORKSPACE_READ;
                            end
                        end
                    end
                end

                ST_VALUE_ZERO: begin
                    // One addressed write per bank clears eight coordinates per edge.
                    // All32 head/group words must be initialized before V reads.
                    if(coordinate_q==0)begin
                        value_align_candidate_by_kv_q[0]<=-8'sd32; value_align_candidate_by_kv_q[1]<=-8'sd32;
                        value_align_any_by_kv_q[0]<=1'b0; value_align_any_by_kv_q[1]<=1'b0;
                    end
                    scan_position_q <= 11'd0;
                    if (coordinate_q == 6'd56) begin
                        if (attention_head_q == 2'd3) begin
                            attention_head_q <= 2'd0;
                            state_q <= ST_VALUE_REQUEST;
                        end else attention_head_q <= attention_head_q + 1'b1;
                    end else begin
                    end
                end

                ST_VALUE_REQUEST: begin
                    value_align_exponent_q<=value_group_exponent_q[attention_head_q[1]];
                    if (private_cache_request_valid_o &&
                        private_cache_request_ready_i) begin
                        captured_cache_kind_q <= CAPTURE_NONE;
                        state_q <= ST_VALUE_WAIT;
                    end
                end

                ST_VALUE_WAIT: begin
                    if (private_cache_response_valid_i &&
                        private_cache_response_ready_o) begin
                        if (private_cache_response_fault_i ||
                            !response_vectors_legal_comb ||
                            (private_cache_response_value_exponent_i < -8'sd32) ||
                            (private_cache_response_value_exponent_i > 8'sd31)) begin
                            state_q <= ST_FAULT;
                            range_fault_o <= 1'b1;
                        end else begin
                            captured_cache_kind_q <= CAPTURE_VALUE;
                            captured_value_exponent_q <=
                                private_cache_response_value_exponent_i;
                            state_q <= ST_VALUE_ALIGN;
                        end
                    end
                end

                ST_VALUE_ALIGN: begin
                    if (interface_live && align8_request_ready)
                        state_q <= ST_ALIGN8_WAIT;
                end

                ST_ALIGN8_WAIT: begin
                    if (align8_response_valid) begin
                        if (align8_response_fault) begin
                            state_q <= ST_FAULT;
                            range_fault_o <= 1'b1;
                        end else begin
                            value_align_candidate_by_kv_q[attention_head_q[1]]<=value_align_candidate_next_comb;
                            value_align_any_by_kv_q[attention_head_q[1]]<=value_align_any_next_comb;
                            if (coordinate_q == 6'd56) begin
                                workspace_read_return_q <= ST_VALUE_ACCUMULATE;
                                state_q <= ST_WORKSPACE_READ;
                            end else begin
                                state_q <= ST_VALUE_ALIGN;
                            end
                        end
                    end
                end

                ST_VALUE_ACCUMULATE: begin
                    // Each coordinate retains the original position order;
                    // only independent coordinate accumulators run together.
                    if (coordinate_q != 6'd56) begin
                    end else begin
                        if (!attention_head_q[0]) begin
                            // The same aligned V feeds the sibling Q's own
                            // probability and independent accumulator bank.
                            attention_head_q<=attention_head_q+1'b1;
                            workspace_read_return_q<=ST_VALUE_ACCUMULATE;
                            state_q<=ST_WORKSPACE_READ;
                        end else if (scan_position_q==position_q &&
                            ((value_align_any_nonzero_q ? value_align_candidate_q : 8'sd0)
                              != value_align_exponent_q)) begin
                            state_q<=ST_FAULT;range_fault_o<=1'b1;
                        end else if (scan_position_q!=position_q) begin
                            // Per-head sums retain ascending position order;
                            // finish this sibling pair before changing KV head.
                            attention_head_q<=attention_head_q-2'd1;
                            scan_position_q<=scan_position_q+1'b1;
                            state_q<=ST_VALUE_REQUEST;
                        end else if (attention_head_q==2'd1) begin
                            attention_head_q<=2'd2;
                            scan_position_q<=11'd0;
                            state_q<=ST_VALUE_REQUEST;
                        end else begin
                            // All four PV sums and both observed-fit checks
                            // precede any head division or public result.
                            attention_head_q<=2'd0;
                            state_q<=ST_ACCUMULATOR_READ;
                        end
                    end
                end

                ST_ACCUMULATOR_READ:
                    state_q<=ST_VALUE_DIV_REQUEST;

                ST_VALUE_DIV_REQUEST:
                    if (div_request_valid && div_request_ready)
                        state_q <= ST_VALUE_DIV_WAIT;

                ST_VALUE_DIV_WAIT: begin
                    if (div_response_valid && div_response_ready) begin
                        if (div_response_fault ||
                            (div_response_result < HEAD_OUTPUT_MINIMUM) ||
                            (div_response_result > HEAD_OUTPUT_MAXIMUM)) begin
                            state_q <= ST_FAULT;
                            range_fault_o <= 1'b1;
                        end else begin
                            if (coordinate_q == 6'd63) begin
                                state_q <= ST_NEXT_HEAD;
                            end else begin
                                if(coordinate_q[2:0]==3'd7)state_q<=ST_ACCUMULATOR_READ;
                                else state_q<=ST_VALUE_DIV_REQUEST;
                            end
                        end
                    end
                end

                ST_NEXT_HEAD: begin
                    if (attention_head_q == 2'd3) begin
                        element_q <= 11'd0;
                        normalize_candidate_q <= -8'sd32;
                        normalize_all_fit_q <= 1'b1;
                        normalize_any_nonzero_q <= 1'b0;
                        normalize_output_q <= 1'b1;
                        output_read_return_q <= ST_NORM_CAPTURE;
                        state_q <= ST_OUTPUT_READ;
                    end else begin
                        attention_head_q <= attention_head_q + 1'b1;
                        state_q <= ST_ACCUMULATOR_READ;
                    end
                end

                ST_RESULT_READ: begin
                    state_q <= ST_RESULT_CAPTURE;
                end

                ST_RESULT_CAPTURE: begin
                    result_buffer_q[coordinate_q*16 +: 16] <=
                        output_bram_read_data;
                    if (coordinate_q == 6'd63) begin
                        state_q <= ST_RESULT;
                    end else begin
                        state_q <= ST_RESULT_READ;
                    end
                end

                ST_RESULT: begin
                    if (result_valid_o && result_ready_i) begin
                        if (result_beat_q == 2'd3) begin
                            state_q <= ST_DONE;
                        end else begin
                            result_beat_q <= result_beat_q + 1'b1;
                            state_q <= ST_RESULT_READ;
                        end
                    end
                end

                ST_DONE:
                    if (done_valid_o && done_ready_i)
                        state_q <= ST_IDLE;

                ST_CLEAR_DRAIN: begin
                    range_fault_o <= 1'b0;
                    if (cache_response_known_handshake) begin
                        state_q <= ST_IDLE;
                    end
                end

                ST_FAULT: begin
                    range_fault_o <= 1'b1;
                    state_q <= ST_FAULT;
                end

                default: begin
                    state_q <= ST_FAULT;
                    range_fault_o <= 1'b1;
                end
            endcase
        end
    end


// Simulation-only, with explicit opt-in for model recipes that define SYNTHESIS.
// Native recipes never define BOARD1_ATTENTION_COORDINATE_PHASE_CHECK.
`ifndef SYNTHESIS
`define BOARD1_ATTENTION_COORDINATE_PHASE_OBSERVER
`elsif BOARD1_ATTENTION_COORDINATE_PHASE_CHECK
`define BOARD1_ATTENTION_COORDINATE_PHASE_OBSERVER
`endif
`ifdef BOARD1_ATTENTION_COORDINATE_PHASE_OBSERVER
    logic [5:0] legacy_coordinate_q;
    always_ff @(posedge clk or negedge rst_n) begin
        if (!rst_n) begin
            ;
            ;
            ;
            ;
            ;
            ;
            ;
            legacy_coordinate_q <= 6'd0;
            ;
            ;
            ; ;
            ; ;
            ;
            ;
            ;
            ;
            ;
            ;
            ;
            ;
            ;
            ;
            ;
            ;
            ;
            ;
            ;
            ;
            ;
            ;
            ;
            ;
            ;
        end else if (clear_i) begin
            if ((cache_wait_state || cache_drain_state ||
                 ((state_q == ST_FAULT) && fault_cache_outstanding_q)) &&
                !cache_response_known_handshake) begin
                ;
            end else begin
                ;
            end
            ;
            ;
            ;
            ;
            ;
            ;
            ;
            legacy_coordinate_q <= 6'd0;
            ;
            ;
            ; ;
            ; ;
            ;
            ;
            ;
            ;
            ;
            ;
            ;
            ;
            ;
            ;
            ;
            ;
            ;
            ;
            ;
            ;
            ;
            ;
            ;
            ;
        end else if (simulation_x_fault || upstream_fault_i || exp_range_fault ||
                     capture_kind_fault || summary_fault || accumulator_memory_fault ||
                     accumulator_tag_fault || accumulator_initialization_fault ||
                     ((state_q != ST_IDLE) && !model_lock_i) ||
                     ((state_q != ST_IDLE) &&
                      (compute_cycles_q >= MAX_COMPUTE_CYCLES))) begin
            ;
            ;
            if ((state_q != ST_FAULT) &&
                (cache_wait_state || cache_drain_state) &&
                !cache_response_known_handshake)
                ;
        end else begin
            if (state_q == ST_IDLE)
                ;
            else if (state_q != ST_FAULT)
                ;

            case (state_q)
                ST_IDLE: begin
                    ;
                    if (start_valid_i && start_ready_o) begin
                        if (!summary_read_valid || (query_exponent_i < -8'sd32) ||
                            (query_exponent_i > 8'sd31)) begin
                            ;
                            ;
                        end else begin
                            ;
                            ;
                            ;
                            ;
                            ;
                            ;
                        end
                    end
                end

                ST_QUERY_LOAD: begin
                    if (query_valid_i && query_ready_o) begin
                        if (!query_vector_legal_comb ||
                            (query_last_i != (query_beat_q == 2'd3))) begin
                            ;
                            ;
                        end else begin
                            ;
                            legacy_coordinate_q <= 6'd0;
                            ;
                        end
                    end
                end

                ST_QUERY_STORE: begin
                    if (legacy_coordinate_q == 6'd63) begin
                        legacy_coordinate_q <= 6'd0;
                        if (query_beat_q == 2'd3) begin
                                ;
                                ;
                                ; ;
                                ; ;
                                ;
                                ;
                        end else begin
                            ;
                            ;
                        end
                    end else begin
                        legacy_coordinate_q <= legacy_coordinate_q + 1'b1;
                    end
                end

                ST_VALUE_EXP_REQUEST: begin
                    if (private_cache_request_valid_o &&
                        private_cache_request_ready_i) begin
                        ;
                        ;
                    end
                end

                ST_VALUE_EXP_WAIT: begin
                    if (private_cache_response_valid_i &&
                        private_cache_response_ready_o) begin
                        if (private_cache_response_fault_i ||
                            !response_vectors_legal_comb ||
                            (private_cache_response_value_exponent_i < -8'sd32) ||
                            (private_cache_response_value_exponent_i > 8'sd31)) begin
                            ;
                            ;
                        end else begin
                            ;
                            ;
                            legacy_coordinate_q <= 6'd0;
                            ;
                        end
                    end
                end

                ST_VALUE_EXP_SCAN: begin
                    if (interface_live && align8_request_ready)
                        ;
                end

                ST_EXP8_WAIT: begin
                    if (align8_response_valid) begin
                        if (align8_response_fault || align8_response_magnitude_or[15]) begin
                            ;
                            ;
                        end else begin
                            if (captured_value_coordinate != 0) begin
                                ;
                                if (captured_value_fit_comb >
                                    value_align_candidate_q)
                                    ;
                            end
                            if (legacy_coordinate_q == 6'd56) begin
                                legacy_coordinate_q <= 6'd0;
                                if (scan_position_q == position_q) begin
                                    ;
                                    ;
                                    ;
                                    ;
                                end else begin
                                    ;
                                    ;
                                end
                            end else begin
                                legacy_coordinate_q <= legacy_coordinate_q + 6'd8;
                                ;
                            end
                        end
                    end
                end

                ST_SCORE_REQUEST: begin
                    if (private_cache_request_valid_o &&
                        private_cache_request_ready_i) begin
                        ;
                        ;
                    end
                end

                ST_SCORE_WAIT: begin
                    if (private_cache_response_valid_i &&
                        private_cache_response_ready_o) begin
                        if (private_cache_response_fault_i ||
                            !response_vectors_legal_comb ||
                            (private_cache_response_key_exponent_i < -8'sd32) ||
                            (private_cache_response_key_exponent_i > 8'sd31)) begin
                            ;
                            ;
                        end else begin
                            ;
                            ;
                            ;
                            legacy_coordinate_q <= 6'd0;
                            ;
                        end
                    end
                end

                ST_SCORE_ACCUMULATE: begin
                    ;
                    ;
                end

                ST_SCORE_QUERY_USE: begin
                    if (legacy_coordinate_q != 6'd56) begin
                        ;
                        legacy_coordinate_q <= legacy_coordinate_q + 6'd8;
                        ;
                    end else if ((score_accumulator_next_comb <
                                  SCORE_MINIMUM_39) ||
                                 (score_accumulator_next_comb >
                                  SCORE_MAXIMUM_39)) begin
                        ;
                        ;
                    end else begin
                        legacy_coordinate_q <= 6'd0;
                        if (!attention_head_q[0]) begin
                            // Reuse the accepted K row with the sibling Q.
                            ;
                            ;
                        end else if (scan_position_q != position_q) begin
                            // Keep one authenticated head/role page hot while
                            // both sibling queries walk positions in order.
                            ;
                            ;
                            ;
                        end else if (attention_head_q == 2'd1) begin
                            ;
                            ;
                            ;
                        end else begin
                            // All raw scores exist before the first softmax.
                            ;
                            ;
                            ;
                            ;
                            ;
                            ;
                            ;
                            ;
                        end
                    end
                end

                ST_NORM_CAPTURE: begin
                    ;
                end

                ST_NORM_SELECT: begin
                    if (normalize_source_nonzero_comb) begin
                        ;
                        if (normalize_first_fit_comb >
                            normalize_candidate_q)
                            ;
                    end
                    if (normalize_last_comb) begin
                        ;
                        ;
                        if (!normalize_any_nonzero_q &&
                            !normalize_source_nonzero_comb) begin
                            ;
                            if (normalize_output_q) begin
                                ;
                                ;
                            end else begin
                                ;
                                ;
                            end
                        end else begin
                            ;
                            if (normalize_output_q) begin
                                ;
                                ;
                            end else begin
                                ;
                                ;
                            end
                        end
                    end else begin
                        ;
                        if (normalize_output_q) begin
                            ;
                            ;
                        end else begin
                            ;
                            ;
                        end
                    end
                end

                ST_WORKSPACE_READ: begin
                    ;
                end

                ST_OUTPUT_READ: begin
                    ;
                end

                ST_SCORE_NORM_FIND,
                ST_SCORE_NORM_WRITE,
                ST_OUTPUT_NORM_FIND,
                ST_OUTPUT_NORM_WRITE,
                ST_EXP: begin
                    if (shift_request_valid && shift_request_ready) begin
                        ;
                        ;
                    end
                end

                ST_SHIFT_WAIT: begin
                    if (shift_response_valid && shift_response_ready) begin
                        if (shift_response_fault) begin
                            ;
                            ;
                        end else begin
                          case (shift_client_q)
                            SHIFT_CLIENT_SCORE_NORM_FIND: begin
                                if (!shift_response_sample_fit)
                                    ;
                                if (element_q == position_q) begin
                                    if (normalize_all_fit_q &&
                                        shift_response_sample_fit) begin
                                        ;
                                        ;
                                        ;
                                    end else if (normalize_candidate_q ==
                                                 8'sd31) begin
                                        ;
                                        ;
                                    end else begin
                                        ;
                                        ;
                                        ;
                                        ;
                                        ;
                                        ;
                                    end
                                end else begin
                                    ;
                                    ;
                                    ;
                                end
                            end

                            SHIFT_CLIENT_SCORE_NORM_WRITE: begin
                                if (!shift_response_sample_fit) begin
                                    ;
                                    ;
                                end else begin
                                    if (element_q == position_q) begin
                                        ;
                                        ;
                                        ;
                                        ;
                                        ;
                                    end else begin
                                        ;
                                        ;
                                        ;
                                    end
                                end
                            end

                            SHIFT_CLIENT_OUTPUT_NORM_FIND: begin
                                if (!shift_response_sample_fit)
                                    ;
                                if (element_q == 11'd255) begin
                                    if (normalize_all_fit_q &&
                                        shift_response_sample_fit) begin
                                        ;
                                        ;
                                        ;
                                    end else if (normalize_candidate_q ==
                                                 8'sd31) begin
                                        ;
                                        ;
                                    end else begin
                                        ;
                                        ;
                                        ;
                                        ;
                                        ;
                                        ;
                                    end
                                end else begin
                                    ;
                                    ;
                                    ;
                                end
                            end

                            SHIFT_CLIENT_OUTPUT_NORM_WRITE: begin
                                if (!shift_response_sample_fit) begin
                                    ;
                                    ;
                                end else begin
                                    if (element_q == 11'd255) begin
                                        ;
                                        ;
                                        legacy_coordinate_q <= 6'd0;
                                        ;
                                    end else begin
                                        ;
                                        ;
                                        ;
                                    end
                                end
                            end

                            SHIFT_CLIENT_EXP: begin
                                if (shift_response_result > 0) begin
                                    ;
                                    ;
                                end else begin
                                    ;
                                    ;
                                end
                            end

                            default: begin
                                ;
                                ;
                            end
                          endcase
                        end
                    end
                end

                ST_SCORE_MAX: begin
                    if ((element_q == 0) ||
                        (workspace_score_at_element >
                         $signed(score_max_q)))
                        ;
                    if (element_q == position_q) begin
                        ;
                        ;
                        ;
                        ;
                    end else begin
                        ;
                        ;
                        ;
                    end
                end

                ST_EXP_LUT_REQUEST:
                    ;

                ST_EXP_WAIT: begin
                    if (exp_response_valid) begin
                        if (exp_response_fault ||
                            (denominator_next_comb == 0) ||
                            denominator_next_comb[42]) begin
                            ;
                            ;
                        end else begin
                        ;
                        if (element_q == position_q) begin
                            ;
                            ;
                            ;
                        end else begin
                            ;
                            ;
                            ;
                        end
                        end
                    end
                end

                ST_PROBABILITY_REQUEST:
                    if (div_request_valid && div_request_ready)
                        ;

                ST_PROBABILITY_WAIT: begin
                    if (div_response_valid && div_response_ready) begin
                        if (div_response_fault || (div_response_result < 0) ||
                            (div_response_result > 64'sd32767)) begin
                            ;
                            ;
                        end else begin
                            if (element_q == position_q) begin
                                ;
                                legacy_coordinate_q <= 6'd0;
                                if (attention_head_q != 2'd3) begin
                                    ;
                                    ;
                                    ;
                                    ;
                                    ;
                                    ;
                                    ;
                                end else begin
                                    // Every head's denominator/probability pass
                                    // completes before any V row is requested.
                                    ;
                                    ;
                                    ;
                                end
                            end else begin
                                ;
                                ;
                                ;
                            end
                        end
                    end
                end

                ST_VALUE_ZERO: begin
                    // One addressed write per bank clears eight coordinates per edge.
                    // All32 head/group words must be initialized before V reads.
                    if(legacy_coordinate_q==0)begin
                        ; ;
                        ; ;
                    end
                    ;
                    if (legacy_coordinate_q == 6'd56) begin
                        legacy_coordinate_q <= 6'd0;
                        if (attention_head_q == 2'd3) begin
                            ;
                            ;
                        end else ;
                    end else begin
                        legacy_coordinate_q <= legacy_coordinate_q + 6'd8;
                    end
                end

                ST_VALUE_REQUEST: begin
                    ;
                    if (private_cache_request_valid_o &&
                        private_cache_request_ready_i) begin
                        ;
                        ;
                    end
                end

                ST_VALUE_WAIT: begin
                    if (private_cache_response_valid_i &&
                        private_cache_response_ready_o) begin
                        if (private_cache_response_fault_i ||
                            !response_vectors_legal_comb ||
                            (private_cache_response_value_exponent_i < -8'sd32) ||
                            (private_cache_response_value_exponent_i > 8'sd31)) begin
                            ;
                            ;
                        end else begin
                            ;
                            ;
                            legacy_coordinate_q <= 6'd0;
                            ;
                        end
                    end
                end

                ST_VALUE_ALIGN: begin
                    if (interface_live && align8_request_ready)
                        ;
                end

                ST_ALIGN8_WAIT: begin
                    if (align8_response_valid) begin
                        if (align8_response_fault) begin
                            ;
                            ;
                        end else begin
                            ;
                            ;
                            if (legacy_coordinate_q == 6'd56) begin
                                legacy_coordinate_q <= 6'd0;
                                ;
                                ;
                            end else begin
                                legacy_coordinate_q <= legacy_coordinate_q + 6'd8;
                                ;
                            end
                        end
                    end
                end

                ST_VALUE_ACCUMULATE: begin
                    // Each coordinate retains the original position order;
                    // only independent coordinate accumulators run together.
                    if (legacy_coordinate_q != 6'd56) begin
                        legacy_coordinate_q <= legacy_coordinate_q + 6'd8;
                    end else begin
                        legacy_coordinate_q <= 6'd0;
                        if (!attention_head_q[0]) begin
                            // The same aligned V feeds the sibling Q's own
                            // probability and independent accumulator bank.
                            ;
                            ;
                            ;
                        end else if (scan_position_q==position_q &&
                            ((value_align_any_nonzero_q ? value_align_candidate_q : 8'sd0)
                              != value_align_exponent_q)) begin
                            ;;
                        end else if (scan_position_q!=position_q) begin
                            // Per-head sums retain ascending position order;
                            // finish this sibling pair before changing KV head.
                            ;
                            ;
                            ;
                        end else if (attention_head_q==2'd1) begin
                            ;
                            ;
                            ;
                        end else begin
                            // All four PV sums and both observed-fit checks
                            // precede any head division or public result.
                            ;
                            ;
                        end
                    end
                end

                ST_ACCUMULATOR_READ:
                    ;

                ST_VALUE_DIV_REQUEST:
                    if (div_request_valid && div_request_ready)
                        ;

                ST_VALUE_DIV_WAIT: begin
                    if (div_response_valid && div_response_ready) begin
                        if (div_response_fault ||
                            (div_response_result < HEAD_OUTPUT_MINIMUM) ||
                            (div_response_result > HEAD_OUTPUT_MAXIMUM)) begin
                            ;
                            ;
                        end else begin
                            if (legacy_coordinate_q == 6'd63) begin
                                ;
                            end else begin
                                legacy_coordinate_q <= legacy_coordinate_q + 1'b1;
                                if(legacy_coordinate_q[2:0]==3'd7);
                                else ;
                            end
                        end
                    end
                end

                ST_NEXT_HEAD: begin
                    if (attention_head_q == 2'd3) begin
                        ;
                        ;
                        ;
                        ;
                        ;
                        ;
                        ;
                    end else begin
                        ;
                        legacy_coordinate_q <= 6'd0;
                        ;
                    end
                end

                ST_RESULT_READ: begin
                    ;
                end

                ST_RESULT_CAPTURE: begin
                    ;
                    if (legacy_coordinate_q == 6'd63) begin
                        legacy_coordinate_q <= 6'd0;
                        ;
                    end else begin
                        legacy_coordinate_q <= legacy_coordinate_q + 1'b1;
                        ;
                    end
                end

                ST_RESULT: begin
                    if (result_valid_o && result_ready_i) begin
                        if (result_beat_q == 2'd3) begin
                            ;
                        end else begin
                            ;
                            legacy_coordinate_q <= 6'd0;
                            ;
                        end
                    end
                end

                ST_DONE:
                    if (done_valid_o && done_ready_i)
                        ;

                ST_CLEAR_DRAIN: begin
                    ;
                    if (cache_response_known_handshake) begin
                        ;
                    end
                end

                ST_FAULT: begin
                    ;
                    ;
                end

                default: begin
                    ;
                    ;
                end
            endcase
        end
    end

    // Equality is checked before the active edge at every authorized use of
    // the coordinate. Element-only workspace/output normalization is excluded.
    wire [14:0] coordinate_phase_use = {
        (interface_live && state_q==ST_SCORE_QUERY_USE && workspace_bram_write_enable),
        (result_valid_o && result_ready_i),
        (interface_live && state_q==ST_RESULT_CAPTURE),
        (interface_live && state_q==ST_VALUE_ACCUMULATE),
        (interface_live && state_q==ST_SCORE_QUERY_USE),
        (interface_live && state_q==ST_VALUE_DIV_WAIT),
        (interface_live && div_request_valid && div_request_ready),
        (interface_live && (state_q==ST_ALIGN8_WAIT || state_q==ST_EXP8_WAIT)),
        (interface_live && align8_request_ready &&
            (state_q==ST_VALUE_ALIGN || state_q==ST_VALUE_EXP_SCAN)),
        accumulator_write_enable,
        accumulator_read_enable,
        output_bram_write_raw,
        (output_bram_read_enable && state_q==ST_RESULT_READ),
        query_bram_write_enable,
        query_bram_read_enable
    };
    longint unsigned coordinate_phase_counts [0:14];
    longint unsigned coordinate_phase_total_uses=0;
    longint unsigned coordinate_phase_reset_cycles=0;
    longint unsigned coordinate_phase_clear_cycles=0;
    longint unsigned coordinate_phase_fault_entries=0;
    logic [14:0] coordinate_phase_coverage=0;
    logic [41:0] coordinate_phase_abort_states=0;
    logic [5:0] coordinate_phase_previous_state=ST_IDLE;
    initial begin
        for(integer p=0;p<15;p=p+1) coordinate_phase_counts[p]=0;
    end
    always @(posedge clk) begin
        if(!rst_n) coordinate_phase_reset_cycles++;
        else begin
            if((^coordinate_phase_use) === 1'bx)
                $fatal(1,"COORDINATE_PHASE unknown authorization mask");
            if(clear_i) coordinate_phase_clear_cycles++;
            if(state_q==ST_FAULT && coordinate_phase_previous_state!=ST_FAULT)
                coordinate_phase_fault_entries++;
            if((clear_i || !interface_live) && state_q<=ST_ACCUMULATOR_READ)
                coordinate_phase_abort_states[state_q]=1'b1;
            if((|coordinate_phase_use) === 1'b1) begin
                if(coordinate_q !== legacy_coordinate_q)
                    $fatal(1,"COORDINATE_PHASE mismatch state=%0d uses=%h actual=%0d legacy=%0d clear=%b fault=%b",
                        state_q,coordinate_phase_use,coordinate_q,legacy_coordinate_q,clear_i,range_fault_o);
                coordinate_phase_total_uses++;
                coordinate_phase_coverage |= coordinate_phase_use;
                for(integer p=0;p<15;p=p+1)
                    if(coordinate_phase_use[p]) coordinate_phase_counts[p]++;
            end
        end
        coordinate_phase_previous_state=state_q;
    end
    final begin
        $display("COORDINATE_PHASE_MONITOR uses=%0d coverage=%h reset_cycles=%0d clear_cycles=%0d fault_entries=%0d abort_states=%h original_updates=25",
            coordinate_phase_total_uses,coordinate_phase_coverage,
            coordinate_phase_reset_cycles,coordinate_phase_clear_cycles,
            coordinate_phase_fault_entries,coordinate_phase_abort_states);
        for(integer p=0;p<15;p=p+1)
            $display("COORDINATE_PHASE_USE kind=%0d count=%0d",p,coordinate_phase_counts[p]);
        if($test$plusargs("COORDINATE_PHASE_REQUIRE_COVERAGE") && coordinate_phase_coverage!==15'h7fff)
            $fatal(1,"COORDINATE_PHASE required healthy use category missing");
        if($test$plusargs("COORDINATE_PHASE_REQUIRE_CLEAR") && coordinate_phase_clear_cycles==0)
            $fatal(1,"COORDINATE_PHASE required CLEAR coverage missing");
        if($test$plusargs("COORDINATE_PHASE_REQUIRE_ABORT") && coordinate_phase_fault_entries==0)
            $fatal(1,"COORDINATE_PHASE required abort coverage missing");
    end

`endif
`undef BOARD1_ATTENTION_COORDINATE_PHASE_OBSERVER
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
