Berkeley-AI-Risk/inference-only/maintenance/flash-reader/rtl/readonly_flash_reader.sv

`timescale 1ns/1ps
`default_nettype none

// Temporary SRAM diagnostic ONLY. Never install as persistent configuration.
// Production top has no parameters: the host cannot choose an address, length,
// opcode, write data, clock rate, or pin direction.
module readonly_flash_reader (
    input wire clk_50mhz,
    input wire reset_button,
    input wire uart_rx,
    output wire uart_tx,
    output wire flash_csn,
    output wire flash_sclk,
    inout wire [3:0] flash_dq
);
    // Power-on delay also produces reset after SRAM configuration. External
    // reset asserts asynchronously; release is synchronized to the only clock.
    logic [15:0] poweron_q = 16'd0;
    (* async_reg = "true", syn_preserve = 1 *) logic [1:0] reset_release_q = 2'b00;
    always_ff @(posedge clk_50mhz or posedge reset_button) begin
        if (reset_button) poweron_q <= 16'd0;
        else if (!(&poweron_q)) poweron_q <= poweron_q + 1'b1;
    end
    wire reset_request = reset_button || !(&poweron_q);
    always_ff @(posedge clk_50mhz or posedge reset_request) begin
        if (reset_request) reset_release_q <= 2'b00;
        else reset_release_q <= {reset_release_q[0], 1'b1};
    end
    wire flash_mosi, reader_csn, reader_sclk, reader_uart;
    // Establish deselection before the first clock after SRAM configuration,
    // even before the core's asynchronous reset has propagated.
    assign flash_csn = reset_release_q[1] ? reader_csn : 1'b1;
    assign flash_sclk = reset_release_q[1] ? reader_sclk : 1'b0;
    assign uart_tx = reset_release_q[1] ? reader_uart : 1'b1;
    assign flash_dq[0] = !flash_csn ? flash_mosi : 1'bz;
    assign flash_dq[1] = 1'bz;
    assign flash_dq[2] = 1'b1; // WP# inactive; no quad mode.
    assign flash_dq[3] = 1'b1; // HOLD#/RESET# inactive.
    readonly_flash_reader_core #(
        .DUMP_BYTES(25'd16777216), .UART_CLKS(434), .SPI_HALF_CLKS(25)
    ) u_reader (
        .clk(clk_50mhz), .rst_n(reset_release_q[1]),
        .uart_rx(uart_rx), .uart_tx(reader_uart),
        .flash_csn(reader_csn), .flash_sclk(reader_sclk),
        .flash_mosi(flash_mosi), .flash_miso(flash_dq[1])
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
