Berkeley-AI-Risk/inference-only/(commit log)

2026-10-22 Add runnable Qwen3-8B prototype and explain formal verification
2026-10-24 Publish optimized seeded inference with current scoped qualification
2026-10-26 Organize model documentation and add measured residual training analysis
    Move Tang-specific assessments into its demo folder and collect shared analysis and H100 campaigns under docs. Preserve root links used by pinned guides and frozen records.
    Add Qwen H100 measurements, a shared-method SimpleStories calibration, and verified evidence and calculators. The reported training-capacity comparisons remain conditional parent-model proxies.
    Validate documentation paths, numerical tables, archived evidence and the release inventory; preserve all existing hardware, source and experiment assets.
2026-10-26 Qualify faster SimpleStories FPGA releases
    Ship the selected baseline, K/V-protected and encrypted-memory designs with full-context CLI/browser qualification and exact portable source/evidence replay. Their matched two-trial, 128-output common rates are 10.04, 7.03 and 6.04 tokens/s.
    Document the current designs and proof boundaries, remove Lean and obsolete runnable payloads, and preserve Qwen/H100 evidence. Encrypted memory retains K/V protection and uses public demonstration keys; complete vendor-DDR timing remains unqualified.
    Validation: 39 offline command groups, all-three source/model/native/proof/CLI/browser and common-host replay, and verified plaintext restoration plus seeded rel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
2026-10-26 Publish matched Qwen FPGA speed measurements
    Report two complete one-token,128-output greedy trials per model:9.00995 cached tokens/s for Qwen3-1.7B and1.12178/s for Qwen3-8B. Use the common generation-loop reply boundary and complete all six overview rows. Bind the512 matching outputs to raw captures, process exits, the independent fixed-model CPU reference and exact image/host sources.
    Refresh measurement availability in the residual-capacity discussion without changing H100 evidence or fixed-context proxy values. Preserve the qualified SimpleStories release and refresh only its permitted member-map literal; checker behavior and hardware evidence remain unchanged.
2026-10-26 Clarify sampled generation and simplify speed table labels
    Report the existing temperature-1 pair with the same pooled host-loop timing used for the greedy benchmark:9.93 cached tokens/s versus10.02 at temperature0. Use a tilde for approximate rates, keep one decimal place, and remove image from the seeded row label. Preserve all measured rates and the common greedy workload.
2026-10-26 Report sampled generation at temperature 1 in the speed table
    Use two recorded one-token, 128-output trials with the fixed public seed and independent numerical reference. Replay the sampling settings, CLEAR, prompt and output frames; keep the shared host-loop timing definition.
    Report ~9.9 tokens/s for the sampled configuration and remove the repeated README paragraph. Preserve every raw capture and all five other benchmark rows.
2026-10-26 Add source-bound inference-only implementation assurance
    Publish current RTL checks for boot/runtime enforcement, the fixed-length boot controller and QSPI reader, full-size asynchronous FIFOs, their actual transport compositions, and all three greedy public controllers. Include exact inputs, solver evidence, semantic mutants, source audits, a portable recorded checker and fresh phase replay. Retain secondary timeouts and the explicit open boot-to-physical-DDR temporal composition boundary.
    Add configured inference MHz to the common throughput table using the existing benchmark identities. Hardware images, model, host implementation and benchmark numeric records are unchanged.
    Validation: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
2026-10-27 Clarify the formal guarantees and proof boundaries
    Lead the SimpleStories formal status with the established post-LOCK model-write exclusion guarantee. Diagram the checked path through boot/runtime ownership and custom FIFOs to the vendor application interface, and explain why queued boot writes cannot bypass LOCK.
    Separate control guarantees from numerical correctness, native boot reachability, authentication arithmetic, vendor/physical behavior and residual training-capacity claims. Retain the detailed proof inventory and all hardware, model, host, proof evidence and benchmark bytes.
    Validation: Mermaid diagram rendered locally; 431 active links resolve; strict release integrity and curr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
2026-10-27 Explain how model-write exclusion supports inference-only operation
    Connect the post-LOCK guarantee to the fixed-model requirement while allowing temporary K/V state to evolve. Explain that low residual training capacity also depends on access to arithmetic and intermediate state, authentication and physical enforcement.
    Retain the existing diagram, proof inventory and all hardware, model, host, proof evidence and benchmark bytes.
    Validation: 433 active links resolve; strict release integrity and current release admission checks pass. No new solver or hardware campaign is claimed.
2026-10-27 Verify native authentication and restricted inference access
    Prove the current SimpleStories SHA compression/chaining, fixed-digest
    admission, sealed model-RAM consumption, six-layer schedule and private
    operand/address routing. Join both protected K/V guard/current-cache scopes
    through the actual source connections to attention capture/use.
    Publish 22 source-audited components with exact models, queries, solver replies,
    semantic counterexamples and portable recorded/fresh-query checks. Preserve
    original partial outcomes and secondary timeouts. State cryptographic hardness,
    trusted on-chip state and vendor functional-model assumptions explicitly.
    No whole-machine numerical, physical, mapped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
2026-10-27 Add experimental SimpleStories HWIC source checkpoint
    Make HWIC research visible near the top of the main README,with exact HNLPU attribution and clear ASIC qualification limits. Include the unchanged complete-model RTL,fresh seven-case numerical evidence,and a changed-weight rejection test. Extend the reviewed inventory contract without changing FPGA payloads or weakening verification.
2026-10-27 Move experimental HWIC research below FPGA instructions
    Keep FPGA demonstrations and installation first. Move the existing HWIC section after Run a demonstration, preserving its HNLPU citation and research status. Refresh the README integrity chain without changing verification logic or hardware payloads.
2026-10-28 Verify working-memory ownership and CLEAR drain components
    Publish source-bound component guarantees for all four current SimpleStories
    images: native RAM/current-writer history, staging and typed-write provenance,
    model-read core drain, and connected semantic/model/KV accepted-work ownership.
    Preserve exact inputs, queries, replies, source joins, unresolved original
    outcomes and thirteen real corruption sensitivity cases in a portable packet.
    State the remaining common device entry/outer transport, numerical/reply,
    attention/token publication and complete mutable-state composition obligations.
    The 82 selected records overlap; they are not a coverage score. Full device
    session isolation, ph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
2026-10-29 docs(qwen): explain the joint verification objective
    Distinguish functional correctness from inference-only restrictions, state the intended interface theorem, and explain how block proofs support the whole-design argument. Keep the theorem and residual training factor explicitly unproved.
2026-10-29 Verify normal encrypted K/V return values and clarify proof roles
    Publish the source-bound normal 256-bit integrity-guard response theorem,
    its closed evidence packet, independent query reconstruction and fresh
    Yosys/Z3/native replay. Preserve the current-row memory and primitive
    contracts and the remaining public CLEAR, fault, physical and whole-device
    session-isolation boundaries.
    Distinguish functional correctness from inference-only restrictions in
    SimpleStories formal documentation, matching the Qwen program's structure.
    Add recorded checks and refusal tests to offline CI. Refresh only the
    reviewed byte maps; hardware/model/host/clock/benchmark and Qwen/other-model
    bytes are unchanged.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
2026-10-29 Document October 29 HWIC research progress
    Summarize validated SimpleStories baselines, pending integrated regression,
    AWIC source reuse and remaining ASIC milestones, with HNLPU attribution.
    Link the progress note from the existing HWIC README section and refresh
    the required integrity maps and verifier hash literal.
    Validation: exact five-file overlay and integrity chain checked; verifier
    logic unchanged; progress-note link checked. No new hardware simulation
    or complete package regression. No handoff, RTL, assets or workflows added.
2026-11-03 Record completed mapped ROM16 HWIC regression
    Publish finite four-seed block results and intended circuit-fault failure,
    with selected excerpts, reusable helpers and HNLPU attribution. Keep the
    published full-model RTL baseline unchanged and distinguish ASIC gaps.
    Validation: independent content/privacy review, strict 16,648-file release
    integrity verification, seven helper tests and ten integrity tests passed.
    No model assets, private paths, build trees, process libraries or workflows added.
2026-11-04 Verify native RMSNorm invocation and conditional model-cache values
    Publish the baseline RMSNorm invocation-confinement proof with its complete
    native numerical subtree, and the production four-bank cache-service word
    identity theorem under an explicit upstream ordered raw-read contract.
    Include readable component statements, acyclic SMT plans, source/compiler
    bindings, all 136 exact compressed queries and engine replies, operating
    witnesses and actual-only numerical defects, with portable complete replay.
    Keep upstream DDR composition and the whole-device theorem explicitly open.
    Validation: fresh native recompilation and every query pass (135 UNSAT and
    one SAT nonvacuity check); all 13 R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
2026-11-04 Add board-tested signed-update SimpleStories S-AWIC demo
    Authorize compatible full-model packages at boot with two of three LMS
    signatures. Include complete Tang source, the tested SRAM bitstream,
    reproduction tools and scoped simulation and physical-board evidence.
    Publish the common two-run, 128-output speed result (~10.1 tokens/s) and
    the IC/AWIC/HWIC/F-AWIC/S-AWIC tree. Document the public demonstration keys,
    open formal and DDR-timing scope, and unrestricted signed-update policy.
2026-11-04 Label the fixed-digest schematic as an F-AWIC
    Update light and dark figures and their README descriptions to distinguish
    the fixed-commitment design from the broader AWIC family.
2026-11-04 Add the signed-update S-AWIC to the chip comparison schematic
    Show fixed public keys verifying a signed model commitment at boot, then
    weight checks against the approved digest. Keep private signing keys
    outside the chip and distinguish authorization from weight integrity.
2026-11-04 Show a general k-of-n approval policy in the S-AWIC schematic
    Identify two-of-three as the demonstration configuration, not the
    definition of a signed-update AWIC.
2026-11-04 Prove baseline model-read values through the custom DDR path
    Discharge the production four-bank cache's raw-reply value premise through
    native thin transport, adapter/handoff parent, shared model/KV routing and
    model CDC. Preserve explicit vendor-storage, trusted runtime-entry image
    and static metadata-ROM/model boundaries; keep the whole-device theorem open.
    Include the readable theorem and diagram, acyclic premise-discharge map,
    source reconstruction, complete native SMT proof DAG and portable replay.
    Keep source-independent selector coverage and the readonly core-history
    projection explicit. Native circuit payload memories and fault logic remain.
    Validation: independent source recompila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
2026-11-04 Prove baseline Q operand provenance through the native consumer
    Connect the qualified model-read path and four-bank cache to actual Q
    coefficient and activation pins, all 64 tile metadata rows, synchronous
    readout and both postscale coefficient inputs. Cover six layers, four
    groups and 256 columns with complete lane/slot joins and current histories.
    Publish the readable theorem, main SMT-LIB statement, native source
    construction, typed derivation checks and portable replay. Retain vendor
    storage, runtime-entry image, static ROM binding and digital RTL boundaries.
    The numerical Q result and whole-device inference-only theorem remain open.
    Validation: fresh native parent/cache compilation an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
2026-11-04 Record matched HWIC query-block physical comparison
    Report complete-query numerical/activity checks and matched area, latency,
    power and energy diagnostics. Preserve explicit routing/timing limitations
    and prioritize grouped/spatial closure. Update only documentation and its
    release-integrity chain; no RTL, model assets, private logs or workflows.
2026-11-04 Refresh the reviewed member inventory for the Q proof package
    Update only the SimpleStories capsule checker file_contract literal to
    include the published Q operand proof and documentation. Preserve all
    executable validation logic, capsule evidence and hardware inputs.
    Validation: complete three-capsule/current-host replay passes with the
    pinned tokenizer; strict release inventory passes. Q formal statements
    and all 449 passing obligations are unchanged.
2026-11-05 Verify the baseline SimpleStories Q operator through actual Q effects
    Connect fixed-model operands, all 64 MAC lanes, exact integer Q arithmetic,
    normalization, actual write/exponent behavior and stage completion in one
    source-bound reset/bootstrap/induction argument. Keep the stated memory,
    digital implementation and interruption boundaries explicit.
    Validation: 329 selected new obligations (326 UNSAT and 3 SAT controls),
    449 operand and 1411 upstream receipt reconstructions; seven byte-identical
    native recompilations and 17 fresh selected solver queries. Six positive
    activation patterns, seven actual-only numerical defects and normalization
    edge evidence pass. Clean recorded-only/no-forma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
2026-11-05 Add SimpleStories S-AWIC with periodic reauthorization
    Require fresh, model-specific home approval at startup and periodically
    during inference. Include real LMS verification, private nonce conditioning,
    the complete Tang source, tested SRAM image, local relay and policy service,
    reproduction tools, and source-bound simulation and board evidence.
    The selected image runs at 25 MHz with positive reset-release margins and
    no reset timing exceptions. Eight startups, renewal with context retained,
    revocation, replay rejection and the common two-run benchmark pass; report
    ~7.4 tokens/s. Document the small 25.005 MHz setup margin and open DDR,
    entropy, physical-security and whole-machine proof sco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
2026-11-05 Identify F-AWIC and S-AWIC designs throughout the speed table
    Regenerate the display labels and calculation/inventory pins while retaining
    the exact benchmark observations and rates.
    Refresh the greedy checker's literal member inventory for the published
    periodic-reauthorization variant and its guide. Preserve executable checking
    logic and all source/proof/host role contracts. The complete current-greedy
    evidence replay, strict release inventory and common benchmark checks pass.
2026-11-05 Document and replay physical S-AWIC model replacement
    Publish the source-bound A-to-B-to-withdrawn-A campaign: 68 numerical
    outputs, model-specific approval, valid wrong-model/same-nonce rejection,
    revocation, rollback and captured-grant replay checks. State the synthetic
    zero-final-norm fixture and SRAM-reconfiguration scope explicitly.
    Include signed-prefix reconstruction, raw wire observations, readback
    receipts, portable replay and semantic negative controls. Support optional
    numerical recomputation and local full-array comparison while keeping raw
    flash arrays, backups and live signer state private.
    Refresh reviewed inventories without changing their checking logic or
    source/proof/hos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
2026-11-05 Verify baseline RMSNorm through Q and retained query memory
    Connect independent RMS integer arithmetic and whole-vector normalization,
    actual workspace and Q capture, the complete Q operator, and numerical
    certificates retained through query RAM and pre-overwrite reads. Construct
    actual admission origins and preserve the full producing-invocation record.
    State the stage-entry input boundary and remaining whole-device limits.
    Validation: 554 new exact query/receipt reconstructions (548 UNSAT and six
    SAT controls), pinned Q/operand/upstream dependencies, four byte-identical
    native recompilations, 43 original theory typechecks and 52 fresh selected
    composition queries. Six native layer-0 cases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
2026-11-06 Reconcile residual-training proxy calculations and reference selection
    Use the selected qualified H100 reference consistently in the SimpleStories
    assessment and shared benchmark report, retaining the other software stack
    as an explicitly labeled sensitivity case. Generate and test the associated
    prose and correct the runtime-arithmetic comparison and work-count text.
    Preserve the conditional engineering-proxy scope. No measured training
    attack, certified residual bound, new hardware measurement or image change
    is claimed. Hardware and frozen proof/benchmark evidence remain unchanged.
    Validation: all 23 existing offline and browser-fixture workflow steps pass
    in the local release export, i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
2026-11-06 Preserve frozen proof documentation and repair its legacy status links
    Restore the two formal-packet README members required by their unchanged
    source inventories and recorded recipient bindings. Retain the current
    scope clarifications in the main formal-status and method documentation.
    Provide one compatibility pointer so both recorded status links resolve.
    Validation: all 26 workflow checks are covered by the local replay and
    focused follow-up. Final integrity, registration, link, browser-fixture and
    greedy capsule checks pass on the unchanged final payload. An independent
    review verifies all eight postimages, exact README restoration and 902
    relative links. No proof/query/RTL/benchmark r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
2026-11-06 Clarify Qwen qualification and publish local validation tools and results
    Document source management-display wiring, retained CDC/reset limitations,
    operand-use proof gaps and physical-access assumptions for the released
    Qwen designs. Add reproducible CPU campaign and finite component harnesses,
    the actual 197-output CPU result, and conditional 8B arithmetic accounting.
    GPU reference and certified residual factors remain unassigned for 8B.
    Narrow the SimpleStories K/V consumer claim to its actual separate proof
    boundaries and explain the legacy replay source mismatch in the standalone
    status guide. Preserve all frozen packet sources and recorded proof results.
    Validation: 159 helper tests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
2026-11-06 Document HWIC memory feasibility and full-model performance limits
    Add the reviewed storage/process assessment and recorded cycle/traffic inputs, with an offline arithmetic checker. Link the assessment from the README and run the checker in CI. The report distinguishes source capacities, hypothetical scenarios and block results from unproved full-chip feasibility.
    Validation: six scoped checks pass, including strict integrity, recorded arithmetic, documentation links and all three current greedy evidence capsules. Workflow YAML and step names checked. No production RTL, model assets, PDK files, native builds or bitstreams changed.
2026-11-06 Clarify signed-update boot-to-runtime page binding limit
    Correct the fixed-arithmetic claim and link the implementation limitation from both S-AWIC guides. The released boot readback and signed runtime page table are not fully bound. Repaired hardware artifacts remain withheld pending routing, timing and board qualification.
    Documentation only; production RTL, prebuilt images and frozen evidence are unchanged.
2026-11-06 Prove protected K/V CLEAR epoch advancement
    Add the source-bound scalar counter proof, its recorded checker and corruption controls. Document the reset scope and the remaining tag, RAM, cache, consumer and whole-device proof obligations.
2026-11-06 Bind S-AWIC signed pages to boot readback and qualify both Tang images
    Compare every signed page digest against the ordered DDR readback used by the image and fixed-table checks before releasing runtime ownership. Retain exact source-bound component proofs and explicit stream-wrapper equivalence dependencies.
    Publish routed 25 MHz plain and periodic-reauthorization images with complete-model RTL, native timing and SRAM-only board evidence. Paired common speed results are 10.1 and 7.6 tokens/s; the original configuration was restored and verified. Preserve the older replacement campaign against its recorded image identities.
    Add offline source, timing, proof and physical-evidence checks to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
2026-11-06 Bind home evidence tests to the repaired board campaign
    Check a valid repaired fixture before each mutation and require the intended timestamp, signature, request-binding or historical-image refusal. Include the six-test module in offline CI and refresh integrity inventories. Keep production verifiers, images and raw evidence unchanged.
2026-11-07 Run decoder and STEP/CLEAR proof replay on hosted Linux (#1)
    Run Qwen decoder comparisons and baseline STEP/CLEAR control replay in the existing digest-verified Linux job. Retain compiler inputs, models, queries, answers, witness/guard traces and decoder counterexamples; link hosted evidence while preserving the independent native qualification record.
    Validation: all four hosted PR jobs and affected local checks passed. Actual fresh control models and all 18 answers, the CLEAR/drain/reply and guard traces, decoder induction and the accepted-request address-bit counterexample were independently audited.
2026-11-07 Clarify routed timing limits for periodic reauthorization
    State the global endpoint counts alongside the per-clock summaries, bound the removal-path statement to the printed table, and trace one clocked entropy-control hold path. Link the review from the architecture map and refresh only required byte inventories.
2026-11-07 Explain two unresolved periodic-reauthorization timing paths
    Trace the entropy hold path through the shared core clock and Q/latch-gate boundary, and identify the DDR setup path as an enabled DLL-code sample whose stability contract is unverified. Add a compact factual pin/clock inventory with source identities and the original upstream constraint link; preserve all source, images, constraints and raw timing evidence.
2026-11-07 Ground the formal argument in two published proof boundaries
    Introduce the baseline RMSNorm-to-Q numerical segment and STEP/CLEAR reply-ownership theorem, and explain the recorded supplied-candidate simulation. Preserve the remaining proof guide, contracts and open whole-device joins; refresh only root byte inventories.
2026-11-07 Refresh the embedded SimpleStories member ledger after verifier repair
    Bind the current member hashes in the existing three-design recorded checker and refresh its self-excluding manifest and root anchors. Preserve all non-inventory checker logic, capsule roles, proof data and hardware.
2026-11-07 Prove baseline selector START-to-WINNER ordering
    Add a public-source replay of row ownership, native numerical folding, least-ID maximum selection and healthy output hold. Include a reachable wrong-tie defect control and CI artifact wiring. Keep parent STEP/publication and model-logit provenance outside the unit theorem; preserve the independent CLEAR repair.
2026-11-07 Check Qwen build completion and serialize staged-workspace use
    Provide a checked client for the frozen synthesis Tcl and local checkpoint packaging. Require a successful child, fresh valid container and unchanged staged inputs; hold canonical workspace ownership through preflight, collection and receipts. Align both guides with the parser and exercise failed/overlapping builds in offline CI. Preserve legacy vendor sources, model artifacts and the separate held 8B reader change.
2026-11-07 Clarify periodic authorization nonce freshness assumptions
    Describe the volatile immediate-repeat check and the identical-request behavior after reset or an intervening nonce. Separate forced digital sample observations with real signature verification from physical entropy qualification and the distinct-challenge board campaigns. Preserve hardware, measurements and frozen evidence.
2026-11-08 Add an opt-in paired SimpleStories K/V substitution replay
    Compare six real-model plaintext/protected memory histories with independent integer and SHA references. Bind released inputs, retain native evidence and check input/trace/optimized-mode refusals. Preserve FPGA selections and default CI.
2026-11-08 Add an optional source-frozen registered-multiplier credit example
    Link a scoped worked example from the SimpleStories training-capacity assessment. Preserve its frozen source and replay identities, gross-credit interpretation and explicit open whole-device factor. Include optional proof/trace regeneration and failure controls without changing default CI or hardware.
2026-11-08 Link combined SimpleStories simulation from the architecture guide
    Identify the full-datapath RTL simulation and its eleven-case validation record alongside the built configurations. Preserve hardware, benchmarks, evidence and CI.
2026-11-08 Add a portable SimpleStories one/two-rank hybrid replay
    Link a bounded numerical and peer-transfer witness from the reusable-die proposal. Preserve the sealed source and receipt identities and distinguish RTL matrix arithmetic from host nonlinear, K/V, authentication and scheduling services. Refresh release inventories without changing existing hardware, board evidence or CI.
2026-11-10 Make S-AWIC reproduction preserve archived evidence
    Stage fresh external replay inputs and include the production page-table checker in the admission-memory build. Keep the home-authority signer state independent of run directories and distinguish the recorded replacement image from the selected benchmark image.
    Reject unlisted directory symlinks in strict inventories, exercise replay staging in CI, and clarify protected Qwen simulation and analysis entry points.
2026-11-10 Add pretrained TLM26 MoE Tang demonstration
    Publish source, pinned reconstruction steps and recorded board evidence for
    the fixed eight-expert, top-two decoder. Add validation, reproduction,
    formal-scope and dependency-notice pages. Report its 24-token latency
    measurement separately from the common paired speed benchmark.
    Refuse optimized Python at assertion-based entry points, add twelve refusal
    tests to offline CI and refresh release inventories. Preserve the archived
    RTL, board-constraint and evidence bytes.
2026-11-10 Publish Qwen3-8B protected K/V component simulation
    Add source-bound Linux component records and a digest-checked offline stager
    that reuses canonical RTL while reconstructing the exact tested package.
    Document the first-position, first attention grouped-query pair scope across
    36 layers and preserve the deployed plain-K/V F2 image and measured speed.
    Validate all 143 reconstructed members, independent recorded root/operand
    checks, changed and missing shared-source refusals, and nine staging controls.
    Wire only offline reconstruction and recorded evidence into CI.
2026-11-12 Stop owned Qwen prefetch children on driver cancellation
2026-11-12 Stop full-machine replay children on driver cancellation
2026-11-12 Show four board-tested models and their cache boundaries
